MirageC79/HevORT/README.md

# Welcome to the HevORT project!

For information about the HevORT project please have a look into the documentation. [Documentation](http://docs.hevort.com/#/pages/home)
