MirageC79/HevORT/firmware/klipper/klipperscreen/theme/README.md

# Klipper Screen HevORT Theme

## How to install this theme to Klipper Screen:
1 - Copy the content of the hevort folder to:  
`/home/pi/KlipperScreen/styles/hevort`

2 - Restart KlipperScreen:  
`sudo service KlipperScreen restart`

3 - Select HevORT theme from the KlipperScreen menu.  
