MirageC79/HevORT/files/Components/Enclosure/ElectronicBay/OctopusProCasing/README.md

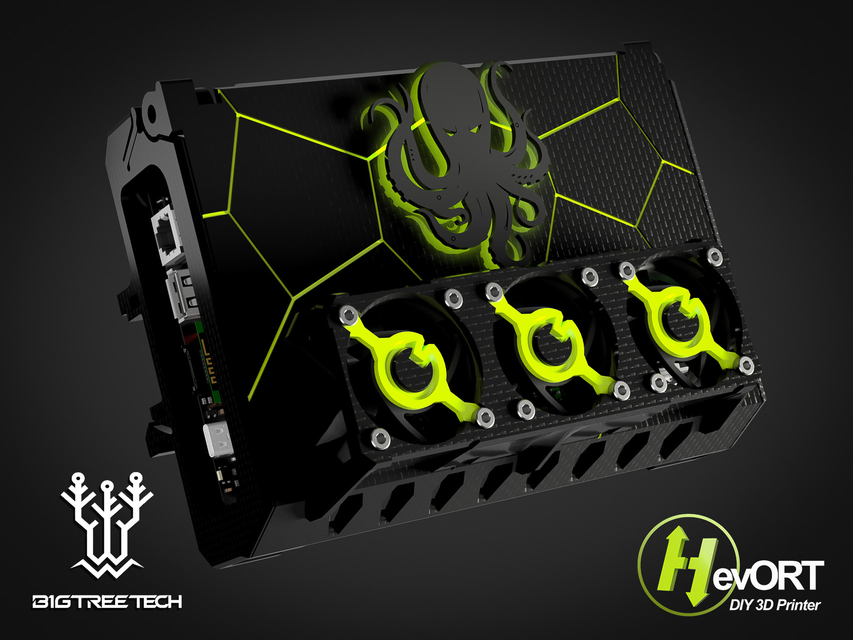
[picture p5: files/Components/Enclosure/ElectronicBay/OctopusProCasing/images/Octopus_casing_acidbee_render.jpg]


**STLs:**
https://github.com/.../AcidBee_Enclosure/OctopusProCasing

**Print Settings:**
- Layer height 0.2mm
- Support (only required for DINMountLeft.stl & TripleFanShroud.stl)
- Green lines can be achieved by scheduling filament change (M600) at layer 4 and 6 of your slicer

**BOM:**
- Qty 2: Dowel pin 5mm X 16mm ( I used a 5mm corbon fiber rod cut to length)
- Qty 12: M3 X 25mm Cap Screw
- Qty 2: M2.5 X 4mm Cap Screw
- Qty 3: 40X40X20 Fan https://s.click.aliexpress.com/e/_AMLp6f

**Installation:**
Fans are meant to be mounted in a pushing mode towards the inside of the case.
