MirageC79/HevORT/docs/sidebar.md

* [Home](pages/home.md)
* [Intro](pages/intro.md)
* **PLAN YOUR BUILD**
* [Printer Size](pages/printer-size.md)
* [Frame Calculation](pages/frame-calculation.md)
* [Select Configuration](pages/component-selection.md)
* [Select Electronics](pages/electronics-selection.md)
* **MAKE IT HAPPEN**
* [Printing the Parts](pages/how-to-print-parts.md)
* [Firmware Configuration](pages/firmware-configuration/klipper.md)
* [Mods](pages/mods/mods.md)
* **OTHERS**
* Useful stuff
  * [Links](pages/useful-stuff/links.md)
  * [Tools](pages/useful-stuff/tools.md)
* Documentation specific
  * [Documentation docs](pages/documentation-docs.md)

<div class="socials">
    <span><span>Socials</span></span>
    <div class="socials-container">
      <a class="social-btn" href="https://www.youtube.com/c/MirageC" target="_blank" rel="noopener"><i class="social-btn-icon fa-brands fa-youtube"></i></a>
      <a class="social-btn" href="https://www.facebook.com/groups/hevort" target="_blank" rel="noopener"><i class="social-btn-icon fa-brands fa-facebook"></i></a>
      <a class="social-btn" href="https://discord.gg/nCYRQAZPWV" target="_blank" rel="noopener"><i class="social-btn-icon fa-brands fa-discord"></i></a>
    </div>
</div>

<div class="sidebar-credit-container">
<span><span class="hevort">HevORT</span> project by <span class="hevort">MirageC</span></span>
<span><span class="hevort">Documentation</span> rework by <span class="hevort">DonnerPlays</span></span>

</div>
