MirageC79/HevORT/docs/cover.md

><span class="hevort">HevORT</span> DIY 3D-Printer Documentation

[Dive into the Project](pages/home.md ':class=cover-button')
