MirageC79/HevORT/docs/pages/intro.md

# **INTRO**

## Why the HevORT?
I got into 3D printing by building a CoreXY [Hypercube Evolution 300X300X300 (HEVO)](https://www.thingiverse.com/thing:2254103).  
This was a very good learning experience for me as I learned how 3D printers work and how to actually 3D print.

After several months of printing and looking closely at the design from the HEVO, I came up with a few ideas on how to improve the design based on my needs and **my thirst for speed**.    
Well, first thing I knew, I was now on the path of designing my own 3D printer.  Pulling back my mechanical engineering course notes from long time ago I learned Fusion360...    
Those ideas lead me to design what is now known as the HevORT (Hypercube Evolution Olivier RT).

If ever you decide to build this machine, I hope you enjoy it as much as I do.

Welcome to the journey and dont forget to join our [Facebook group](https://www.facebook.com/groups/hevort) and our [Discord server](https://discord.gg/xgYTQD3C).    

**Olivier aka MirageC**

## The Design Philosophy
- Stepper Motors to be out of the heat chamber and at the back of the printer
- Maximized ratio between XY print area vs frame dimension
- Triple Z motor Self-Leveling *(True term would be Auto-leveling , but the common use for Auto-leveling designates software compensation based on topographic mapping of the bed)*
- Wide and Tall front printer opening without extrusion member in the line of sight to the print head.
- Rigid Gantry for achieving high acceleration and speed using a direct drive extruder
- No metal machining of parts (or limited as much as possible)
- Open Source data

## See the HevORT in Action	
<iframe width="560" height="315" src="https://www.youtube.com/embed/mLhklORNFBQ" title="PERFECT Layer Stacking with this System" frameborder="0" allow="accelerometer; autoplay; clipboard-write; encrypted-media; gyroscope; picture-in-picture; web-share" allowfullscreen></iframe>
<iframe width="560" height="315" src="https://www.youtube.com/embed/ibsBiALMMSE" frameborder="0" allow="accelerometer; autoplay; clipboard-write; encrypted-media; gyroscope; picture-in-picture" allowfullscreen></iframe>   
<br> 
<iframe width="560" height="315" src="https://www.youtube.com/embed/ZtpQwZyuZP8" title="My Recipe for FAST 3D printing" frameborder="0" allow="accelerometer; autoplay; clipboard-write; encrypted-media; gyroscope; picture-in-picture; web-share" allowfullscreen></iframe>
<iframe width="560" height="315" src="https://www.youtube.com/embed/mqSQhwqSzvg" title="Fixing Z Wobble from 20$ Ball Screws with that simple device" frameborder="0" allow="accelerometer; autoplay; clipboard-write; encrypted-media; gyroscope; picture-in-picture; web-share" allowfullscreen></iframe>
