MirageC79/HevORT/docs/pages/home.md

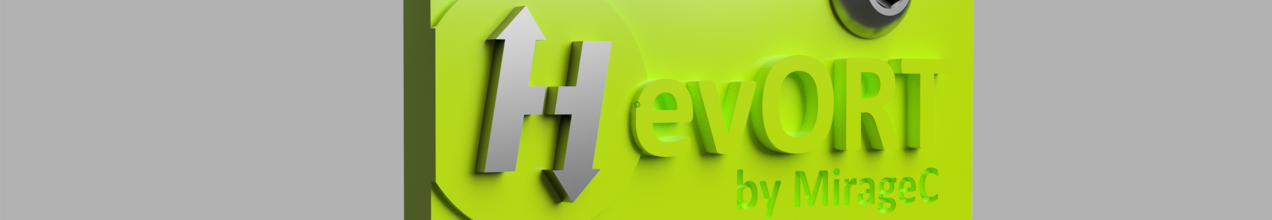
[picture p14: docs/assets/images/cover-flat.png]
Cover Image Flat

# Welcome to the **HevORT** project !

The HevORT is a DIY 3D printer that is meant to push the boundaries of FDM printing in terms of speed, repeatability & maintainability.  
Quality will be the same as any well calibrated FDM only the HevORT prints to that quality level faster... much faster! :)   
<br>

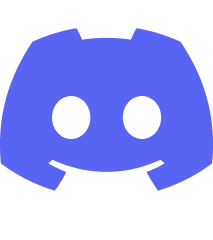
[picture p15: docs/assets/images/discord-logo.png]
Discord Logo
<a class="hevort-message hevort-btn" target="_blank" href="https://discord.gg/nCYRQAZPWV" rel="noopener"><span class="hevort-btn-text">Click here and join the Discord to get in touch with even more people actively discussing the next big thing</span></a>
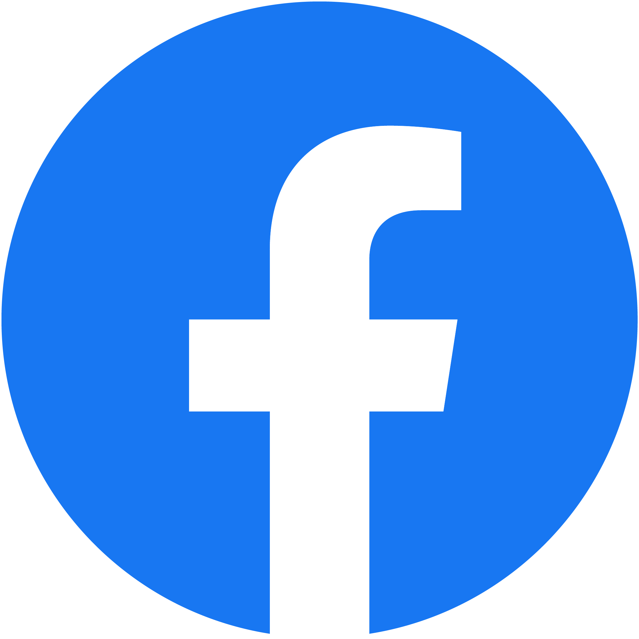
[picture p16: docs/assets/images/facebook-logo.png]
Facebook Logo
<a class="hevort-message hevort-btn" target="_blank" href="https://www.facebook.com/groups/hevort" rel="noopener"><span class="hevort-btn-text">Click here and join the Facebook group</span></a>

>If you like my work and would like to help me covering the costs associated to the development and improvement of this project, <br>
click the button here below :)

Donate with PayPal (https://www.paypal.com/cgi-bin/webscr?cmd=_s-xclick&hosted_button_id=LYP98YKUSLXN2)

Thank you!
Olivier

<br>
<p style="font-size: 3rem; text-align: center; display: flex; flex-direction: column">
:fa-solid fa-heart:
Happy Printing
:fa-solid fa-heart:
</p>
