MirageC79/HevORT/docs/pages/mods/mods.md

# **Mods**

> This is the section for the community
>
> It showcases all the modification's people from the community have created and published

## Contribution

|INFO|
If you have created a mod for the HevORT too.
Please create a merge request to have it added

[GitHub/HevORT - Pull Request](https://github.com/MirageC79/HevORT/pulls)

If you need help, the best place to ask is the Discord server

[Discord/HevORT](https://discord.gg/nCYRQAZPWV)
|INFO|

<details>
<summary>Rules</summary>

<div class="mod-contribution-rules-container">

[contribution-rules](../../mod-contribution-rules.md ':include')

</div>
</details>

## Enclosure

<grid>
  <item title="Serbitar AcidBee Enclosure extras" image="files/Mods/serbitar/serbitar-acidbee-enclosure-extras.webp">
    <description slot="description">
      A collection of different modifications (extras) for the <a href="#/pages/component-selection?id=a-enclosure">AcidBee Enclosure</a>.
    </description>
    <buttons slot="buttons">
      <item-button url="https://www.printables.com/de/model/216056-hevort-acidbee-enclosure-extras">Printables</item-button>
    </buttons>
    <tags slot="tags">
      <item-tag>Enclosure</item-tag>
    </tags>
    <credits slot="credits">
      <credit name="Serbitar"/>
    </credits>
  </item>
</grid>

## XY Gantry

<grid>
  <item title="EvoMoto HD12 AWD" image="files/Mods/evomoto/evomoto_awd_hd12.png">
    <description slot="description">
      This mod adds two more steppers to the HevORT.
      <br>They replace the pulley mounts on the front for even more power.
      <br><br>Requires (not including existing parts from the pulley mounts):
      <br>-2 more steppers
      <br>-2 driving pulleys for the stepper (20teeth)
      <br>-6x M5 100mm screws (replaces existing M5 90mm)
      <br>-2x M5 55mm screws (replaces existing M5 45mm)
    </description>
    <buttons slot="buttons">
      <item-button url="https://www.thingiverse.com/thing:5171980">Thingiverse</item-button>
    </buttons>
    <tags slot="tags">
      <item-tag>12mm belt</item-tag>
      <item-tag>AWD</item-tag>
    </tags>
    <credits slot="credits">
      <credit name="EvoMoto"/>
    </credits>
  </item>
  <item title="EvoMoto STD/HT AWD" image="files/Mods/evomoto/evomoto_awd_std-ht.png">
    <description slot="description">
      This mod adds two more steppers to the HevORT.
      <br>They replace the pulley mounts on the front for even more power.
      <br><br>Requires (not including existing parts from the pulley mounts):
      <br>-2 more steppers
      <br>-2 driving pulleys for the stepper (20teeth)
    </description>
    <buttons slot="buttons">
      <item-button url="https://www.thingiverse.com/thing:4815859">Thingiverse</item-button>
    </buttons>
    <tags slot="tags">
      <item-tag>6mm belt</item-tag>
      <item-tag>AWD</item-tag>
    </tags>
    <credits slot="credits">
      <credit name="EvoMoto"/>
    </credits>
  </item>
  <item title="Hans Hanson HD12 AWD" image="files/Mods/hans-hanson/hans-hanson_awd_hd12.jpg">
    <description slot="description">
      Almost the same number and length of shafts are required as with the opposite Motor Mount and Pulley mount
      <br><br>(except for the two Dowel Pin 5x40mm for the belt binder).
      <br>The same goes for the idler and pulley.
    </description>
    <buttons slot="buttons">
      <item-button url="https://www.thingiverse.com/thing:4946002">Thingiverse</item-button>
      <item-button url="https://a360.co/3lwUEMv">CAD File</item-button>
    </buttons>
    <tags slot="tags">
      <item-tag>12mm belt</item-tag>
      <item-tag>AWD</item-tag>
    </tags>
    <credits slot="credits">
      <credit name="Hans Hanson"/>
    </credits>
  </item>
</grid>

### Further options
Smaller changes that may not fit into the bigger mods in the main [XY Gantry](#xy-gantry) section.

<grid>
  <item title="XYHT v2.5 1515 extrusions" image="files/Mods/rockzo/rockzo_xyht_1515_extrusion_mod/rockzo_xyht_1515_extrusion_mod.png">
    <description slot="description">
      A simple mod for 1515 extrusion for the XYHT v2.5.
      <br>Recommended: Misumi 1515 extrusion
    </description>
    <buttons slot="buttons">
      <item-button url="files/Mods/rockzo/rockzo_xyht_1515_extrusion_mod/rockzo_xyht_1515_extrusion_mod.step">CAD File</item-button>
    </buttons>
    <tags slot="tags">
      <item-tag>6mm belt</item-tag>
    </tags>
    <credits slot="credits">
      <credit name="Rockzo"/>
    </credits>
  </item>
</grid>

## Z-Axis

<grid>
  <item title="Wobble Rings for SFU1204" image="files/Mods/evomoto/evomoto_sfu1204_wobble_rings.jpg">
    <description slot="description">
      Alternative version of the original Wobble Rings for the ZR V2.5
      <br>These do a better job at eliminating bad quality ballscrews
      <br><br>Cheap ballscrews never run smooth, these wobble rings will eliminate any wobble
      <br>the ballscrew would have induced into the print bed movement
    </description>
    <buttons slot="buttons">
      <item-button url="https://www.thingiverse.com/thing:4781610">Thingiverse</item-button>
    </buttons>
    <tags slot="tags">
      <item-tag>SFU1204</item-tag>
      <item-tag>Wobble prevention</item-tag>
    </tags>
    <credits slot="credits">
      <credit name="EvoMoto"/>
    </credits>
  </item>
  <item title="Wobble Rings for SFU1604" image="files/Mods/evomoto/evomoto_sfu1604_wobble_rings.png">
    <description slot="description">
      Same as the SFU1204 version but for SFU1604
    </description>
    <buttons slot="buttons">
      <item-button url="https://www.thingiverse.com/thing:4785945">Thingiverse</item-button>
    </buttons>
    <tags slot="tags">
      <item-tag>SFU1604</item-tag>
      <item-tag>Wobble prevention</item-tag>
    </tags>
    <credits slot="credits">
      <credit name="EvoMoto"/>
    </credits>
  </item>
  <item title="Z-Axis 2:1 reduction" image="files/Mods/m3nt8l/m3nt8l_z-axis_reduction.jpg">
    <description slot="description">
      2:1 reduction for the HevORT's ZR V2.5 Z-Axis
      <br>This mod increases holding torque.
      <br>It will also allow you to use 50mm longer ballscrews bringing you 50mm more Z-Travel.
      <br><br>Requires (for all 3):
      <br>3x 154 mm (77 tooth) 2GT closed loop belt
      <br>3x 40 tooth pulley with 5mm bore
      <br>3x Roland Coupler (as seen in standard HevORT Z 2.5)
      <br>3x 5200-2RS double row angular contact bearing (as seen in standard HevORT Z 2.5)
      <br>3x Coupler (as seen in standard HevORT Z 2.5)
      <br>3x 5mm shaft pins
      <br>3x 20 tooth pulley for the motor shaft (5mm) (as seen in standard HevORT Z 2.5)
      <br>9x 625RS 5mm bore x 16mm OD x 5mm wide bearings
    </description>
    <buttons slot="buttons">
      <item-button url="https://www.thingiverse.com/thing:4880007">Thingiverse</item-button>
    </buttons>
    <tags slot="tags">
      <item-tag>Torque</item-tag>
      <item-tag>increased travel</item-tag>
    </tags>
    <credits slot="credits">
      <credit name="M3NT8L"/>
    </credits>
  </item>
  <item title="Wobble Rings SFU1204<br>Mellow Metal Middle Ring">
    <description slot="description">
      Modification of EvoMoto's Wobble Rings to allow the usage of the Mellow metal middle rings
      <br><a href="https://www.aliexpress.com/item/1005004227149356.html?">Mellow AliExpress</a>
      <br>
      <br>Designed for the SFU1204 ballscrews & 6mm balls.
      <br>
      <br>Printing in resin (ideally high temp) recommended/required for best results
      <br>Example resins:
      <br>- <a href="https://siraya.tech/products/sculpt-resin-high-temperature-resistant-resin?variant=40152192483437">Siraya Tech Sculpt</a>
      <br>- <a href="https://siraya.tech/products/sculpt-resin-high-temperature-resistant-resin?variant=40152192581741">Siraya Tech Sculpt Ultra White</a>
      <br>- <a href="https://phrozen3d.com/products/phrozen-tr300-ultra-high-temp-resin">Phrozen TR300</a>
    </description>
    <buttons slot="buttons">
      <item-button url="https://github.com/MirageC79/HevORT/tree/master/files/Mods/stl/vvega/wobble_ring_mellow_metal_center/">STLs</item-button>
    </buttons>
    <images slot="images">
      <item-image url="files/Mods/vvega/wobble_ring_mellow_metal_center/1.jpg"></item-image>
      <item-image url="files/Mods/vvega/wobble_ring_mellow_metal_center/2.jpg"></item-image>
      <item-image url="files/Mods/vvega/wobble_ring_mellow_metal_center/3.jpg"></item-image>
      <item-image url="files/Mods/vvega/wobble_ring_mellow_metal_center/4.jpg"></item-image>
    </images>
    <tags slot="tags">
      <item-tag>SFU1204</item-tag>
      <item-tag>Wobble prevention</item-tag>
      <item-tag>Metal</item-tag>
    </tags>
    <credits slot="credits">
      <credit name="EvoMoto">Initial work/version</credit>
      <credit name="Vvega">Modification for Mellow metal middle rings</credit>
    </credits>
  </item>
</grid>

## Extruder

<grid>
  <item title="BL-Touch Rapido UHF Hotend bracket"
        image="https://hevort-mods.donnerplays.de/docs/assets/images/BL_Touch_Rapido_Hotend_UHF_Bracket.png">
    <description slot="description">
      Mounting bracket for the BL-Touch when used on a Rapido UHF hotend.
      <br>- Adds a lip on the top that prevents the support from rotating.
      <br>- Uses nuts for all screw holes instead of screwing into the plastic
      <br><br>Requires:
      <br>- 3x M3 nuts
      <br>- Main mounting screw: M3x(~35mm long screw)
      <br>- BL-Touch screws: 2x M3x8mm screw
    </description>
    <buttons slot="buttons">
      <item-button icon="fa fa-download"
                   url="https://hevort-mods.donnerplays.de/cad/BL_Touch_Rapido_Hotend_UHF_Bracket.step">CAD File
      </item-button>
    </buttons>
    <tags slot="tags">
      <item-tag>Bl-Touch</item-tag>
      <item-tag>Rapido UHF</item-tag>
      <item-tag>HextrudORT</item-tag>
    </tags>
    <credits slot="credits">
      <credit name="MirageC">Initial work/version</credit>
      <credit name="DonnerPlays">Modification to use M3 nuts instead of threading into the plastic</credit>
    </credits>
  </item>
  <item title="LGX Lite HextrudORT Carriage Mount (HD12/MGN9)"
        image="files/Mods/serbitar/serbitar_lgx-lite_hextrudort_carriage.webp">
    <description slot="description">
      Mounts an LGX Lite and Dragon hotend to the HevORT HextrudORT HD12/MGN9 carriage.
    </description>
    <buttons slot="buttons">
      <item-button url="https://www.printables.com/de/model/151944-hevort-lgx-lite-hextrudort-carriage-mount-hd12mgn9">Printables</item-button>
    </buttons>
    <tags slot="tags">
      <item-tag>9mm belt</item-tag>
      <item-tag>12mm belt</item-tag>
      <item-tag>lgx lite</item-tag>
      <item-tag>HextrudORT</item-tag>
    </tags>
    <credits slot="credits">
      <credit name="Serbitar"/>
    </credits>
  </item>
</grid>

## Cooling

<grid>
  <item title="HD12/MGN12 CPAP Rapido Duct" image="https://hevort-mods.donnerplays.de/docs/assets/images/HD12_MGN12_Rapido_Duct.png">
    <description slot="description">
      Fan duct for CPAP fan hose
      <br>(15mm inner diameter)
      <br><br>Mounts to the standard MGN12H/HD12 HextrudORT carriage
      <br><br>Requires:
      <br>- Standard: 4x M3x8mm screws
      <br>- UHF: 4x M3x14mm screws
    </description>
    <buttons slot="buttons">
      <item-button icon="fa fa-download" url="https://hevort-mods.donnerplays.de/cad/HD12_MGN12_Rapido_Duct.step">CAD
        File
      </item-button>
    </buttons>
    <tags slot="tags">
      <item-tag>CPAP</item-tag>
      <item-tag>12mm belt</item-tag>
      <item-tag>Rapido UHF</item-tag>
      <item-tag>MGN12H</item-tag>
    </tags>
    <credits slot="credits">
      <credit name="MirageC">Initial work of MGN9 version</credit>
      <credit name="DonnerPlays">Modification to fit HD12/MGN12</credit>
    </credits>
  </item>
  <item title="HD12/MGN12H Rapido UHF Spacer"
        image="https://hevort-mods.donnerplays.de/docs/assets/images/HD12_MGN12_Rapido_UHF_Spacer.png">
    <description slot="description">
      Spacer for the CPAP Rapido Duct
      <br>when the rapido is used with a volcano nozzle (UHF)
    </description>
    <buttons slot="buttons">
      <item-button icon="fa fa-download" url="https://hevort-mods.donnerplays.de/cad/HD12_MGN12_Rapido_UHF_Spacer.step">
        CAD File
      </item-button>
    </buttons>
    <tags slot="tags">
      <item-tag>Rapido UHF</item-tag>
      <item-tag>Spacer</item-tag>
    </tags>
    <credits slot="credits">
      <credit name="MirageC">Initial work of MGN9 version</credit>
      <credit name="DonnerPlays">Modification to fit HD12/MGN12</credit>
    </credits>
  </item>
  <item title="HD12/MGN12 40mm fan mount (tested with Rapido hotend)"
        image="https://hevort-mods.donnerplays.de/docs/assets/images/MGN12_HD12_Rapido_Fan_Shroud_40mm.png">
    <description slot="description">
      This bracket allows you to use a 40mm fan for
      <br>hotend cooling on the
      <br>MGN12/HD12 HextrudORT carriage
      <br><br>Includes small side openings to help with getting out the hot air and help with installation.
      <br><br>Is supported by two screws/flaps on the side
      <br><br>Requires:
      <br>- 3x M3x(8mm + fan size)
      <br>Example: 20mm thick fan = 28mm = 25-30mm
    </description>
    <buttons slot="buttons">
      <item-button icon="fa fa-download"
                   url="https://hevort-mods.donnerplays.de/cad/MGN12_HD12_Rapido_Fan_Shroud_40mm.step">CAD File
      </item-button>
    </buttons>
    <tags slot="tags">
      <item-tag>Rapido</item-tag>
      <item-tag>40mm fan</item-tag>
      <item-tag>MGN12H</item-tag>
      <item-tag>HD12</item-tag>
    </tags>
    <credits slot="credits">
      <credit name="MirageC">Initial work on version for Rapido with 25mm fan</credit>
      <credit name="DonnerPlays">Modification to allow 40mm fan to be used</credit>
    </credits>
  </item>
  <item title="CPAP 7040 part cooling solution" image="https://hevort-mods.donnerplays.de/docs/assets/images/cpap_7040_solution/main.png">
    <description slot="description">
      Ability to mount a CPAP 7040 blower.
      <br><br>
      Also adds ability to change inlet direction using servo
    </description>
    <buttons slot="buttons">
      <item-button url="https://hevort-mods.donnerplays.de/#/pages/mods/cpap_7040_solution.md">GitHub Page</item-button>
    </buttons>
    <credits slot="credits">
      <credit name="DonnerPlays"/>
    </credits>
    <tags slot="tags">
      <item-tag>CPAP</item-tag>
      <item-tag>Mount</item-tag>
      <item-tag>Spacer</item-tag>
    </tags>
  </item>
  <item title="HextrudORT Dragon Berd Air Mount">
    <description slot="description">
      Berd Air Nozzle for HextrudORT/Dragon combo that can be printed on an FDM/FFF printer<br><br>
      Print standing on end (big tube opening facing up)<br>
      - I used a thicker silicone tube than the aquarium hose normally used, to allow for higher airflow.<br>
      - I used a little nylon 90" bend on the back.<br>
      - Requires 2x M3x22mm screws to secure.<br>
    </description>
    <images slot="images">
      <item-image url="files/Mods/guitartoys/hextrudort_dragon_berd_air/1.jpg"></item-image>
      <item-image url="files/Mods/guitartoys/hextrudort_dragon_berd_air/2.jpg"></item-image>
      <item-image url="files/Mods/guitartoys/hextrudort_dragon_berd_air/3.jpg"></item-image>
      <item-image url="files/Mods/guitartoys/hextrudort_dragon_berd_air/4.jpg"></item-image>
      <item-image url="files/Mods/guitartoys/hextrudort_dragon_berd_air/5.jpg"></item-image>
    </images>
    <buttons slot="buttons">
      <item-button icon="fa fa-download" url="files/Mods/guitartoys/hextrudort_dragon_berd_air/guitartoys_hextrudort_dragon_berd_air.step">CAD File</item-button>
      <!-- <item-button url="https://a360.co/3QL8yIR">CAD-File</item-button> --><!-- Commented out as download not possible -->
      <item-button url="https://www.thingiverse.com/thing:5463656">Thingiverse</item-button>
      <item-button icon="fa fa-download" url="files/Mods/stl/guitartoys/hextrudort_dragon_berd_air/guitartoys_hextrudort_dragon_berd_air.stl">STL</item-button>
    </buttons>
    <credits slot="credits">
      <credit name="guitartoys"/>
    </credits>
    <tags slot="tags">
      <item-tag>Berd-Air</item-tag>
      <item-tag>MGN12H</item-tag>
      <item-tag>HextrudORT</item-tag>
      <item-tag>Dragon</item-tag>
    </tags>
  </item>
  <item title="Hemera Berd-Air Nozzle">
    <description slot="description">
      Berd Air Nozzle for HevORT Hemera that can be printed on an FDM/FFF printer<br><br>
      Both a V6 and Volcano version are provided<br><br>
      Print standing on end (big tube opening facing up)<br>
      - I used a thicker silicone tube than the aquarium hose normally used, to allow for higher airflow.<br>
      - I used a little nylon 90" bend on the back.<br>
      - Requires 1x M3x10mm & 1x M3x14mm screw to secure.<br>
    </description>
    <buttons slot="buttons">
      <item-button icon="fa fa-download" url="files/Mods/guitartoys/hemera_berd_air_nozzle/hemera_v6_berd_air_nozzle.stl">V6 STL</item-button>
      <item-button icon="fa fa-download" url="files/Mods/guitartoys/hemera_berd_air_nozzle/hemera_volcano_berd_air_nozzle.stl">Volcano STL</item-button>
      <item-button icon="fa fa-download" url="files/Mods/guitartoys/hemera_berd_air_nozzle/hemera_v6_berd_air_nozzle.step">V6 CAD File</item-button>
      <item-button icon="fa fa-download" url="files/Mods/guitartoys/hemera_berd_air_nozzle/hemera_volcano_berd_air_nozzle.step">Volcano CAD File</item-button>
      <item-button url="https://www.thingiverse.com/thing:4919574">Thingiverse</item-button>
    </buttons>
    <tags slot="tags">
      <item-tag>Berd-Air</item-tag>
      <item-tag>MGN12H</item-tag>
      <item-tag>Hemera</item-tag>
    </tags>
    <images slot="images">
      <item-image url="files/Mods/guitartoys/hemera_berd_air_nozzle/1.jpg"></item-image>
      <item-image url="files/Mods/guitartoys/hemera_berd_air_nozzle/2.jpg"></item-image>
      <item-image url="files/Mods/guitartoys/hemera_berd_air_nozzle/3.jpg"></item-image>
      <item-image url="files/Mods/guitartoys/hemera_berd_air_nozzle/4.jpg"></item-image>
    </images>
    <credits slot="credits">
      <credit name="guitartoys"/>
    </credits>
  </item>
</grid>

## Electronics

<grid>
  <item title="Duet 3 Mounting Bracket">
    <description slot="description">
      This is a Duet 3 Mounting bracket, which includes Three 40mm cooling fans.<br>
      My understanding is that the Duet needs it cooling to be on the backside of the board.<br>
      There's wide flat strip between the fans and the board, so if you want to use some self-adhesive wire tie mounts, you can do that there.<br>
      It's to be mounted to a flat surface for proper air flow.
    </description>
    <buttons slot="buttons">
      <item-button url="https://www.thingiverse.com/thing:4906487">Thingiverse</item-button>
      <item-button url="https://github.com/MirageC79/HevORT/tree/master/files/Mods/stl/guitartoys/duet3_mounting_bracket/">STLs</item-button>
      <item-button icon="fa fa-download" url="files/Mods/guitartoys/duet3_mounting_bracket/duet3_Bracket_with_fans.step">CAD File</item-button>
    </buttons>
    <tags slot="tags">
      <item-tag>Duet</item-tag>
      <item-tag>Controller</item-tag>
      <item-tag>Spacer</item-tag>
    </tags>
    <images slot="images">
      <item-image url="files/Mods/guitartoys/duet3_mounting_bracket/1.jpg"></item-image>
      <item-image url="files/Mods/guitartoys/duet3_mounting_bracket/2.jpg"></item-image>
      <item-image url="files/Mods/guitartoys/duet3_mounting_bracket/3.jpg"></item-image>
      <item-image url="files/Mods/guitartoys/duet3_mounting_bracket/4.jpg"></item-image>
      <item-image url="files/Mods/guitartoys/duet3_mounting_bracket/5.jpg"></item-image>
    </images>
    <credits slot="credits">
      <credit name="guitartoys"/>
    </credits>
  </item>
</grid>

## Other

<grid>
  <item title="SpEye" image="files/Mods/miragec/spy-eye/spy-eye-printed.jpg">
    <description slot="description">
      Not only an empty filament detector.
      <br>The SpEye can detect a spool jam and pause your print.
    </description>
    <buttons slot="buttons">
      <item-button url="#/pages/mods/spy-eye.md">SpEye page</item-button>
    </buttons>
    <tags slot="tags">
    </tags>
    <credits slot="credits">
      <credit name="MirageC"/>
    </credits>
  </item>
  <item title="ADXL345 mounting bracket on 40mm fan"
        image="https://hevort-mods.donnerplays.de/docs/assets/images/ADXL345_40mm_Fan_Mount.png">
    <description slot="description">
      Allows you to easily mount an ADXL345 accelerometer to your print head.
      <br><br>Mounts to the front of a 40mm fan.
      <br>(tested with a 20mm thick fan)
      <br><br>Requires: 3.5mm longer screws
    </description>
    <buttons slot="buttons">
      <item-button icon="fa fa-download" url="https://hevort-mods.donnerplays.de/cad/ADXL345_40mm_Fan_Mount.step">CAD
        File
      </item-button>
    </buttons>
    <tags slot="tags">
      <item-tag>40mm fan</item-tag>
      <item-tag>ADXL345</item-tag>
    </tags>
    <credits slot="credits">
      <credit name="DonnerPlays"/>
    </credits>
  </item>
  <item title="Hans Hanson FumesORT" image="files/Mods/hans-hanson/hans-hanson_fumes-ort.jpg">
    <description slot="description">
      Fume filter mounted under the HevORT's print bed.
      <br><br>Filter basket volume is approx. 313ml.
      <br>Using activated charcoal pellets with a diameter of approx. 4mm
      <br><br>Uses 4x 40x40x20 Sunon MF40202VX-1000U-A99
      <br>Circulates 37m³/h with empty filter basked
      <br>11m³/h with full filter at 24V or 6m³/h at 12V
      <br><br>Requires:
      <br>20x M3x8mm or M3x10
      <br>16x M3x25mm (for 40x40x20 mm Fans)
      <br>2x wago 221-413
      <br>8x M5x8mm Socket Head Screws
      <br>8x Hammer nut M5 for 2020 profile
      <br>4x Hammer nut M3 for 2020 profile
      <br>1x 295mm 2040 profile
      <br>4x 40x40x20 Fans
      <br>1x activated charcoal pellets
    </description>
    <buttons slot="buttons">
      <item-button url="https://www.thingiverse.com/thing:5197675">Thingiverse</item-button>
      <item-button url="https://a360.co/3lwUEMv">CAD File</item-button>
    </buttons>
    <tags slot="tags">
      <item-tag>Fume extractor</item-tag>
      <item-tag>Fume filter</item-tag>
    </tags>
    <credits slot="credits">
      <credit name="Hans Hanson"/>
    </credits>
  </item>
  <item title="Berd Air Pump Mount">
    <description slot="description">
      This is my take on an anti-vibration mount for the Berd Air Pump.<br><br>
      The main upper and lower brackets are the same,<br> and can be done in PLA, although I did mine in PETG<br>
      The little insert for the bottom I did in PETG,<br> as I suspect it will get hot with the motor running.<br>
      For the anti-vibration ring, 4mm seems to be about right.<br><br>
      It stays plenty cool with the heatsink alone (and in fact you could probably eliminate the heatsink)
    </description>
    <buttons slot="buttons">
      <item-button url="https://github.com/MirageC79/HevORT/tree/master/files/Mods/stl/guitartoys/berd_air_pump_mount/">STLs</item-button>
      <item-button icon="fa fa-download" url="files/Mods/guitartoys/berd_air_pump_mount/berd_air_pump_mount.step">CAD File</item-button>
      <item-button url="https://www.thingiverse.com/thing:4918308">Thingiverse</item-button>
    </buttons>
    <tags slot="tags">
      <item-tag>Berd-Air</item-tag>
      <item-tag>Cooling</item-tag>
    </tags>
    <images slot="images">
      <item-image url="files/Mods/guitartoys/berd_air_pump_mount/1.jpg"></item-image>
      <item-image url="files/Mods/guitartoys/berd_air_pump_mount/2.jpg"></item-image>
      <item-image url="files/Mods/guitartoys/berd_air_pump_mount/3.jpg"></item-image>
      <item-image url="files/Mods/guitartoys/berd_air_pump_mount/4.jpg"></item-image>
    </images>
    <credits slot="credits">
      <credit name="guitartoys"/>
    </credits>
  </item>
  <item title="Belt Cover" image="files/Mods/guitartoys/belt_cover/1.jpg">
    <description slot="description">
      Belt covers initially designed for a 415x415 HevORT.
    </description>
    <buttons slot="buttons">
      <item-button icon="fa fa-download" url="files/Mods/guitartoys/belt_cover/belt_cover.step">CAD File</item-button>
      <item-button url="https://www.thingiverse.com/thing:5464303">Thingiverse</item-button>
    </buttons>
    <tags slot="tags">
      <item-tag>Belt</item-tag>
      <item-tag>HD12</item-tag>
    </tags>
    <credits slot="credits">
      <credit name="guitartoys"/>
    </credits>
  </item>
  <item title="Logitech C920 Camera Door Mount" image="files/Mods/guitartoys/logitech_c920_camera_door_mount/1.jpg">
    <description slot="description">
      Mounts the C920 Camera to the front door.<br><br>
      Be careful, depending on how/where you mount it, the print-head might collide with the camera.<br>
      To use this you will have to remove the original c920 mount piece and replace it with the bracket.<br><br>
      Disassembly instructions: <a href="https://www.ifixit.com/Guide/Logitech+C920+Webcam+Disassembly/115077">iFixit</a>
    </description>
    <buttons slot="buttons">
      <item-button icon="fa fa-download" url="files/Mods/guitartoys/logitech_c920_camera_door_mount/logitech_c920_camera_door_mount.step">CAD File</item-button>
      <item-button icon="fa fa-download" url="files/Mods/stl/guitartoys/logitech_c920_camera_door_mount/logitech_c920_camera_door_mount.stl">STL</item-button>
      <item-button url="https://www.thingiverse.com/thing:5466815">Thingiverse</item-button>
    </buttons>
    <tags slot="tags">
      <item-tag>Camera</item-tag>
      <item-tag>Door</item-tag>
    </tags>
    <credits slot="credits">
      <credit name="guitartoys"/>
    </credits>
  </item>
</grid>
