MirageC79/HevORT/docs/pages/useful-stuff/links.md

# Useful Links

## Local

| Name/Link | Description |
|---|---|
| [>Frame Calculator<](docs/assets/references/frame/FrameCalculator.xlsx) | The HevORT Frame Calculator will tell you what sizes of<br>aluminium extrusions, ballscrews, print-bed, ...<br>you will need to get for your config  |
| [>Firmware Settings Guide/Calculator<](docs/assets/references/firmware-settings/FirmWareSettings.xlsx) | A useful document mainly for configuration RRF<br>but also includes a calculator for the Z-Axis Adjustment configuration for both<br>RRF and Klipper |

## External

| Name/Link | Description |
|---|---|
| [>>Flow Rate Calculator<<](https://polygno.com/flow_rate_calculator) | This is a useful tool to check how much<br>flow rate your current settings might result in. | 
| [>>Retraction Calibration Generator<<](http://retractioncalibration.com/) | This website generates an advanced retraction calibration test<br>It allows to test multiple parameters in one test.<br>Like temperature, retraction distance, retraction speed |
| [>>EMF Calculator<<](https://www.reprapfirmware.org/emf.html) | This calculator will tell you how fast you can go before EMF (noise) might become an issue or to much |
