MirageC79/HevORT/docs/pages/useful-stuff/tools.md

# Useful Tools

|INFO|
This pages contains useful tools like klipper/rrf macros
|INFO|

| Name/Link | Type | Description | Author/Credit(s) |
|---|---|---|---|
| [>>Klipper speed test<<](https://pastebin.com/yPfSMBGF) | Klipper macro | Runs multiple speed test and allows to do them each with different parameters<br><br>Example:<br>allows to run the test with different acceleration, run_current settings through a single call<br><br>See text above `[gcode_macro]` in pastebin for more infos. | DonnerPlays |
