MirageC79/HevORT/docs/pages/thankyou.md

# Thank you for your support!

Your contribution will help me to cover some of the costs related to the research and development, the tooling, the parts and the software subscriptions needed in the making of the HevORT project.  I really appreciate your help.
Regards, 

Olivier

[Back to Main Page](/README.md)
