MirageC79/HevORT/refdocs/E3D High Torque Motor.pdf

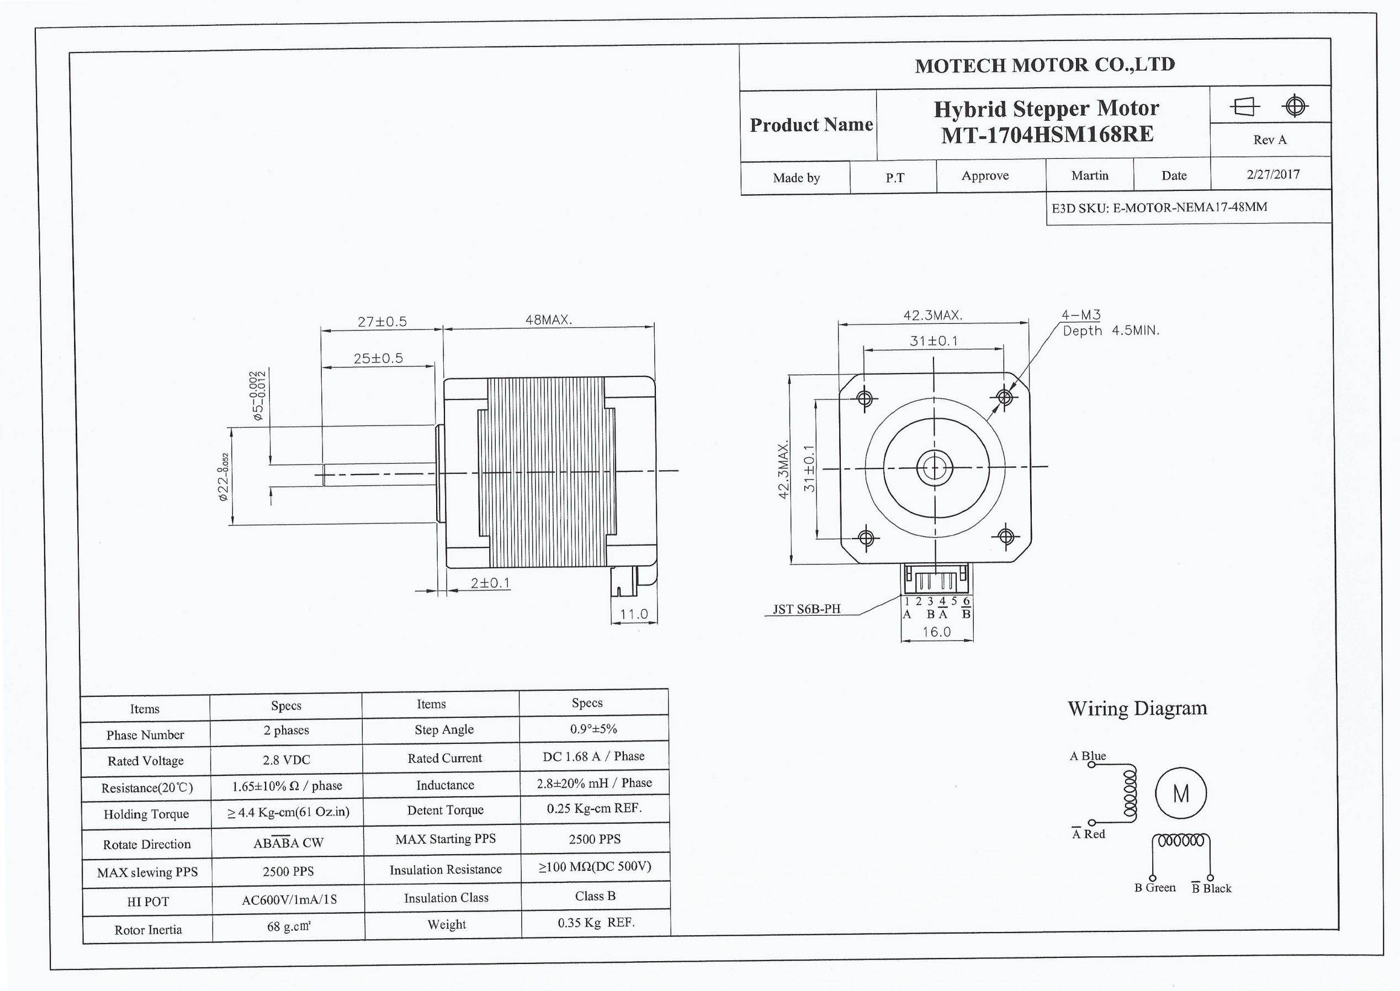
[picture p23: page 1]
