MirageC79/HevORT/docs/assets/images/components/ElectronicsThumb.jpg

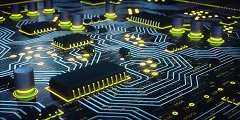
docs/assets/images/components/ElectronicsThumb.jpg
