MirageC79/HevORT/files/Components/Enclosure/ElectronicBay/OctopusProCasing/images/Octopus_casing_acidbee.png

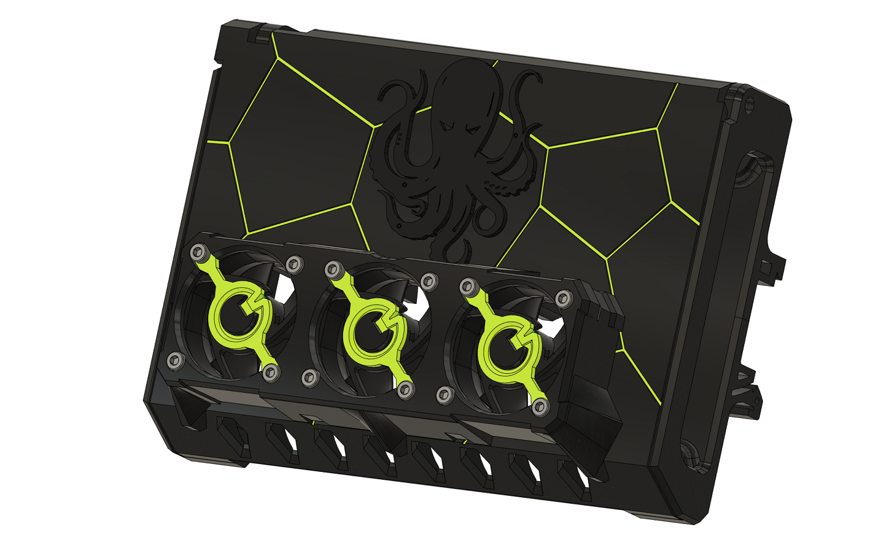
files/Components/Enclosure/ElectronicBay/OctopusProCasing/images/Octopus_casing_acidbee.png
