MirageC79/HevORT/files/Components/HD9_10_SPAWD/images/HD10_SPAWD_Poster copy.jpg

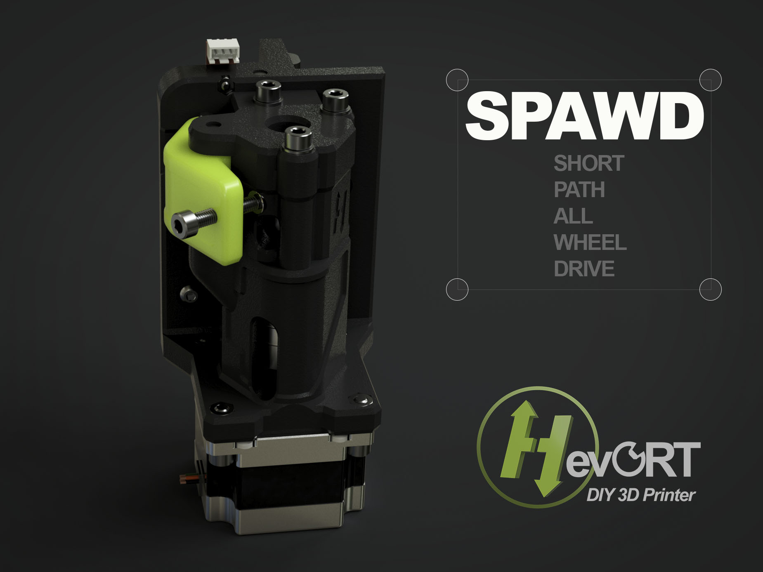
files/Components/HD9_10_SPAWD/images/HD10_SPAWD_Poster copy.jpg
