MirageC79/HevORT/files/Components/Enclosure/Lighting/images/README.md

# 45degree LightBars
Two small holders on which can clip a 45degree LED channel extrusion (commonly available, Aliexpress, Amazon etc...)
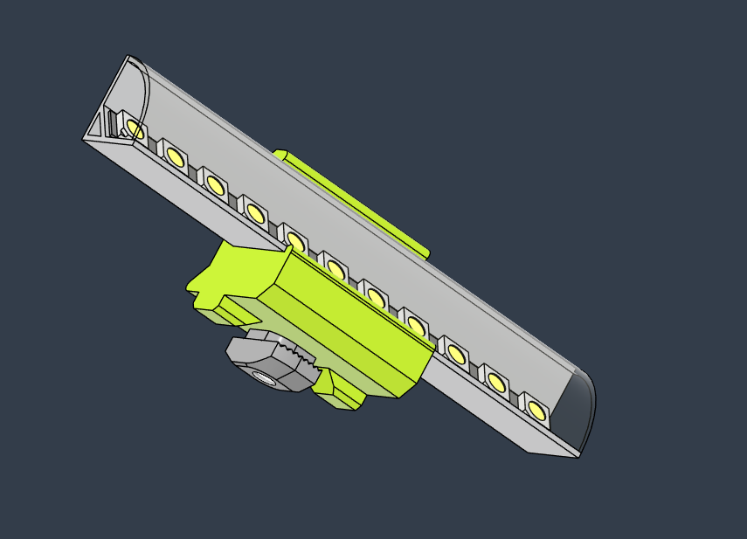
[picture p27: files/Components/Enclosure/Lighting/images/LEDchannel45deg_clipassembly.png]


## CAD
[Fusion360 Online](https://a360.co/3S3MThq)

### Two versions:
[**Version1**](https://github.com/MirageC79/HevORT/blob/master/files/Components/Enclosure/Lighting/LED_45deg_Channel_Clip%20v6.stl) - Can be fitted next to the front Pulley or Motor mount **WITHOUT** endstop:
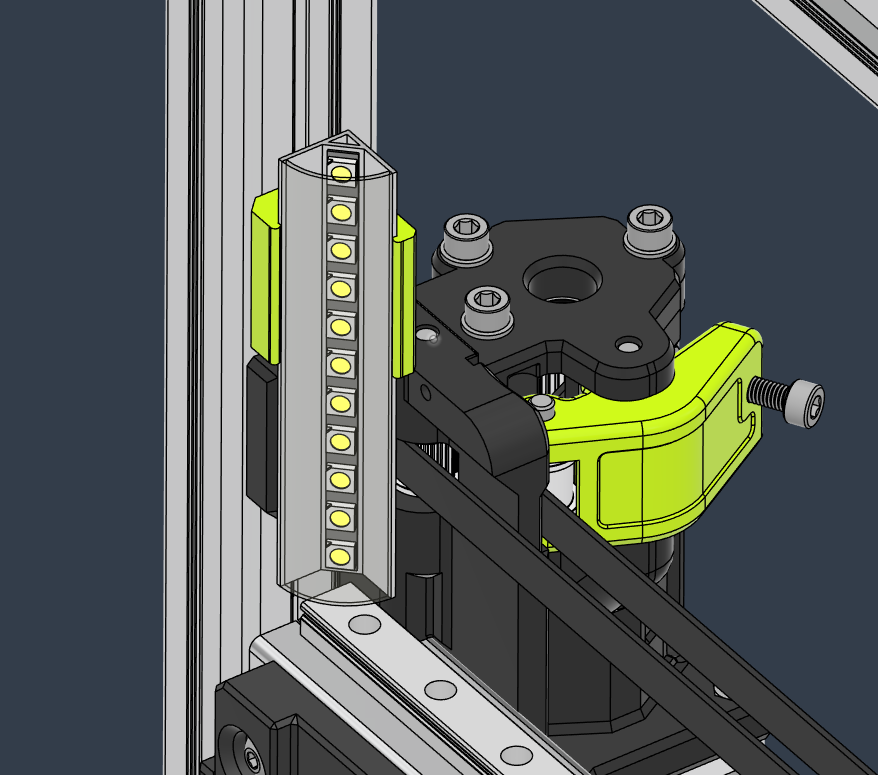
[picture p28: files/Components/Enclosure/Lighting/images/LEDchannel45deg_clip.png]
version1

 
[**Version2**](https://github.com/MirageC79/HevORT/blob/master/files/Components/Enclosure/Lighting/LED_45deg_Channel_Clip_8mmShift%20v1.stl) - Can be fitted next to the front Pulley or Motor mount **WITH** endstop:
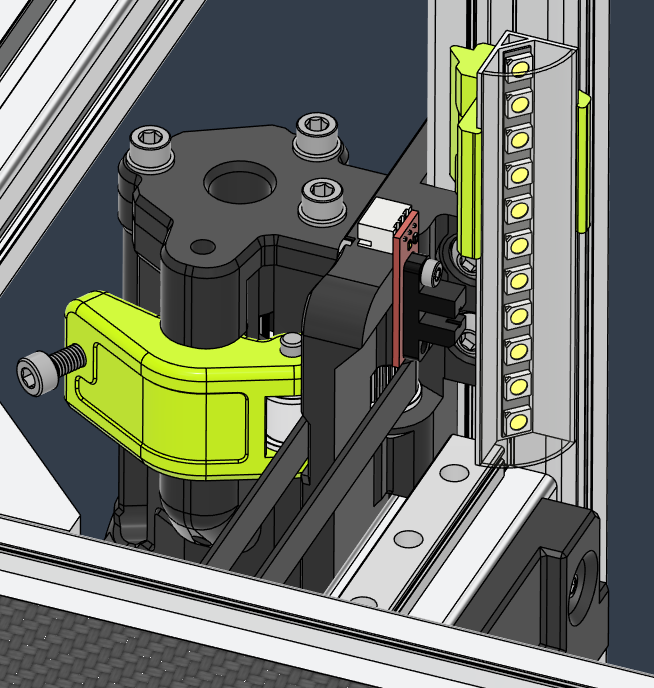
[picture p29: files/Components/Enclosure/Lighting/images/LEDchannel45deg_8mm offset_clip.png]
version2 - 8mm Offset
