MirageC79/HevORT/bom/BOM_XY_STD.xlsx

SubAssy | Category | Item | Thumbnail | Part Name | Part Description | Make/Buy | QTY | Comment | Vendor | Vendor URL
Standard - XY Gantry
XY_STD | Buy | 1 |  | MGN12C Block | MGN12C Block For Y Axis | Buy | 2 | Comes with Rail
XY_STD | Buy | 2 |  | MGN12 Rail | MGN12 Rail for Y axis | Buy | 2* | *Length defined by Frame Calculator: https://miragec79.github.io/HevORT/framecalculator.html
XY_STD | Buy | 3 |  | TrackX_2020Profile | 2020 Extrusion for X Axis | Buy | 1* | *Length defined by Frame Calculator: https://miragec79.github.io/HevORT/framecalculator.html
XY_STD | Buy | 4 |  | MGN12H Block | MGN12 Rail for X axis | Buy | 1 | Comes with Rail
XY_STD | Buy | 5 |  | MGN12 Rail | MGN12 Rail for X axis | Buy | 1* | *Length defined by Frame Calculator: https://miragec79.github.io/HevORT/framecalculator.html
XY_STD | Buy | 6 |  | MR115ZZ_Bearing_7804K107 | Bearing, 5x11x4mm | Buy | 2
XY_STD | Buy | 7 |  | Nema 17 Stepper Motor length 40mm | Stepper Motor, NEMA17, E3D High Torque Recommended | Buy | 2 | E3D High Torque 0.9 degree is Recommended
XY_STD | Buy | 8 |  | Opto endstop PM | Optical End-Stop | Buy | 1
XY_STD | Buy | 9 |  | LowerBelt GT2 6mm | GT2 6mm Belt | Buy | 1* | * See required length in the FrameCalculator: https://miragec79.github.io/HevORT/framecalculator.html
XY_STD | Buy | 10 |  | GT2 20T Pulley 3mm bore v1 | Pulley, Toothed - 20tooth GT2 6mm, 3mm bore | Buy | 6 | CAUTION! The pulleys for this gantry are 8.5mm in height.
XY_STD | Buy | 11 |  | GT2 Pulley Idler v3 | Pulley, Toothless - Eq 20 tooth GT2 6mm, 3mm bore | Buy | 4 | CAUTION! The pulleys for this gantry are 8.5mm in height.
XY_STD | Buy | 12 |  | GT2 Timing Pulley 20T 6mm - Hole_5mm v4 | Pulley, Timming - 20tooth GT2 6mm, 5mm bore | Buy | 2
XY_STD | Buy | 13 |  | UpperBelt GT2 6mm | GT2 6mm | Buy | 1* | * See required length in the FrameCalculator: https://miragec79.github.io/HevORT/framecalculator.html |  | https://s.click.aliexpress.com/e/_ALOsHe
XY_STD | Hardware | 14 |  | M3X10_CapScrew_92290A115 | Screw, Cap - M3X10mm | Buy | 34
XY_STD | Hardware | 15 |  | M3X8_CapScrew_92290A113 | Screw, Cap - M3X8mm | Buy | 25
XY_STD | Hardware | 16 |  | M5X10_ButtonHeadScrew_97763A820 | Screw, ButtonHead - M5X10mm | Buy | 2
XY_STD | Hardware | 17 |  | M3X30_CapScrew_92290A126 | Screw, Cap - M3X30mm | Buy | 5
XY_STD | Hardware | 18 |  | M3X20_CapScrew_92290A122 | Screw, Cap - M3X20mm | Buy | 6
XY_STD | Hardware | 19 |  | M6_TSlot_Nut | Nut, T-Slot - M6 for 3030 profile | Buy | 27
XY_STD | Hardware | 20 |  | M3X3030_TSlot_Nut | Nut, TSlot - M3X3030 for Y Axis | Buy | 24 | Qty 16 based on X&Y Print size at 315. Add Qty2 (one per Y side) for every additional 5cm of Y axis over 315mm. (one every 2 holes) | AliExpress | https://s.click.aliexpress.com/e/_AL5GuY
XY_STD | Hardware | 21 |  | M3X2020_T-Nut | Nut, TSlot - M3X2020 for X axis | Buy | 8 | Qty 8 based on X&Y Print size at 315. Add Qty1 for every additional 5cm of Y axis over 315mm. (one every 2 holes) | AliExpress | https://s.click.aliexpress.com/e/_A1wo9I
XY_STD | Hardware | 22 |  | M6X14_ButtonHeadScrew_92095A227 | Screw, ButtonHead - M6X14mm | Buy | 27
XY_STD | Hardware | 23 |  | M3_Nut_94150A325 | Nut, Hex - M3 | Buy | 15
XY_STD | Hardware | 24 |  | M3X12_CapScrew_92290A117 | Screw, Cap - M3X12mm | Buy | 2
XY_STD | Hardware | 25 |  | M3X25_CapScrew_92290A124 | Screw, Cap - M3X25mm | Buy | 5
XY_STD | Hardware | 26 |  | M5X12_ButtonHeadScrew_91239A228 | Screw, ButtonHead - M5X12mm | Buy | 4
XY_STD | Hardware | 27 |  | M5X20_ButtonHeadScrew_91239A233 | Screw, ButtonHead - M5X20mm | Buy | 2
XY_STD | Hardware | 28 |  | M5X2020_T-Nut_91239A224 | Nut, T-Slot - M5 for 2020 profile | Buy | 6
XY_STD | Hardware | 29 |  | M3X6_CapScrew_92290A111 | Screw, Cap - M3X6mm | Buy | 4
XY_STD | Hardware | 30 |  | M3X16_CapScrew_92290A120 | Screw, Cap - M3X16mm | Buy | 4
XY_STD | Make | 31 |  | XY_EndStop_Flag_V1 | XY End Stop Flag | Make | 1 |  | Thigiverse | https://www.thingiverse.com/thing:4184477
XY_STD | Make | 32 |  | MotorBracket_LEFT_Body (1) | Motor Bracket Left | Make | 1 |  | Thigiverse | https://www.thingiverse.com/thing:4184477
XY_STD | Make | 33 |  | MotorCover_BODY_LEFT | Motor Cover Left | Make | 1 |  | Thigiverse | https://www.thingiverse.com/thing:4184477
XY_STD | Make | 34 |  | PulleyMount_REAR_LEFT_Body | Pulley Mount Rear Left | Make | 1 |  | Thigiverse | https://www.thingiverse.com/thing:4184477
XY_STD | Make | 35 |  | PulleyMount_FRONT_LEFT_BodyV1.1 | Pulley Mount Front Left | Make | 1 |  | Thigiverse | https://www.thingiverse.com/thing:4184477
XY_STD | Make | 36 |  | HevORT LOGO_Small_Grey | HevORT Logo, Small | Make | 1 |  | Thigiverse | https://www.thingiverse.com/thing:3532039/files
XY_STD | Make | 37 |  | PulleyMount_REAR_RIGHT_Body | Pulley Mount Rear Right | Make | 1 |  | Thigiverse | https://www.thingiverse.com/thing:4184477
XY_STD | Make | 38 |  | PulleyMount_FRONT_RIGHT_BodyV1.1 | Pulley Mount Front Right | Make | 1 |  | Thigiverse | https://www.thingiverse.com/thing:4184477
XY_STD | Make | 39 |  | MotorBracket_RIGHT_Body V1.1 | Motor Bracket Right | Make | 1 |  | Thigiverse | https://www.thingiverse.com/thing:4184477
XY_STD | Make | 40 |  | MotorCover_BODY_RIGHT | Motor Cover Rght | Make | 1 |  | Thigiverse | https://www.thingiverse.com/thing:4184477
XY_STD | Make | 41 |  | Y_Carriage_RIGHT_Body (1) | Carriage, Y Right | Make | 1 |  | Thigiverse | https://www.thingiverse.com/thing:4184477
XY_STD | Make | 42 |  | Y_Carriage_LEFT_Body (1) | Carriage, Y Left | Make | 1 |  | Thingiverse | https://www.thingiverse.com/thing:4184477
