MirageC79/HevORT/bom/BOM_X_Hemera.xlsx

SubAssy | Category | Thumbnail | PART DESCRIPTION | Make/Buy | QTY | Comment | Vendor | Vendor URL / STL Source
OPTION 1 - V6
X_PRINTHEAD_HEMERA_INSTL_V2v32 | *Option 1 - Bltouch Mount |  | X_Hemera_BlTouchMount_V6_BodyV1 (1) | Make | 1 |  | Thingiverse | https://www.thingiverse.com/thing:4238471
X_PRINTHEAD_HEMERA_INSTL_V2v32 | *Option 1-Heat Block |  | E3D V6 Hotend Assembly (Copper Plated Block recommended) | Buy | 1 |  | E3D-Online | https://e3d-online.com/v6-plated-copper-heater-block
OPTION 2 - Volcano
X_PRINTHEAD_HEMERA_INSTL_V2v32 | *Option 2 - BerAir Duct |  | BerdAir Volcano | Make | 1 |  | Thingiverse | https://www.thingiverse.com/thing:4238471
X_PRINTHEAD_HEMERA_INSTL_V2v32 | *Option 2 - Bltouch Mount |  | X_Hemera_BlTouchMount_Volcano_BodyV1 | Make | 1 |  | Thingiverse | https://www.thingiverse.com/thing:4238471
X_PRINTHEAD_HEMERA_INSTL_V2v32 | *Option 2-Heat Block |  | Volcano hotend - Assemble | Buy | 1 |  | E3D-Online | https://e3d-online.com/volcano-upgrade-kit
OPTION 3 - Super Volcano
X_PRINTHEAD_HEMERA_INSTL_V2v32 | *Option 3 - BerAir Duct |  | BerdAir SuperVolcano | Make | 1 |  | Thingiverse | https://www.thingiverse.com/thing:4238471
X_PRINTHEAD_HEMERA_INSTL_V2v32 | *Option 3 - Bltouch Mount |  | X_Hemera_BlTouchMount_SuperVolcanoBodyV1.5 | Make | 1 |  | Thingiverse | https://www.thingiverse.com/thing:4238471
X_PRINTHEAD_HEMERA_INSTL_V2v32 | *Option 3-Heat Block |  | E3D_SuperVolcano | Buy | 1 |  | E3D-Online | https://e3d-online.com/catalogsearch/result/?q=supervolcano
BASELINE
X_PRINTHEAD_HEMERA_INSTL_V2v32 | Buy |  | E3D_Hemera_Final v1 | Buy | 1 |  | E3D_Online | https://e3d-online.com/e3d-hemera-175-kit
X_PRINTHEAD_HEMERA_INSTL_V2v32 | Buy |  | bltouch | Buy | 1 |  | Various | See recommended Hardware suppliers
X_PRINTHEAD_HEMERA_INSTL_V2v32 | Buy |  | Opto endstop PM | Buy | 1
X_PRINTHEAD_HEMERA_INSTL_V2v32 | Make |  | X_CarriageBODY_Hemera_Body_V1 | Make | 1 |  | Thingiverse | https://www.thingiverse.com/thing:4238471
X_PRINTHEAD_HEMERA_INSTL_V2v32 | Make |  | X_CarriageTop_Hemera_Body | Make | 1 |  | Thingiverse | https://www.thingiverse.com/thing:4238471
X_PRINTHEAD_HEMERA_INSTL_V2v32 | Make |  | HevORT LOGO v1 | Make | 1 |  | Thingiverse | https://www.thingiverse.com/thing:4238471
X_PRINTHEAD_HEMERA_INSTL_V2v32 | Make |  | X_CarriageEndStopMount_Body | Make | 1 |  | Thingiverse | https://www.thingiverse.com/thing:4238471
X_PRINTHEAD_HEMERA_INSTL_V2v32 | Make |  | BeltTensionnerBlock | Make | 2 |  | Thingiverse | https://www.thingiverse.com/thing:4238471
X_PRINTHEAD_HEMERA_INSTL_V2v32 | Make |  | X_BeltHolderFL_Hemera | Make | 1 |  | Thingiverse | https://www.thingiverse.com/thing:4238471
X_PRINTHEAD_HEMERA_INSTL_V2v32 | Make |  | X_BeltHolderRR_Hemera | Make | 2 |  | Thingiverse | https://www.thingiverse.com/thing:4238471
X_PRINTHEAD_HEMERA_INSTL_V2v32 | Make |  | X_BeltHolder_LH | Make | 1 |  | Thingiverse | https://www.thingiverse.com/thing:4238471
X_PRINTHEAD_HEMERA_INSTL_V2v32 | Hardware |  | M3X8_CapScrew_92290A113 | Buy | 10 |  | Various | See recommended Hardware suppliers
X_PRINTHEAD_HEMERA_INSTL_V2v32 | Hardware |  | M3_Nut_94150A325 | Buy | 19 |  | Various | See recommended Hardware suppliers
X_PRINTHEAD_HEMERA_INSTL_V2v32 | Hardware |  | M3X10_CapScrew_92290A115 | Buy | 4 |  | Various | See recommended Hardware suppliers
X_PRINTHEAD_HEMERA_INSTL_V2v32 | Hardware |  | M3X14_CapScrew_92290A118 | Buy | 1 |  | Various | See recommended Hardware suppliers
X_PRINTHEAD_HEMERA_INSTL_V2v32 | Hardware |  | M3X8_FlatHead_93395A201 | Buy | 2 |  | Various | See recommended Hardware suppliers
X_PRINTHEAD_HEMERA_INSTL_V2v32 | Hardware |  | M3X20_CapScrew_92290A122 | Buy | 5 |  | Various | See recommended Hardware suppliers
X_PRINTHEAD_HEMERA_INSTL_V2v32 | Hardware |  | M3X12_CapScrew_92290A117 | Buy | 1 |  | Various | See recommended Hardware suppliers
X_PRINTHEAD_HEMERA_INSTL_V2v32 | Hardware |  | M3X16_CapScrew_92290A120 | Buy | 3 |  | Various | See recommended Hardware suppliers
X_PRINTHEAD_HEMERA_INSTL_V2v32 | Hardware |  | M3X30_CapScrew_92290A126 | Buy | 2 |  | Various | See recommended Hardware suppliers
