MirageC79/HevORT/docs/assets/references/frame/FrameCalculator.xlsx

Sheet: FRAMECALCULATOR
 |  |  |  |  | Desired Print Area | STD
 |  |  |  |  | X | 315 | 1. Adjust the Desired X dimension (Y will be adjusted automatically)*
 |  |  |  |  | Y | 315 | Same as X to ensure ZR arm alignment
 |  |  |  |  | Z | 340 | 2. Enter desired Z Dimension |  |  |  |  |  | 4. Right-Click in the table below and do "Refresh"
 |  |  |  |  | XY Gantry Type | HD | 3. Select Gantry Type |  |  |  |  |  | Select | x |  | 315x315x340 Version
 |  |  | Frame & Friends Calculator |  |  |  |  |  |  |  |  |  | Summary for: 315x315x340 - HD
STD_HT | HD | Select | Structure Section | CAD_Part | Description | Part Type | Length mm | Qty | Axis | STD | CONST |  | Sum of Qty
x | x | x | Frame | HHB | Horizontal_High_Back | 3030 Extrusion | 420 | 1 | X | 315 | 105 |  | Part Type | Length mm | Total
x | x | x | Frame | HHF | Horizontal_High_Front | 3030 Extrusion | 420 | 1 | X | 315 | 105 |  | 2020 Extrusion | 420 | 2
x | x | x | Frame | HHL | Horizontal_High_Left | 3030 Extrusion | 410 | 1 | Y | 315 | 95 |  | 2020 Extrusion | 360 | 2
x | x | x | Frame | HHR | Horizontal_High_Right | 3030 Extrusion | 410 | 1 | Y | 315 | 95
x | x | x | Frame | HLB | Horizontal_Low_Back | 3030 Extrusion | 420 | 1 | X | 315 | 105 |  | 3030 Extrusion | 140 | 4
x | x | x | Frame | HLF | Horizontal_Low_Front | 3030 Extrusion | 420 | 1 | X | 315 | 105 |  | 3030 Extrusion | 510 | 8
x | x | x | Frame | HLL | Horizontal_Low_Left | 3030 Extrusion | 410 | 1 | Y | 315 | 95 |  | 3030 Extrusion | 520 | 5
x | x | x | Frame | HLR | Horizontal_Low_Right | 3030 Extrusion | 410 | 1 | Y | 315 | 95 |  | 3030 Extrusion | 980 | 6
x | x | x | Frame | HMB | Horizontal_Mid_Back | 3030 Extrusion | 420 | 1 | X | 315 | 105 |  | 3030 Extrusion | 610 | 3
x | x | x | Frame | HML | Horizontal_Mid_Left | 3030 Extrusion | 410 | 1 | Y | 315 | 95
x | x | x | Frame | HMR | Horizontal_Mid_Right | 3030 Extrusion | 410 | 1 | Y | 315 | 95 |  | MGN12H Rail | 150 | 3
x | x | x | Frame | VBL | Vertical_Back_Left | 3030 Extrusion | 880 | 1 | Z | 340 | 540 |  | MGN12H Rail | 450 | 1
x | x | x | Frame | VBR | Vertical_Back_Right | 3030 Extrusion | 880 | 1 | Z | 340 | 540 |  | MGN12H Rail | 500 | 2
x | x | x | Frame | VFL | Vertical_Front_Left | 3030 Extrusion | 880 | 1 | Z | 340 | 540 |  | MGN12H Rail | 550 | 3
x | x | x | Frame | VFR | Vertical_Front_Right | 3030 Extrusion | 880 | 1 | Z | 340 | 540
x | x | x | Xtension_ElectronicBay | XHH | Xtension_Horizontal_High_Right | 3030 Extrusion | 410 | 1 | Y | 315 | 95 |  | SFU1204 Screw | 550 | 3
x | x | x | Xtension_ElectronicBay | XHHB | Xtension_Horizontal_High_Back | 3030 Extrusion | 140 | 1 | NA | 140 | 140
x | x | x | Xtension_ElectronicBay | XHHF | Xtension_Horizontal_High_Front | 3030 Extrusion | 140 | 1 | NA | 140 | 140 |  | GT2 Belt | 4800 | 1
x | x | x | Xtension_ElectronicBay | XHLB | Xtension_Horizontal_Low_Back | 3030 Extrusion | 140 | 1 | NA | 140 | 140
x | x | x | Xtension_ElectronicBay | XHLF | Xtension_Horizontal_Low_Front | 3030 Extrusion | 140 | 1 | NA | 140 | 140 |  | MIC6 Alu 6mm (Square) | 440 | 1
x | x | x | Xtension_ElectronicBay | XHLR | Xtension_Horizontal_Low_Right | 3030 Extrusion | 410 | 1 | Y | 315 | 95
x | x | x | Xtension_ElectronicBay | XVBR | Xtension_Vertical_Back_Right | 3030 Extrusion | 880 | 1 | Z | 340 | 540 |  | SiliconeHeatPad (Square) | 400 | 1
x | x | x | Xtension_ElectronicBay | XVF | Xtension_Vertical_Front | 3030 Extrusion | 880 | 1 | Z | 340 | 540
x | x | x | ZR_Support | VFL_ZR | ZR Doubler Vertical_Front_Left | 3030 Extrusion | 510 | 1 | Z | 340 | 170 |  | 2020 Extrusion (HD Only) | 520 | 1
x | x | x | ZR_Support | VFR_ZR | ZR Doubler Vertical_Front_Right | 3030 Extrusion | 510 | 1 | Z | 340 | 170
x | x | x | ZR_Support | VRR_ZR | ZR Doubler Vertical_Rear | 3030 Extrusion | 510 | 1 | Z | 340 | 170
x | x | x | BedFrame | BedFR | BedFrame Front | 2020 Extrusion | 260 | 1 | X | 315 | -55
x | x | x | BedFrame | BedRR | BedFrame Rear | 2020 Extrusion | 260 | 1 | X | 315 | -55
x | x | x | BedFrame | BedLH | BedFrame Left | 2020 Extrusion | 320 | 1 | Y | 315 | 5
x | x | x | BedFrame | BedRH | BedFrame Right | 2020 Extrusion | 320 | 1 | Y | 315 | 5
x |  | 0 | X Axis Support | Track_X_2020Profile | X axis support aluminum profile 2020 | 2020 Extrusion | 431 | 1 | X | 315 | 116
x | x | x | BedPlate | BedPlate | Bed Plate (Square) | MIC6 Alu 6mm (Square) | 340 | 1 | X | 315 | 25 | XY | Z
x |  | 0 | STD/HT XYRails | Y_MGN12C_Left | MGN12 Rail with MGNC (Compact Bloc) | MGN12C Rail | 400 | 1 | Y | 315 | 85 | 315 | 340
x |  | 0 | STD/HT XYRails | Y_MGN12C_Right | MGN12 Rail with MGNC (Compact Bloc) | MGN12C Rail | 400 | 1 | Y | 315 | 85 | 365 | 390
x |  | 0 | STD/HT XYRails | X_MGN12H | MGN12 Rail with MGN12H (Normal Bloc) | MGN12H Rail | 385 | 1 | X | 315 | 70 | 415 | 440
x | x | x | ZR_Motion | ZR_MGN12H_FL | MGN12 Rail with MGN12H (Normal Bloc) | MGN12H Rail | 450 | 1 | Z | 340 | 110 | 465 | 490
x | x | x | ZR_Motion | ZR_MGN12H_FR | MGN12 Rail with MGN12H (Normal Bloc) | MGN12H Rail | 450 | 1 | Z | 340 | 110 | 515 | 540
x | x | x | ZR_Motion | ZR_MGN12H_RR | MGN12 Rail with MGN12H (Normal Bloc) | MGN12H Rail | 450 | 1 | Z | 340 | 110 | 565 | 590
x | x | x | ZR_Motion | ZR_MGN12H_BED | MGN12 Rail with MGN12H (Normal Bloc) | MGN12H Rail | 150 | 3 | NA | 150 | 150 | 615 | 640
x | x | x | ZR_Motion | ZR_SFU1204_FL | Ball Screw SFU1204 Front Left | SFU1204 Screw BK10/BF10 | 450 | 1 | Z | 340 | 110 | 665 | 690
x | x | x | ZR_Motion | ZR_SFU1204_FR | Ball Screw SFU1204 Front Right | SFU1204 Screw BK10/BF10 | 450 | 1 | Z | 340 | 110
x | x | x | ZR_Motion | ZR_SFU1204_RR | Ball Screw SFU1204 Front Rear | SFU1204 Screw BK10/BF10 | 450 | 1 | Z | 340 | 110
x | x | x | XY_Belts | Upper and Lower Belts | Gates GT2 PowerGrip Belt | GT2 Belt | 4000 | 1 | Y | 315 | 1480
x | x | x | ZR_HeaterPad | ZR_SiliconeHeatPad | Silicone Heat Pad (Keenovo Recommended) | SiliconeHeatPad (Square) | 300 | 1 | X | 315 | -15
 | x | x | HD_X axis Support | Track_XHD_2020Profile | X axis support for HD9 and HD12 only. Replaces Regular X Axis if HD version is selected. | 2020 Extrusion (HD Only) | 420 | 1 | X | 315 | 105
 | x | x | HD_XYRails | Y_MGN12H | MGN12 Rail with MGN12H (Normal Block) | MGN12H Rail | 400 | 1 | Y | 315 | 85
 | x | x | HD_XYRails | Y_MGN12H | MGN12 Rail with MGN12H (Normal Block) | MGN12H Rail | 400 | 1 | Y | 315 | 85
 | x | x | HD_XYRails | X_MGN12H | MGN12 Rail with MGN12H (Normal Block) | MGN12H Rail | 350 | 1 | X | 315 | 35

Sheet: BED Holes Location
As entered on the previous sheet:
Desired Print Area | mm
X | 315
Y | 315
Bed Size | mm
X | 340
Y | 340
Mounting Hole Spacing | mm
X | 327
Y | 302
Heated Pad recommended size
X | 300
Y | 300
