MirageC79/HevORT/bom/BOM_BMGAqua_files/BOM_BMGAqua_2101_image041.png

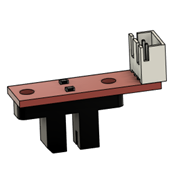
bom/BOM_BMGAqua_files/BOM_BMGAqua_2101_image041.png
