MirageC79/HevORT/bom/BOM_BMGAqua_files/BOM_BMGAqua_2101_image057.png

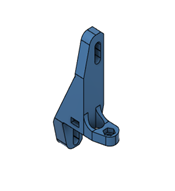
bom/BOM_BMGAqua_files/BOM_BMGAqua_2101_image057.png
