MirageC79/HevORT/bom/BOM_Electronics_files/BOM_Electronics_28008_image003.png

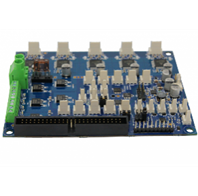
bom/BOM_Electronics_files/BOM_Electronics_28008_image003.png
