MirageC79/HevORT/bom/BOM_Electronics_files/BOM_Electronics_28008_image010.png

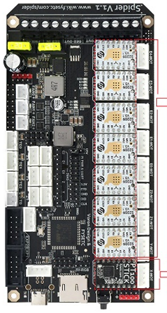
bom/BOM_Electronics_files/BOM_Electronics_28008_image010.png
