MirageC79/HevORT/bom/BOM_Electronics_files/BOM_Electronics_28008_image023.png

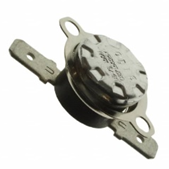
bom/BOM_Electronics_files/BOM_Electronics_28008_image023.png
