MirageC79/HevORT/bom/BOM_Electronics_files/BOM_Electronics_28008_image028.png

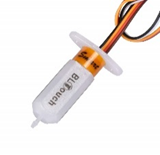
bom/BOM_Electronics_files/BOM_Electronics_28008_image028.png
