MirageC79/HevORT/bom/BOM_Enclosure_AcidBee_files/BOM_HextrudORT_Extruder_Dragon_24158_image075.png

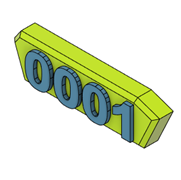
bom/BOM_Enclosure_AcidBee_files/BOM_HextrudORT_Extruder_Dragon_24158_image075.png
