MirageC79/HevORT/bom/BOM_Frame_ElecExt_files/BOM_Frame_ElecExt_28674_image044.png

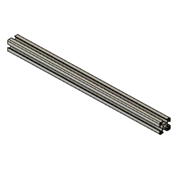
bom/BOM_Frame_ElecExt_files/BOM_Frame_ElecExt_28674_image044.png
