MirageC79/HevORT/bom/BOM_SpoolHolder_files/BOM_SpoolHolder_12887_image005.png

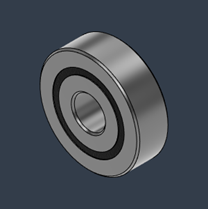
bom/BOM_SpoolHolder_files/BOM_SpoolHolder_12887_image005.png
