MirageC79/HevORT/bom/BOM_SpoolHolder_files/BOM_SpoolHolder_12887_image017.png

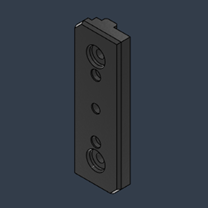
bom/BOM_SpoolHolder_files/BOM_SpoolHolder_12887_image017.png
