MirageC79/HevORT/bom/BOM_VezMetalPrintHead_GoliathLong_VZHextrudORT_files/BOM_VezMetalPrintHead_GoliathShort_VZHextrudORT_WC_8106_image009.png

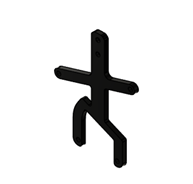
bom/BOM_VezMetalPrintHead_GoliathLong_VZHextrudORT_files/BOM_VezMetalPrintHead_GoliathShort_VZHextrudORT_WC_8106_image009.png
