MirageC79/HevORT/bom/BOM_VezMetalPrintHead_GoliathShort_VZHextrudORT_WC_files/BOM_VezMetalPrintHead_GoliathShort_VZHextrudORT_WC_8106_image028.png

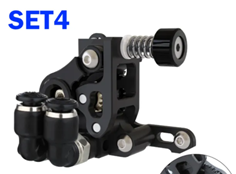
bom/BOM_VezMetalPrintHead_GoliathShort_VZHextrudORT_WC_files/BOM_VezMetalPrintHead_GoliathShort_VZHextrudORT_WC_8106_image028.png
