MirageC79/HevORT/bom/BOM_WaterCooling_Bay_files/BOM_WaterCooling_Bay_23836_image027.png

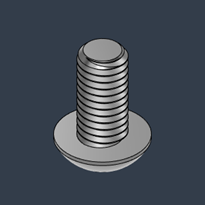
bom/BOM_WaterCooling_Bay_files/BOM_WaterCooling_Bay_23836_image027.png
