MirageC79/HevORT/bom/BOM_X_Hemera_files/BOM_X_Hemera_1576_image025.png

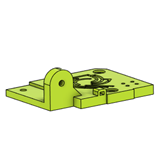
bom/BOM_X_Hemera_files/BOM_X_Hemera_1576_image025.png
