MirageC79/HevORT/bom/BOM_X_HemeraTopMount_files/BOM_X_HemeraTopMount_14403_image011.png

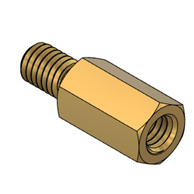
bom/BOM_X_HemeraTopMount_files/BOM_X_HemeraTopMount_14403_image011.png
