MirageC79/HevORT/bom/BOM_XY_HD9_10_SPAWD_files/BOM_XY_HD9_10_SPAWD_27310_image051.png

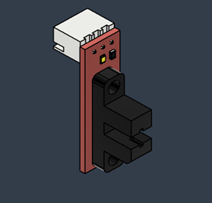
bom/BOM_XY_HD9_10_SPAWD_files/BOM_XY_HD9_10_SPAWD_27310_image051.png
