MirageC79/HevORT/bom/BOM_XY_HD12_SPAWD_files/BOM_XY_HD12_SPAWD_30499_image045.png

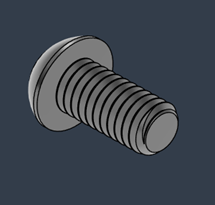
bom/BOM_XY_HD12_SPAWD_files/BOM_XY_HD12_SPAWD_30499_image045.png
