MirageC79/HevORT/bom/BOM_XY_STD_files/BOM_XY_STD_21161_image075.png

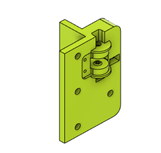
bom/BOM_XY_STD_files/BOM_XY_STD_21161_image075.png
