MirageC79/HevORT/bom/BOM_XYHD9_files/BOM_XYHD9_2337_image055.png

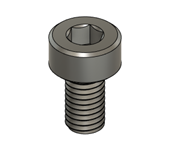
bom/BOM_XYHD9_files/BOM_XYHD9_2337_image055.png
