MirageC79/HevORT/bom/BOM_XYHD12_files/BOM_XYHD12_10673_image013.png

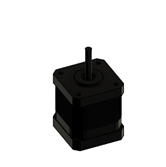
bom/BOM_XYHD12_files/BOM_XYHD12_10673_image013.png
