MirageC79/HevORT/bom/BOM_ZR_V2.6_files/BOM_ZR_V2_6083_image085.png

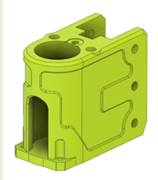
bom/BOM_ZR_V2.6_files/BOM_ZR_V2_6083_image085.png
