MirageC79/HevORT/bom/Option_HD9_CFx_TopRail_MGN9_files/Option_HD9_CFx_MGN9_4722_image047.png

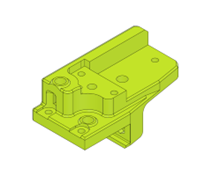
bom/Option_HD9_CFx_TopRail_MGN9_files/Option_HD9_CFx_MGN9_4722_image047.png
