MirageC79/HevORT/bom/Option_HD12_CFx_MGN9_files/Option_HD12_CFx_MGN9_16201_image033.png

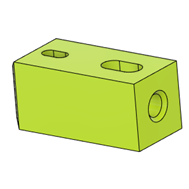
bom/Option_HD12_CFx_MGN9_files/Option_HD12_CFx_MGN9_16201_image033.png
