MirageC79/HevORT/bom/Option_HD12_CFx_TopRail_MGN9_files/image007.png

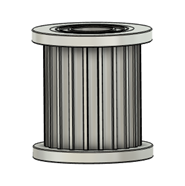
bom/Option_HD12_CFx_TopRail_MGN9_files/image007.png
