MirageC79/HevORT/bom/Option_HD12_CFx_TopRail_MGN9_files/image047.png

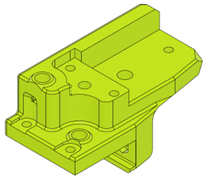
bom/Option_HD12_CFx_TopRail_MGN9_files/image047.png
