MirageC79/HevORT/bom/Option_XYHT_CFX_MGN9_files/Option_XYHT_CFX_MGN9_20904_image005.png

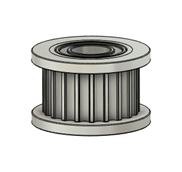
bom/Option_XYHT_CFX_MGN9_files/Option_XYHT_CFX_MGN9_20904_image005.png
