MirageC79/HevORT/docs/assets/images/components/AcidBeeThumb.png

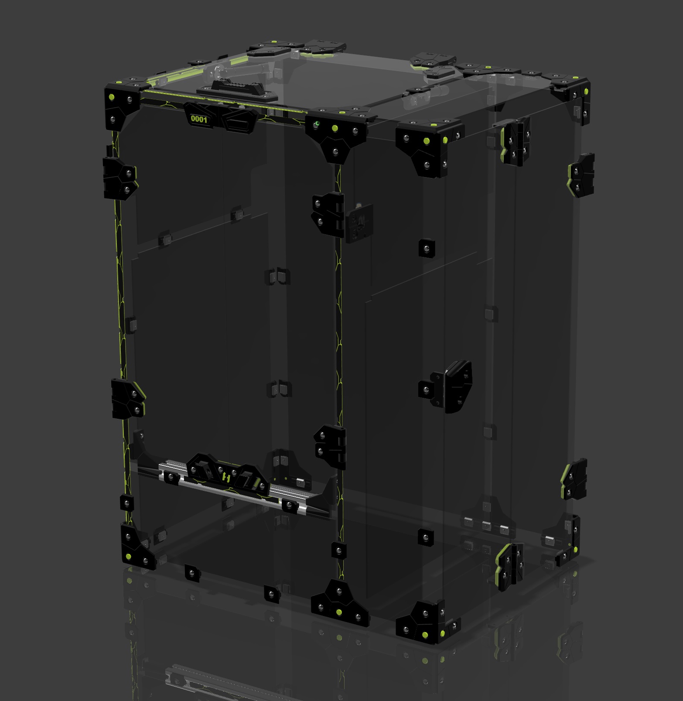
docs/assets/images/components/AcidBeeThumb.png
