MirageC79/HevORT/docs/assets/images/components/FrameThumb.jpg

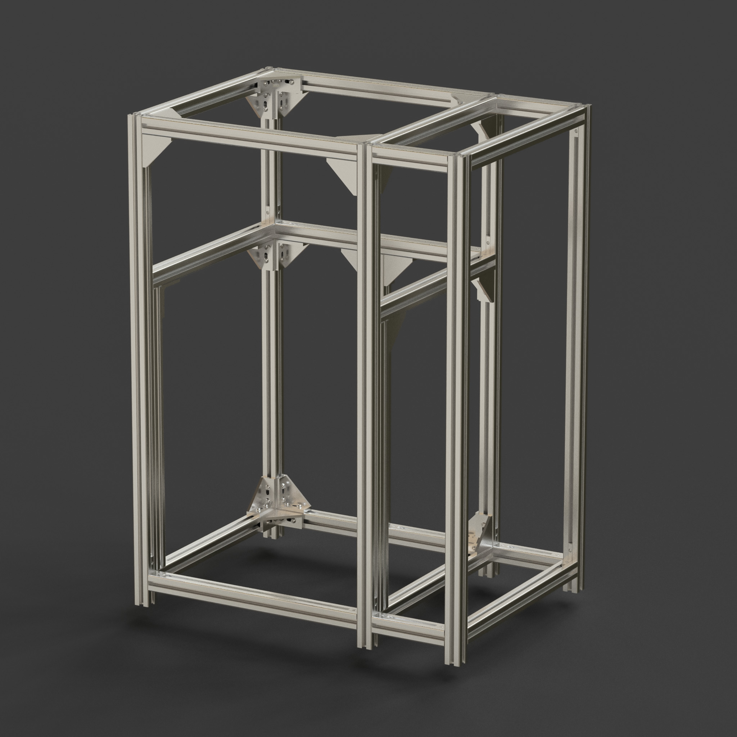
docs/assets/images/components/FrameThumb.jpg
