MirageC79/HevORT/docs/assets/images/components/HD12_XcrossThumb.png

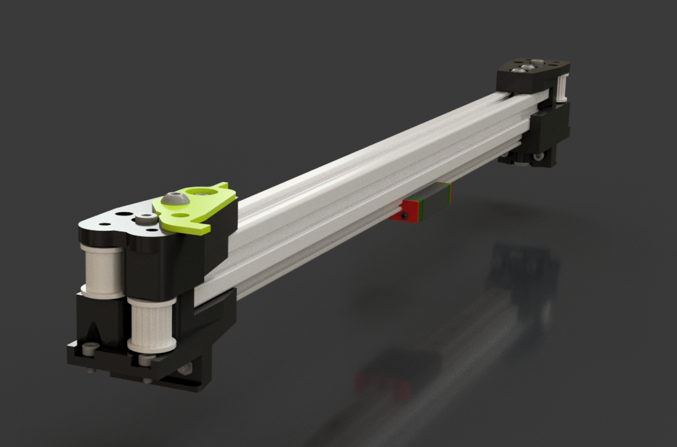
docs/assets/images/components/HD12_XcrossThumb.png
