MirageC79/HevORT/docs/assets/images/components/HemeraThumb.jpg

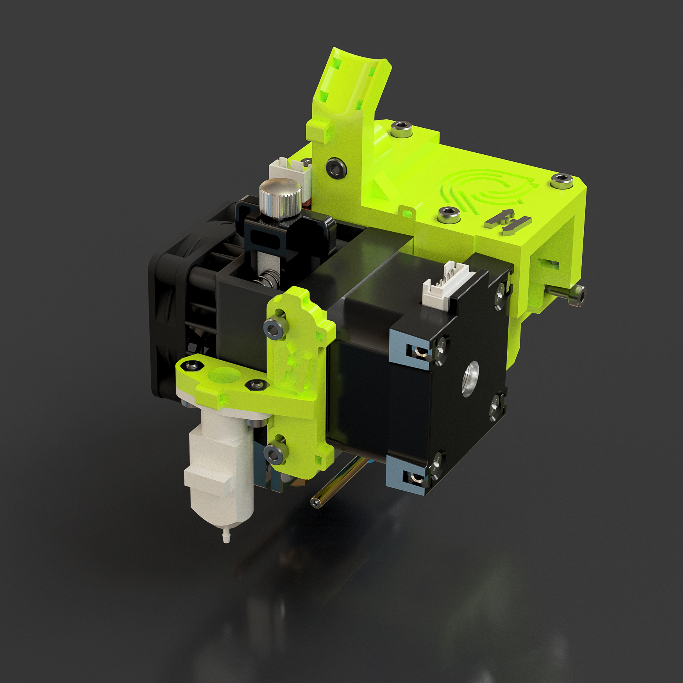
docs/assets/images/components/HemeraThumb.jpg
