MirageC79/HevORT/docs/assets/images/components/HextrudORT_CoverThumb.jpg

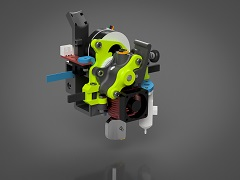
docs/assets/images/components/HextrudORT_CoverThumb.jpg
