MirageC79/HevORT/docs/assets/images/components/OPTION_HD9_CFX_MGN9_VZ_Thumb.jpg

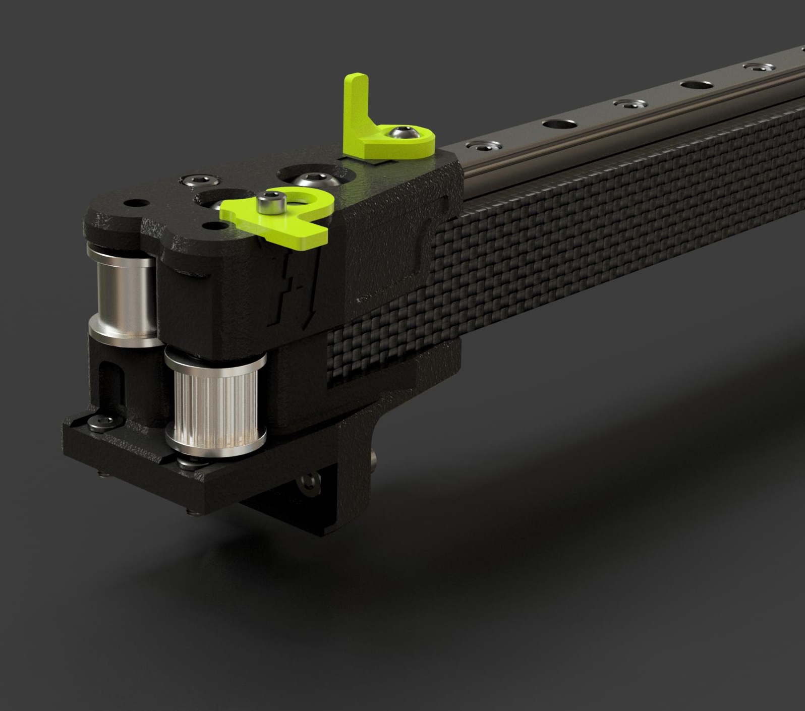
docs/assets/images/components/OPTION_HD9_CFX_MGN9_VZ_Thumb.jpg
