MirageC79/HevORT/docs/assets/images/components/OPTION_XYHT_CFX_MGN9_Thumb.jpg

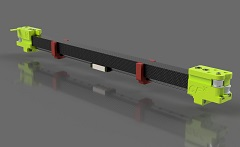
docs/assets/images/components/OPTION_XYHT_CFX_MGN9_Thumb.jpg
