MirageC79/HevORT/docs/assets/images/components/SPAWD9Thumb.png

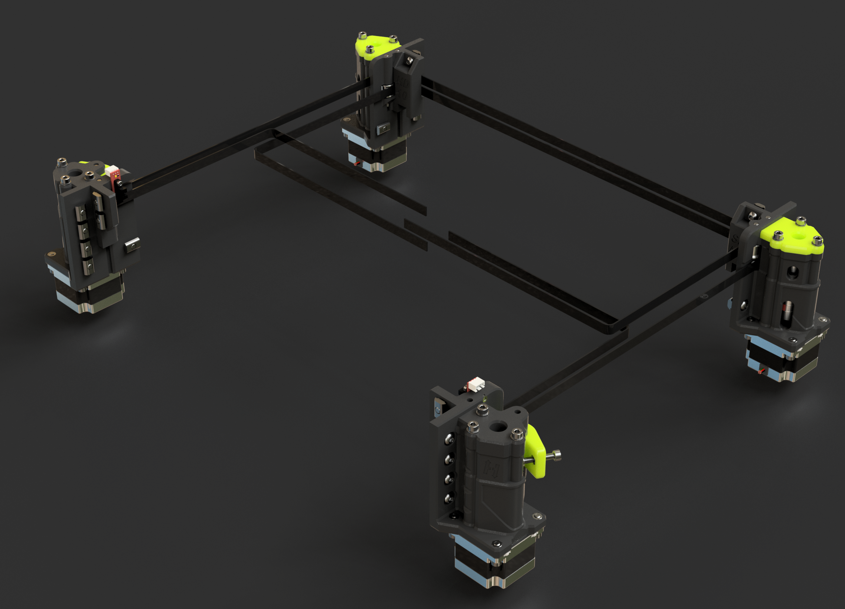
docs/assets/images/components/SPAWD9Thumb.png
