MirageC79/HevORT/docs/assets/images/components/SPAWD12Thumb.png

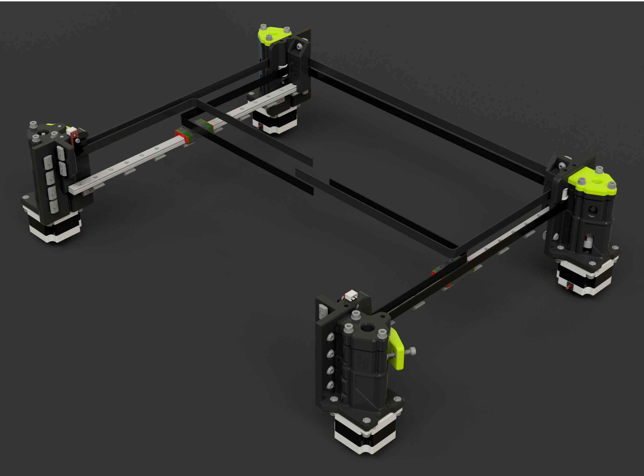
docs/assets/images/components/SPAWD12Thumb.png
