MirageC79/HevORT/docs/assets/images/components/VZPinthead_GoliathLongThumb.jpg

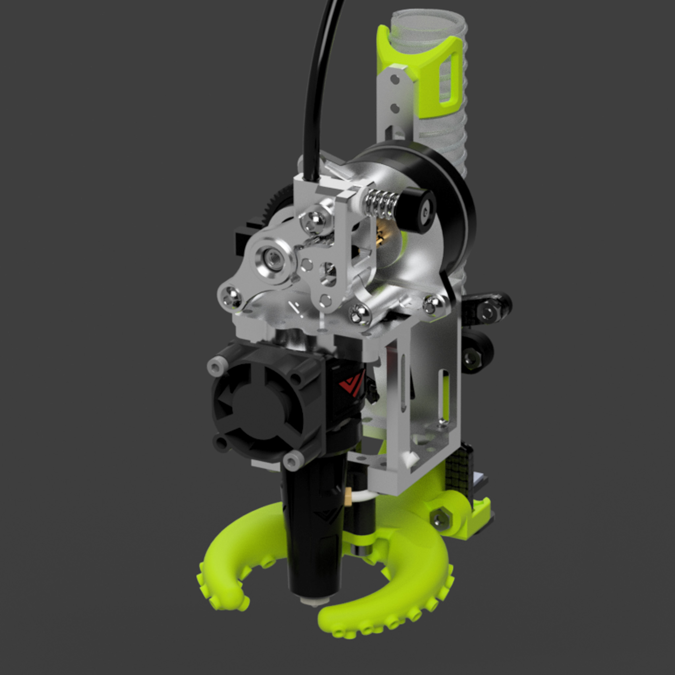
docs/assets/images/components/VZPinthead_GoliathLongThumb.jpg
