MirageC79/HevORT/docs/assets/images/components/VZPinthead_GoliathShortThumb.jpg

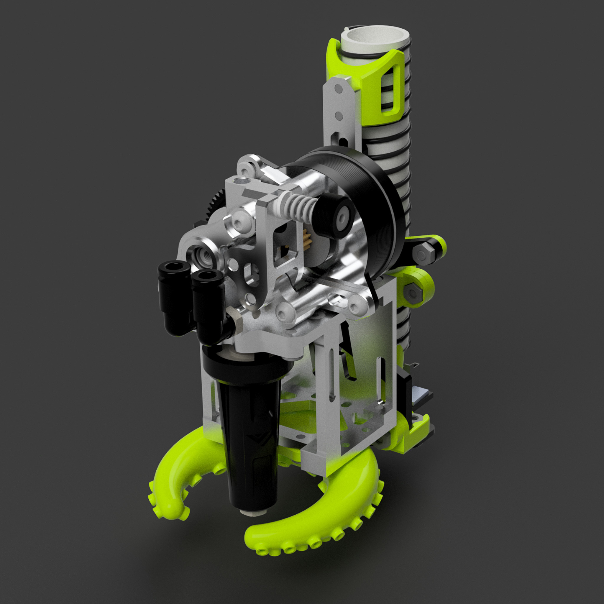
docs/assets/images/components/VZPinthead_GoliathShortThumb.jpg
