MirageC79/HevORT/docs/assets/images/components/WatercoolingbayThumb.jpg

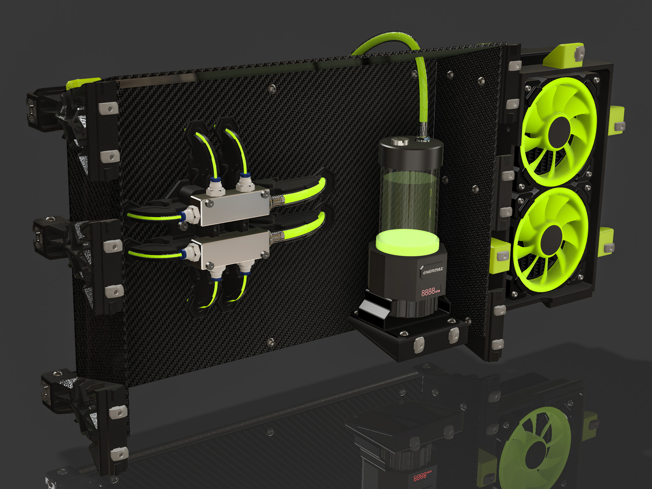
docs/assets/images/components/WatercoolingbayThumb.jpg
