MirageC79/HevORT/docs/assets/images/components/XY_XcrossThumb.jpg

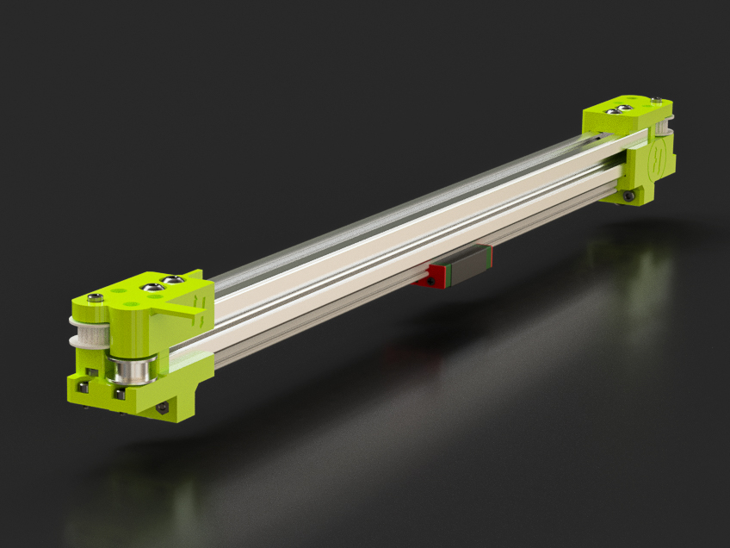
docs/assets/images/components/XY_XcrossThumb.jpg
