MirageC79/HevORT/docs/assets/images/components/XYHD9_CFx_MGN9_TopRail_Thumb.jpg

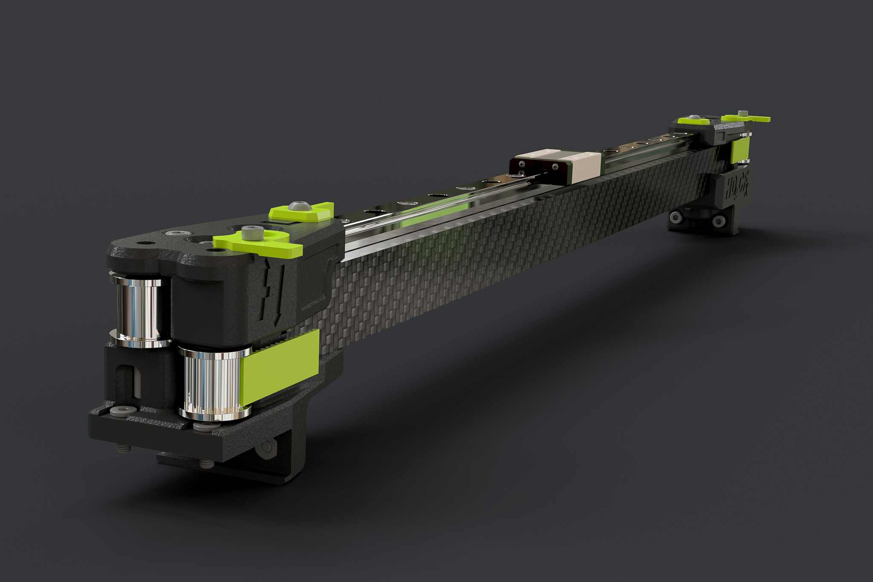
docs/assets/images/components/XYHD9_CFx_MGN9_TopRail_Thumb.jpg
