MirageC79/HevORT/docs/assets/images/components/XYHD12Thumb.png

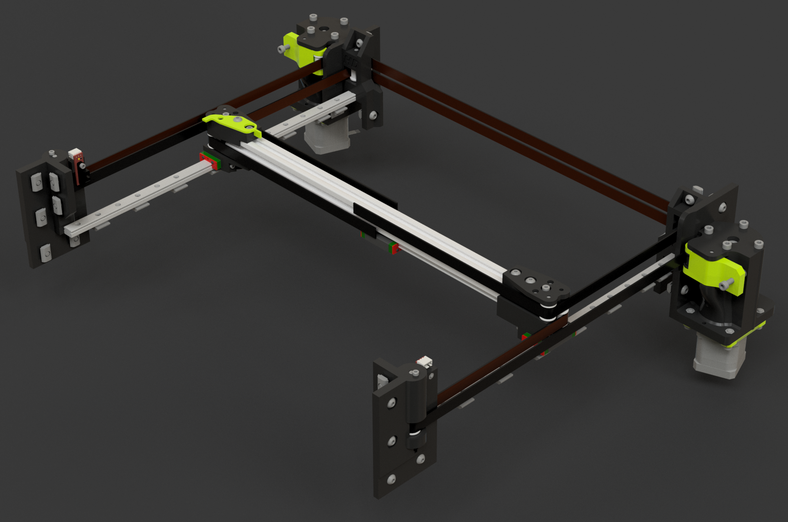
docs/assets/images/components/XYHD12Thumb.png
