MirageC79/HevORT/docs/assets/images/components/XYHT_XcrossThumb.png

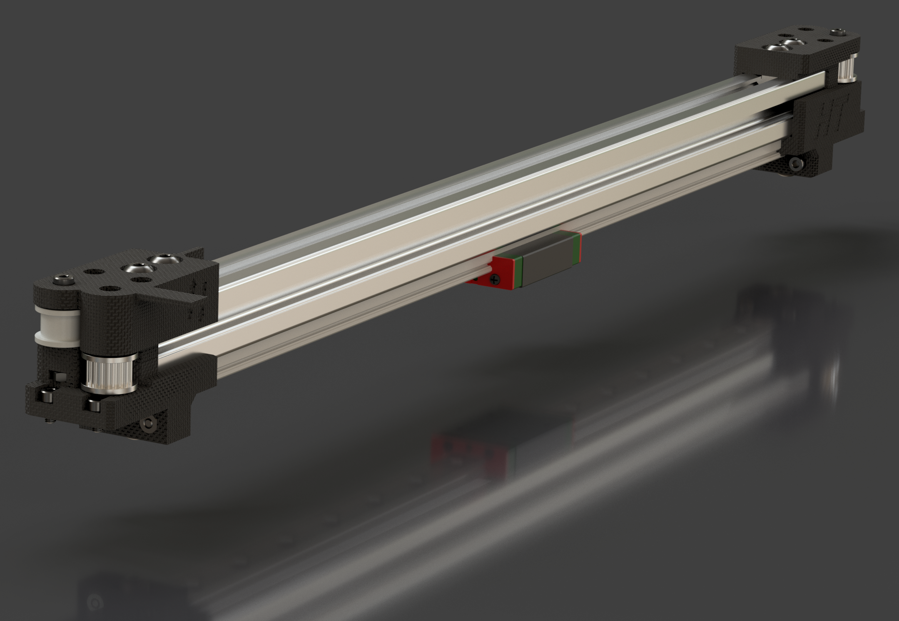
docs/assets/images/components/XYHT_XcrossThumb.png
