MirageC79/HevORT/docs/assets/images/components/XYHTThumb.png

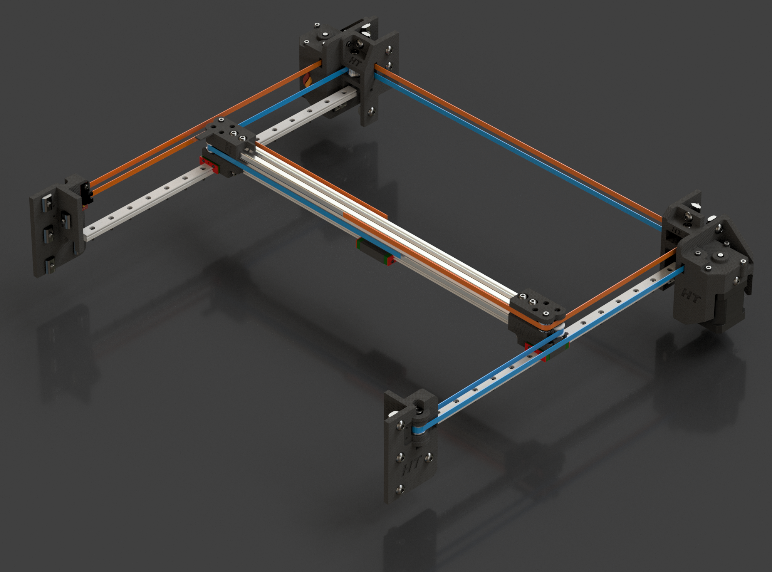
docs/assets/images/components/XYHTThumb.png
