MirageC79/HevORT/docs/assets/images/components/XYThumb.jpg

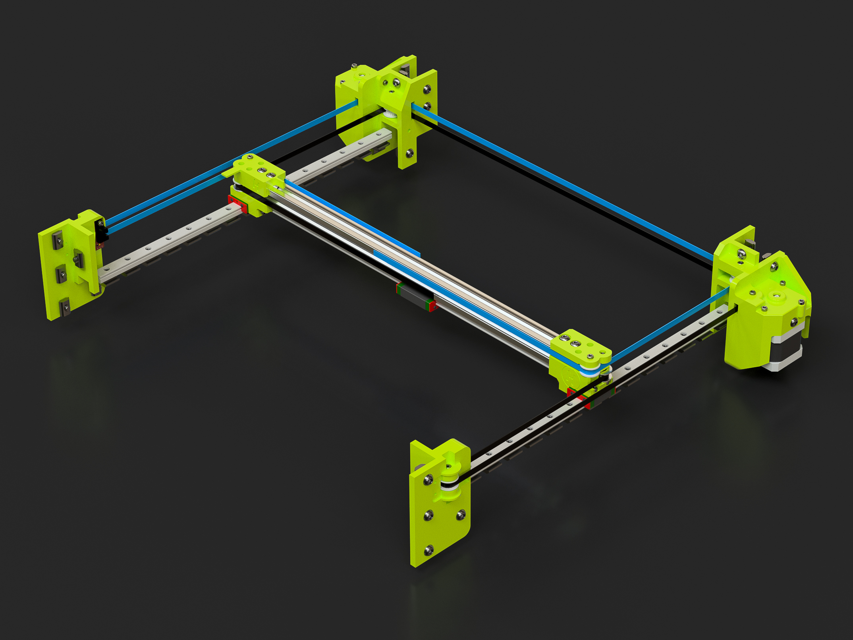
docs/assets/images/components/XYThumb.jpg
