MirageC79/HevORT/docs/assets/images/components/XYThumb.png

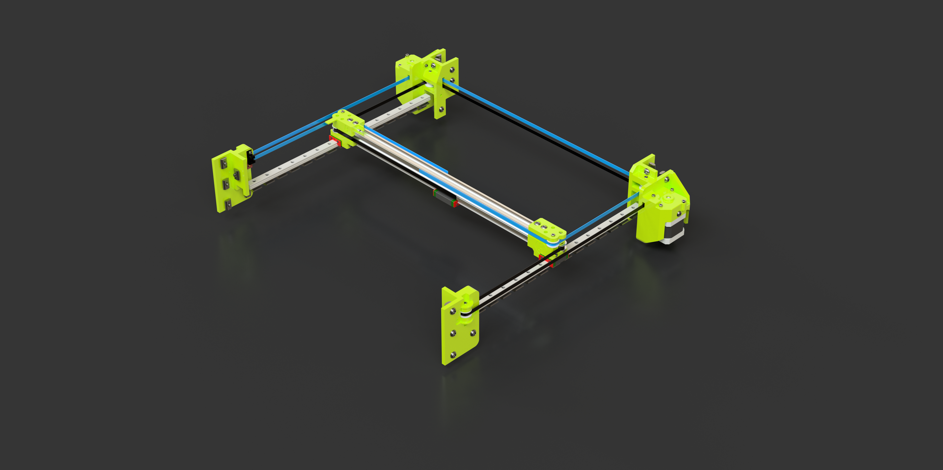
docs/assets/images/components/XYThumb.png
