MirageC79/HevORT/docs/assets/images/components/ZR_V2.5_Thumb.jpg

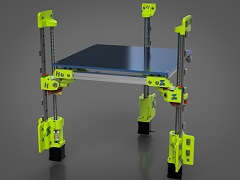
docs/assets/images/components/ZR_V2.5_Thumb.jpg
