MirageC79/HevORT/docs/assets/images/components/ZR_V2.6_Thumb.jpg

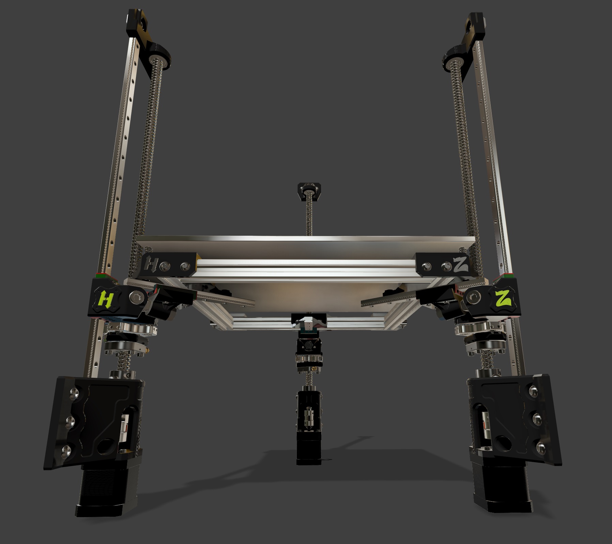
docs/assets/images/components/ZR_V2.6_Thumb.jpg
