MirageC79/HevORT/files/Components/Enclosure/AcidBee_Enclosure/images/3030 Extrusion Slot covers v2.png

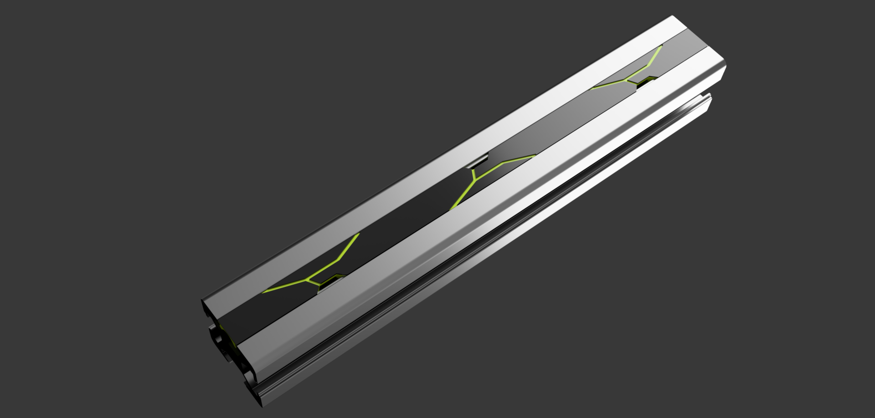
files/Components/Enclosure/AcidBee_Enclosure/images/3030 Extrusion Slot covers v2.png
