MirageC79/HevORT/files/Components/Enclosure/AcidBee_Enclosure/images/AcidBee_Enclosure_Release1.jpg

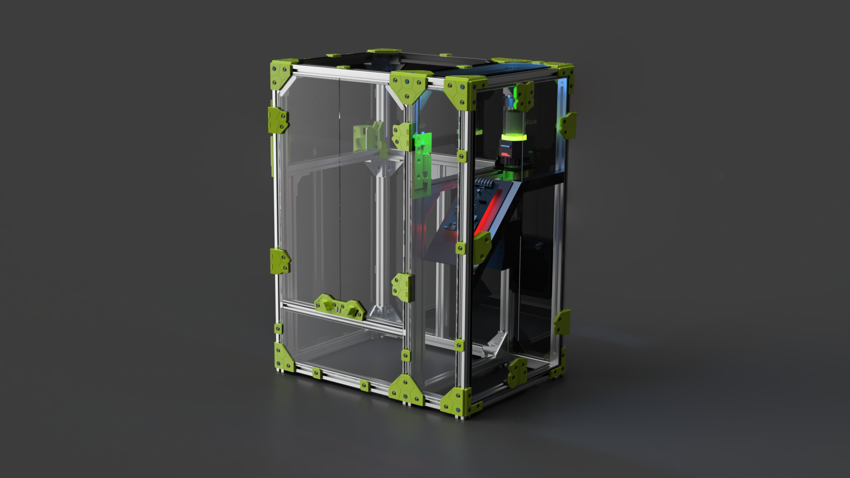
files/Components/Enclosure/AcidBee_Enclosure/images/AcidBee_Enclosure_Release1.jpg
