MirageC79/HevORT/files/Components/Enclosure/AcidBee_Enclosure/images/DoorsOpened.jpg

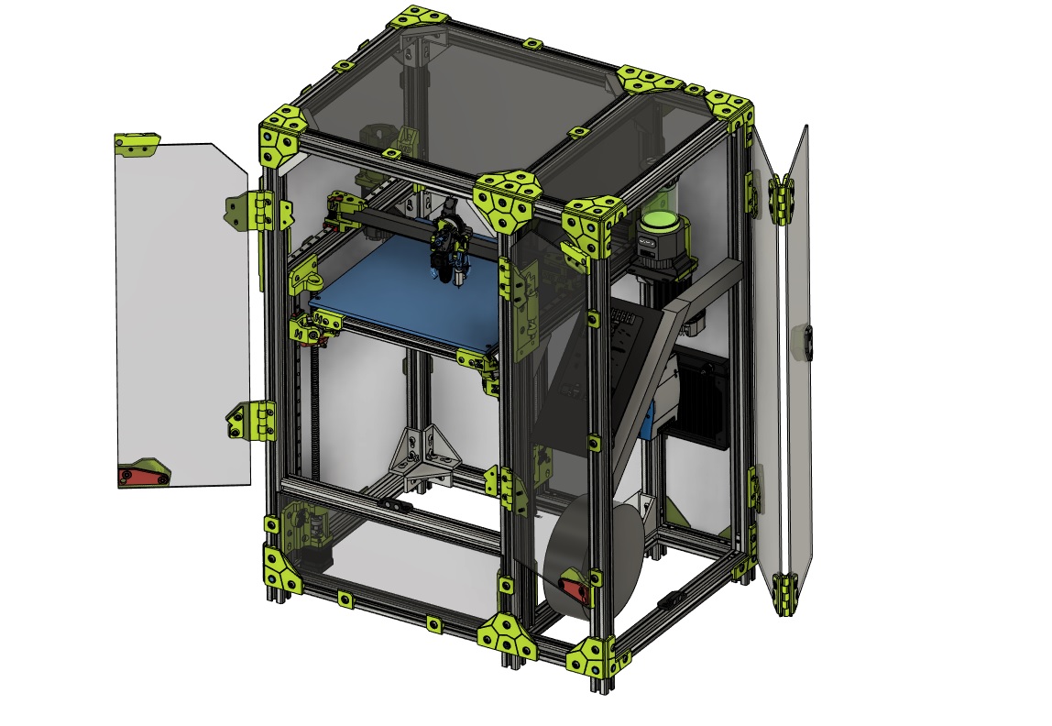
files/Components/Enclosure/AcidBee_Enclosure/images/DoorsOpened.jpg
