MirageC79/HevORT/files/Components/Enclosure/AcidBee_Enclosure/images/Enclosure_HD12 v93.jpg

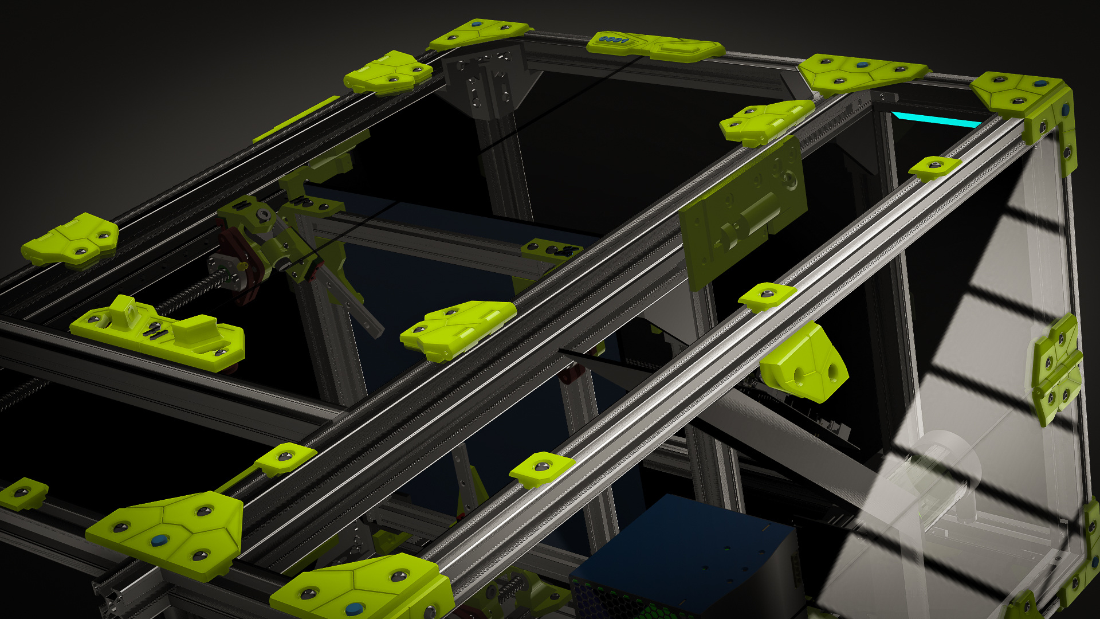
files/Components/Enclosure/AcidBee_Enclosure/images/Enclosure_HD12 v93.jpg
