MirageC79/HevORT/files/Components/Enclosure/AcidBee_Enclosure/images/Enclosure_HD12 v93.png

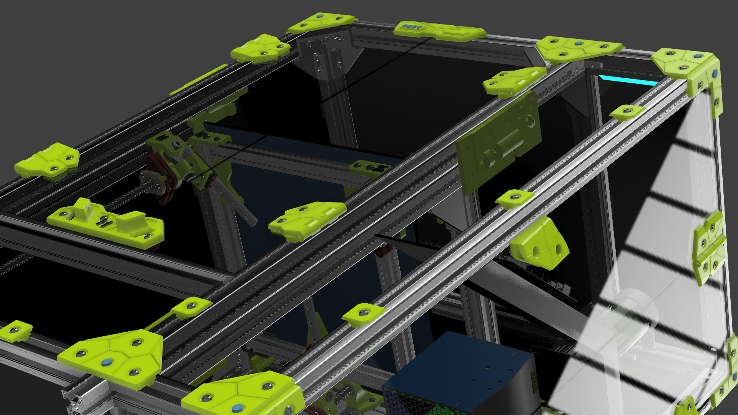
files/Components/Enclosure/AcidBee_Enclosure/images/Enclosure_HD12 v93.png
