MirageC79/HevORT/files/Components/Enclosure/WaterCooling_Bay/images/Watercoolingbay_back.png

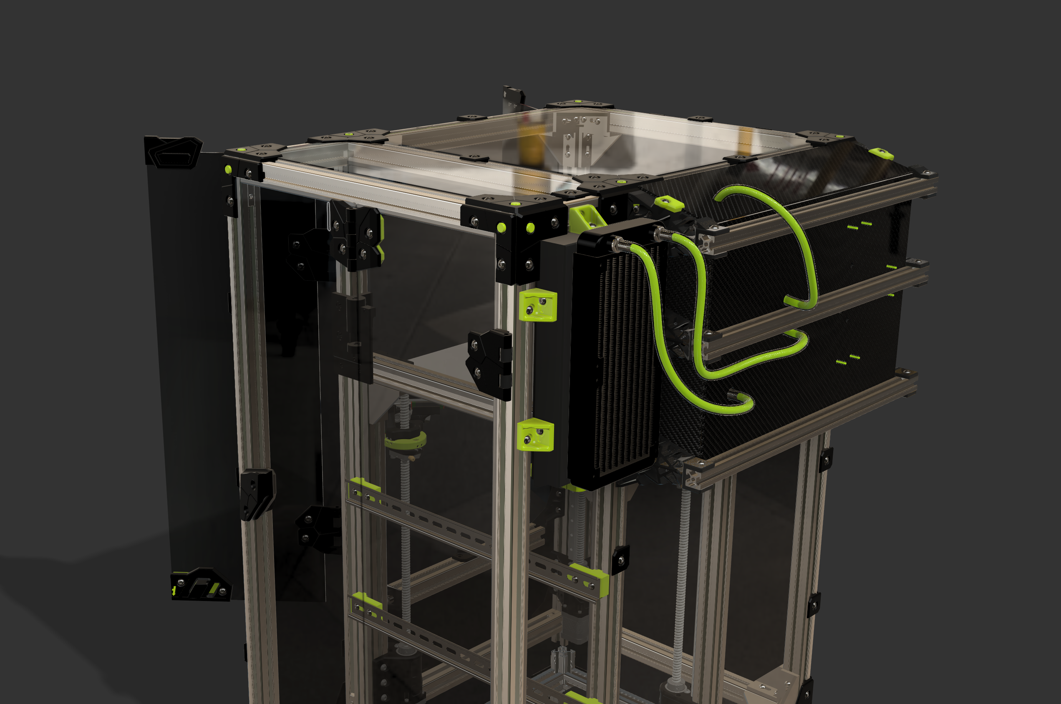
files/Components/Enclosure/WaterCooling_Bay/images/Watercoolingbay_back.png
