MirageC79/HevORT/files/Components/Enclosure/WaterCooling_Bay/images/Watercoolingbay_front.png

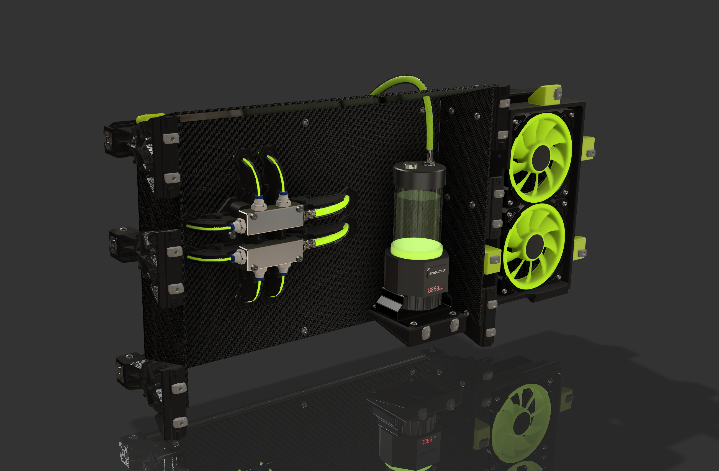
files/Components/Enclosure/WaterCooling_Bay/images/Watercoolingbay_front.png
