MirageC79/HevORT/files/Components/XYHT/images/XYHT_V2_INSTL.jpg

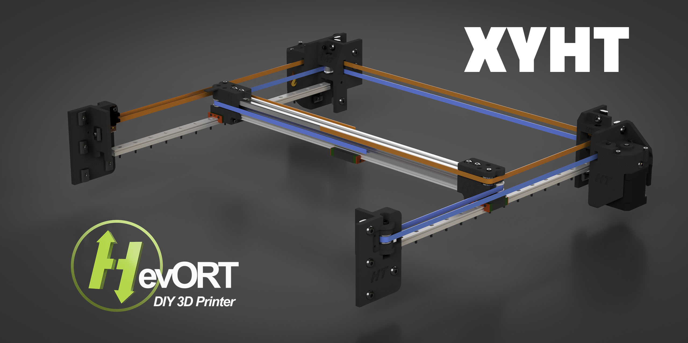
files/Components/XYHT/images/XYHT_V2_INSTL.jpg
