MirageC79/HevORT/files/Components/XYSTD/images/XYSTD_YCarriage_LH_V2.5_Split.jpg

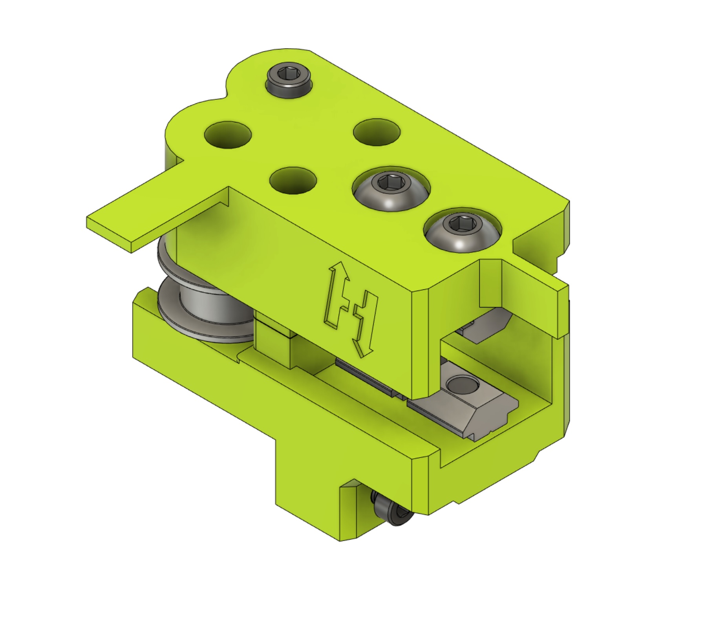
files/Components/XYSTD/images/XYSTD_YCarriage_LH_V2.5_Split.jpg
