MirageC79/HevORT/files/Components/XYSTD/images/XYSTD_YCarriage_RH_V2.5_Split.jpg

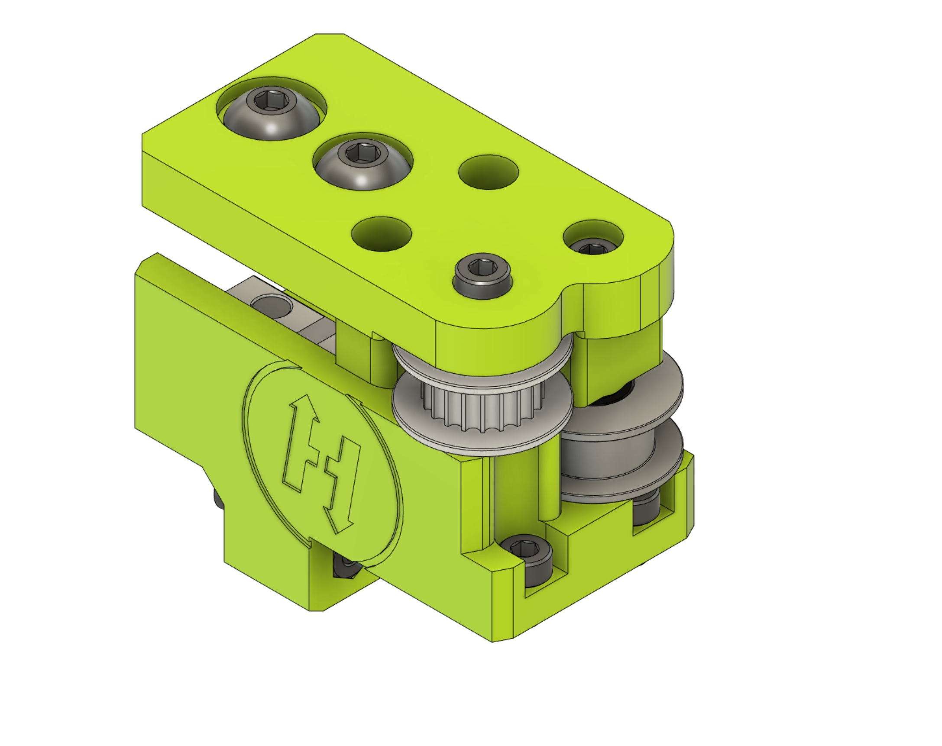
files/Components/XYSTD/images/XYSTD_YCarriage_RH_V2.5_Split.jpg
