MirageC79/HevORT/files/Components/ZR_V2.8_DO NO TUSE/images/20210112_001649.jpg

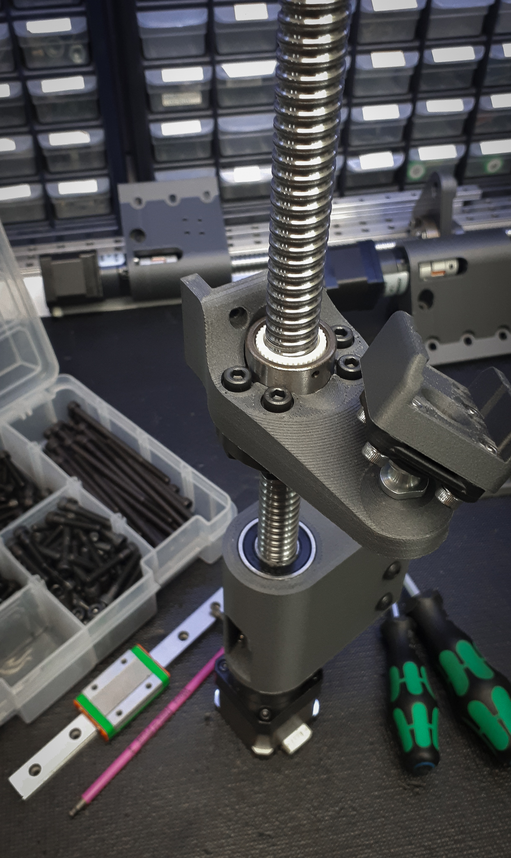
files/Components/ZR_V2.8_DO NO TUSE/images/20210112_001649.jpg
