MirageC79/HevORT/files/Components/ZR_V2.8_DO NO TUSE/images/VR_V2.8_IGUS_SliderMount_RR v2.png

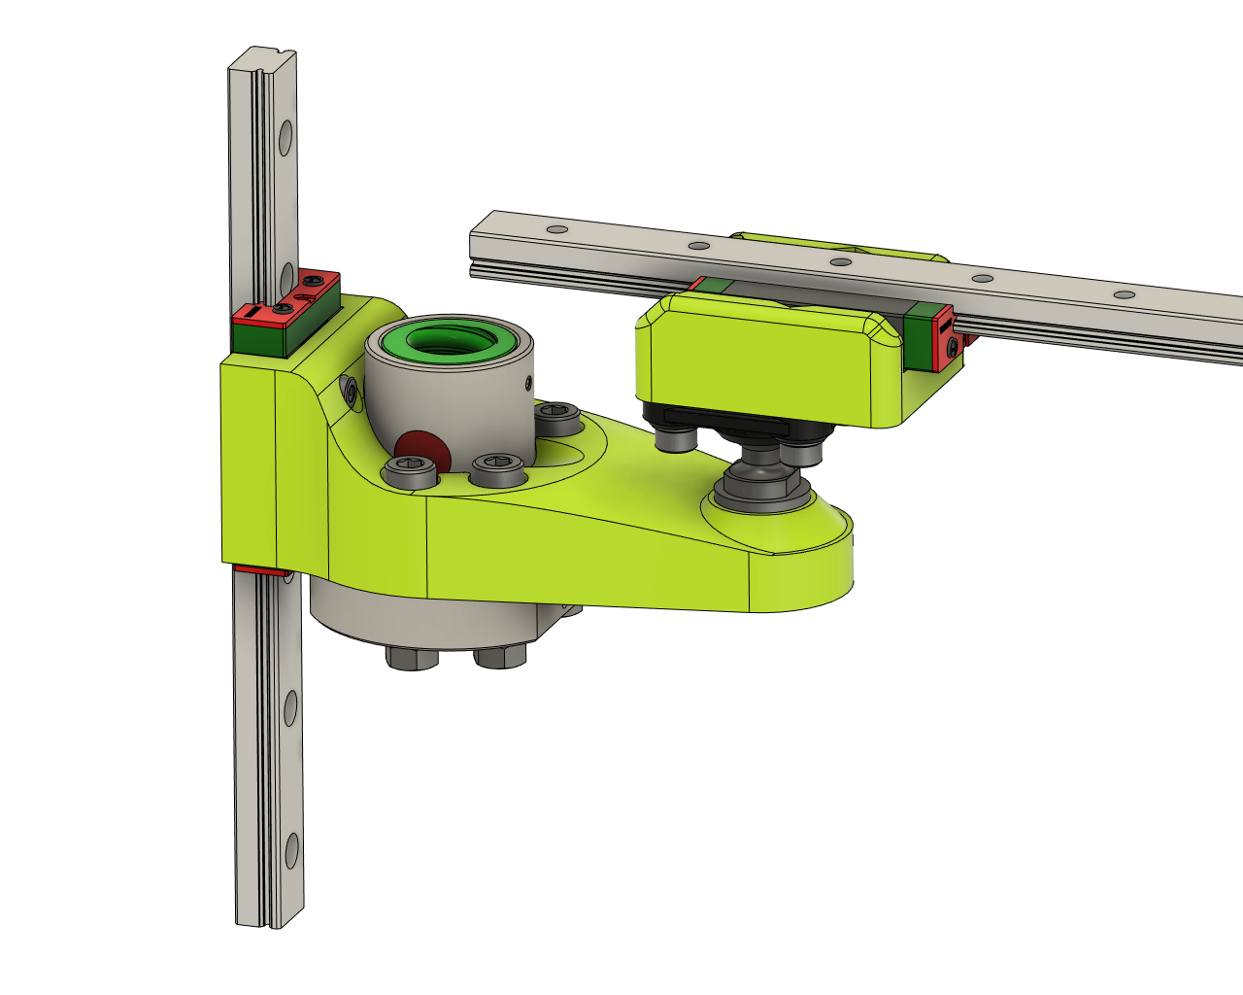
files/Components/ZR_V2.8_DO NO TUSE/images/VR_V2.8_IGUS_SliderMount_RR v2.png
