MirageC79/HevORT/files/Components/ZR_V2.8_DO NO TUSE/images/ZR_V2.8_BedARM_RailAdapter v2.png

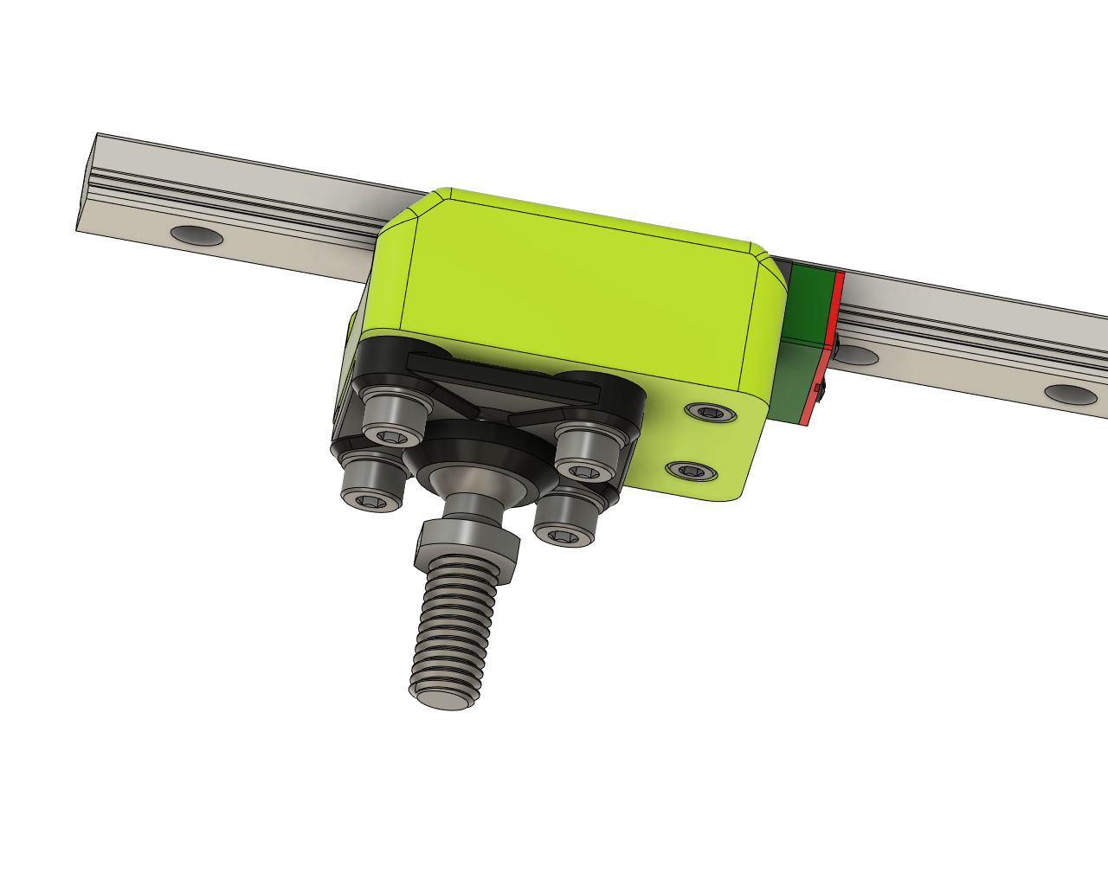
files/Components/ZR_V2.8_DO NO TUSE/images/ZR_V2.8_BedARM_RailAdapter v2.png
