MirageC79/HevORT/files/Components/ZR_V2.8_DO NO TUSE/images/ZR_V2.8_IGUS_SliderMount_FL_Assy v7.png

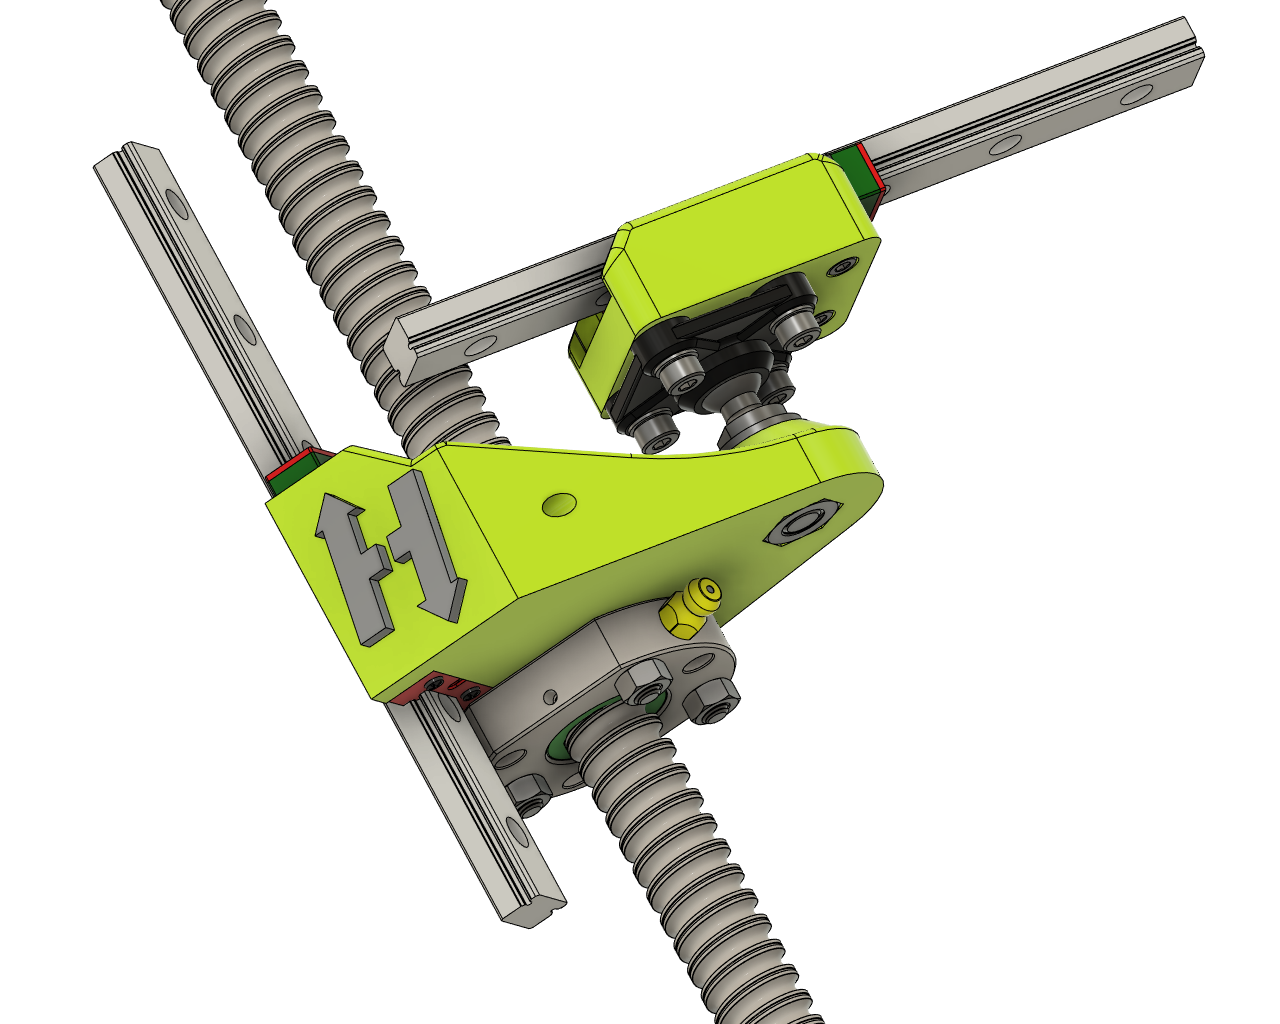
files/Components/ZR_V2.8_DO NO TUSE/images/ZR_V2.8_IGUS_SliderMount_FL_Assy v7.png
