MirageC79/HevORT/images/PrintedParts/20200908_011622.jpg

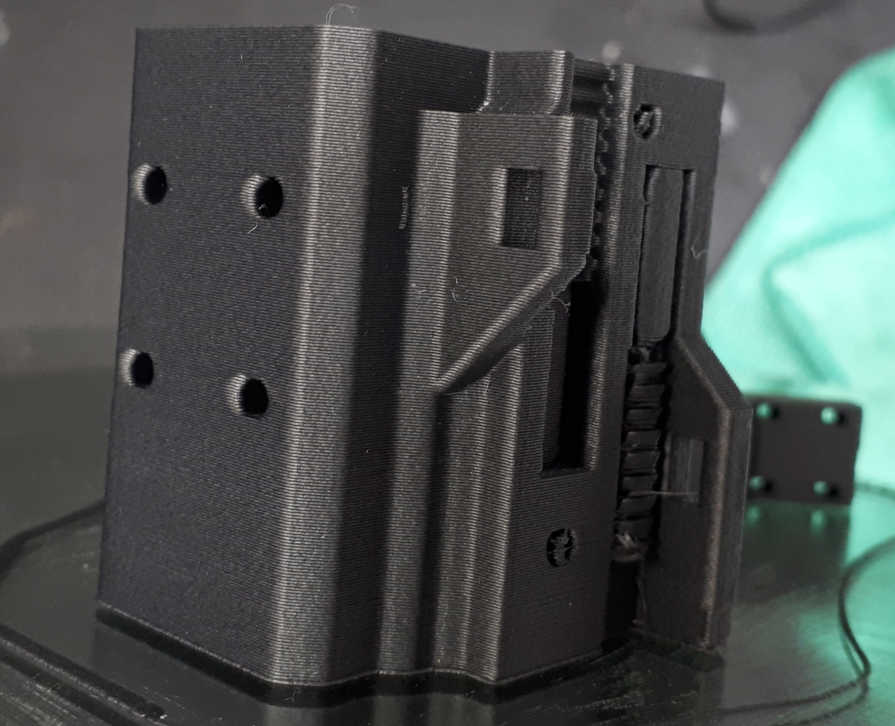
images/PrintedParts/20200908_011622.jpg
