MirageC79/HevORT/images/PrintedParts/20201022_204953.jpg

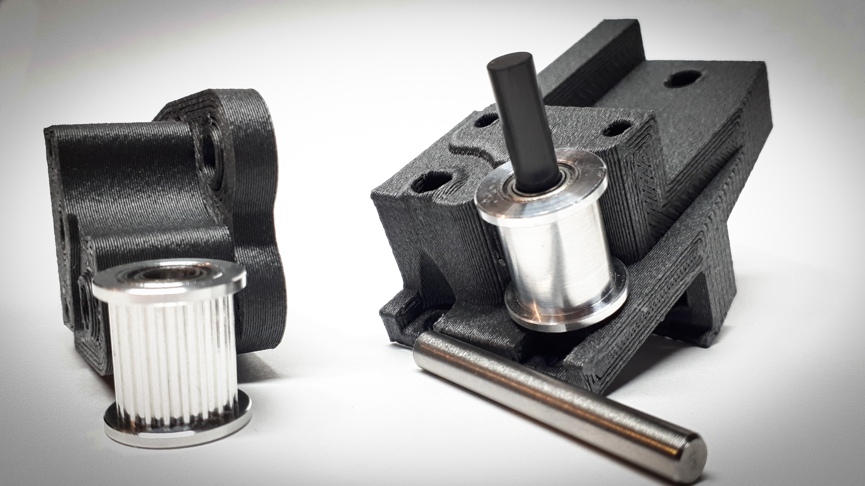
images/PrintedParts/20201022_204953.jpg
