MirageC79/HevORT/images/PrintedParts/20201022_205111.jpg

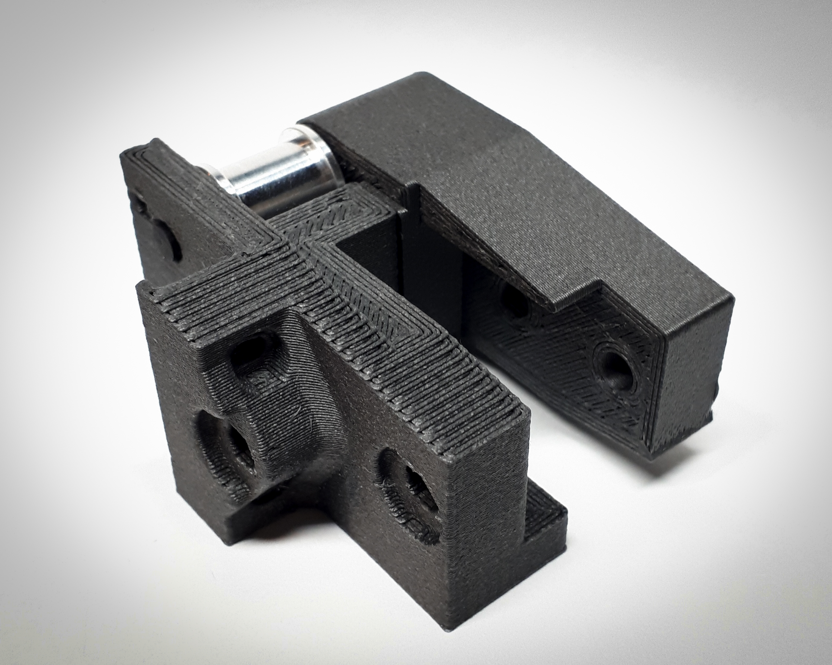
images/PrintedParts/20201022_205111.jpg
