MirageC79/HevORT/images/PrintedParts/20201022_205423.jpg

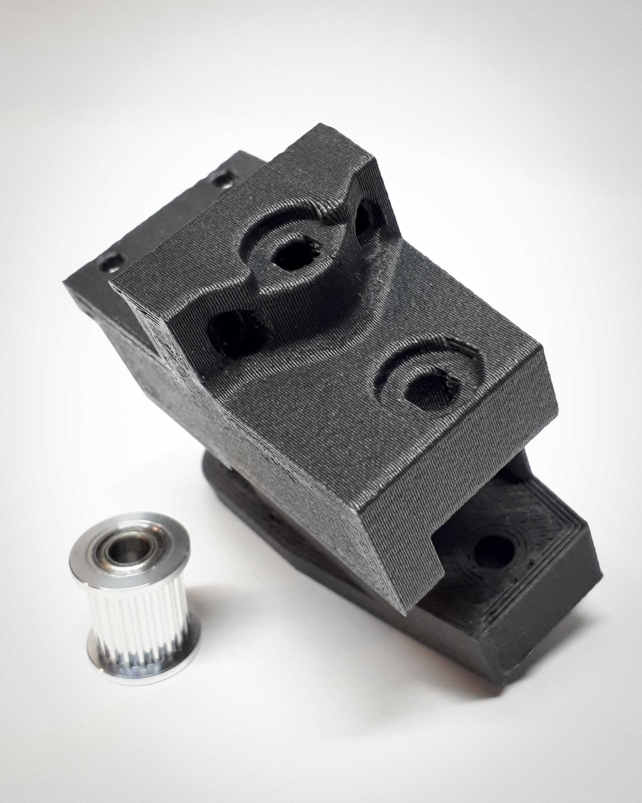
images/PrintedParts/20201022_205423.jpg
