MirageC79/HevORT/images/PrintedParts/20201022_221522.jpg

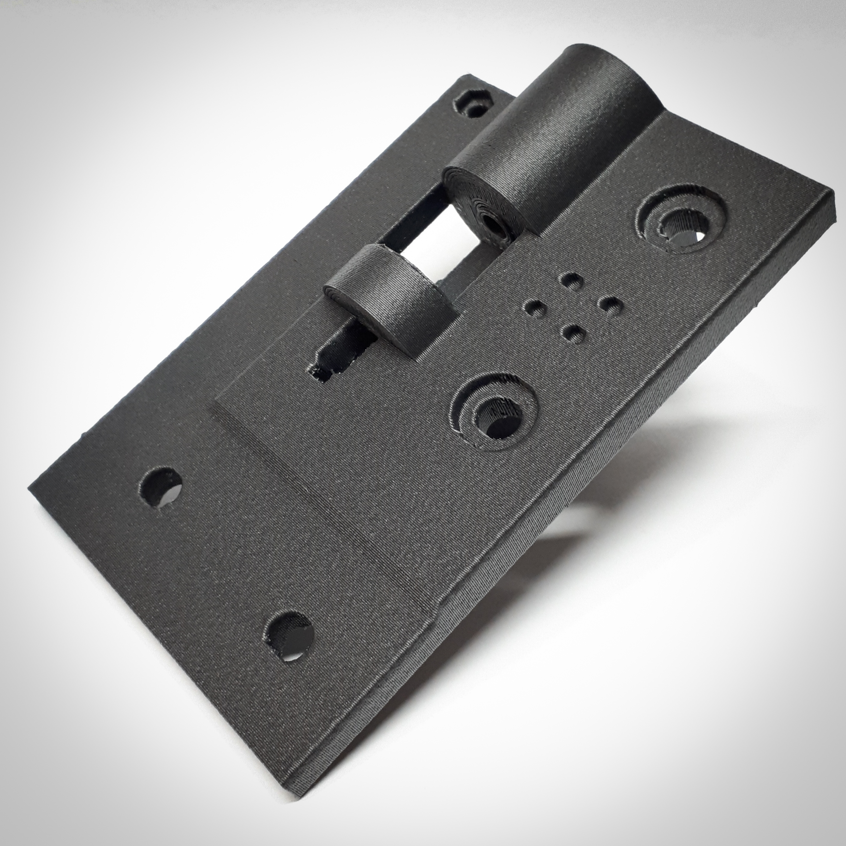
images/PrintedParts/20201022_221522.jpg
