MirageC79/HevORT/images/PrintedParts/20201022_221610.jpg

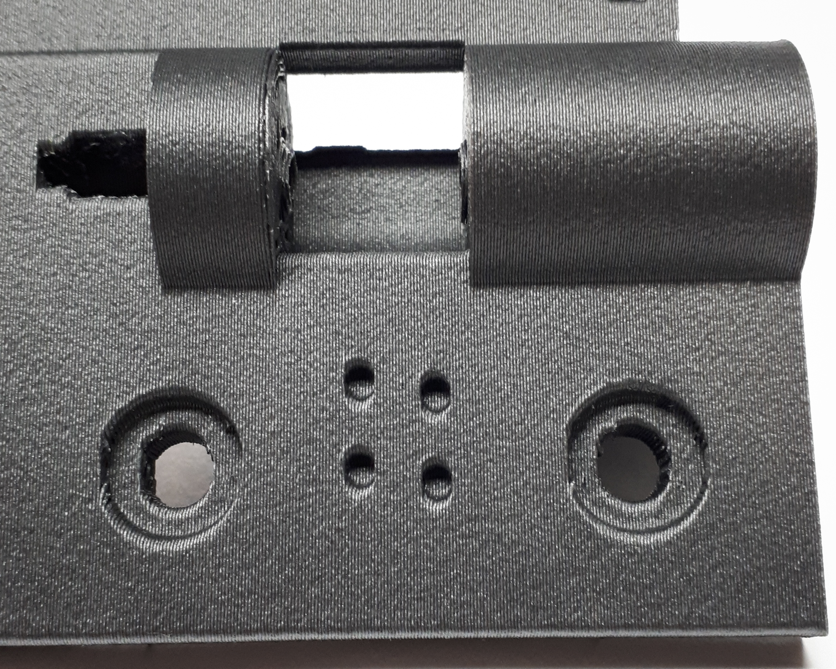
images/PrintedParts/20201022_221610.jpg
