MirageC79/HevORT/images/PrintedParts/IMG_20200513_181318 (1).JPG

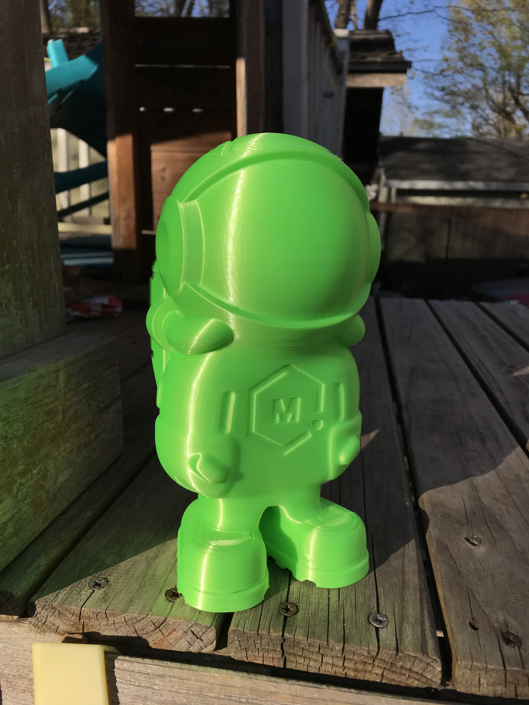
images/PrintedParts/IMG_20200513_181318 (1).JPG
