MirageC79/HevORT/files/Components/ZR_V2.6/ZR_BedPlate_InnerBraquet_FR_Assy.stl

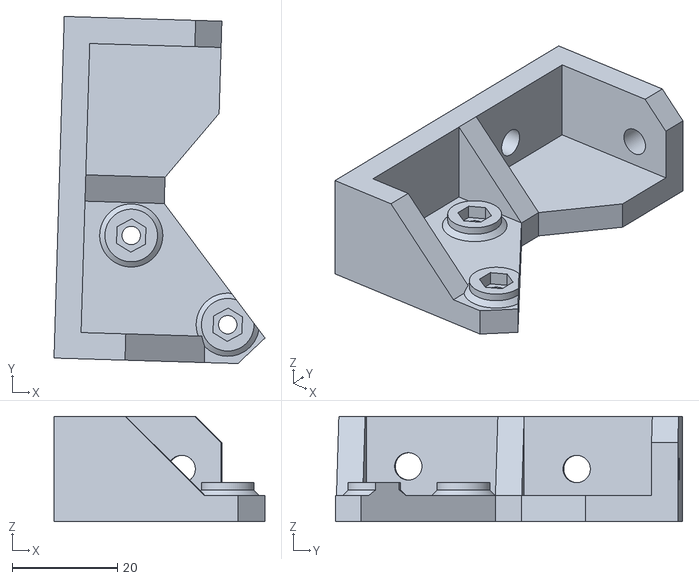
[picture p205: CAD file, 2021-01-14]
files/Components/ZR_V2.6/ZR_BedPlate_InnerBraquet_FR_Assy.stl
40.1 x 66.0 x 20.0
