MirageC79/HevORT/files/Components/Enclosure/AcidBee_Enclosure/3030PanelClip_Corner_DoorCut_Body.stl

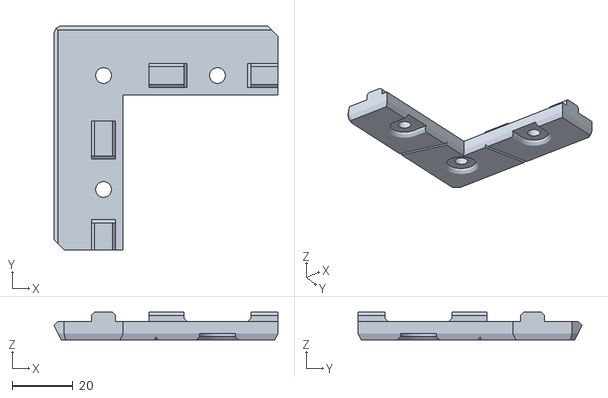
[picture p206: CAD file, 2024-02-24]
files/Components/Enclosure/AcidBee_Enclosure/3030PanelClip_Corner_DoorCut_Body.stl
74.0 x 74.0 x 9.10
