MirageC79/HevORT/files/Components/Enclosure/ElectronicBay/AcidBee_Enclosure/DoorBeam_Support_LH.stl

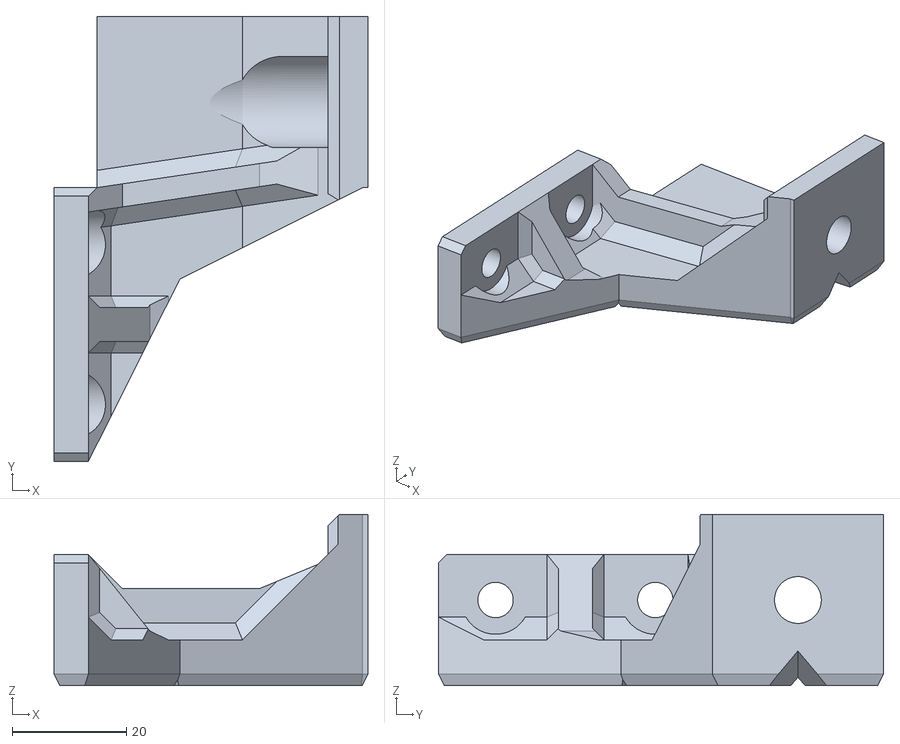
[picture p207: CAD file, 2023-07-24]
files/Components/Enclosure/ElectronicBay/AcidBee_Enclosure/DoorBeam_Support_LH.stl
55.0 x 78.0 x 30.0
