MirageC79/HevORT/files/Components/Enclosure/ElectronicBay/OctopusProCasing/DINMountLeft_V1.1HeatSinks.stl

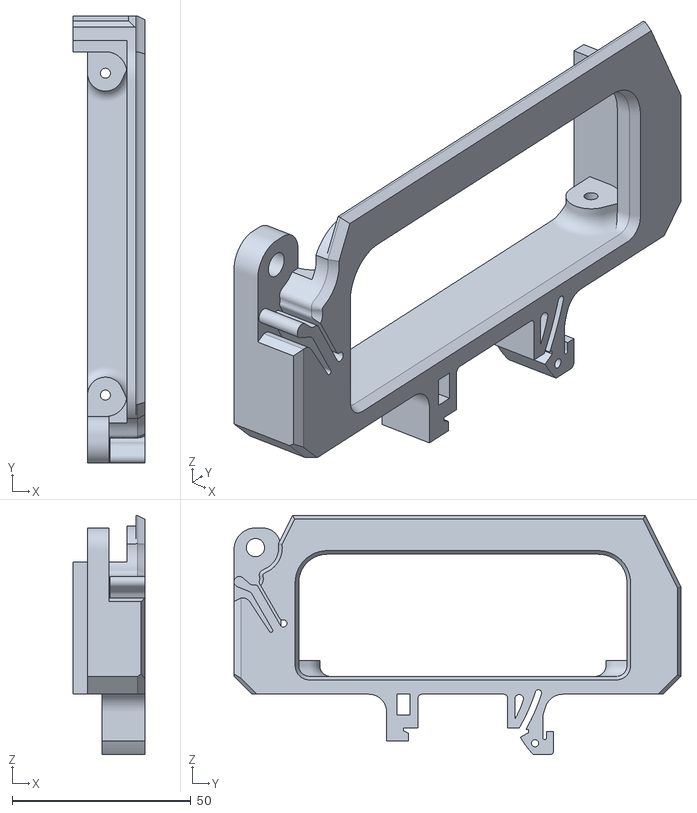
[picture p208: CAD file, 2022-03-11]
files/Components/Enclosure/ElectronicBay/OctopusProCasing/DINMountLeft_V1.1HeatSinks.stl
20.0 x 125.0 x 66.9
