MirageC79/HevORT/files/Components/Enclosure/ElectronicBay/WireDuctHolder_CrossOverA.stl

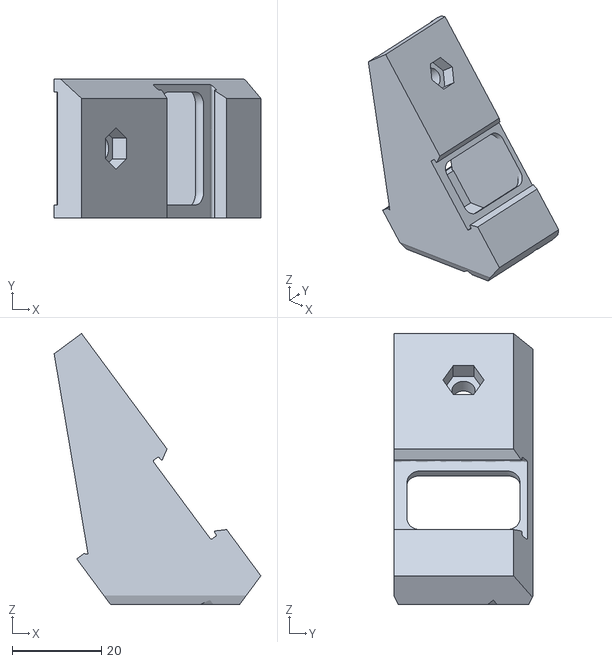
[picture p209: CAD file, 2023-01-23]
files/Components/Enclosure/ElectronicBay/WireDuctHolder_CrossOverA.stl
46.4 x 31.3 x 60.8
