MirageC79/HevORT/files/Components/Enclosure/Lighting/LED_45deg_Channel_Clip_8mmShift v1.stl

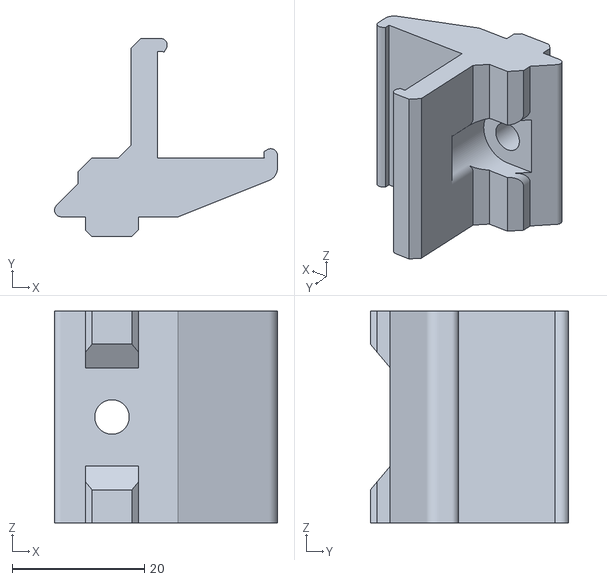
[picture p210: CAD file, 2024-01-16]
files/Components/Enclosure/Lighting/LED_45deg_Channel_Clip_8mmShift v1.stl
33.7 x 30.0 x 32.0
