MirageC79/HevORT/files/Components/Enclosure/ScreenMount/7in_LCD_Frame.stl

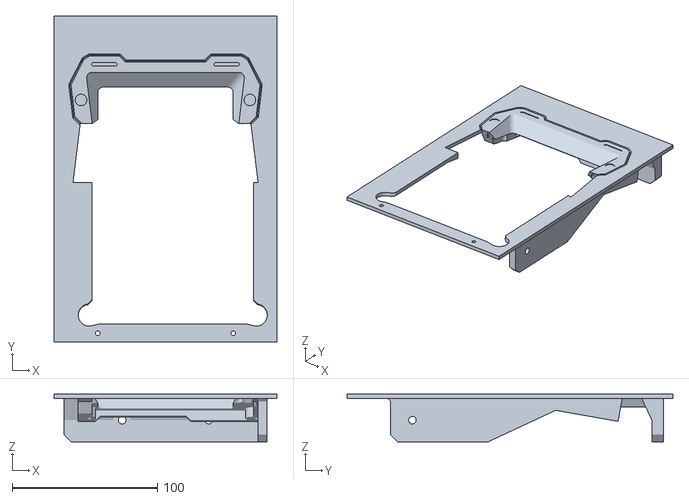
[picture p211: CAD file, 2024-01-21]
files/Components/Enclosure/ScreenMount/7in_LCD_Frame.stl
153.0 x 224.1 x 33.0
