MirageC79/HevORT/files/Components/Enclosure/SpoolHolder/FrameBracket.stl

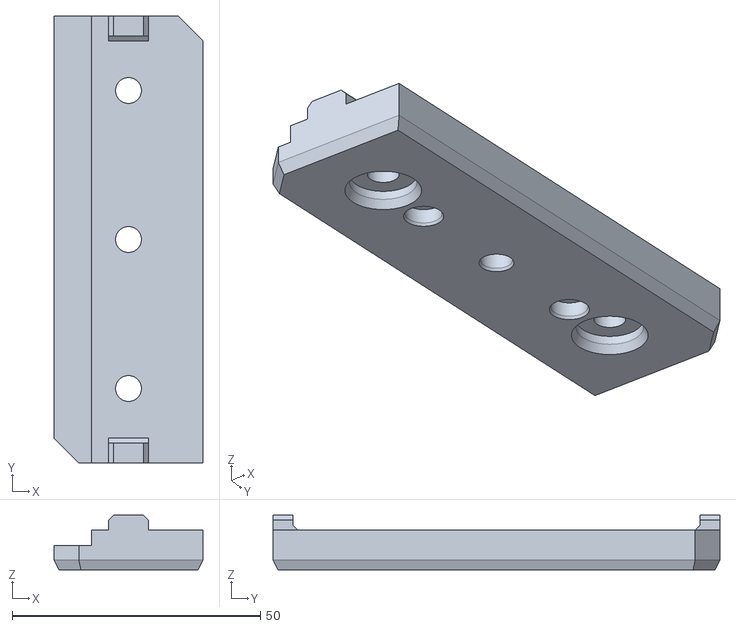
[picture p212: CAD file, 2023-09-26]
files/Components/Enclosure/SpoolHolder/FrameBracket.stl
30.0 x 90.0 x 11.0
