MirageC79/HevORT/files/Components/Enclosure/TopLid/Bracket_Lid_LH.stl

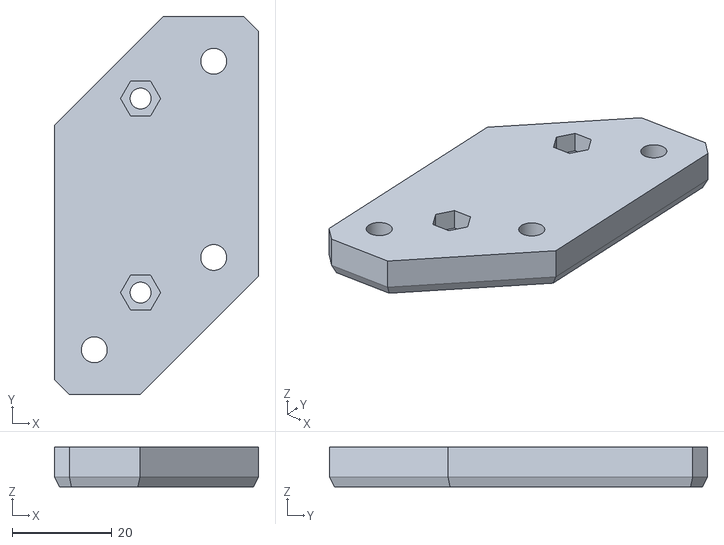
[picture p213: CAD file, 2024-02-24]
files/Components/Enclosure/TopLid/Bracket_Lid_LH.stl
41.0 x 76.0 x 8.00
