MirageC79/HevORT/files/Components/Enclosure/WaterCooling_Bay/2020_4mmTube_harness_clip.step

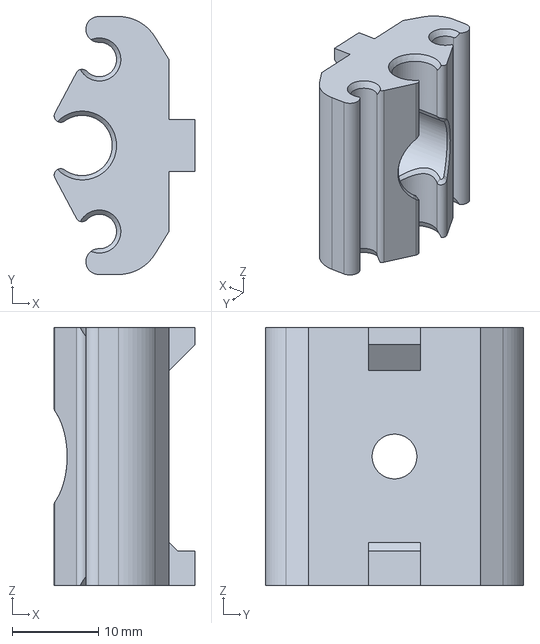
[picture p214: CAD file, 2023-11-25]
files/Components/Enclosure/WaterCooling_Bay/2020_4mmTube_harness_clip.step
16.3 x 30.0 x 30.0 mm
