MirageC79/HevORT/files/Components/HD12/HD_NEMA17_AdapterPlate_LH_BodyV2.stl

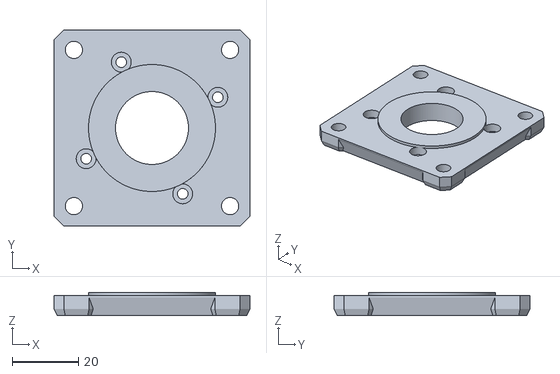
[picture p215: CAD file, 2023-07-24]
files/Components/HD12/HD_NEMA17_AdapterPlate_LH_BodyV2.stl
59.1 x 59.1 x 7.00
