MirageC79/HevORT/files/Components/HD12/OPTION HD12CFx/HD12_CFx_MGN9_YCarriage_LH_UpperBody_WithXFlag_v1.1stl.stl

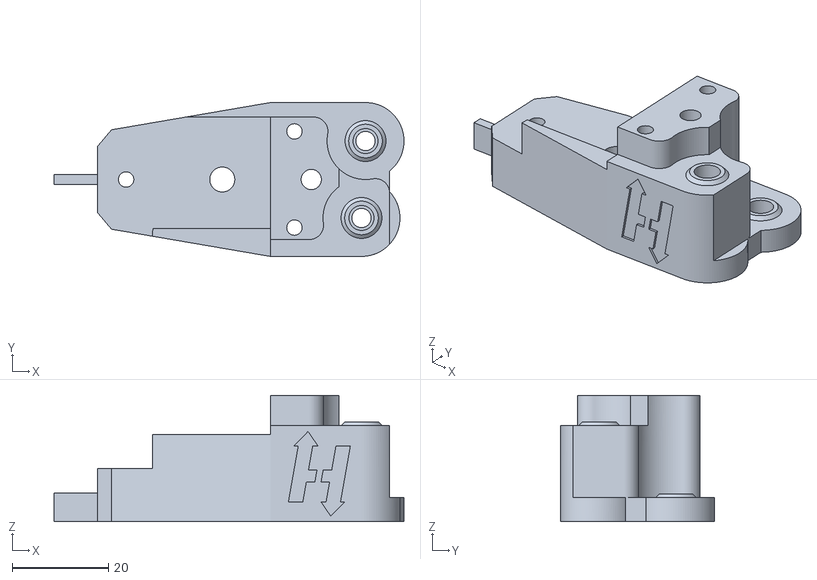
[picture p216: CAD file, 2022-02-13]
files/Components/HD12/OPTION HD12CFx/HD12_CFx_MGN9_YCarriage_LH_UpperBody_WithXFlag_v1.1stl.stl
72.8 x 32.0 x 26.2
