MirageC79/HevORT/files/Components/HD12/OPTION HD12CFx_TopRail/XYHDx_CFx_TopRail_MGN9_VZPrintHead_XFlag v2.stl

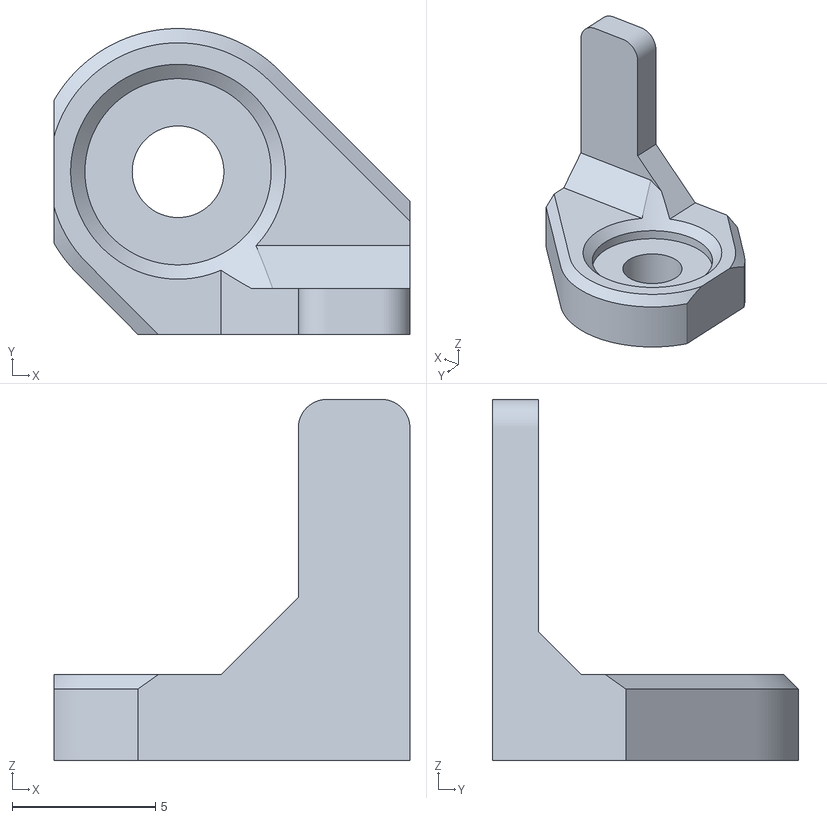
[picture p217: CAD file, 2023-11-16]
files/Components/HD12/OPTION HD12CFx_TopRail/XYHDx_CFx_TopRail_MGN9_VZPrintHead_XFlag v2.stl
12.4 x 10.7 x 12.6
