MirageC79/HevORT/files/Components/HD12_SPAWD/HD12_SPAWD_BeltTensioner_RH.stl

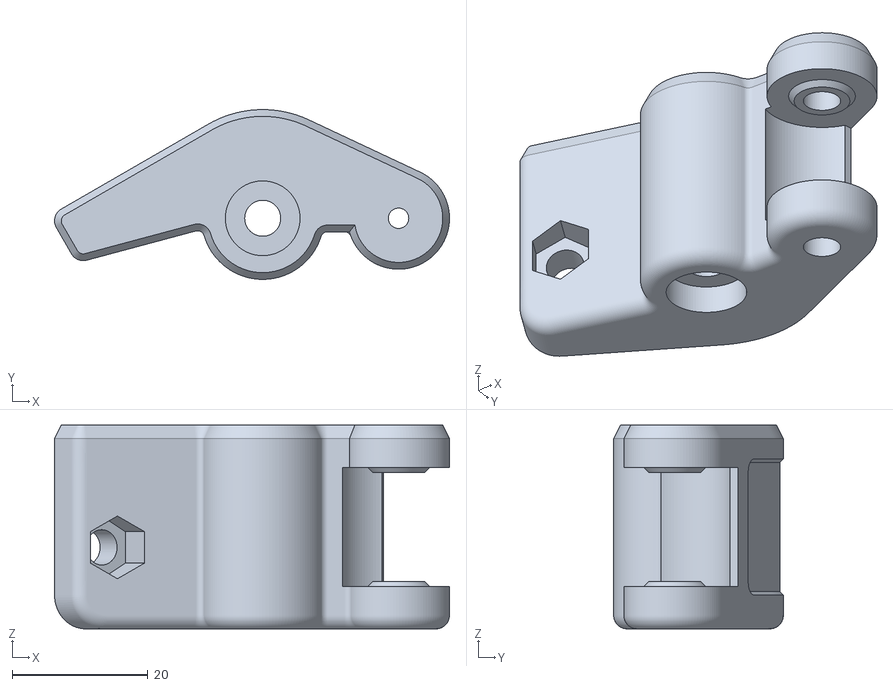
[picture p218: CAD file, 2023-10-26]
files/Components/HD12_SPAWD/HD12_SPAWD_BeltTensioner_RH.stl
58.1 x 25.0 x 30.0
