MirageC79/HevORT/files/Components/HD9/HDx_XYFlag_RHBodyV1.stl

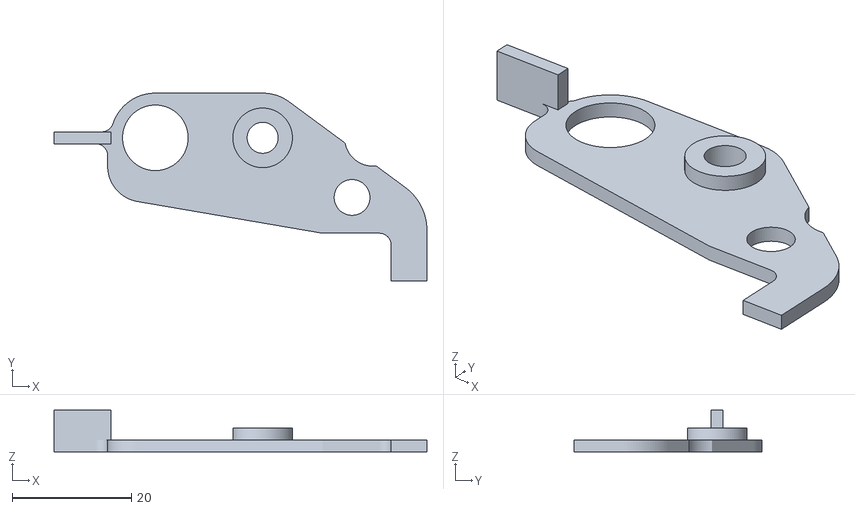
[picture p219: CAD file, 2020-11-18]
files/Components/HD9/HDx_XYFlag_RHBodyV1.stl
62.6 x 31.5 x 7.00
