MirageC79/HevORT/files/Components/HD9/Option_HD9_CFx/XYHD_CFx_YFlag_LH.stl

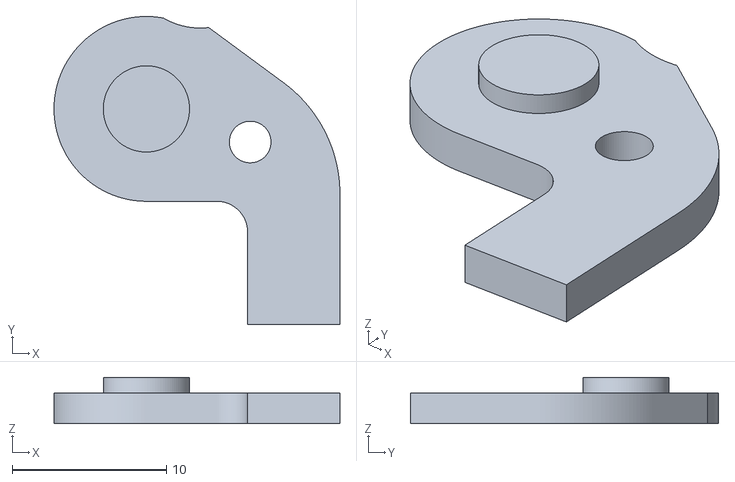
[picture p220: CAD file, 2022-03-05]
files/Components/HD9/Option_HD9_CFx/XYHD_CFx_YFlag_LH.stl
18.6 x 20.0 x 3.00
