MirageC79/HevORT/files/Components/HD9_10_SPAWD/HD10_SPAWD_BeltTensioner_FL.stl

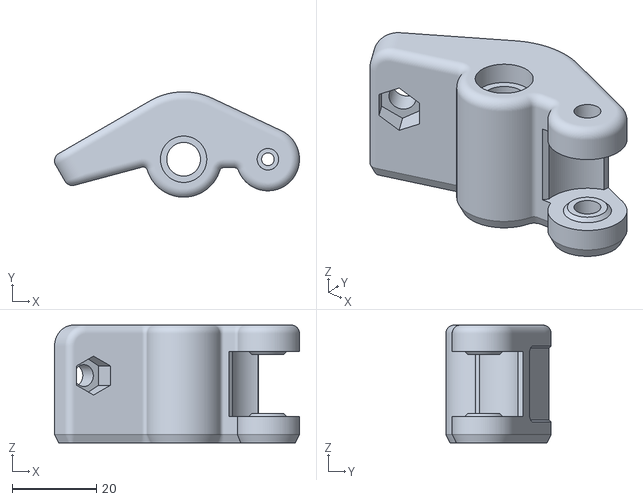
[picture p221: CAD file, 2023-10-31]
files/Components/HD9_10_SPAWD/HD10_SPAWD_BeltTensioner_FL.stl
58.1 x 25.0 x 28.0
