MirageC79/HevORT/files/Components/HevACS/315_340/HevACS_315_340_Fan_Bracket.stl

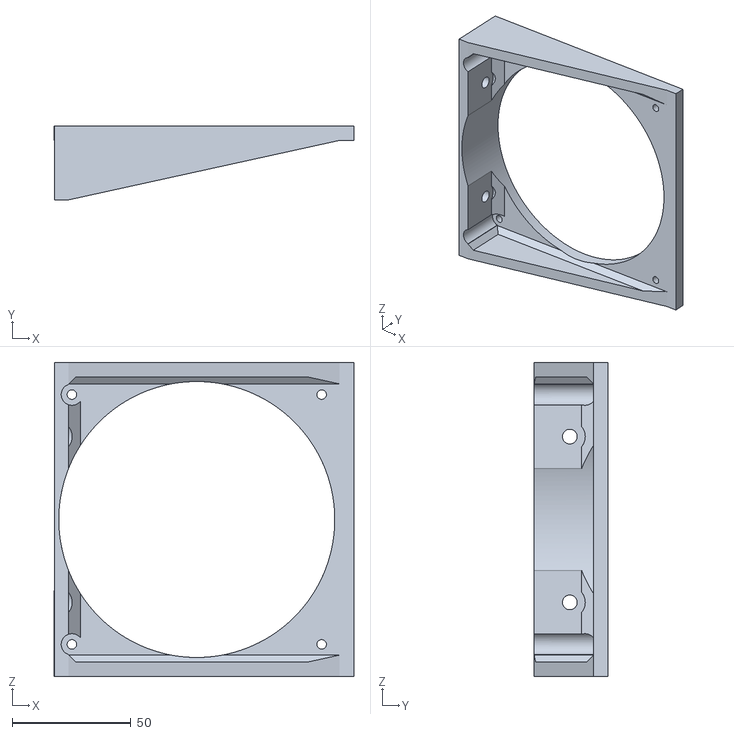
[picture p222: CAD file, 2021-07-09]
files/Components/HevACS/315_340/HevACS_315_340_Fan_Bracket.stl
125.9 x 31.0 x 132.0
