MirageC79/HevORT/files/Components/HevACS/ForOleg/HevACS_UpperDuct_LHRH_BETA.1.stl

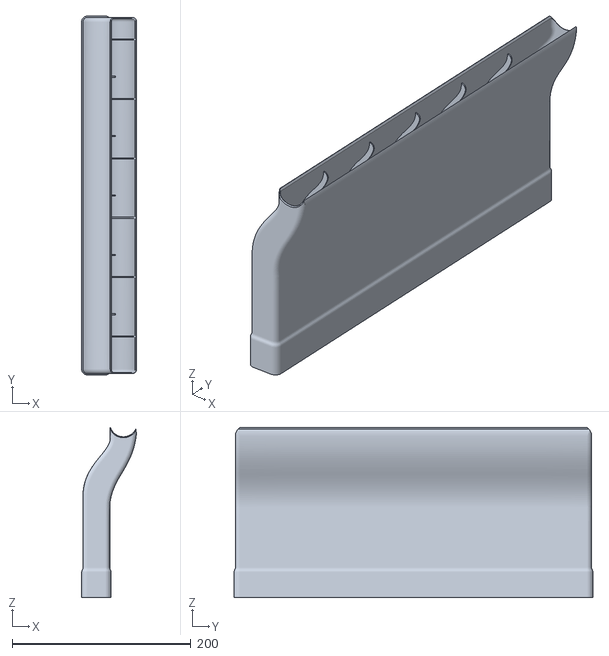
[picture p223: CAD file, 2020-12-03]
files/Components/HevACS/ForOleg/HevACS_UpperDuct_LHRH_BETA.1.stl
61.3 x 402.0 x 190.4
