MirageC79/HevORT/files/Components/HevACS/HEvACS_120mm_DoubleFan_Bracket_Inclined_BETA.stl

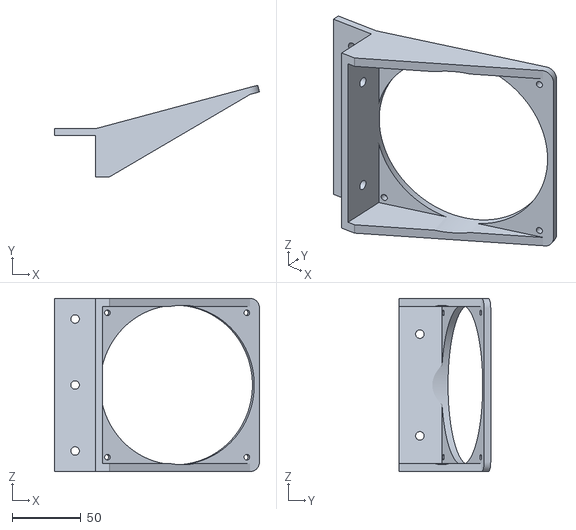
[picture p224: CAD file, 2020-11-13]
files/Components/HevACS/HEvACS_120mm_DoubleFan_Bracket_Inclined_BETA.stl
149.1 x 66.6 x 126.0
