MirageC79/HevORT/files/Components/HyperCube_Z_conversion/Z_Axis_Bearing_Holder_HevORT v1.stl

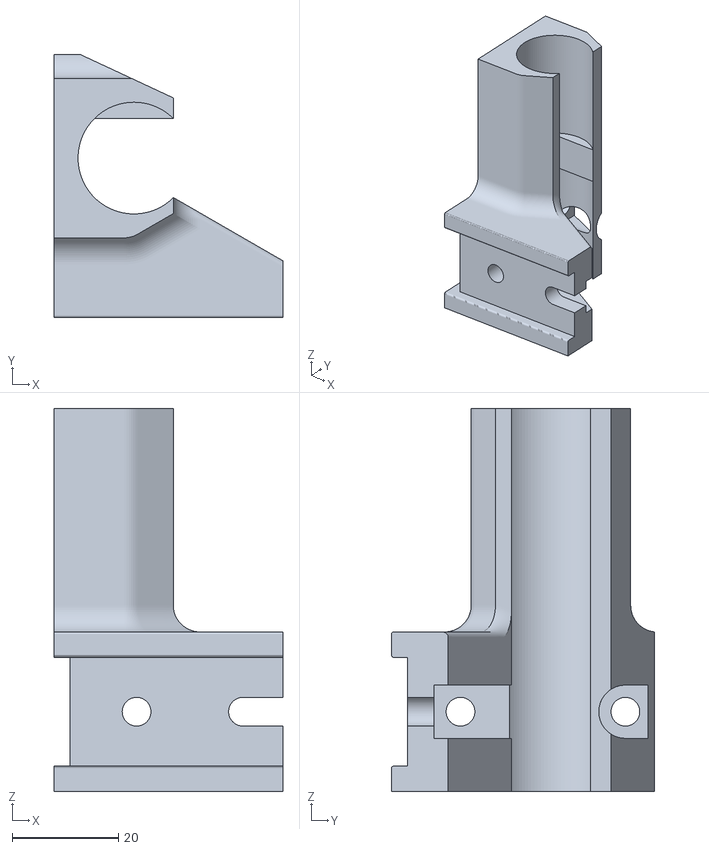
[picture p225: CAD file, 2020-10-26]
files/Components/HyperCube_Z_conversion/Z_Axis_Bearing_Holder_HevORT v1.stl
43.0 x 49.5 x 72.0
