MirageC79/HevORT/files/Components/PrintHead/LGX_MagnumPlus_HDx_Top/HD12_MGN9_LGX_MAgnum_RIGHTSplit_Body_Draft.stl

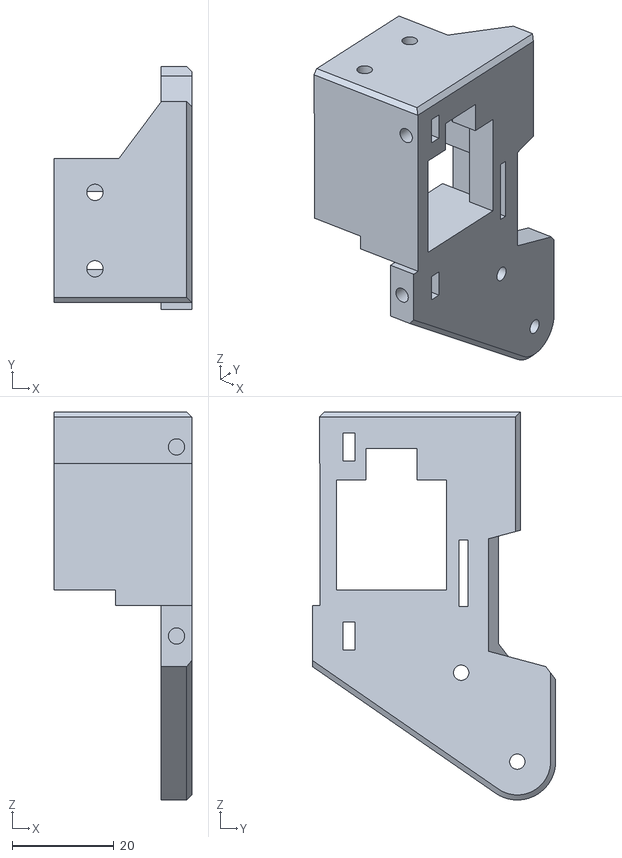
[picture p226: CAD file, 2021-11-05]
files/Components/PrintHead/LGX_MagnumPlus_HDx_Top/HD12_MGN9_LGX_MAgnum_RIGHTSplit_Body_Draft.stl
27.0 x 47.7 x 76.1
