MirageC79/HevORT/files/Components/PrintHead/VezMetalPrintHead_HDx/BearingMod_Bushing_VZHextrudORT.stl

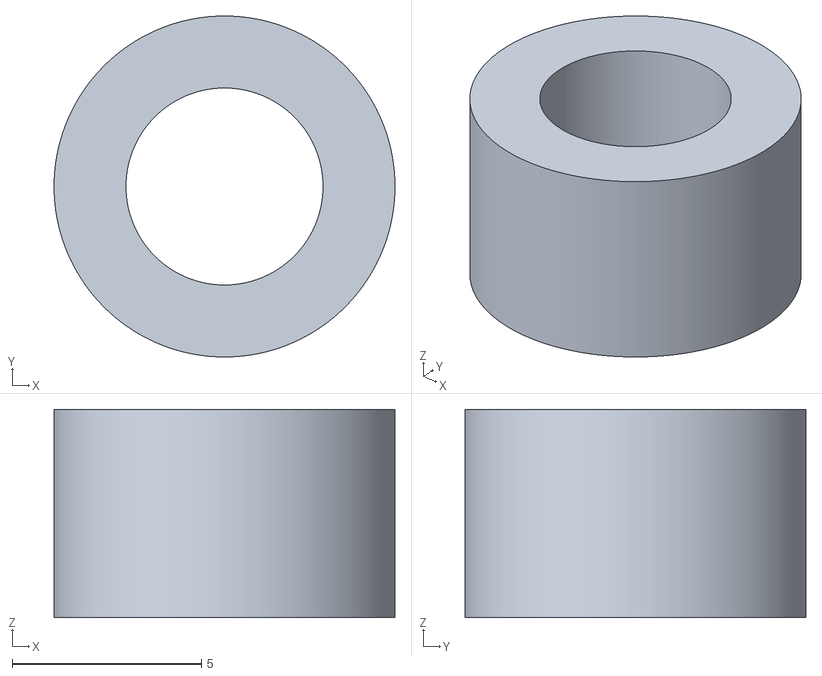
[picture p227: CAD file, 2024-03-18]
files/Components/PrintHead/VezMetalPrintHead_HDx/BearingMod_Bushing_VZHextrudORT.stl
9.00 x 9.00 x 5.50
