MirageC79/HevORT/files/Components/XYHT/OPTION_CFX/XYHT_MGN9CFX_YCarriage_RH_V2.5_LowerBody.stl

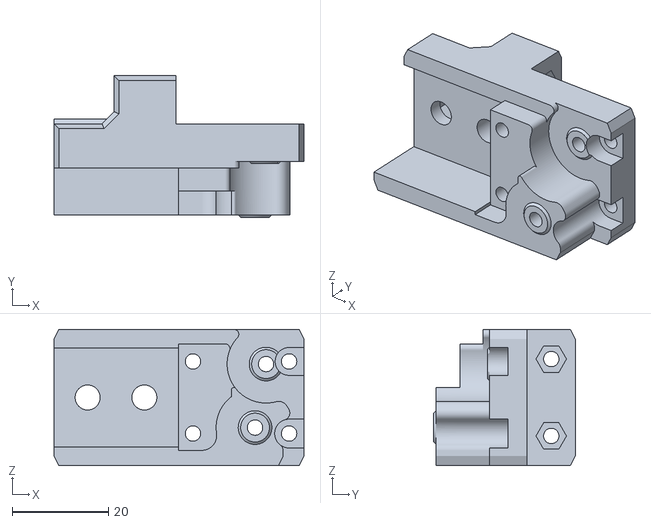
[picture p228: CAD file, 2022-11-12]
files/Components/XYHT/OPTION_CFX/XYHT_MGN9CFX_YCarriage_RH_V2.5_LowerBody.stl
52.0 x 29.5 x 28.3
