MirageC79/HevORT/files/Components/XYHT/XYHT_YCarriage_LH_V2.52_Split_Lower.stl

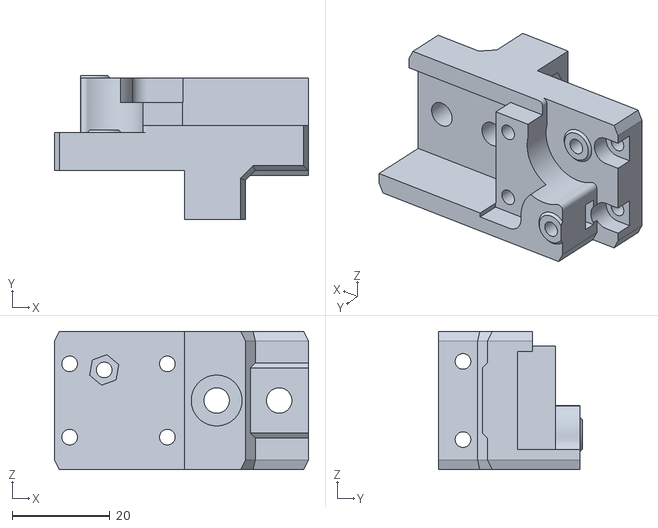
[picture p229: CAD file, 2022-01-11]
files/Components/XYHT/XYHT_YCarriage_LH_V2.52_Split_Lower.stl
52.0 x 29.5 x 28.3
