MirageC79/HevORT/files/Components/XYSTD/XYSTD_YCarriage_LH_V2.52_Split_Lower.stl

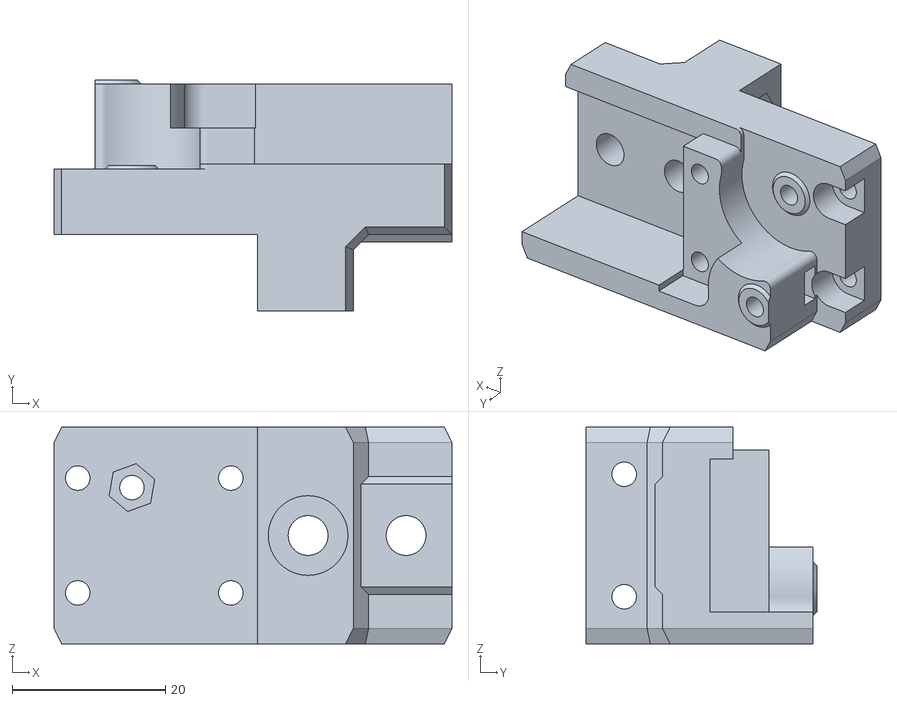
[picture p230: CAD file, 2022-01-11]
files/Components/XYSTD/XYSTD_YCarriage_LH_V2.52_Split_Lower.stl
52.0 x 30.2 x 28.3
