MirageC79/HevORT/files/Components/ZR_V2.6/ZR2.6_MotorMount_FR_Body_V1.2.stl

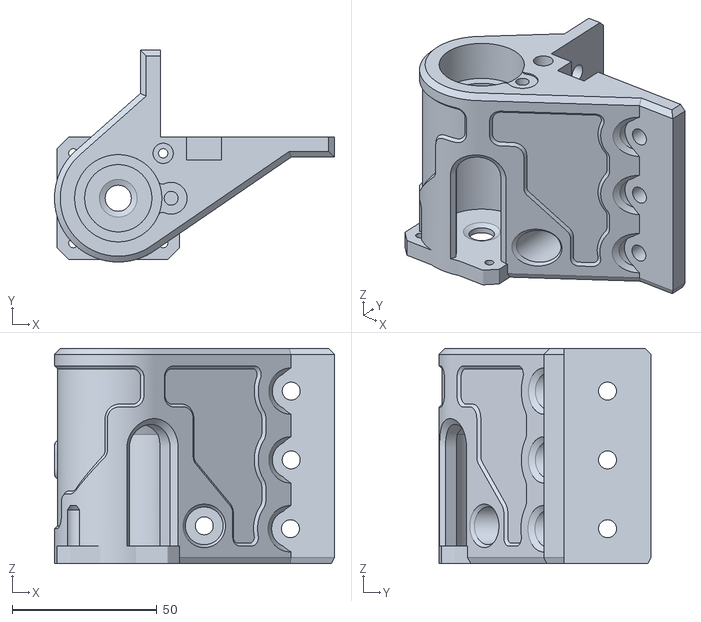
[picture p231: CAD file, 2024-02-05]
files/Components/ZR_V2.6/ZR2.6_MotorMount_FR_Body_V1.2.stl
96.6 x 73.2 x 74.2
