MirageC79/HevORT/files/Components/ZR_V2.8_DO NO TUSE/ZR2.8_WobbleX_SliderMount_RR_Body_EXPERIMENTAL.stl

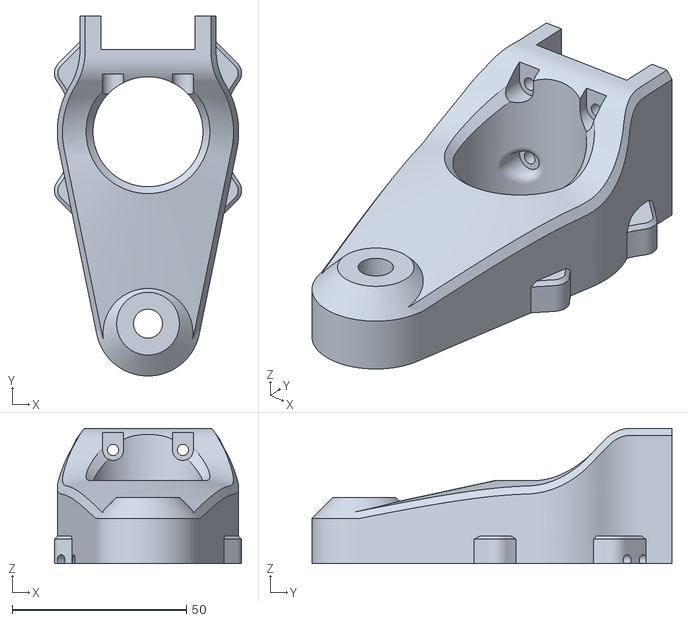
[picture p232: CAD file, 2024-01-09]
files/Components/ZR_V2.8_DO NO TUSE/ZR2.8_WobbleX_SliderMount_RR_Body_EXPERIMENTAL.stl
53.7 x 103.2 x 38.8
