MirageC79/HevORT/files/Mods/guitartoys/belt_cover/belt_cover.step

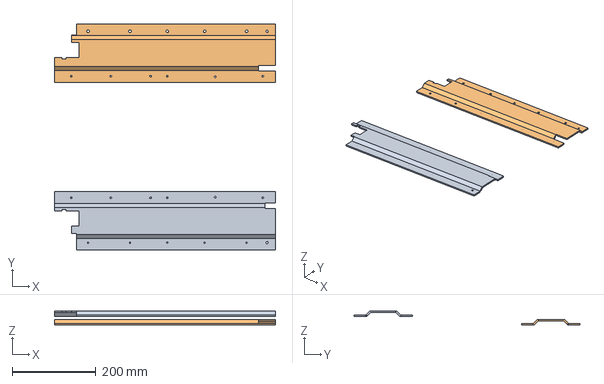
[picture p233: CAD file, 2022-09-28]
files/Mods/guitartoys/belt_cover/belt_cover.step
527.0 x 540.0 x 34.0 mm
HeVORT Belt Cover
HeVORT Belt Cover RT
