MirageC79/HevORT/files/Mods/guitartoys/berd_air_pump_mount/berd_air_pump_mount.step

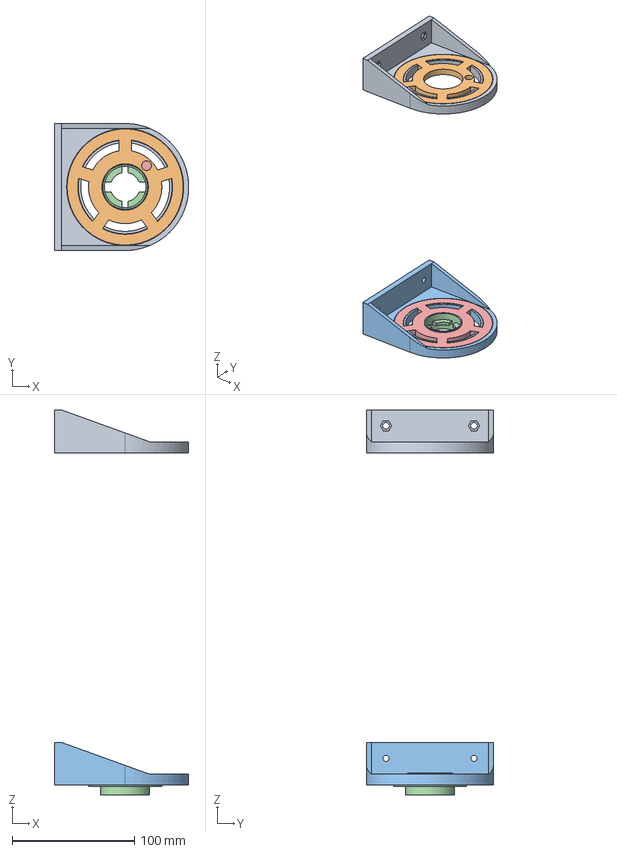
[picture p234: CAD file, 2022-09-28]
files/Mods/guitartoys/berd_air_pump_mount/berd_air_pump_mount.step
110.0 x 104.0 x 315.0 mm
Bracket_Top_Mount
Damper_Ring_Top_Mount
Bracket_Bottom_Mount
Insert_Bottom_Mount
Damper_Ring_Bottom_Mount
