MirageC79/HevORT/files/Mods/guitartoys/duet3_mounting_bracket/HeVort Duet 3 Bracket With Fans.stl

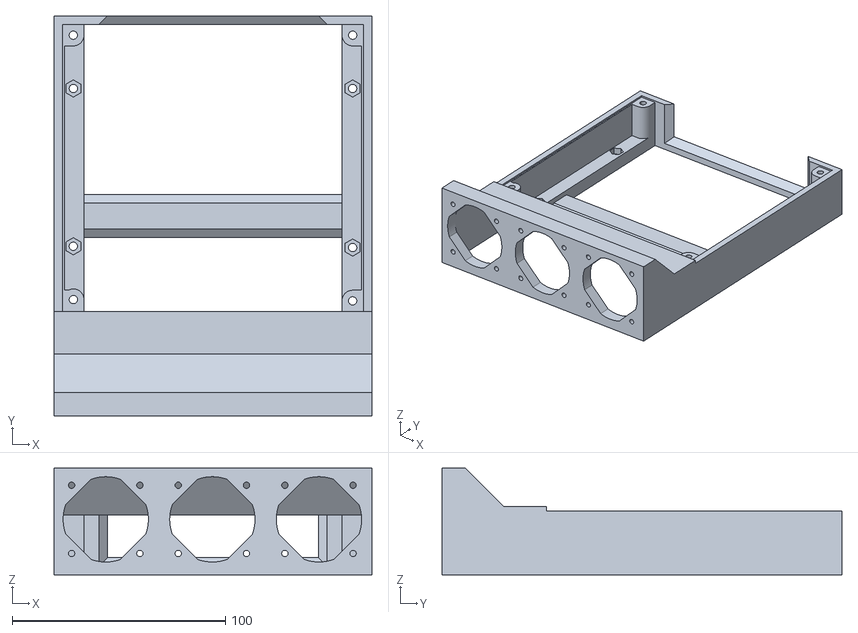
[picture p235: CAD file, 2022-09-28]
files/Mods/guitartoys/duet3_mounting_bracket/HeVort Duet 3 Bracket With Fans.stl
149.0 x 187.6 x 50.0
