MirageC79/HevORT/files/Mods/guitartoys/hemera_berd_air_nozzle/hemera_volcano_berd_air_nozzle.step

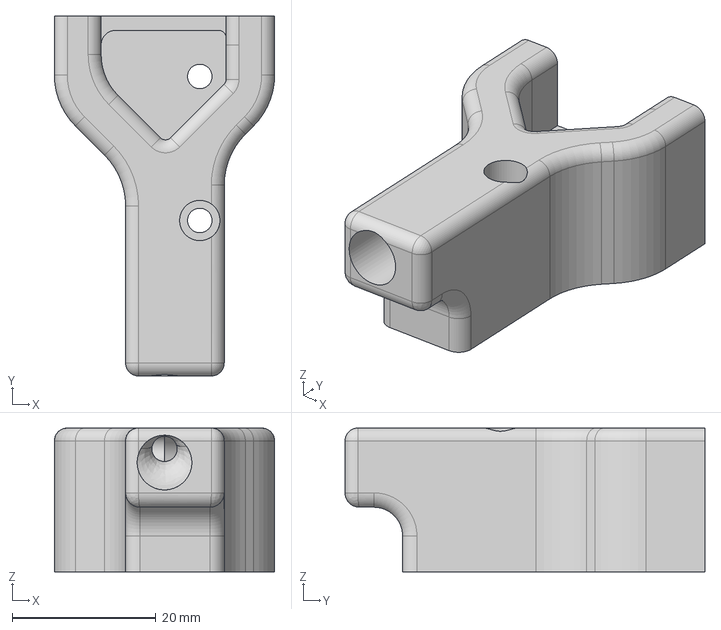
[picture p236: CAD file, 2022-09-28]
files/Mods/guitartoys/hemera_berd_air_nozzle/hemera_volcano_berd_air_nozzle.step
30.6 x 50.0 x 20.0 mm
