MirageC79/HevORT/files/Mods/guitartoys/hextrudort_dragon_berd_air/guitartoys_hextrudort_dragon_berd_air.step

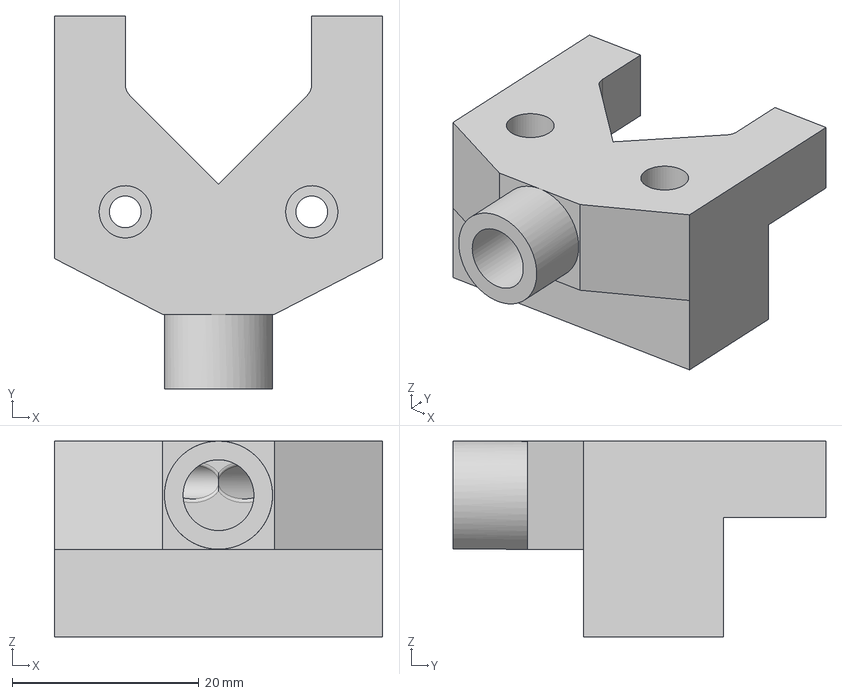
[picture p237: CAD file, 2022-09-28]
files/Mods/guitartoys/hextrudort_dragon_berd_air/guitartoys_hextrudort_dragon_berd_air.step
35.2 x 40.0 x 21.0 mm
