MirageC79/HevORT/files/Mods/guitartoys/logitech_c920_camera_door_mount/logitech_c920_camera_door_mount.step

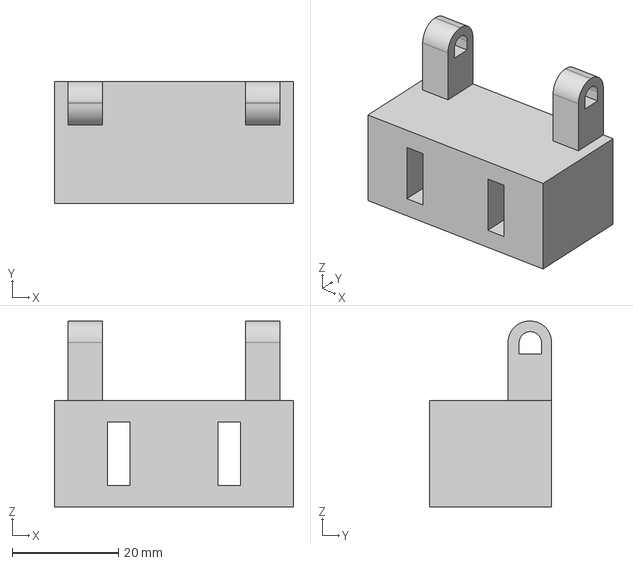
[picture p238: CAD file, 2022-09-28]
files/Mods/guitartoys/logitech_c920_camera_door_mount/logitech_c920_camera_door_mount.step
45.0 x 23.0 x 35.0 mm
