MirageC79/HevORT/files/Mods/rockzo/rockzo_xyht_1515_extrusion_mod/rockzo_xyht_1515_extrusion_mod.step

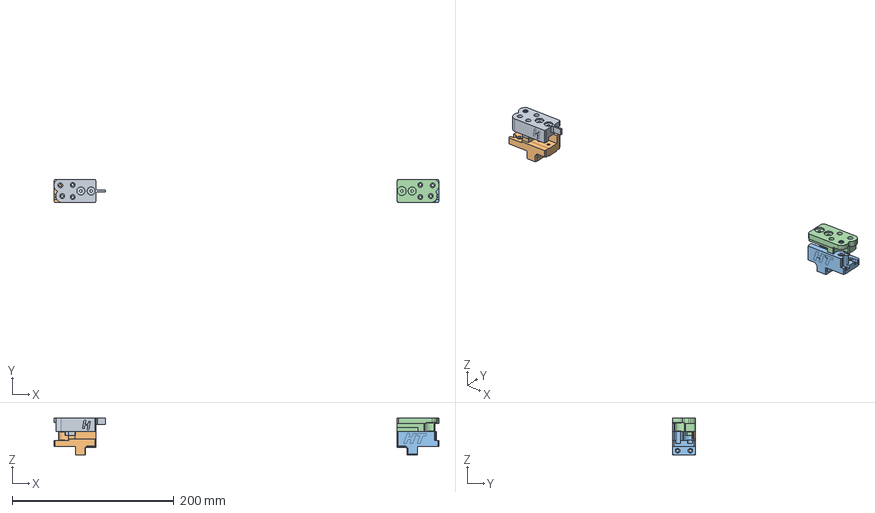
[picture p239: CAD file, 2022-09-28]
files/Mods/rockzo/rockzo_xyht_1515_extrusion_mod/rockzo_xyht_1515_extrusion_mod.step
476.2 x 28.3 x 45.1 mm
XYHT_YCarriage_LH_V2.5_Split_Upper
XYHT_YCarriage_LH_V2.52_Split_Lower
XYHT_YCarriage_RH_V2.5_LowerBody
XYHT_YCarriage_RH_V2.5_UpperBody
