MirageC79/HevORT/files/Mods/vvega/wobble_ring_mellow_metal_center/rear_top_wobble_ring_mellow_metal_center.stl

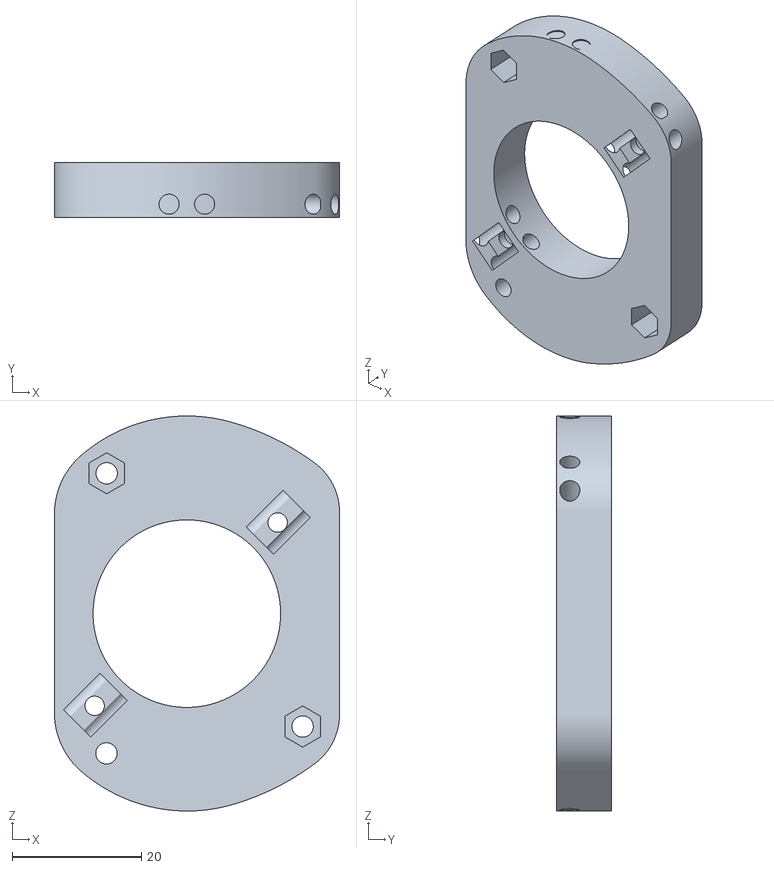
[picture p240: CAD file, 2022-09-28]
files/Mods/vvega/wobble_ring_mellow_metal_center/rear_top_wobble_ring_mellow_metal_center.stl
44.1 x 8.50 x 61.1
