MirageC79/HevORT/files/STL/HD9/Option_HD9_CFx/XYHD9_HD_YCarriage_RH_UpperBody Beta1.step

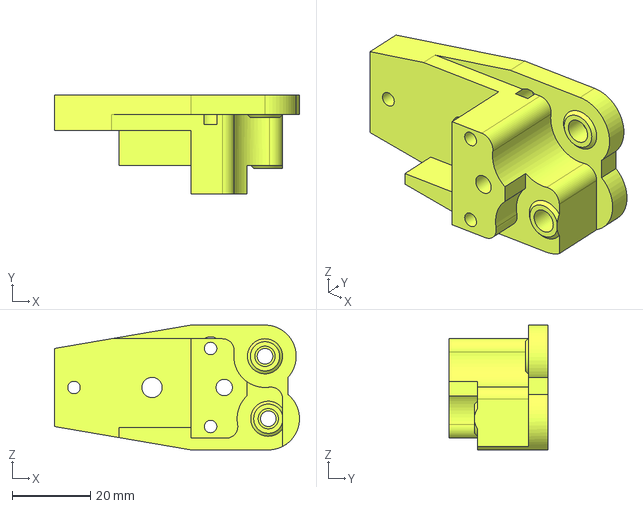
[picture p241: CAD file, 2022-03-03]
files/STL/HD9/Option_HD9_CFx/XYHD9_HD_YCarriage_RH_UpperBody Beta1.step
62.8 x 25.2 x 32.0 mm
