MirageC79/HevORT/files/STL/XYHT/XYHT_YCarriage_LH_V2_Body.stl

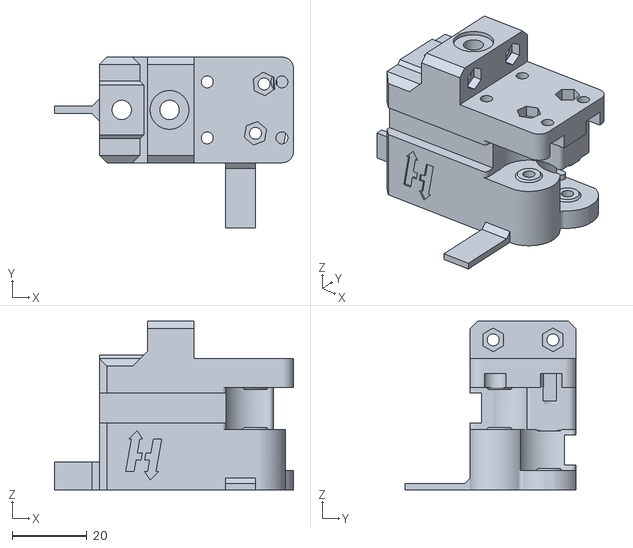
[picture p242: CAD file, 2022-01-07]
files/STL/XYHT/XYHT_YCarriage_LH_V2_Body.stl
64.0 x 45.8 x 45.2
