MirageC79/HevORT/images/HevORT_Logo.dxf

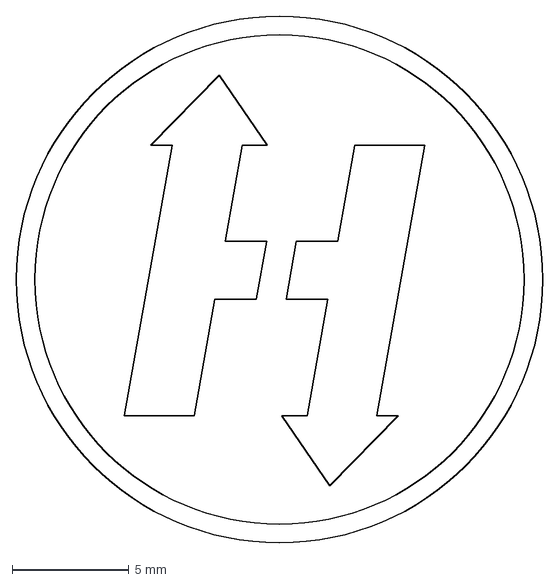
[picture p243: CAD file, 2023-08-18]
images/HevORT_Logo.dxf
22.6 x 22.6 mm
