MirageC79/HevORT/files/Components/Enclosure/AcidBee_Enclosure/3030PanelClip_Intersection_DoorCut_Body.stl

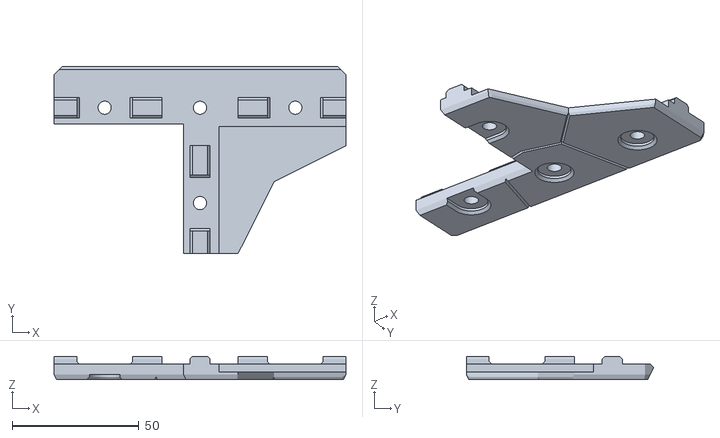
[picture p244: CAD file, 2024-02-24]
files/Components/Enclosure/AcidBee_Enclosure/3030PanelClip_Intersection_DoorCut_Body.stl
115.3 x 74.0 x 9.10
