MirageC79/HevORT/files/Components/Enclosure/ElectronicBay/WireDuctHolder_End.stl

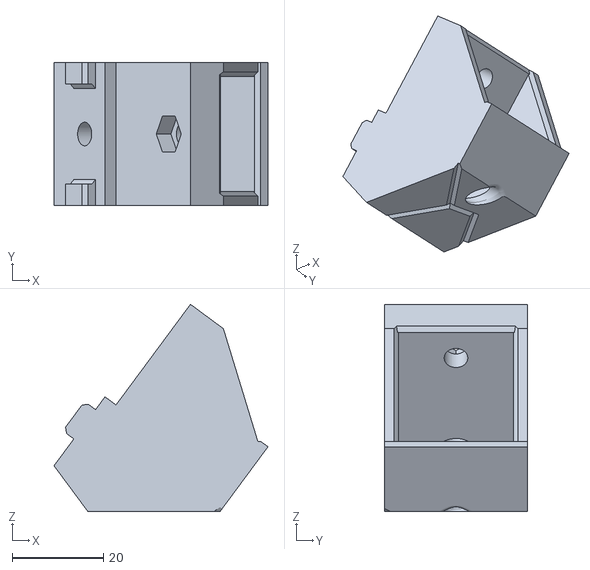
[picture p245: CAD file, 2023-01-23]
files/Components/Enclosure/ElectronicBay/WireDuctHolder_End.stl
47.0 x 31.3 x 45.5
