MirageC79/HevORT/files/Components/Enclosure/Lighting/LED_45deg_Channel_Clip v6.stl

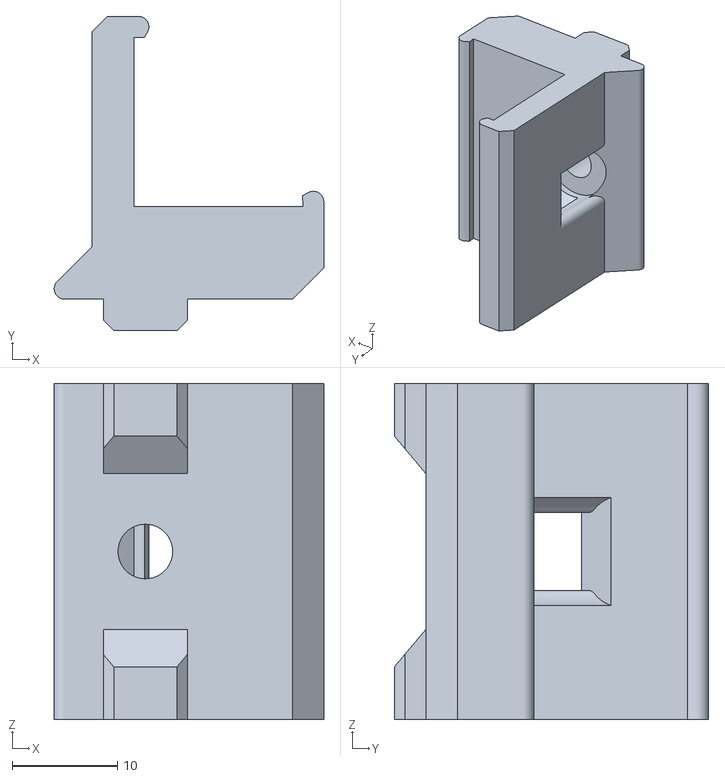
[picture p246: CAD file, 2024-01-16]
files/Components/Enclosure/Lighting/LED_45deg_Channel_Clip v6.stl
25.7 x 30.0 x 32.0
