MirageC79/HevORT/files/Components/Enclosure/ScreenMount/7in_LCD_Bezel.stl

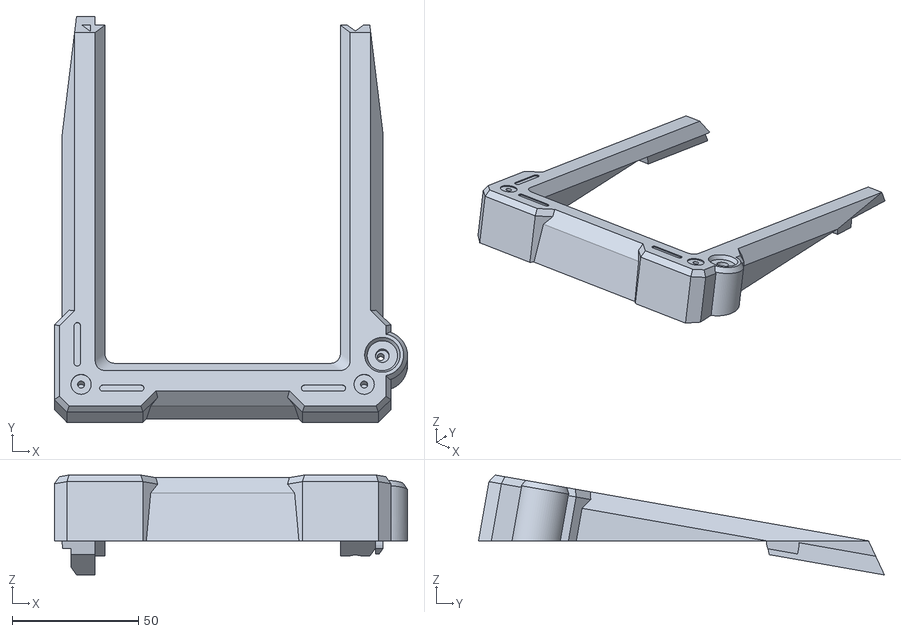
[picture p247: CAD file, 2024-01-21]
files/Components/Enclosure/ScreenMount/7in_LCD_Bezel.stl
139.7 x 160.5 x 39.5
