MirageC79/HevORT/files/Components/Enclosure/SpoolHolder/SpoolRollBody.stl

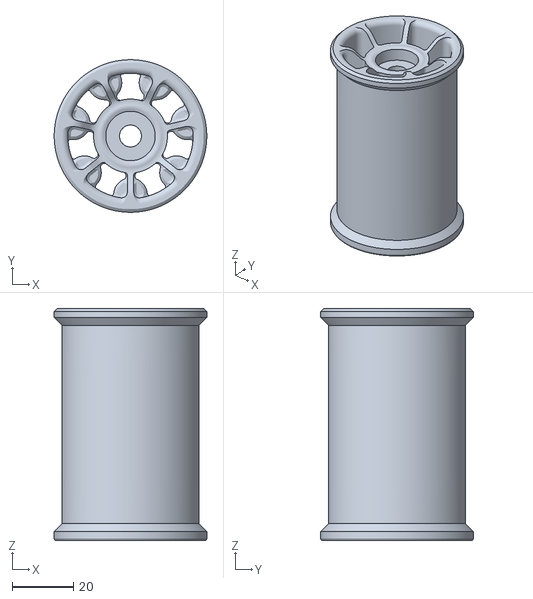
[picture p248: CAD file, 2023-09-26]
files/Components/Enclosure/SpoolHolder/SpoolRollBody.stl
50.0 x 50.0 x 76.0
