MirageC79/HevORT/files/Components/Enclosure/TopLid/Bracket_Side.stl

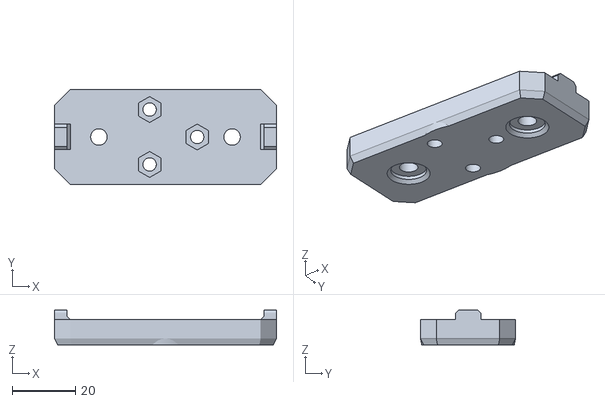
[picture p249: CAD file, 2024-02-24]
files/Components/Enclosure/TopLid/Bracket_Side.stl
70.0 x 30.0 x 11.0
