MirageC79/HevORT/files/Components/Enclosure/WaterCooling_Bay/3030_4mmTube_harness_clip.step

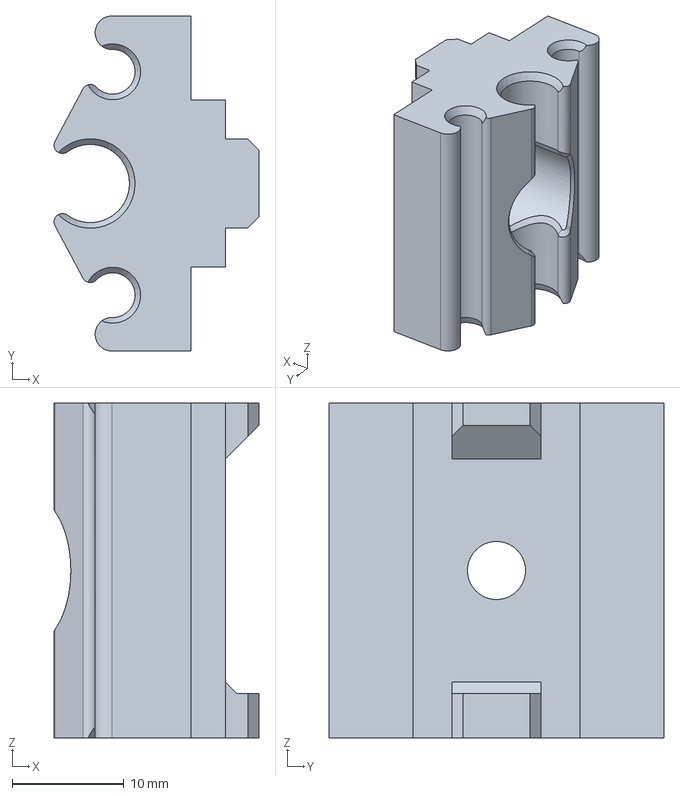
[picture p250: CAD file, 2023-11-21]
files/Components/Enclosure/WaterCooling_Bay/3030_4mmTube_harness_clip.step
18.4 x 30.0 x 30.0 mm
