MirageC79/HevORT/files/Components/HD12/OPTION HD12CFx_TopRail/cable holder Vz.stl

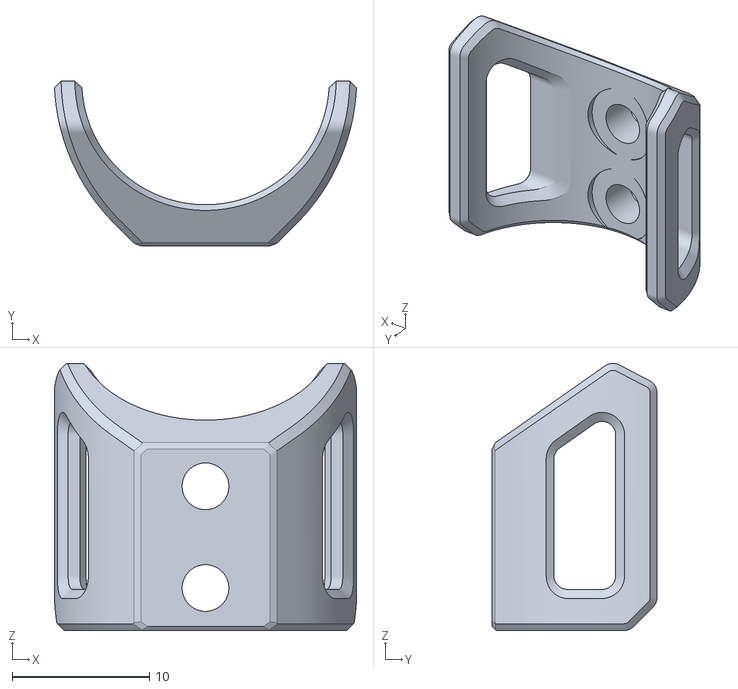
[picture p251: CAD file, 2023-10-31]
files/Components/HD12/OPTION HD12CFx_TopRail/cable holder Vz.stl
22.0 x 12.0 x 19.4
