MirageC79/HevORT/files/Components/HD9/HD9_YCarriage_RH_UpperBodyV2.stl

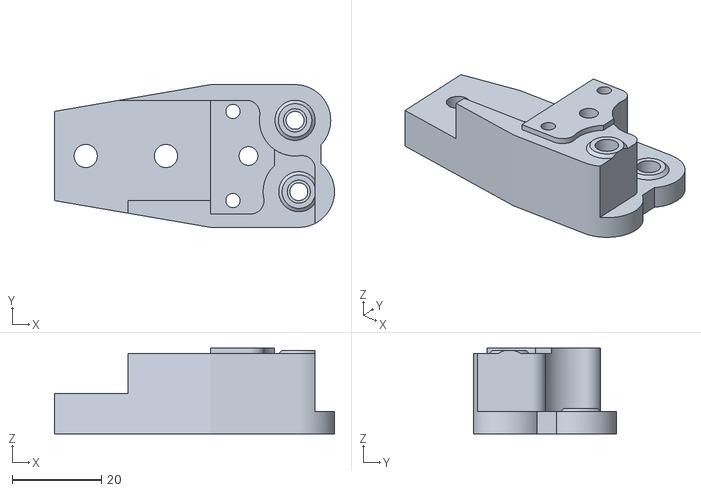
[picture p252: CAD file, 2020-10-24]
files/Components/HD9/HD9_YCarriage_RH_UpperBodyV2.stl
62.8 x 32.0 x 19.2
