MirageC79/HevORT/files/Components/HevACS/315_340/HevACS_315_340_Diffuser.stl

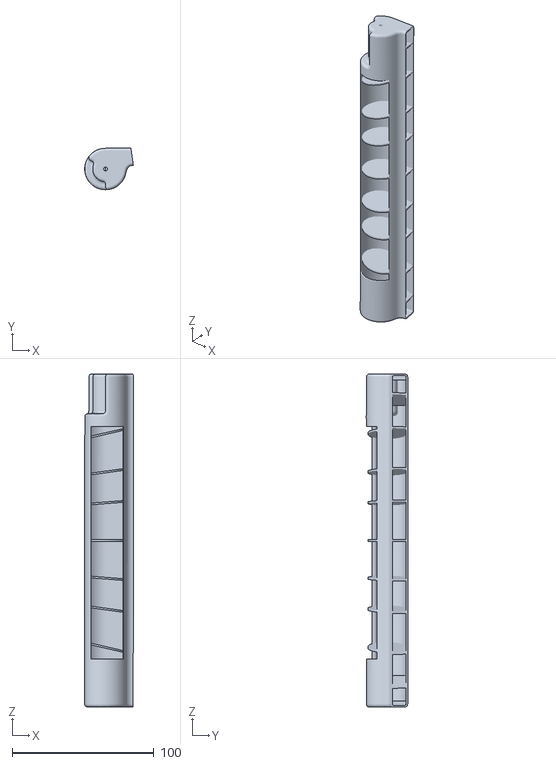
[picture p254: CAD file, 2021-07-09]
files/Components/HevACS/315_340/HevACS_315_340_Diffuser.stl
34.4 x 29.3 x 235.0
