MirageC79/HevORT/files/Components/HevACS/ForOleg/HevACS_120mm_515x540_MidDuct_LHRH_BETA.1.stl

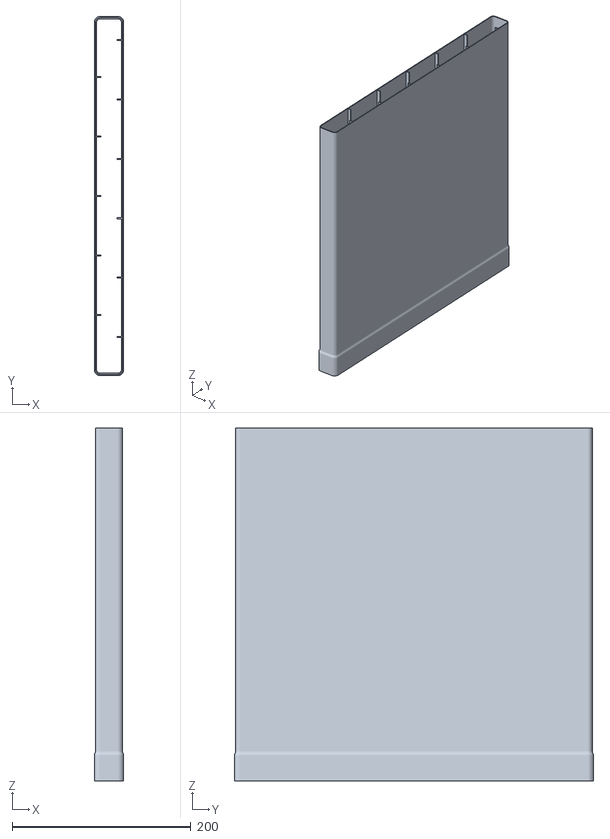
[picture p255: CAD file, 2020-12-03]
files/Components/HevACS/ForOleg/HevACS_120mm_515x540_MidDuct_LHRH_BETA.1.stl
33.0 x 402.0 x 395.0
