MirageC79/HevORT/files/Components/HevACS/HevACS_NozzleBracketFL_BETA.stl

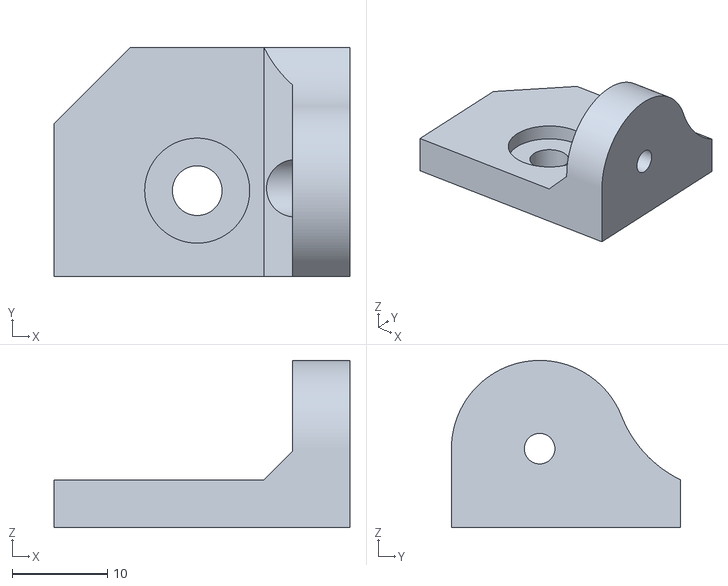
[picture p256: CAD file, 2020-11-02]
files/Components/HevACS/HevACS_NozzleBracketFL_BETA.stl
31.0 x 24.0 x 17.5
