MirageC79/HevORT/files/Components/PrintHead/LGX_MagnumPlus_HDx_Top/HD12_MGN9_LGX_Magnum_BackBelt Retainers_Draft.stl

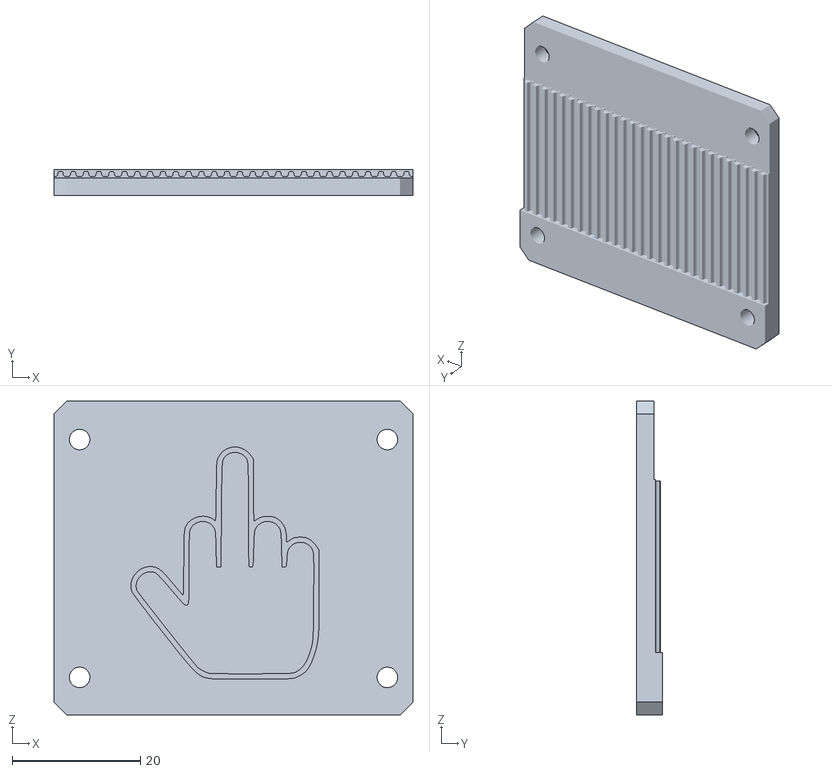
[picture p257: CAD file, 2021-11-05]
files/Components/PrintHead/LGX_MagnumPlus_HDx_Top/HD12_MGN9_LGX_Magnum_BackBelt Retainers_Draft.stl
56.0 x 4.11 x 48.9
