MirageC79/HevORT/files/Components/PrintHead/VezMetalPrintHead_HDx/Goliath_AIR_2510_fan_duct.stl

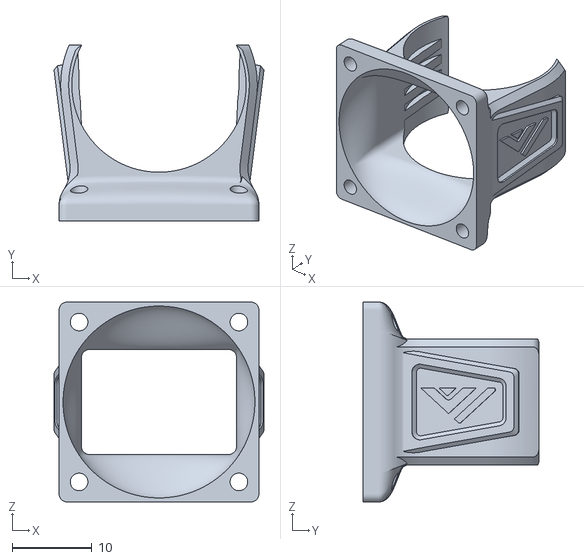
[picture p258: CAD file, 2023-11-19]
files/Components/PrintHead/VezMetalPrintHead_HDx/Goliath_AIR_2510_fan_duct.stl
26.3 x 22.0 x 25.0
