MirageC79/HevORT/files/Components/XYHT/OPTION_CFX/XYHT_MGN9CFX_YCarriage_LH_V2.52_Split_Lower.stl

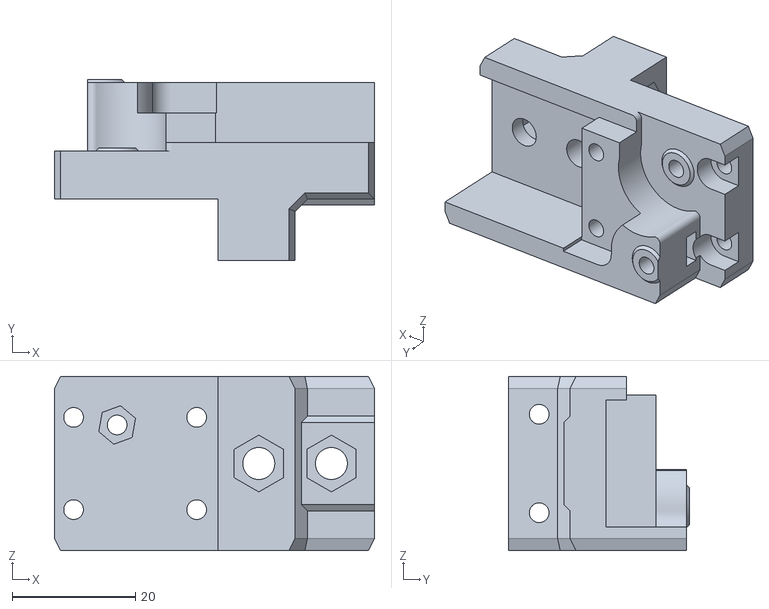
[picture p259: CAD file, 2022-11-12]
files/Components/XYHT/OPTION_CFX/XYHT_MGN9CFX_YCarriage_LH_V2.52_Split_Lower.stl
52.0 x 29.5 x 28.3
