MirageC79/HevORT/files/Components/XYHT/XYHT_YCarriage_RH_V2.5_Split_Upper.stl

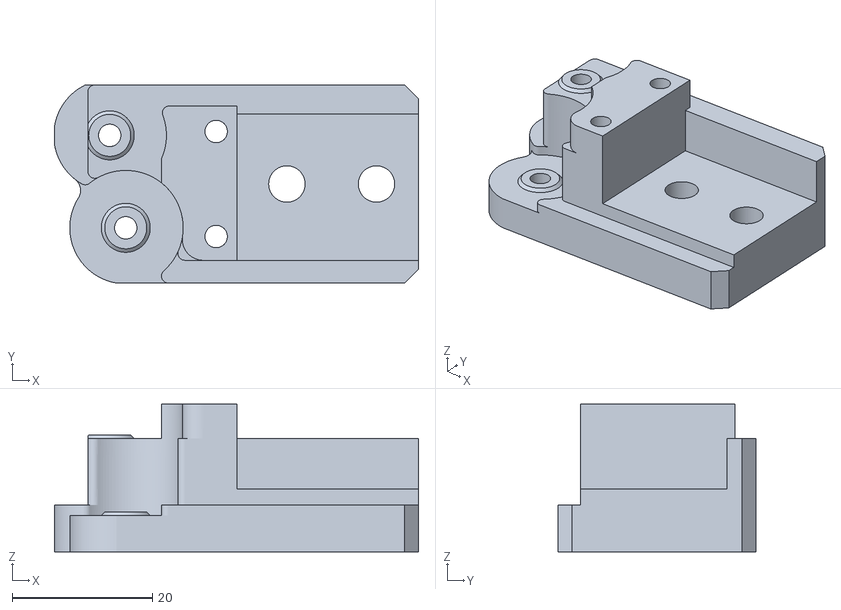
[picture p260: CAD file, 2022-01-09]
files/Components/XYHT/XYHT_YCarriage_RH_V2.5_Split_Upper.stl
52.0 x 28.3 x 21.1
