MirageC79/HevORT/files/Components/XYSTD/XYSTD_YCarriage_RH_V2.5_LowerBody.stl

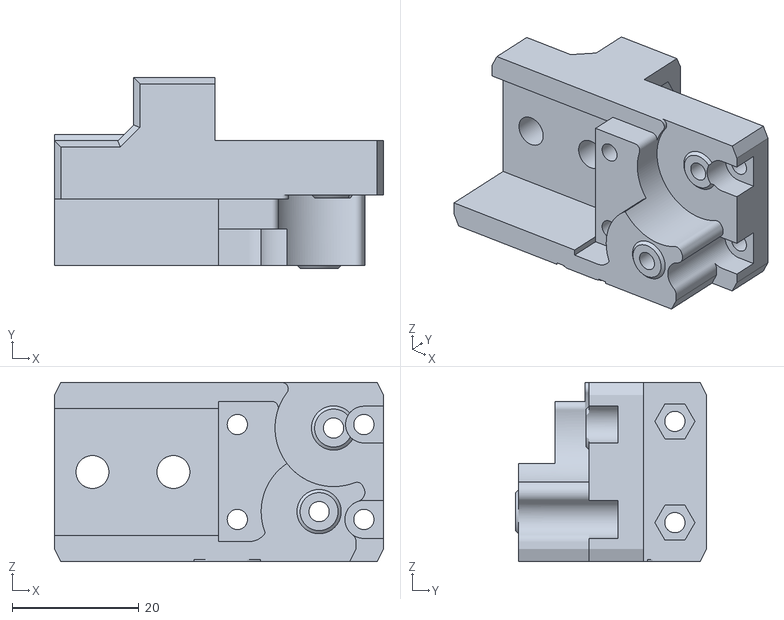
[picture p261: CAD file, 2022-01-10]
files/Components/XYSTD/XYSTD_YCarriage_RH_V2.5_LowerBody.stl
52.0 x 30.2 x 28.3
