MirageC79/HevORT/files/Components/ZR_V2.8_DO NO TUSE/WobbleRing_SFU1605_LowerDisc.stl

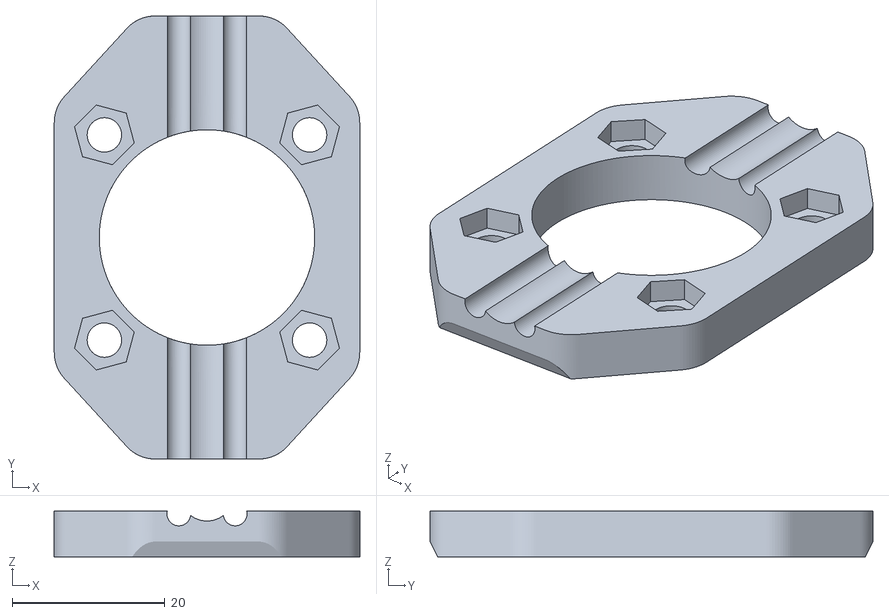
[picture p262: CAD file, 2023-11-25]
files/Components/ZR_V2.8_DO NO TUSE/WobbleRing_SFU1605_LowerDisc.stl
40.0 x 58.0 x 6.00
