MirageC79/HevORT/files/Mods/guitartoys/berd_air_pump_mount/berd_air_pump_mount_bottom_insert.stl

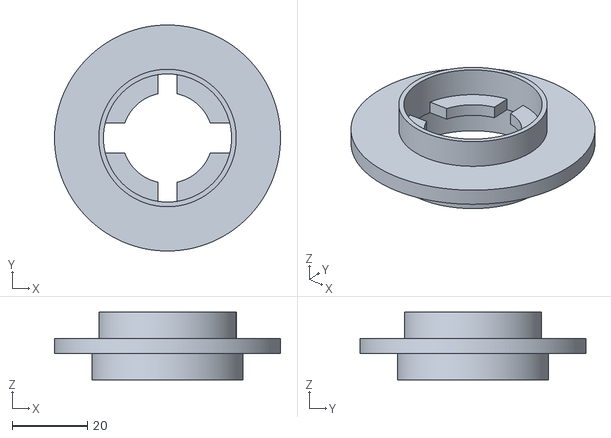
[picture p263: CAD file, 2022-09-28]
files/Mods/guitartoys/berd_air_pump_mount/berd_air_pump_mount_bottom_insert.stl
60.0 x 60.0 x 18.0
