MirageC79/HevORT/files/Mods/guitartoys/hemera_berd_air_nozzle/hemera_v6_berd_air_nozzle.step

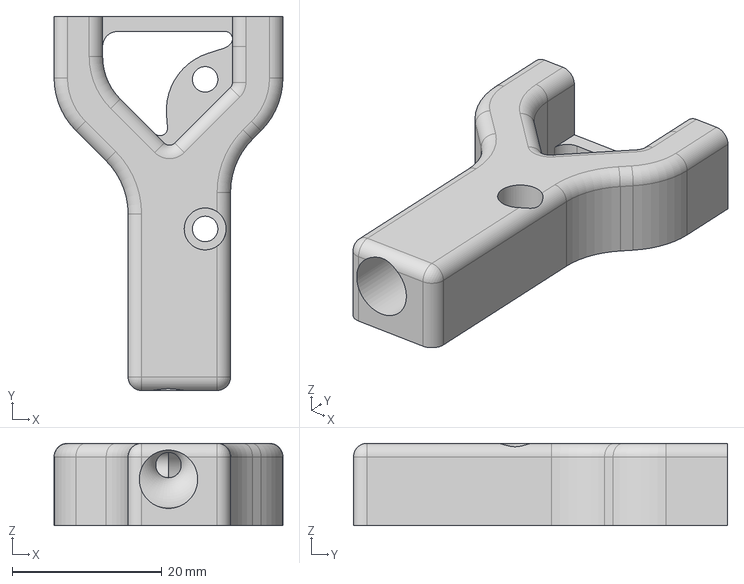
[picture p264: CAD file, 2022-09-28]
files/Mods/guitartoys/hemera_berd_air_nozzle/hemera_v6_berd_air_nozzle.step
30.6 x 50.0 x 11.0 mm
