MirageC79/HevORT/files/STL/HD9/Option_HD9_CFx/XYHD9_HD_YCarriage_RH_LowerBody Beta.1.step

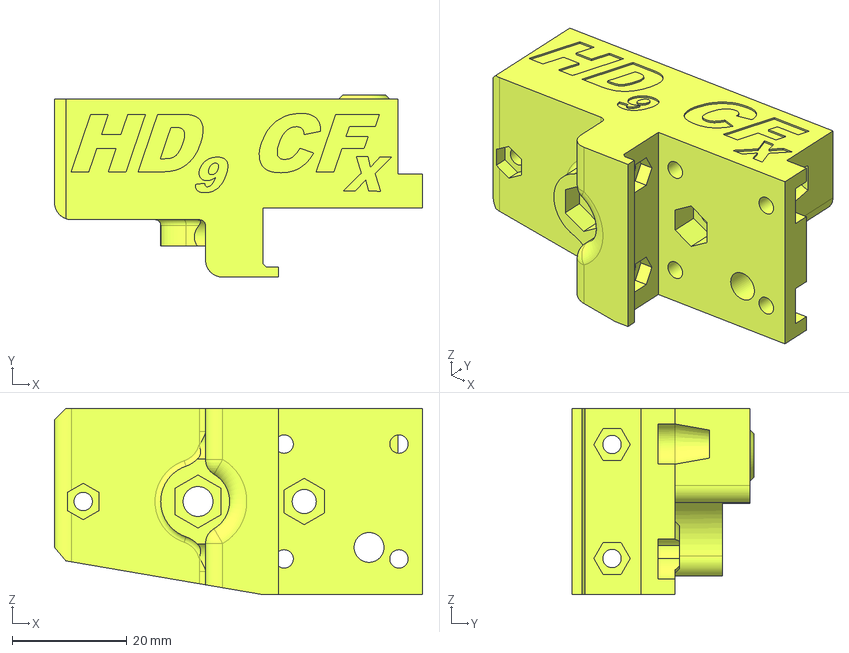
[picture p266: CAD file, 2022-03-03]
files/STL/HD9/Option_HD9_CFx/XYHD9_HD_YCarriage_RH_LowerBody Beta.1.step
64.1 x 31.7 x 32.4 mm
