MirageC79/HevORT/files/STL/XYHT/XYHT_YCarriage_RH_V2_Body.stl

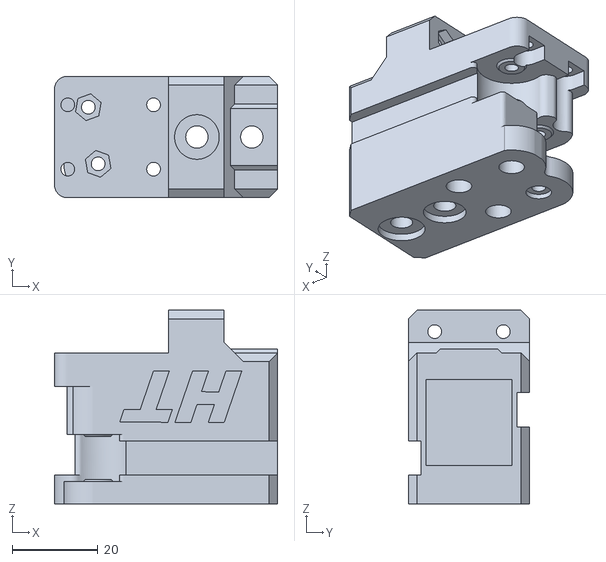
[picture p267: CAD file, 2022-01-07]
files/STL/XYHT/XYHT_YCarriage_RH_V2_Body.stl
52.0 x 28.3 x 45.2
