MirageC79/HevORT/files/Components/Enclosure/AcidBee_Enclosure/3030_PanelClip_Retainer_Half.stl

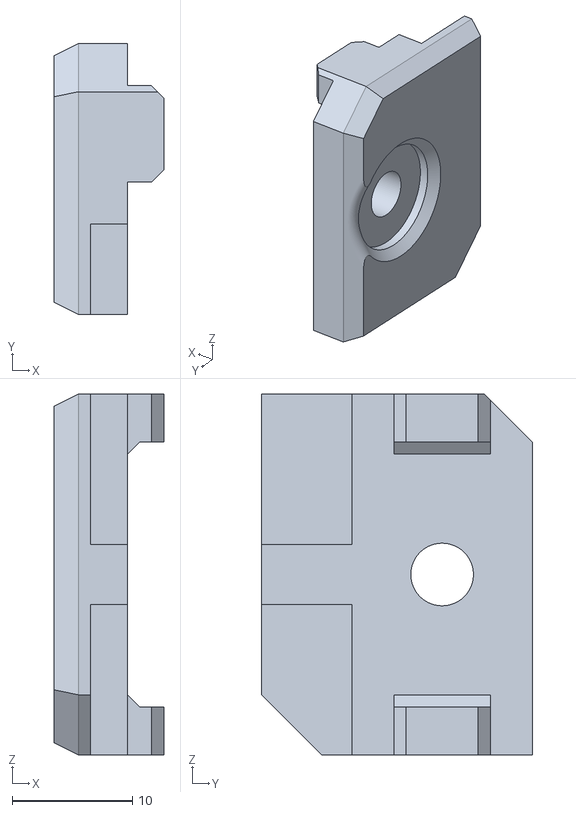
[picture p268: CAD file, 2024-01-22]
files/Components/Enclosure/AcidBee_Enclosure/3030_PanelClip_Retainer_Half.stl
9.10 x 22.5 x 30.0
