MirageC79/HevORT/files/Components/Enclosure/ElectronicBay/AcidBee_Enclosure/3030PanelClip_Intersection_4Corners_Body_V1.5.stl

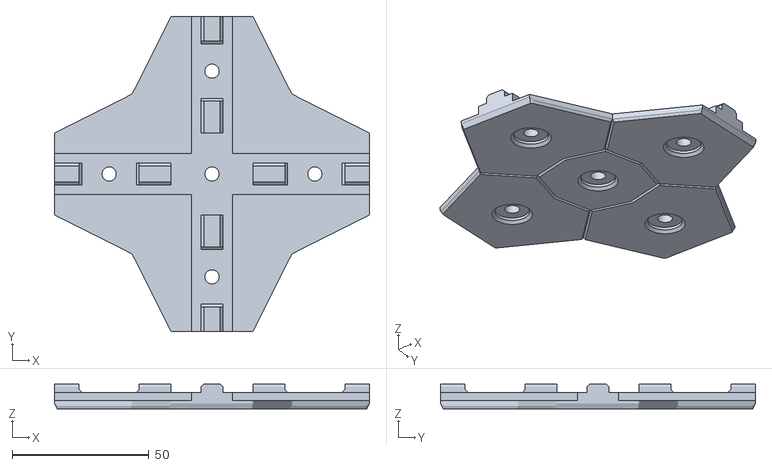
[picture p269: CAD file, 2022-12-08]
files/Components/Enclosure/ElectronicBay/AcidBee_Enclosure/3030PanelClip_Intersection_4Corners_Body_V1.5.stl
115.3 x 115.3 x 9.10
