MirageC79/HevORT/files/Components/Enclosure/ElectronicBay/OctopusProCasing/Octopus Logo_Beta3.stl

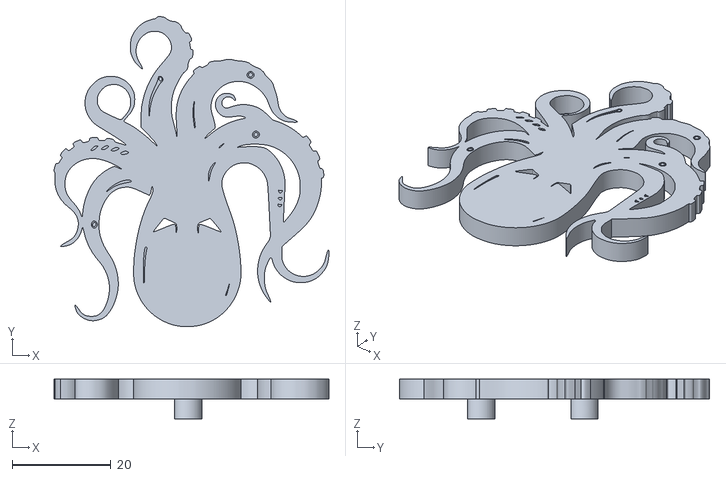
[picture p270: CAD file, 2022-02-22]
files/Components/Enclosure/ElectronicBay/OctopusProCasing/Octopus Logo_Beta3.stl
55.6 x 62.7 x 8.00
