MirageC79/HevORT/files/Components/Enclosure/ElectronicBay/PanelClip.step

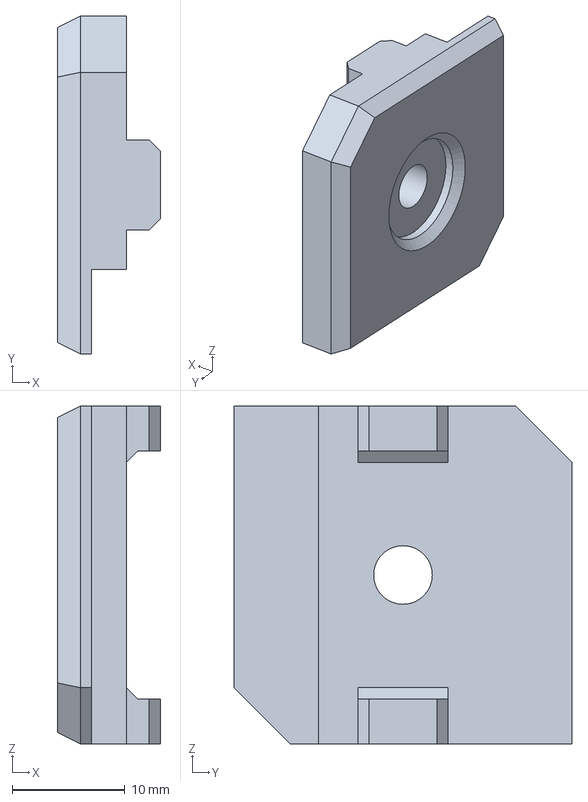
[picture p271: CAD file, 2022-03-05]
files/Components/Enclosure/ElectronicBay/PanelClip.step
9.10 x 30.0 x 30.0 mm
