MirageC79/HevORT/files/Components/Enclosure/TopLid/DoorHingeFlapper_UpLH.stl

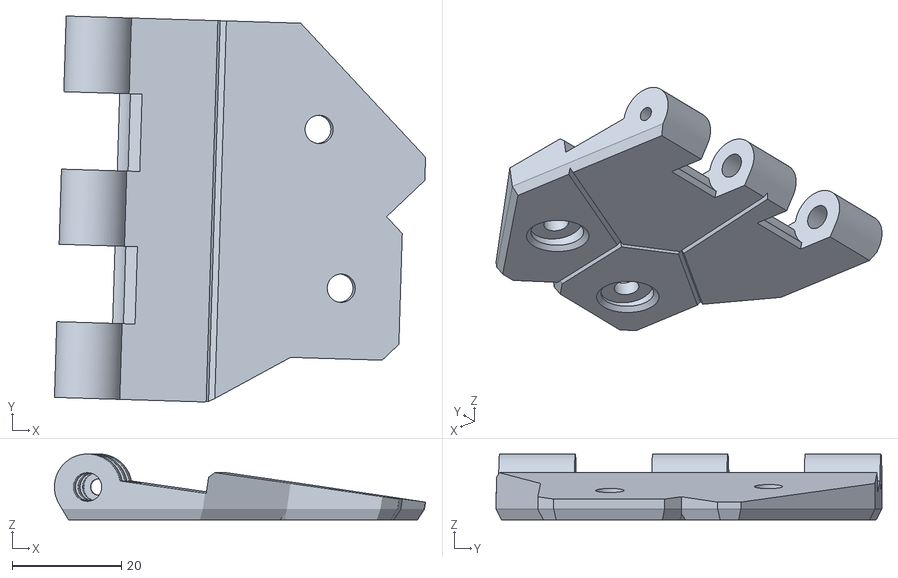
[picture p272: CAD file, 2024-02-24]
files/Components/Enclosure/TopLid/DoorHingeFlapper_UpLH.stl
68.1 x 70.8 x 12.1
