MirageC79/HevORT/files/Components/Enclosure/WaterCooling_Bay/WaterCoolingBay_BracketClipLH.stl

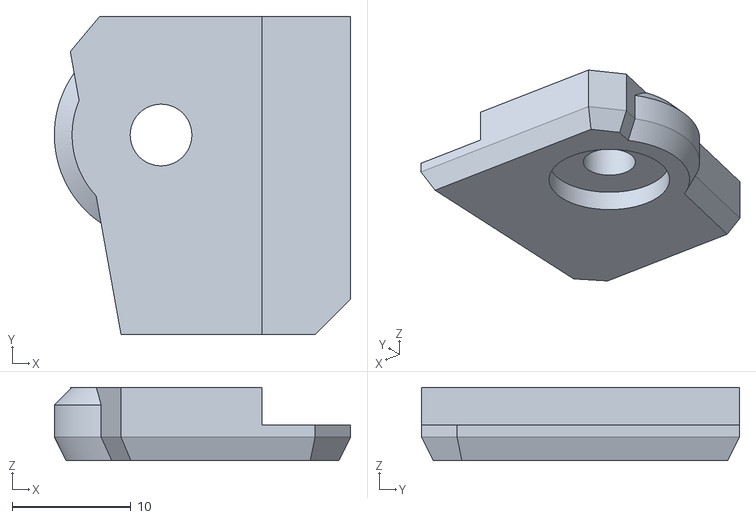
[picture p273: CAD file, 2023-09-26]
files/Components/Enclosure/WaterCooling_Bay/WaterCoolingBay_BracketClipLH.stl
25.0 x 26.8 x 6.20
