MirageC79/HevORT/files/Components/HD12/HD12_MotorMount_RH_ForEnclosure_BodyV1.5.stl

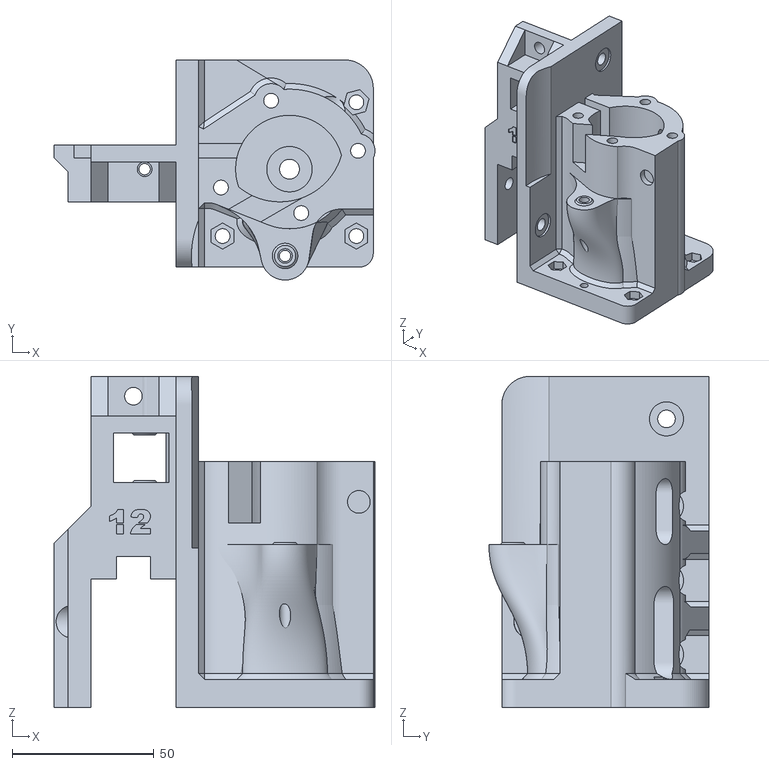
[picture p274: CAD file, 2022-08-09]
files/Components/HD12/HD12_MotorMount_RH_ForEnclosure_BodyV1.5.stl
113.1 x 77.6 x 116.8
