MirageC79/HevORT/files/Components/HD12/OPTION HD12CFx/HD_CFx_MGN9_CFTube InsertV1.15.stl

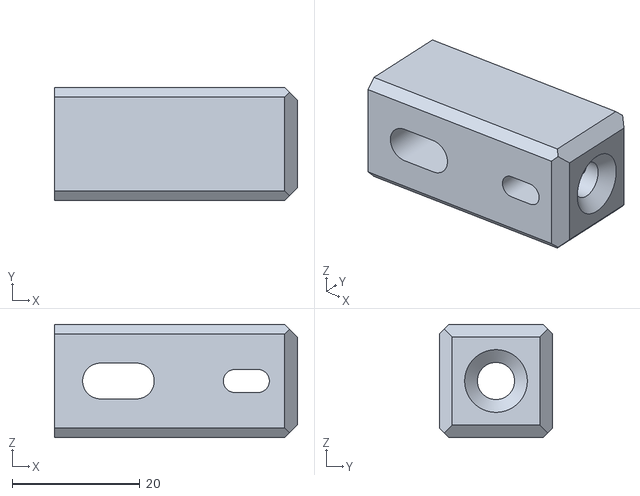
[picture p275: CAD file, 2021-09-28]
files/Components/HD12/OPTION HD12CFx/HD_CFx_MGN9_CFTube InsertV1.15.stl
38.0 x 17.7 x 17.7
