MirageC79/HevORT/files/Components/HD12_SPAWD/HD12_SPAWD_Cover_MotorMount_FL.stl

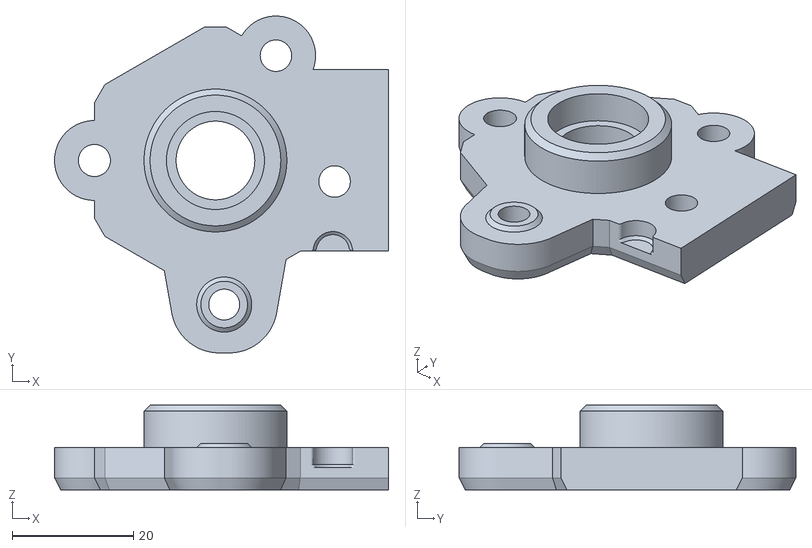
[picture p276: CAD file, 2023-10-26]
files/Components/HD12_SPAWD/HD12_SPAWD_Cover_MotorMount_FL.stl
55.2 x 55.7 x 14.0
