MirageC79/HevORT/files/Components/HD9/HD9_MotorMount_LH_BodyV2.stl

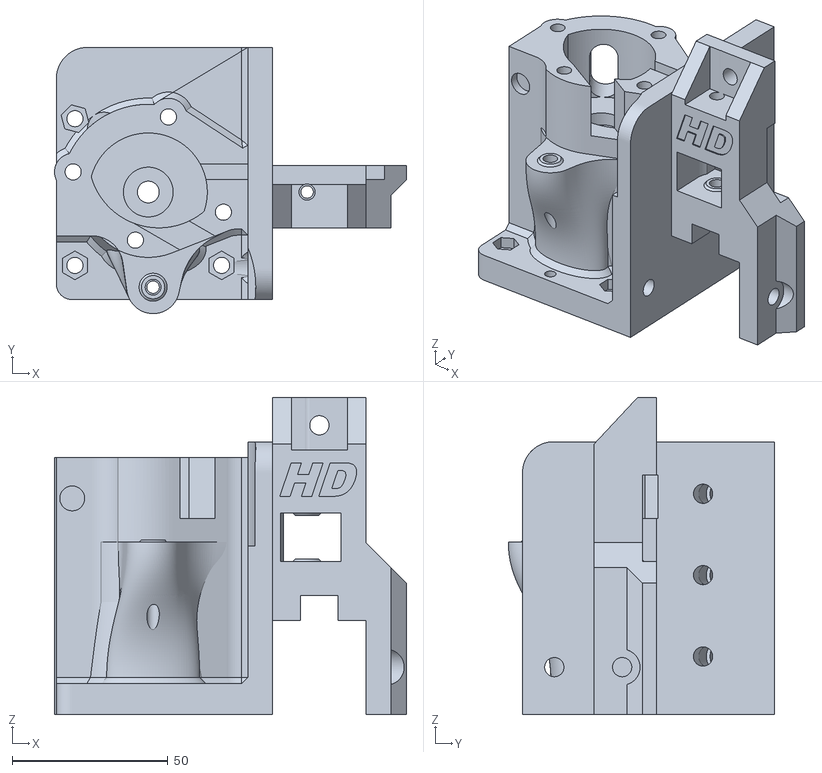
[picture p277: CAD file, 2020-10-24]
files/Components/HD9/HD9_MotorMount_LH_BodyV2.stl
113.1 x 85.6 x 102.0
