MirageC79/HevORT/files/Components/HD9/Option_HD9_CFx_TopRail/XYHD9_CFx_YFlag_LH v2.stl

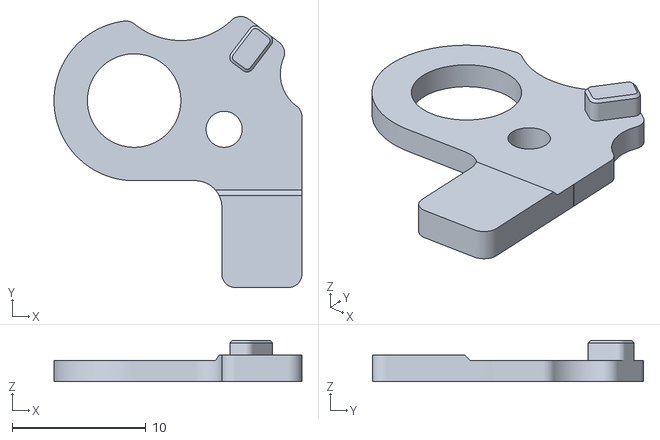
[picture p278: CAD file, 2023-02-16]
files/Components/HD9/Option_HD9_CFx_TopRail/XYHD9_CFx_YFlag_LH v2.stl
18.6 x 20.3 x 3.10
