MirageC79/HevORT/files/Components/HD9_10_SPAWD/HD10_SPAWD_Cover_MotorMount_FR.stl

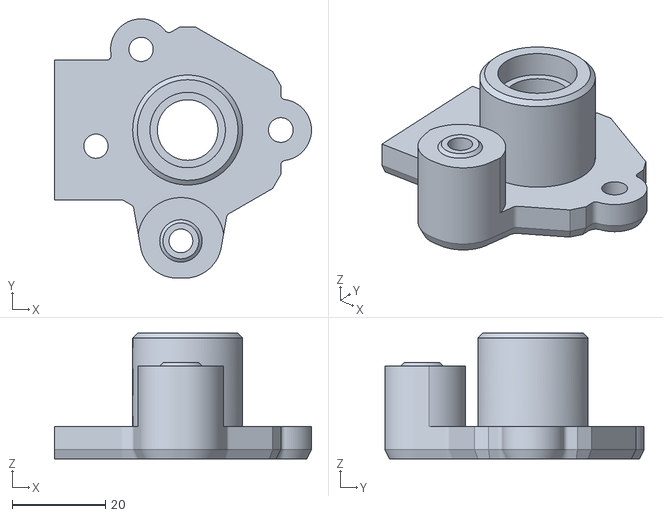
[picture p279: CAD file, 2023-10-13]
files/Components/HD9_10_SPAWD/HD10_SPAWD_Cover_MotorMount_FR.stl
55.2 x 55.7 x 27.0
