MirageC79/HevORT/files/Components/HevACS/315_340/HevACS_315_340_Lower.stl

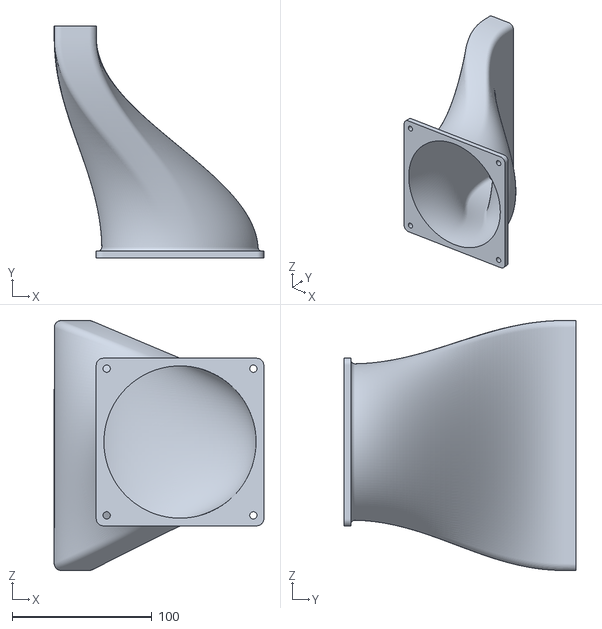
[picture p280: CAD file, 2021-07-09]
files/Components/HevACS/315_340/HevACS_315_340_Lower.stl
150.1 x 166.4 x 179.0
