MirageC79/HevORT/files/Components/HevACS/ForOleg/HevACS_Nozzle_515_LH_BETA.stl

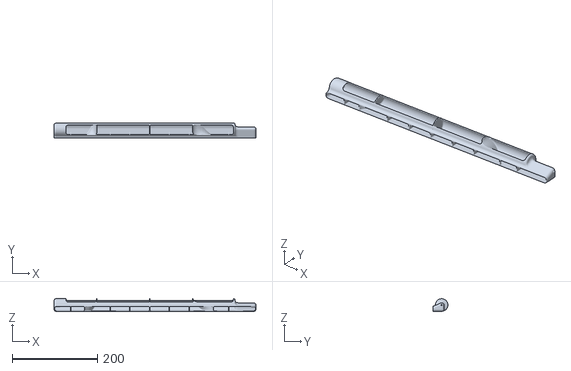
[picture p281: CAD file, 2020-12-01]
files/Components/HevACS/ForOleg/HevACS_Nozzle_515_LH_BETA.stl
474.0 x 34.9 x 29.5
