MirageC79/HevORT/files/Components/HevACS/HevACS_120mm_415x540_MidDuct_BETA.stl

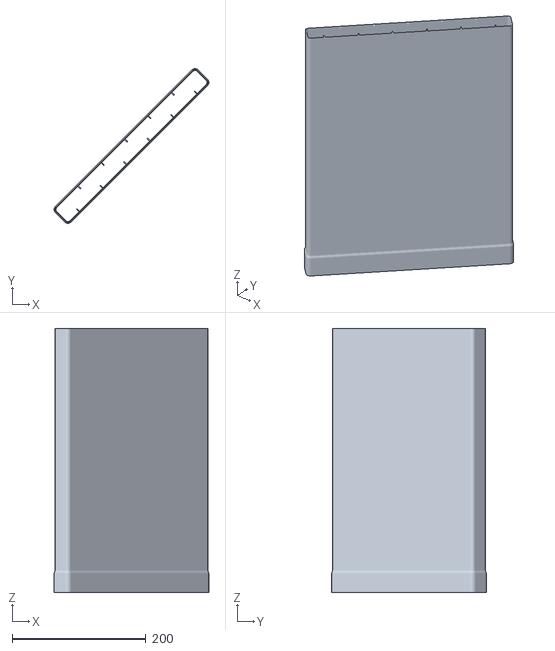
[picture p282: CAD file, 2020-11-02]
files/Components/HevACS/HevACS_120mm_415x540_MidDuct_BETA.stl
231.4 x 231.4 x 395.0
