MirageC79/HevORT/files/Components/PrintHead/VezMetalPrintHead_HDx/HDx_VzPrintHead_TentacoolSpacer_GoliathLong.stl

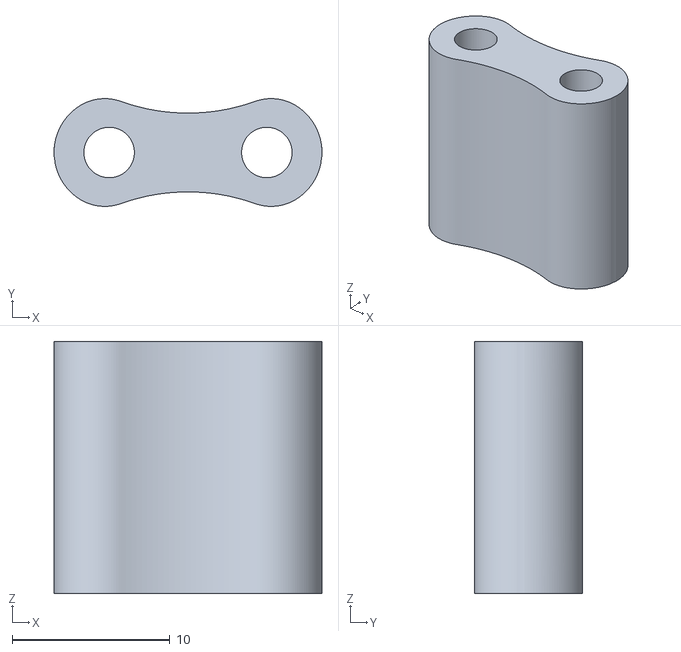
[picture p284: CAD file, 2023-11-17]
files/Components/PrintHead/VezMetalPrintHead_HDx/HDx_VzPrintHead_TentacoolSpacer_GoliathLong.stl
17.0 x 6.84 x 16.0
