MirageC79/HevORT/files/Components/XYHT/OPTION_CFX/XYHT_MGN9CFX_YCarriage_LH_V2.5_Split_Upper.stl

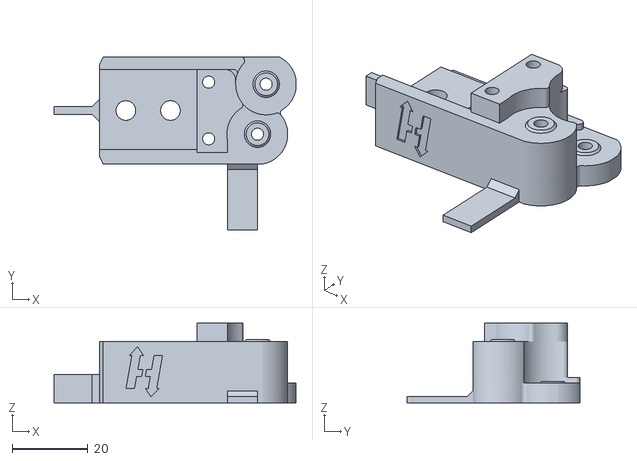
[picture p285: CAD file, 2022-11-12]
files/Components/XYHT/OPTION_CFX/XYHT_MGN9CFX_YCarriage_LH_V2.5_Split_Upper.stl
64.0 x 45.8 x 21.1
