MirageC79/HevORT/files/Components/XYSTD/XYSTD_YCarriage_RH_V2.5_UpperBody.stl

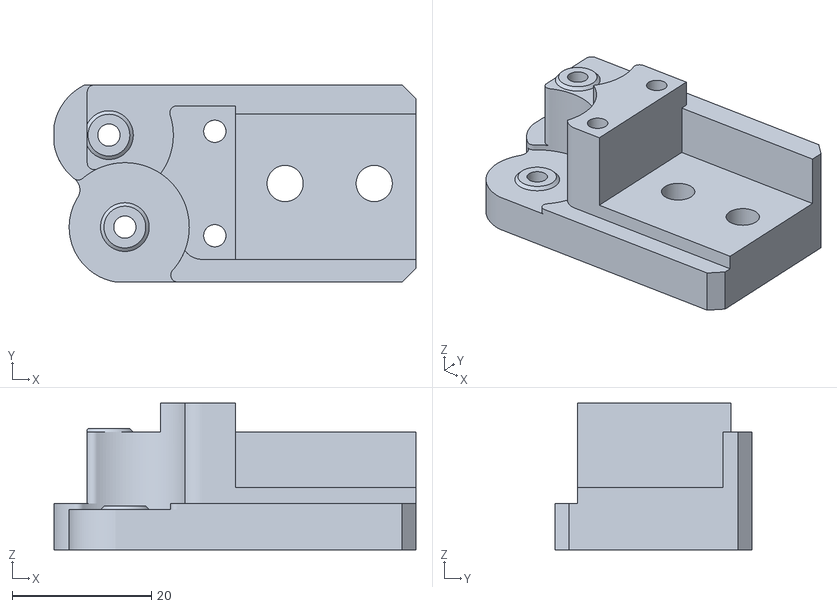
[picture p286: CAD file, 2022-01-10]
files/Components/XYSTD/XYSTD_YCarriage_RH_V2.5_UpperBody.stl
52.0 x 28.3 x 21.1
