MirageC79/HevORT/files/Components/ZR_V2.6/ZR_BearingTopMount_RR_HighReach_Body.stl

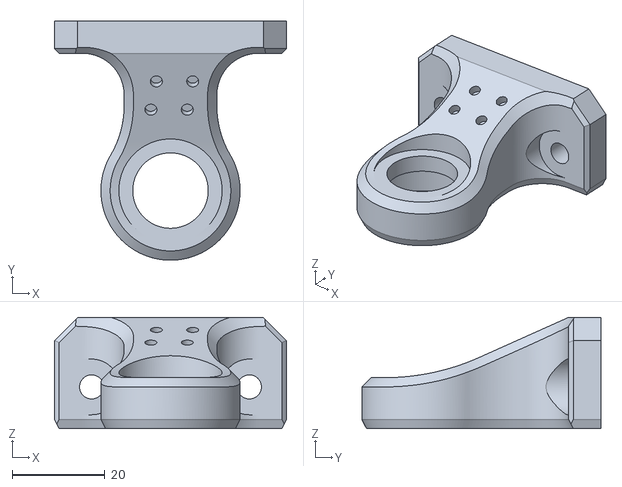
[picture p287: CAD file, 2023-10-13]
files/Components/ZR_V2.6/ZR_BearingTopMount_RR_HighReach_Body.stl
50.0 x 51.6 x 24.0
