MirageC79/HevORT/files/Components/ZR_V2.8_DO NO TUSE/ZR2.8_WobbleX_SliderMount_RH_Body_EXPERIMENTAL.stl

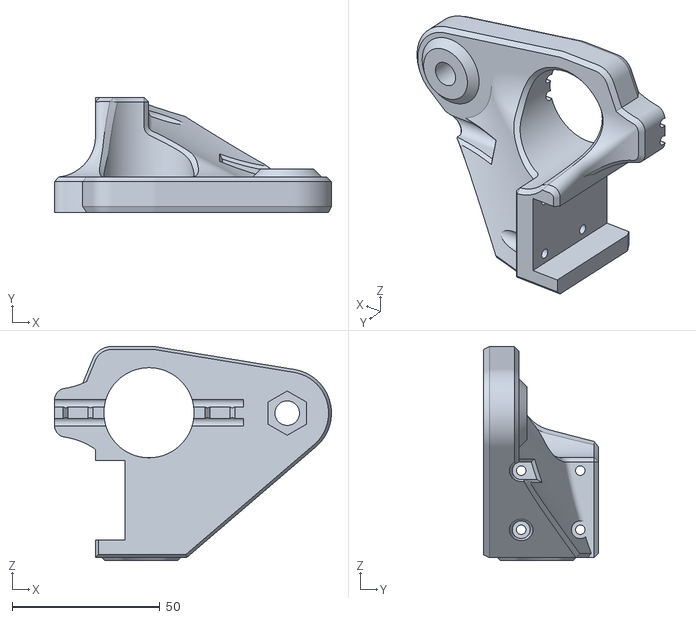
[picture p288: CAD file, 2023-07-24]
files/Components/ZR_V2.8_DO NO TUSE/ZR2.8_WobbleX_SliderMount_RH_Body_EXPERIMENTAL.stl
93.8 x 39.0 x 72.5
