MirageC79/HevORT/files/Mods/guitartoys/berd_air_pump_mount/berd_air_pump_mount_insert.stl

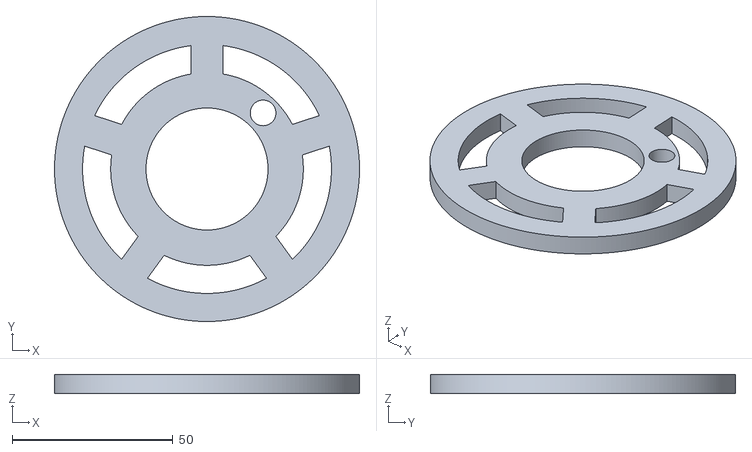
[picture p289: CAD file, 2022-09-28]
files/Mods/guitartoys/berd_air_pump_mount/berd_air_pump_mount_insert.stl
95.0 x 95.0 x 6.00
