MirageC79/HevORT/files/Mods/guitartoys/duet3_mounting_bracket/Duet_Frame_Big_Part.stl

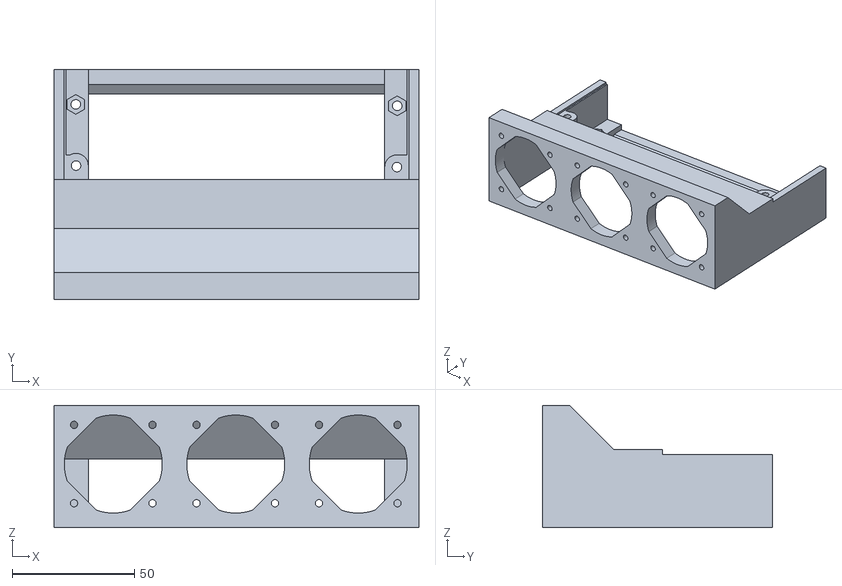
[picture p290: CAD file, 2022-09-28]
files/Mods/guitartoys/duet3_mounting_bracket/Duet_Frame_Big_Part.stl
149.0 x 93.8 x 50.0
