MirageC79/HevORT/files/Mods/vvega/wobble_ring_mellow_metal_center/front_left_top_wobble_ring_mellow_metal_center.stl

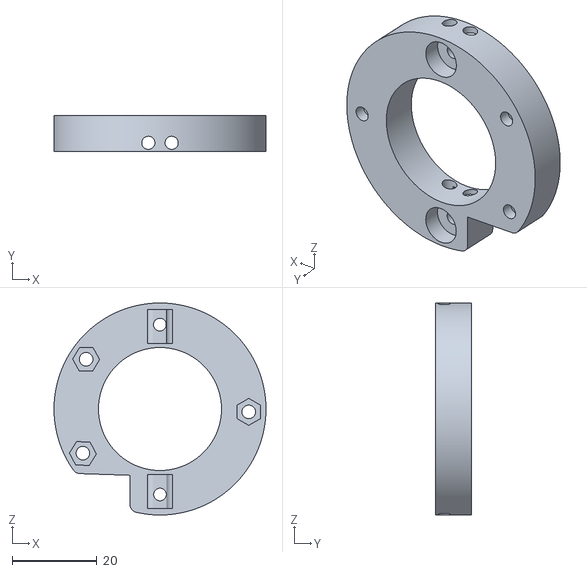
[picture p291: CAD file, 2022-09-28]
files/Mods/vvega/wobble_ring_mellow_metal_center/front_left_top_wobble_ring_mellow_metal_center.stl
50.0 x 8.50 x 50.0
