MirageC79/HevORT/files/STL/HD9/Option_HD9_CFx/XYHD9_CFx_YCarriage_LH_UpperBody Beta.1.step

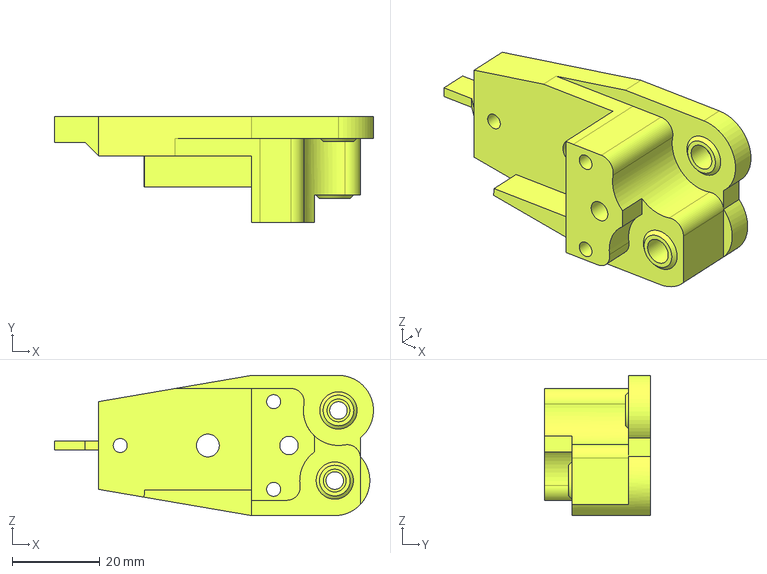
[picture p292: CAD file, 2022-02-26]
files/STL/HD9/Option_HD9_CFx/XYHD9_CFx_YCarriage_LH_UpperBody Beta.1.step
72.8 x 24.3 x 32.0 mm
