MirageC79/HevORT/files/Components/Enclosure/ElectronicBay/AcidBee_Enclosure/3030PanelClip_Intersection_4corners_V1.5.step

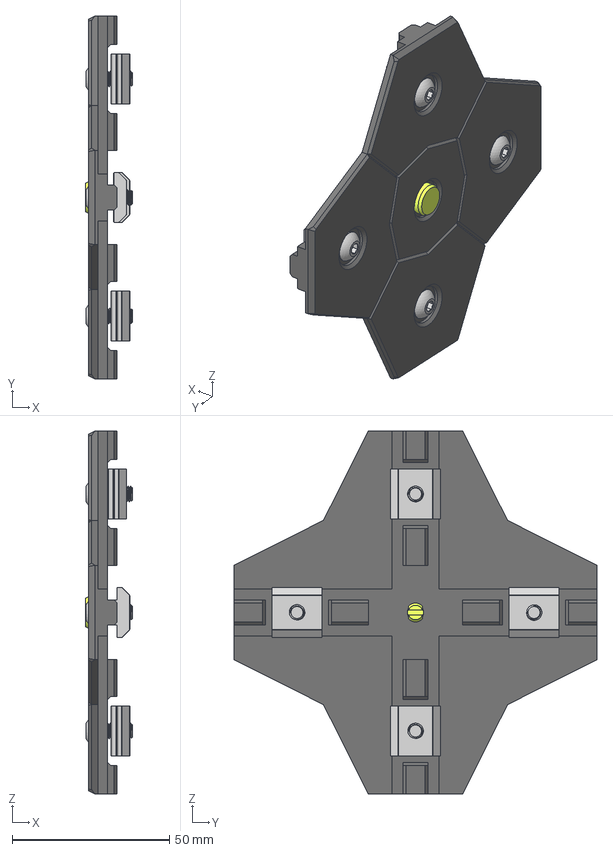
[picture p293: CAD file, 2022-12-08]
files/Components/Enclosure/ElectronicBay/AcidBee_Enclosure/3030PanelClip_Intersection_4corners_V1.5.step
15.0 x 115.3 x 115.3 mm
3030PanelClip_Intersection_Body
DummyPin
M5X12_ButtonHeadScrew_91239A228 x 4
M5X3030_TSlot_Nut x 4
