MirageC79/HevORT/files/Components/Enclosure/ElectronicBay/OctopusProCasing/DINMountLeft_Beta2.stl

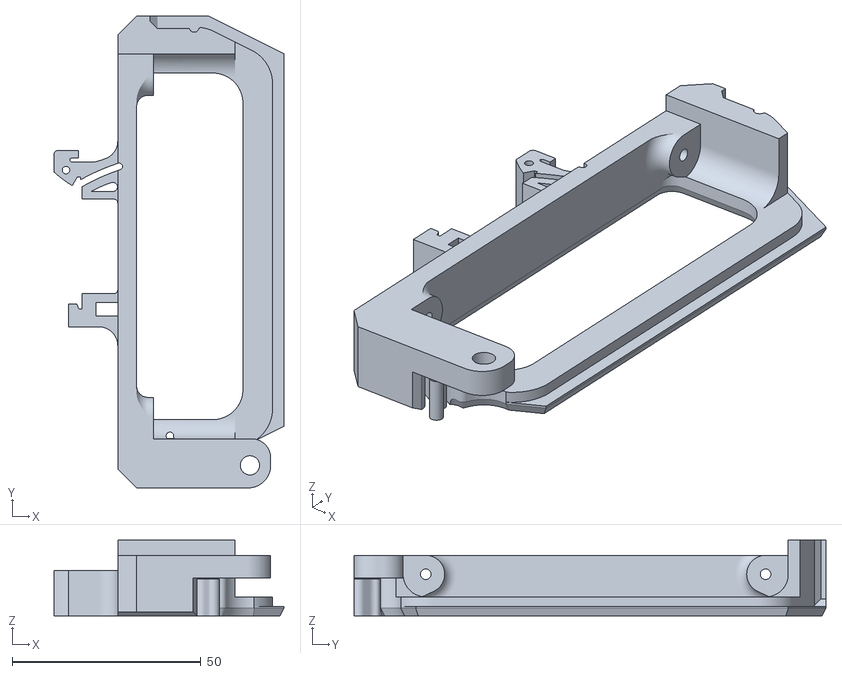
[picture p294: CAD file, 2022-02-21]
files/Components/Enclosure/ElectronicBay/OctopusProCasing/DINMountLeft_Beta2.stl
60.9 x 125.0 x 20.0
