MirageC79/HevORT/files/Components/Enclosure/ElectronicBay/RPI_DINPlate_MetalCase_Flat v1.stl

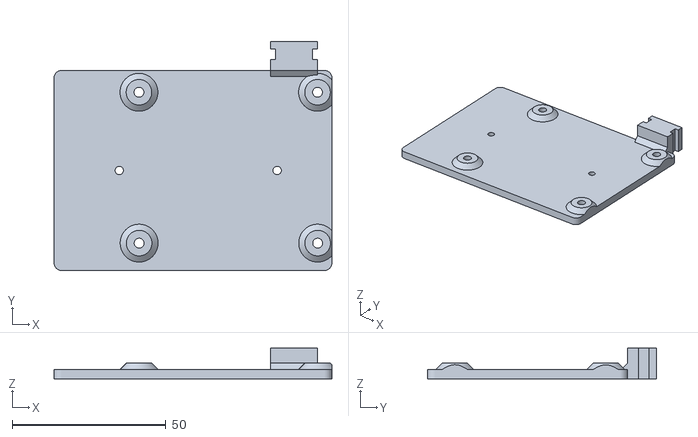
[picture p295: CAD file, 2022-02-25]
files/Components/Enclosure/ElectronicBay/RPI_DINPlate_MetalCase_Flat v1.stl
90.3 x 74.4 x 10.0
