MirageC79/HevORT/files/Components/HD12/OPTION HD12CFx/HD12_CFx_MGN9_YCarriage_RH_LowerBody v2040.stl

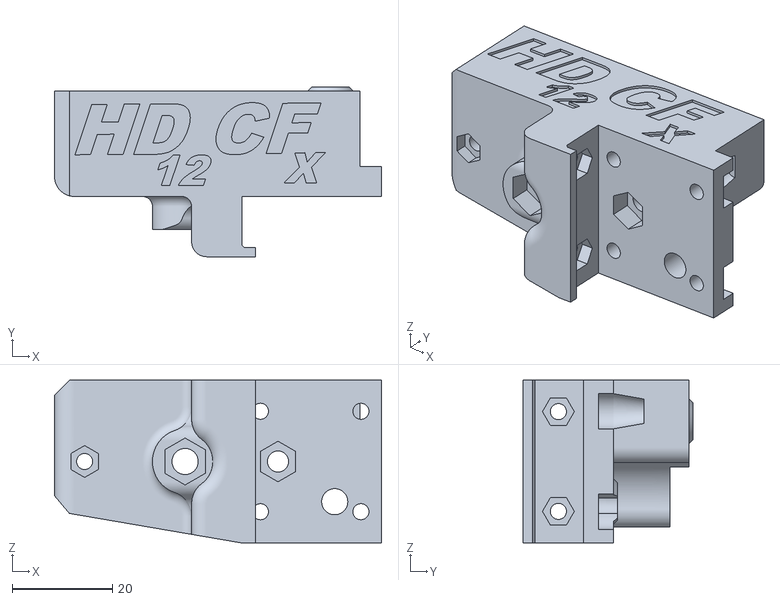
[picture p296: CAD file, 2021-09-20]
files/Components/HD12/OPTION HD12CFx/HD12_CFx_MGN9_YCarriage_RH_LowerBody v2040.stl
65.1 x 33.8 x 32.4
