MirageC79/HevORT/files/Components/HD12/OPTION HD12CFx_TopRail/HDxTop_VZPrintHead_XEndStopMount.stl

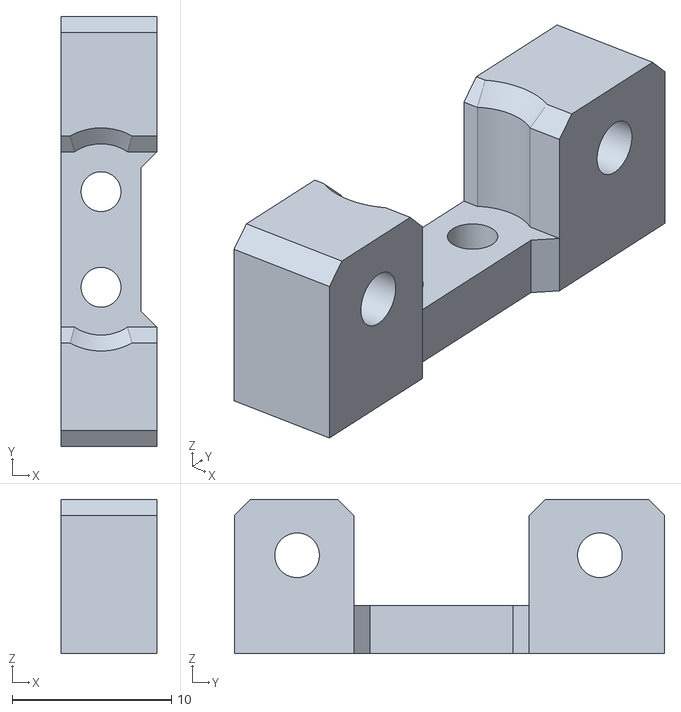
[picture p297: CAD file, 2023-09-16]
files/Components/HD12/OPTION HD12CFx_TopRail/HDxTop_VZPrintHead_XEndStopMount.stl
6.00 x 27.0 x 9.66
