MirageC79/HevORT/files/Components/HD12/XCarriage_Test_Cover.stl

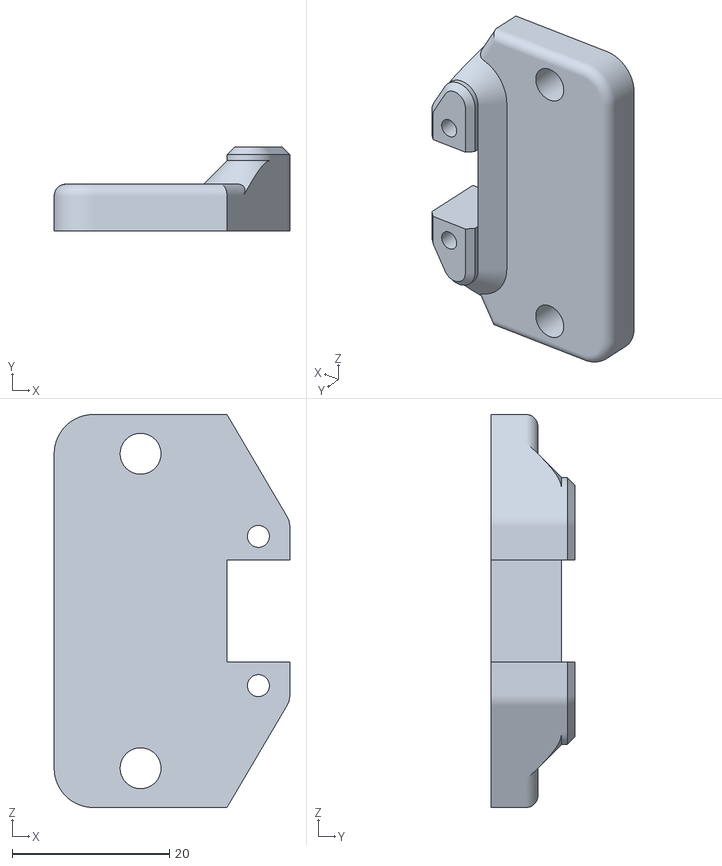
[picture p298: CAD file, 2020-11-18]
files/Components/HD12/XCarriage_Test_Cover.stl
30.0 x 10.8 x 50.0
