MirageC79/HevORT/files/Components/HD12_SPAWD/HD12_SPAWD_MotorMount_RR.stl

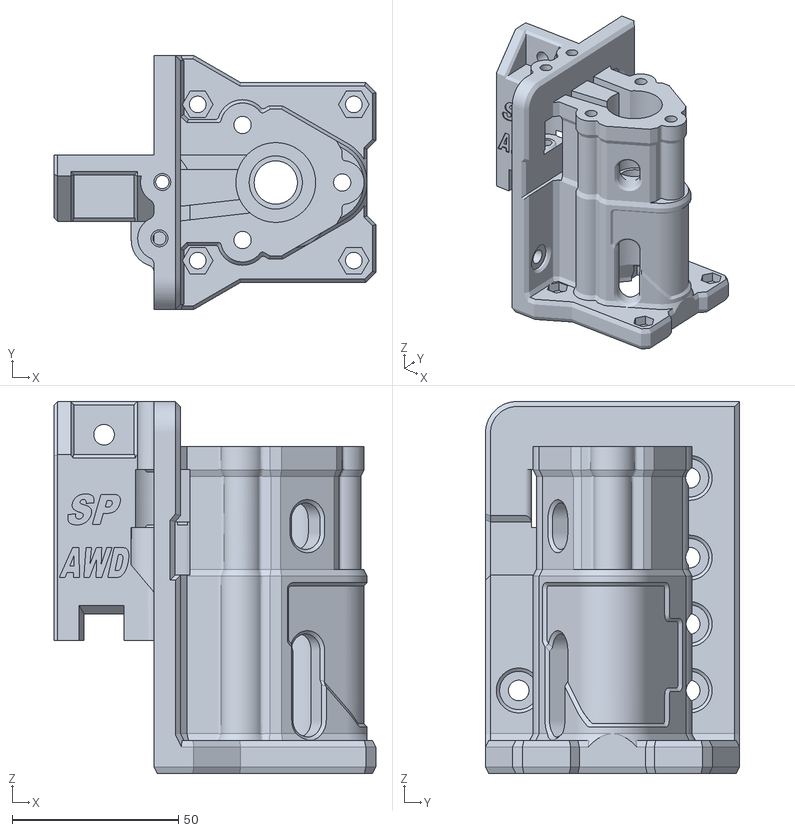
[picture p299: CAD file, 2023-10-26]
files/Components/HD12_SPAWD/HD12_SPAWD_MotorMount_RR.stl
96.8 x 76.5 x 112.0
