MirageC79/HevORT/files/Components/HD9/HevORT_LOGO_Small.stl

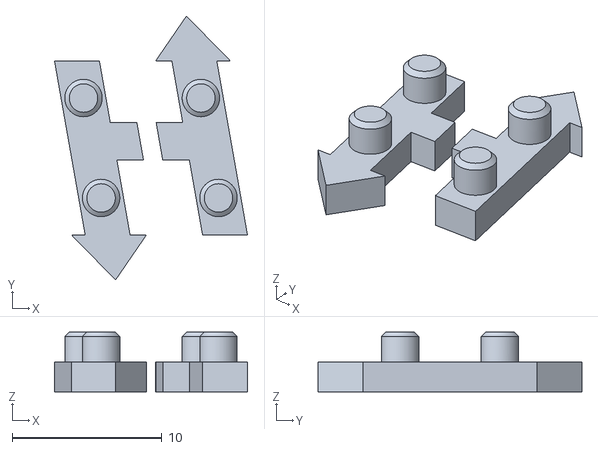
[picture p300: CAD file, 2020-10-24]
files/Components/HD9/HevORT_LOGO_Small.stl
12.9 x 17.6 x 4.00
