MirageC79/HevORT/files/Components/HD9/Option_HD9_CFx_TopRail/XYHD9_CFx_TopRail_MGN9_YCarriage_LH_LowerBody v1.stl

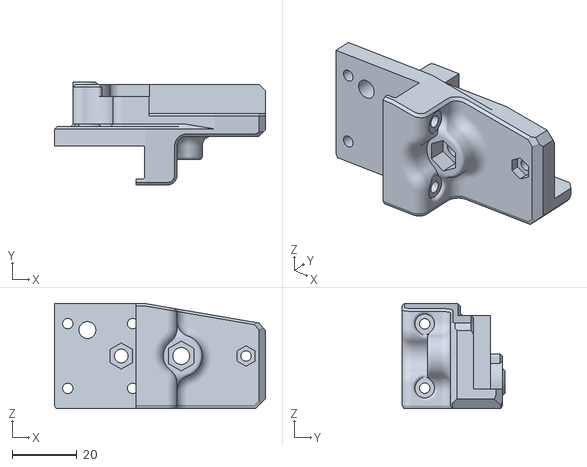
[picture p301: CAD file, 2023-02-16]
files/Components/HD9/Option_HD9_CFx_TopRail/XYHD9_CFx_TopRail_MGN9_YCarriage_LH_LowerBody v1.stl
65.1 x 31.7 x 32.4
