MirageC79/HevORT/files/Components/HD9_10_SPAWD/HD10_SPAWD_MotorMount_FL.stl

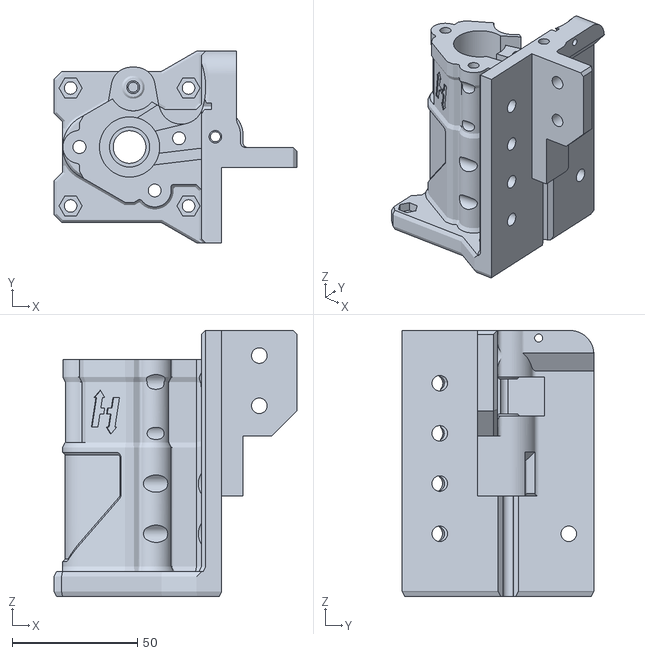
[picture p302: CAD file, 2023-10-13]
files/Components/HD9_10_SPAWD/HD10_SPAWD_MotorMount_FL.stl
96.8 x 76.4 x 106.0
