MirageC79/HevORT/files/Components/HevACS/315_340/HevACS_315_340_diffuserbracketLH_BACK.stl

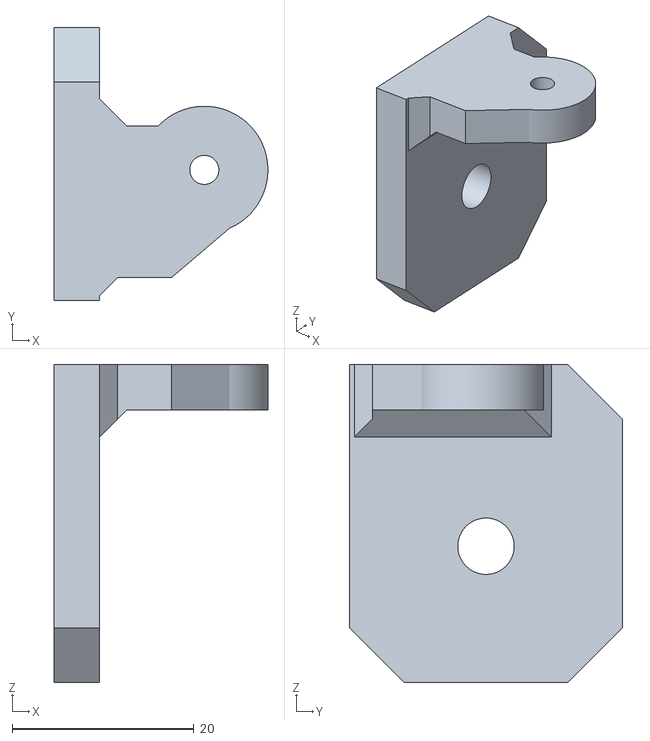
[picture p303: CAD file, 2021-07-09]
files/Components/HevACS/315_340/HevACS_315_340_diffuserbracketLH_BACK.stl
23.5 x 30.0 x 35.0
