MirageC79/HevORT/files/Components/HevACS/ForOleg/HevACS_NozzleBrackets_LH_BETA.stl

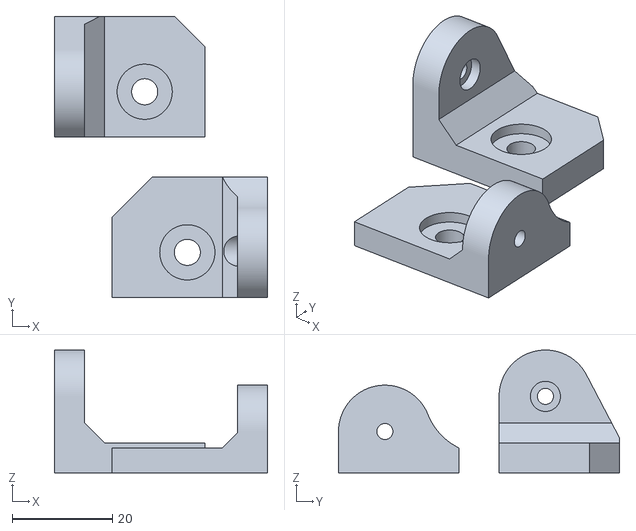
[picture p304: CAD file, 2020-12-01]
files/Components/HevACS/ForOleg/HevACS_NozzleBrackets_LH_BETA.stl
42.5 x 56.0 x 24.5
