MirageC79/HevORT/files/Components/PrintHead/LGX_MagnumPlus_HDx_Top/HeatShield_drill_jig.stl

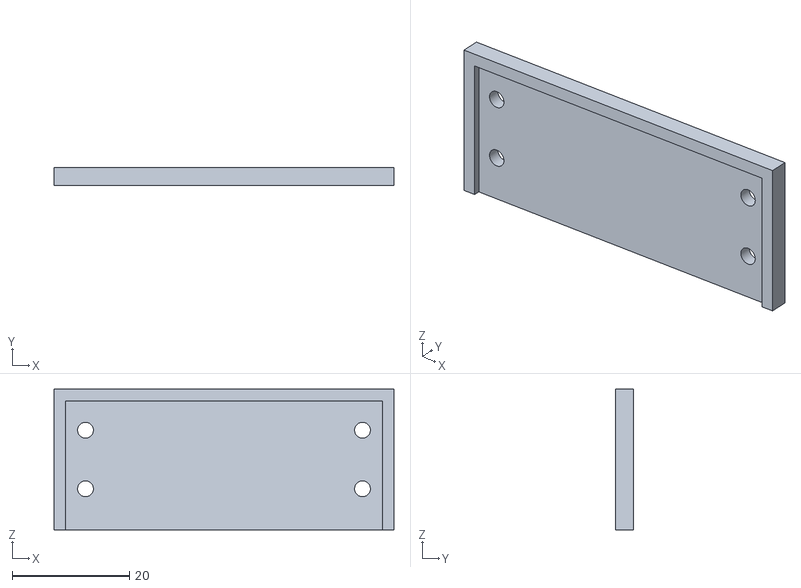
[picture p305: CAD file, 2021-11-05]
files/Components/PrintHead/LGX_MagnumPlus_HDx_Top/HeatShield_drill_jig.stl
58.0 x 3.00 x 24.0
