MirageC79/HevORT/files/Components/XYHT/XYHT_YCarriage_RH_V2.5_Split_Lower.stl

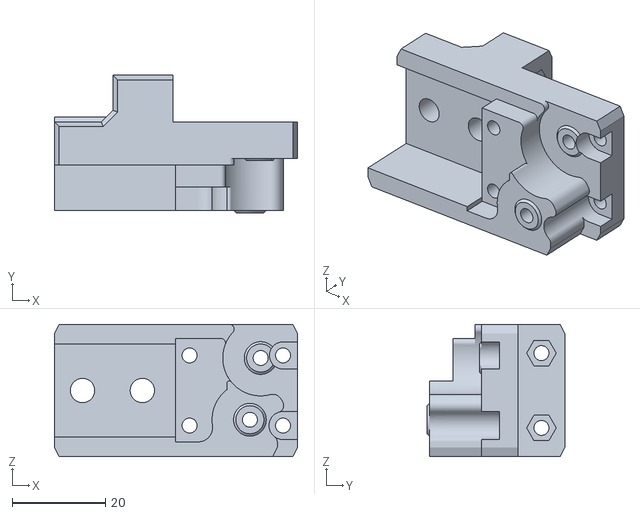
[picture p306: CAD file, 2022-01-09]
files/Components/XYHT/XYHT_YCarriage_RH_V2.5_Split_Lower.stl
52.0 x 29.5 x 28.3
