MirageC79/HevORT/files/Components/XYSTD/XYSTD_YCarriage_LH_V2.5_Split_Upper.stl

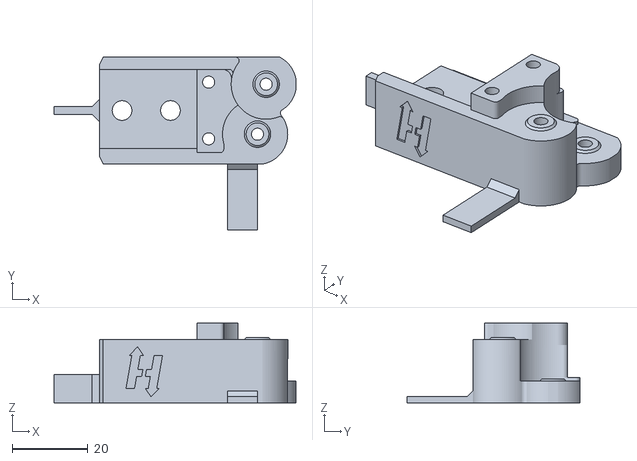
[picture p307: CAD file, 2022-01-10]
files/Components/XYSTD/XYSTD_YCarriage_LH_V2.5_Split_Upper.stl
64.0 x 45.8 x 21.1
