MirageC79/HevORT/files/Components/ZR_V2.6/ZR2.6_BearingTopMount_FR_HighReach_Body.stl

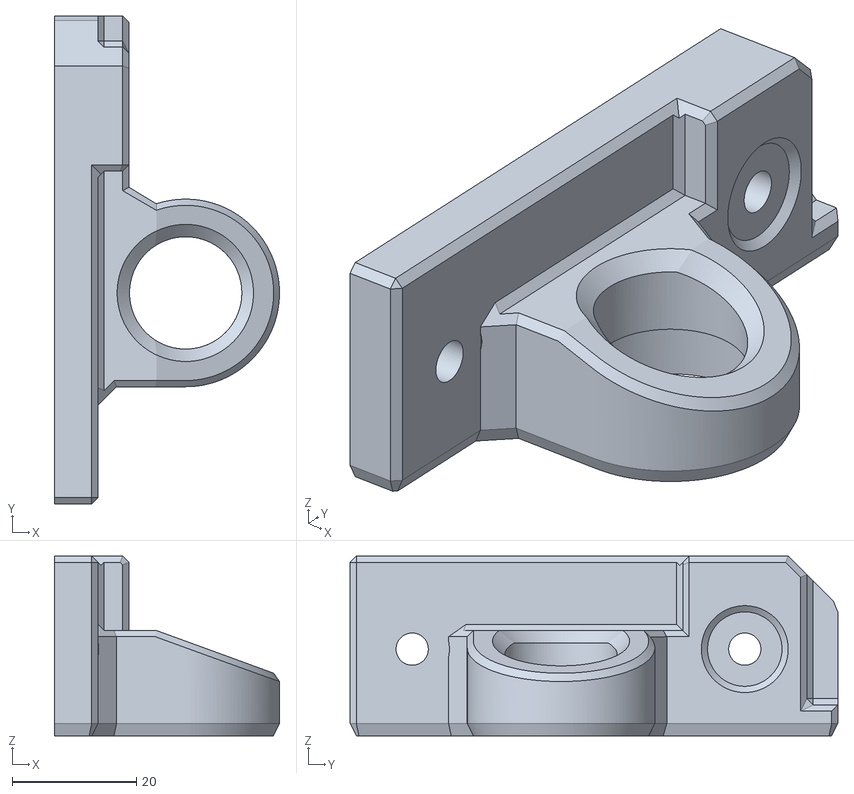
[picture p308: CAD file, 2023-10-13]
files/Components/ZR_V2.6/ZR2.6_BearingTopMount_FR_HighReach_Body.stl
36.3 x 78.6 x 29.0
