MirageC79/HevORT/files/Mods/guitartoys/berd_air_pump_mount/berd_air_pump_mount_bracket.stl

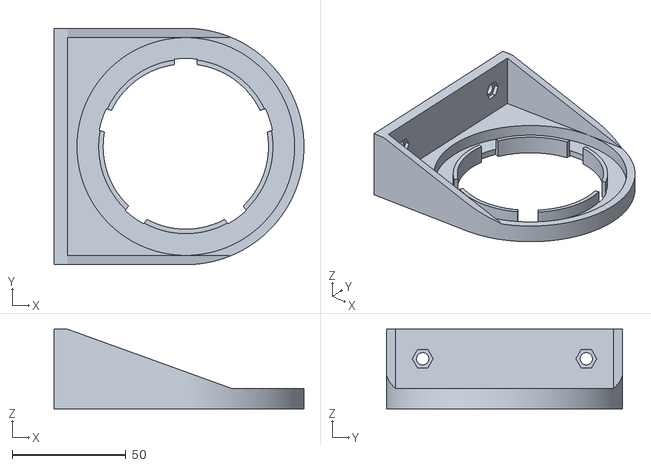
[picture p309: CAD file, 2022-09-28]
files/Mods/guitartoys/berd_air_pump_mount/berd_air_pump_mount_bracket.stl
110.0 x 104.0 x 35.0
