MirageC79/HevORT/files/Mods/guitartoys/duet3_mounting_bracket/Duet_Frame_Small_Part.stl

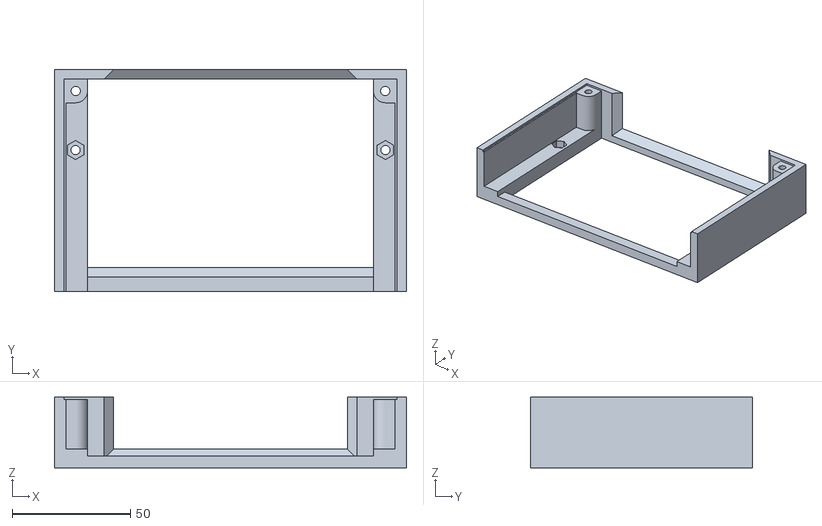
[picture p310: CAD file, 2022-09-28]
files/Mods/guitartoys/duet3_mounting_bracket/Duet_Frame_Small_Part.stl
149.0 x 93.8 x 30.0
