MirageC79/HevORT/files/Components/Enclosure/AcidBee_Enclosure/3030_PanelClip_Retainer_Side.stl

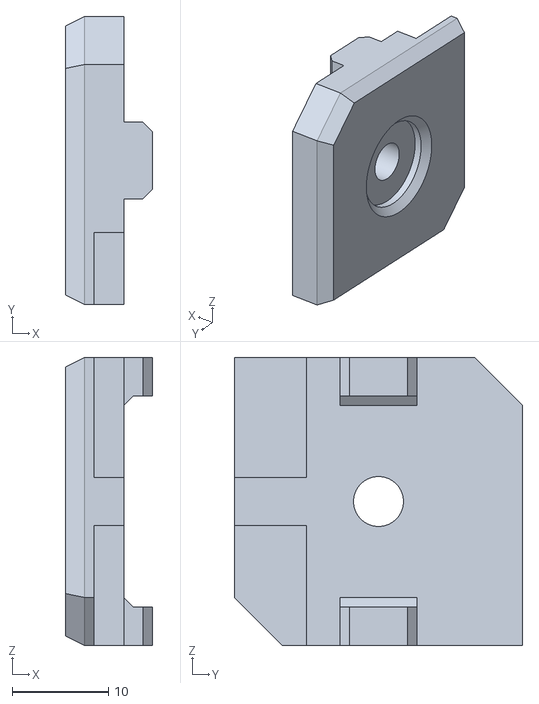
[picture p311: CAD file, 2024-01-21]
files/Components/Enclosure/AcidBee_Enclosure/3030_PanelClip_Retainer_Side.stl
9.10 x 30.0 x 30.0
