MirageC79/HevORT/files/Components/Enclosure/ElectronicBay/AcidBee_Enclosure/3030PanelClip_Intersection_V1.5.step

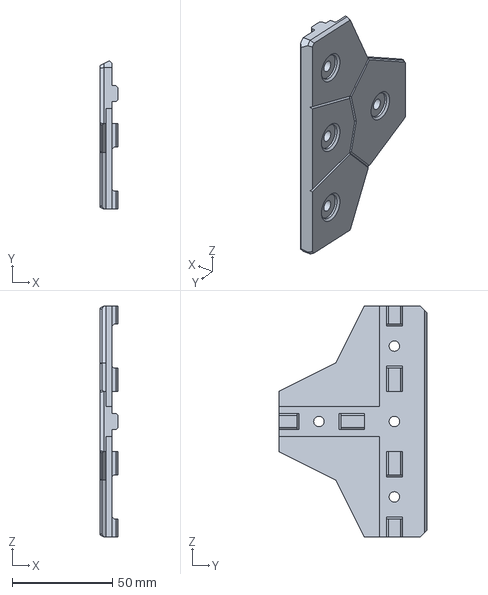
[picture p312: CAD file, 2022-12-05]
files/Components/Enclosure/ElectronicBay/AcidBee_Enclosure/3030PanelClip_Intersection_V1.5.step
9.10 x 74.0 x 115.3 mm
