MirageC79/HevORT/files/Components/Enclosure/ElectronicBay/BackCollar.stl

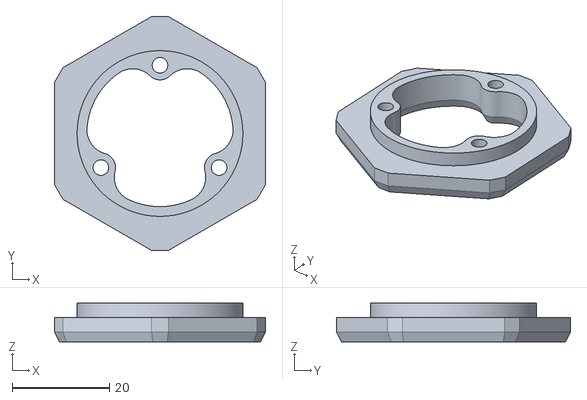
[picture p313: CAD file, 2022-02-25]
files/Components/Enclosure/ElectronicBay/BackCollar.stl
43.3 x 48.0 x 8.00
