MirageC79/HevORT/files/Components/Enclosure/TopLid/Handle_Lid.stl

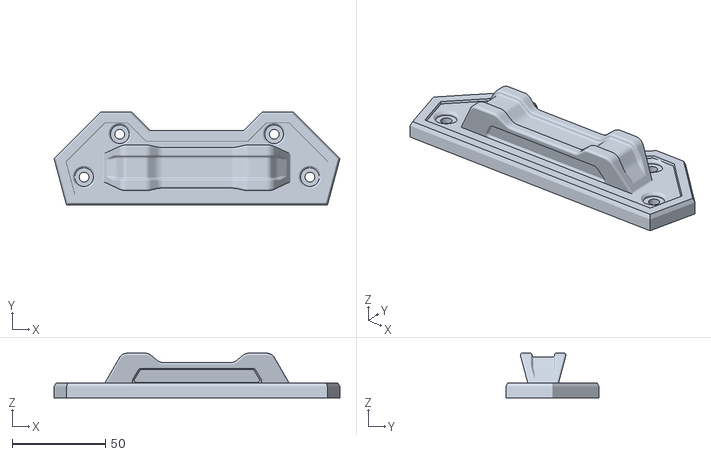
[picture p314: CAD file, 2024-02-24]
files/Components/Enclosure/TopLid/Handle_Lid.stl
153.4 x 50.0 x 24.0
