MirageC79/HevORT/files/Components/Enclosure/WaterCooling_Bay/Mounting_Spacer.stl

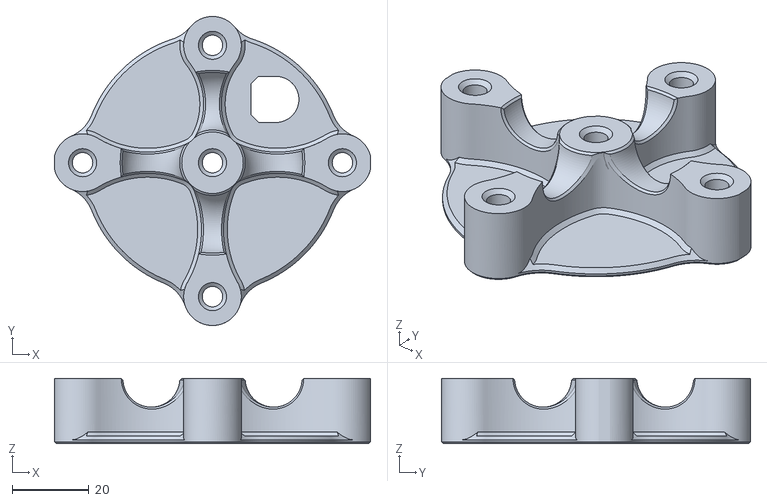
[picture p315: CAD file, 2023-09-26]
files/Components/Enclosure/WaterCooling_Bay/Mounting_Spacer.stl
82.3 x 80.4 x 17.0
