MirageC79/HevORT/files/Components/HD12/OPTION HD12CFx/HD12_CFx_MGN9_YCarriage_LH_UpperBody v2040.stl

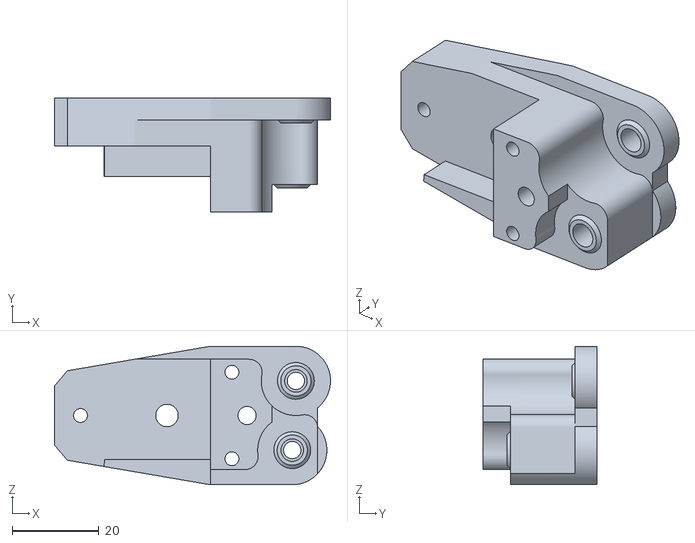
[picture p316: CAD file, 2021-09-20]
files/Components/HD12/OPTION HD12CFx/HD12_CFx_MGN9_YCarriage_LH_UpperBody v2040.stl
63.8 x 26.2 x 32.0
