MirageC79/HevORT/files/Components/HD12/OPTION HD12CFx_TopRail/XYHD12_CFx_TopRail_MGN9_YCarriage_LH_LowerBody v1.1.stl

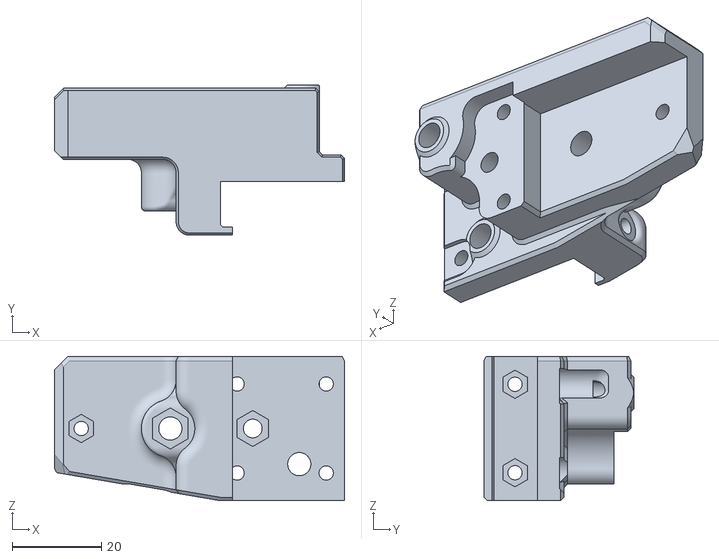
[picture p317: CAD file, 2023-07-24]
files/Components/HD12/OPTION HD12CFx_TopRail/XYHD12_CFx_TopRail_MGN9_YCarriage_LH_LowerBody v1.1.stl
65.1 x 33.8 x 32.4
