MirageC79/HevORT/files/Components/HD12/X_CarriageTest.stl

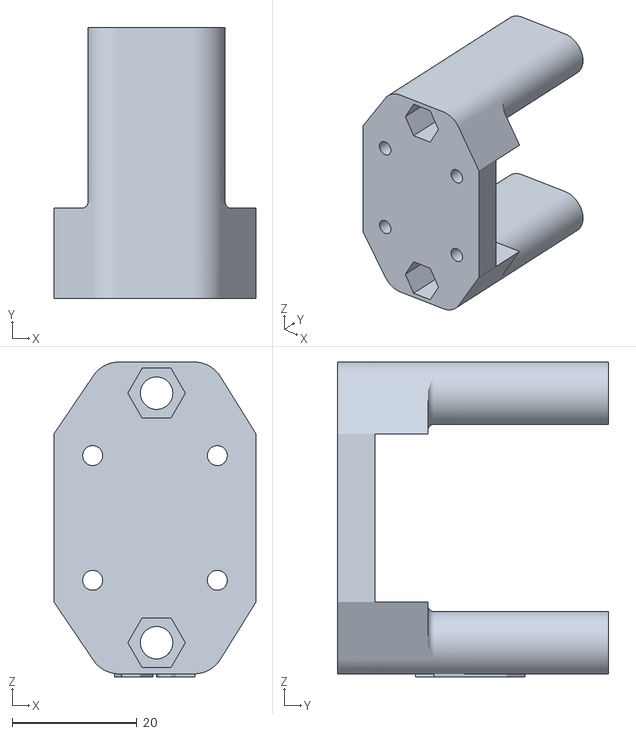
[picture p318: CAD file, 2020-11-18]
files/Components/HD12/X_CarriageTest.stl
32.4 x 43.5 x 50.5
