MirageC79/HevORT/files/Components/HD12_SPAWD/HD12_SPAWD_MotorMount_FR.stl

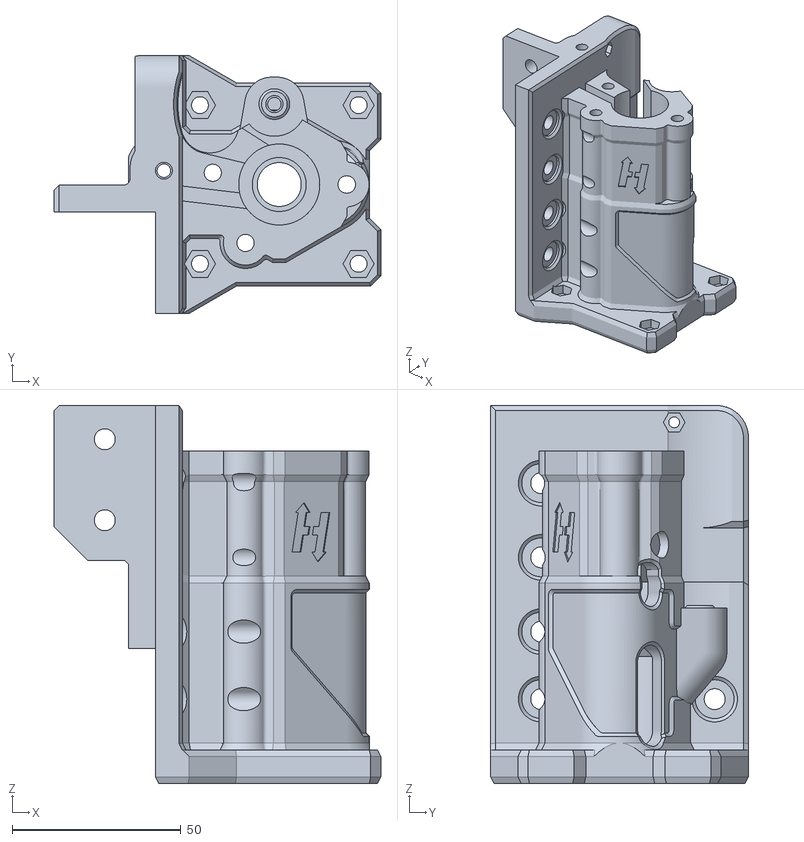
[picture p319: CAD file, 2023-10-26]
files/Components/HD12_SPAWD/HD12_SPAWD_MotorMount_FR.stl
96.8 x 76.4 x 112.0
