MirageC79/HevORT/files/Components/HevACS/315_340/HevACS_315_340_MidDuct.stl

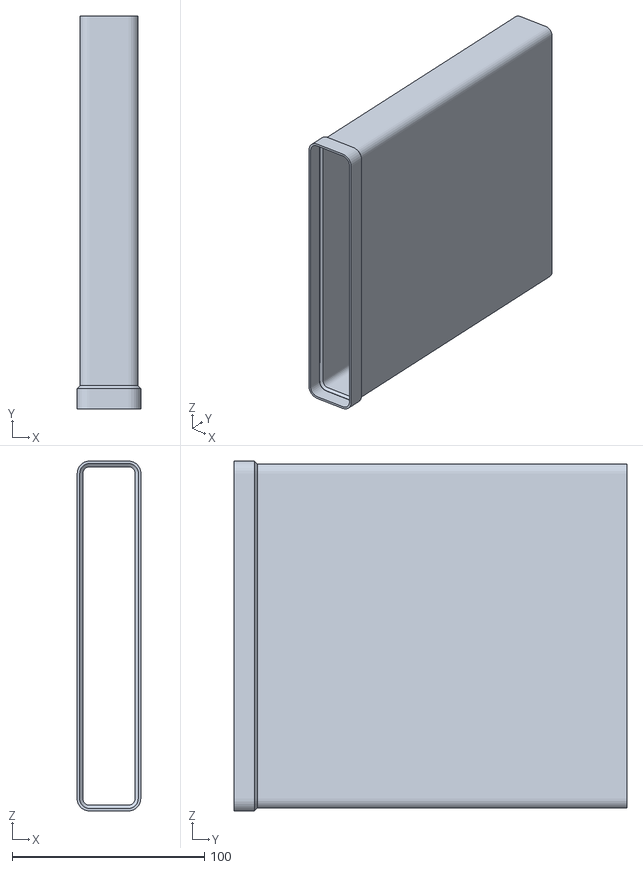
[picture p321: CAD file, 2021-07-09]
files/Components/HevACS/315_340/HevACS_315_340_MidDuct.stl
33.2 x 204.2 x 182.0
