MirageC79/HevORT/files/Components/HevACS/HevACS_120mm_SingleFanBracket_BETA.stl

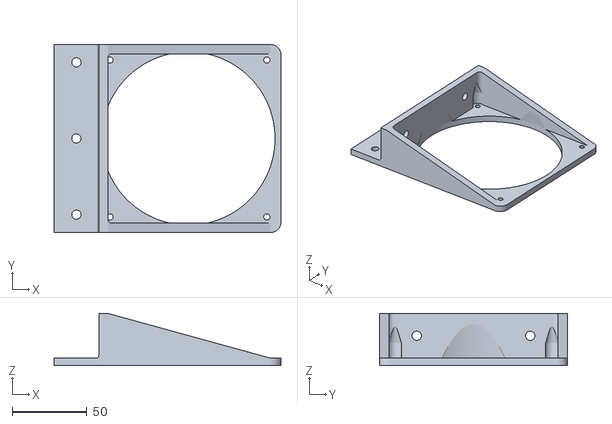
[picture p322: CAD file, 2020-11-02]
files/Components/HevACS/HevACS_120mm_SingleFanBracket_BETA.stl
152.0 x 126.0 x 35.0
