MirageC79/HevORT/files/Components/PrintHead/VezMetalPrintHead_HDx/CPAP clamp Body1.stl

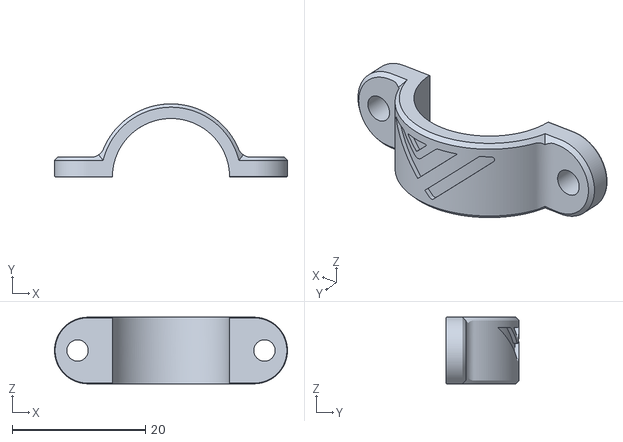
[picture p323: CAD file, 2023-11-16]
files/Components/PrintHead/VezMetalPrintHead_HDx/CPAP clamp Body1.stl
35.0 x 11.0 x 10.0
