MirageC79/HevORT/files/Components/XYHT/OPTION_CFX/HTCarbonX_InnerBlock.stl

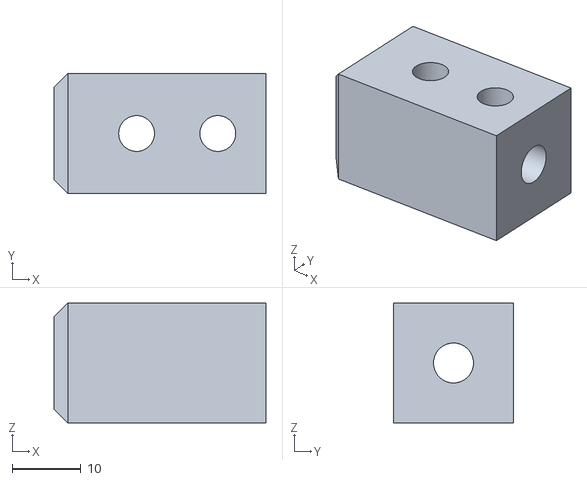
[picture p324: CAD file, 2021-08-18]
files/Components/XYHT/OPTION_CFX/HTCarbonX_InnerBlock.stl
30.8 x 17.4 x 17.4
