MirageC79/HevORT/files/Components/ZR_V2.8_DO NO TUSE/HevORT LOGO_Medium_Grey v2 v1.stl

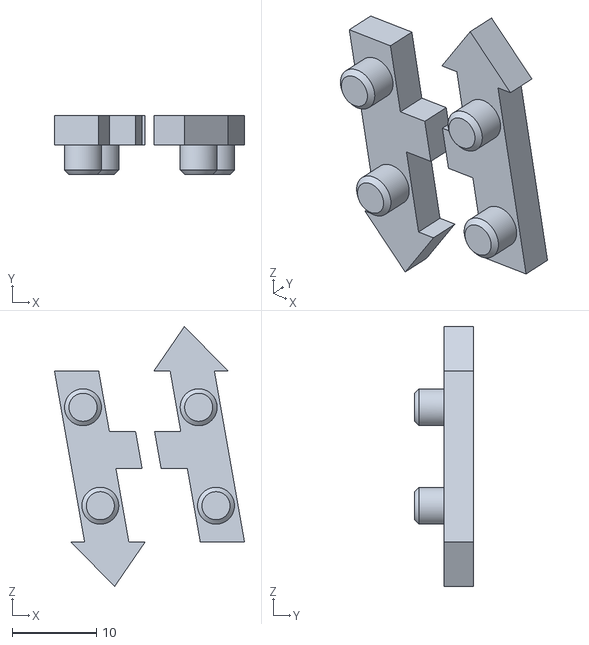
[picture p325: CAD file, 2022-01-18]
files/Components/ZR_V2.8_DO NO TUSE/HevORT LOGO_Medium_Grey v2 v1.stl
22.6 x 7.00 x 30.8
