MirageC79/HevORT/(list of files, cad)

Other CAD files:
files/Components/Enclosure/ElectronicBay/AcidBee_Enclosure/DoorBeam_Support_RH.stl
files/Components/Enclosure/ElectronicBay/OctopusProCasing/DINMountRight_V1.1HeatSinks.stl
files/Components/HD12/HD_NEMA17_AdapterPlate_RH_BodyV2.stl
files/Components/HD12/OPTION HD12CFx/HD12_CFx_MGN9_YEndStopFlag_v1.1.stl
files/Components/HD12_SPAWD/HD12_SPAWD_BeltTensioner_FL.stl
files/Components/HD9/Option_HD9_CFx/XYHD_CFx_YFlag_RH.stl
files/Components/HD9_10_SPAWD/HD10_SPAWD_BeltTensioner_FR.stl
files/Components/ZR_V2.6/ZR2.6_MotorMount_FL_Body_V1.2.stl
files/Mods/guitartoys/duet3_mounting_bracket/duet3_Bracket_with_fans.step
files/Components/HD12/OPTION HD12CFx_TopRail/HDxTop_VZPrintHead_XFlag.stl
files/Components/HD9/Option_HD9_CFx/XYHD9_CFx_YCarriage_LH_LowerBody v1.step
files/Components/XYHT/XYHT_YCarriage_LH_V2.5_Split_Upper.stl
files/Components/Enclosure/AcidBee_Enclosure/3030_PanelClip_Retainer.stl
files/Components/Enclosure/TopLid/Bracket_Lid_RH.stl
files/Components/Enclosure/WaterCooling_Bay/WaterCoolingBay_BracketClipRH.stl
files/Components/HD9/Option_HD9_CFx/XYHD_CFx_CFTube Insert v1.step
files/Components/HevACS/HevACS_120mm_515x540_MidDuct_BETA.stl
files/Components/PrintHead/VezMetalPrintHead_HDx/cable holder Vz.stl
files/Components/XYHT/OPTION_CFX/XYHT_MGN9CFX_YCarriage_RH_V2.5_UpperBody.stl
files/Components/ZR_V2.8_DO NO TUSE/ZR2.8_WobbleX_SliderMount_LH_Body_EXPERIMENTAL.stl
files/STL/HD9/Option_HD9_CFx/XYHD9_CFx_YCarriage_LH_LowerBody Beta.step
files/Components/Enclosure/ElectronicBay/OctopusProCasing/DINMountRight_Beta2.stl
files/Components/HD9/Option_HD9_CFx/XYHD9_CFx_YCarriage_LH_UpperBody v1.step
files/Components/HD9/Option_HD9_CFx_TopRail/XYHD_CFTube_MGN9_Insert v1.stl
files/Components/HD9_10_SPAWD/HD10_SPAWD_Cover_MotorMount_FL.stl
files/Components/HevACS/ForOleg/HevACS_Nozzle_515_RH_BETA.stl
files/Components/ZR_V2.6/ZR2.6_BearingTopMount_FL_HighReach_Body.stl
files/STL/HD9/Option_HD9_CFx/XYHD9_CFx_YCarriage_LH_UpperBody Beta.step
files/Components/Enclosure/AcidBee_Enclosure/3030PanelClip_Corner_V1.5.stl
files/Components/Enclosure/AcidBee_Enclosure/3030PanelClip_Intersection_V1.5.stl
files/Components/Enclosure/AcidBee_Enclosure/3030WireCover.stl
files/Components/Enclosure/AcidBee_Enclosure/3030WireCoverFaztek.stl
files/Components/Enclosure/AcidBee_Enclosure/Bowden_InletHD.stl
files/Components/Enclosure/AcidBee_Enclosure/Clip_DinRailMount.stl
files/Components/Enclosure/AcidBee_Enclosure/DoorBeam_Support_RH.stl
files/Components/Enclosure/AcidBee_Enclosure/DoorCorner.stl
files/Components/Enclosure/AcidBee_Enclosure/DoorHandleBody (Left).stl
files/Components/Enclosure/AcidBee_Enclosure/DoorHandleBody(Right).stl
files/Components/Enclosure/AcidBee_Enclosure/DoorHandleMagnetPlateLH.stl
files/Components/Enclosure/AcidBee_Enclosure/DoorHandleMagnetPlateRH.stl
files/Components/Enclosure/AcidBee_Enclosure/DoorHingeBackPlateA.stl
files/Components/Enclosure/AcidBee_Enclosure/DoorHingeBackPlateB.stl
files/Components/Enclosure/AcidBee_Enclosure/DoorHingeFlapperUpRH.stl
files/Components/Enclosure/AcidBee_Enclosure/DoorHingeFlapper_LowLH.stl
files/Components/Enclosure/AcidBee_Enclosure/DoorHingeFlapper_LowRH.stl
files/Components/Enclosure/AcidBee_Enclosure/DoorHingeFlapper_UpLH.stl
files/Components/Enclosure/AcidBee_Enclosure/DoorHingeMount.stl
files/Components/Enclosure/AcidBee_Enclosure/DoorLatch_MagnetHolder.stl
files/Components/Enclosure/AcidBee_Enclosure/Door_UpperMagnetHolder_LH.stl
files/Components/Enclosure/AcidBee_Enclosure/Door_UpperMagnetHolder_RH.stl
files/Components/Enclosure/AcidBee_Enclosure/DummyPin.stl
files/Components/Enclosure/AcidBee_Enclosure/EbayDoorHandleV2.stl
files/Components/Enclosure/AcidBee_Enclosure/EbayHandleBackPlateV2.stl
files/Components/Enclosure/AcidBee_Enclosure/Ebay_ButterFly_Hinge_LowLH.stl
files/Components/Enclosure/AcidBee_Enclosure/Ebay_ButterFly_Hinge_LowRH.stl
files/Components/Enclosure/AcidBee_Enclosure/Ebay_ButterFly_Hinge_UpLH.stl
files/Components/Enclosure/AcidBee_Enclosure/Ebay_ButterFly_Hinge_UpRH.stl
files/Components/Enclosure/AcidBee_Enclosure/Ebay_ButterflyHinge_BackPlateA.stl
files/Components/Enclosure/AcidBee_Enclosure/Ebay_ButterflyHinge_BackPlateB.stl
files/Components/Enclosure/AcidBee_Enclosure/PanelClip.stl
files/Components/Enclosure/AcidBee_Enclosure/PanelClipCorner.stl
files/Components/Enclosure/AcidBee_Enclosure/PanelClipHalf.stl
files/Components/Enclosure/AcidBee_Enclosure/PanelClipSide.stl
files/Components/Enclosure/AcidBee_Enclosure/PanelClip_Intersection.stl
files/Components/Enclosure/AcidBee_Enclosure/PlateLH_SN.step
files/Components/Enclosure/AcidBee_Enclosure/PlateLH_SN.stl
files/Components/Enclosure/AcidBee_Enclosure/PlateRH_Blank.stl
files/Components/Enclosure/ElectronicBay/AcidBee_Enclosure/3030PanelClip_Corner_V1.5.stl
files/Components/Enclosure/ElectronicBay/AcidBee_Enclosure/3030PanelClip_Intersection_V1.5.stl
files/Components/Enclosure/ElectronicBay/AcidBee_Enclosure/3030WireCover.stl
files/Components/Enclosure/ElectronicBay/AcidBee_Enclosure/3030WireCoverFaztek.stl
files/Components/Enclosure/ElectronicBay/AcidBee_Enclosure/Bowden_InletHD.stl
files/Components/Enclosure/ElectronicBay/AcidBee_Enclosure/Clip_DinRailMount.stl
files/Components/Enclosure/ElectronicBay/AcidBee_Enclosure/DoorCorner.stl
files/Components/Enclosure/ElectronicBay/AcidBee_Enclosure/DoorHandleBody (Left).stl
files/Components/Enclosure/ElectronicBay/AcidBee_Enclosure/DoorHandleBody(Right).stl
files/Components/Enclosure/ElectronicBay/AcidBee_Enclosure/DoorHandleMagnetPlateLH.stl
files/Components/Enclosure/ElectronicBay/AcidBee_Enclosure/DoorHandleMagnetPlateRH.stl
files/Components/Enclosure/ElectronicBay/AcidBee_Enclosure/DoorHingeBackPlateA.stl
files/Components/Enclosure/ElectronicBay/AcidBee_Enclosure/DoorHingeBackPlateB.stl
files/Components/Enclosure/ElectronicBay/AcidBee_Enclosure/DoorHingeFlapperUpRH.stl
files/Components/Enclosure/ElectronicBay/AcidBee_Enclosure/DoorHingeFlapper_LowLH.stl
files/Components/Enclosure/ElectronicBay/AcidBee_Enclosure/DoorHingeFlapper_LowRH.stl
files/Components/Enclosure/ElectronicBay/AcidBee_Enclosure/DoorHingeFlapper_UpLH.stl
files/Components/Enclosure/ElectronicBay/AcidBee_Enclosure/DoorHingeMount.stl
files/Components/Enclosure/ElectronicBay/AcidBee_Enclosure/DoorLatch_MagnetHolder.stl
files/Components/Enclosure/ElectronicBay/AcidBee_Enclosure/Door_UpperMagnetHolder_LH.stl
files/Components/Enclosure/ElectronicBay/AcidBee_Enclosure/Door_UpperMagnetHolder_RH.stl
files/Components/Enclosure/ElectronicBay/AcidBee_Enclosure/DummyPin.stl
files/Components/Enclosure/ElectronicBay/AcidBee_Enclosure/EbayDoorHandleV2.stl
files/Components/Enclosure/ElectronicBay/AcidBee_Enclosure/EbayHandleBackPlateV2.stl
files/Components/Enclosure/ElectronicBay/AcidBee_Enclosure/Ebay_ButterFly_Hinge_LowLH.stl
files/Components/Enclosure/ElectronicBay/AcidBee_Enclosure/Ebay_ButterFly_Hinge_LowRH.stl
files/Components/Enclosure/ElectronicBay/AcidBee_Enclosure/Ebay_ButterFly_Hinge_UpLH.stl
files/Components/Enclosure/ElectronicBay/AcidBee_Enclosure/Ebay_ButterFly_Hinge_UpRH.stl
files/Components/Enclosure/ElectronicBay/AcidBee_Enclosure/Ebay_ButterflyHinge_BackPlateA.stl
files/Components/Enclosure/ElectronicBay/AcidBee_Enclosure/Ebay_ButterflyHinge_BackPlateB.stl
files/Components/Enclosure/ElectronicBay/AcidBee_Enclosure/PanelClip.stl
files/Components/Enclosure/ElectronicBay/AcidBee_Enclosure/PanelClipCorner.stl
files/Components/Enclosure/ElectronicBay/AcidBee_Enclosure/PanelClipHalf.stl
files/Components/Enclosure/ElectronicBay/AcidBee_Enclosure/PanelClipSide.stl
files/Components/Enclosure/ElectronicBay/AcidBee_Enclosure/PanelClip_Intersection.stl
files/Components/Enclosure/ElectronicBay/AcidBee_Enclosure/PlateLH_SN.step
files/Components/Enclosure/ElectronicBay/AcidBee_Enclosure/PlateLH_SN.stl
files/Components/Enclosure/ElectronicBay/AcidBee_Enclosure/PlateRH_Blank.stl
files/Components/Enclosure/ElectronicBay/Din_Clip_BuckConverter12V.stl
files/Components/Enclosure/ElectronicBay/Duet2_DIN_TwinMount.stl
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
