MirageC79/HevORT/files/Components/PrintHead/VezMetalPrintHead_HDx/Tentacool_Spacers.md

The following spacer dimensions are required for different hotends in combination with the tentacool:

| Hot end | required spacer | STL file |
|---|---|---|
| Goliath Long | 16mm | HDx_VzPrintHead_TentacoolSpacer_GoliathLong.stl |
| Goliath Short | no spacer required | n/a |
| Phaetus Rapido 1 HF  | not compatible | n/a |

No values / files yet for the following hotends:

| Hot end | required spacer | STL file |
|---|---|---|
| e3d v6 | | |
| Phaetus Rapido 1 UHF | | |
