MirageC79/HevORT/docs/assets/images/components/HevORT_EntirePrinter.png

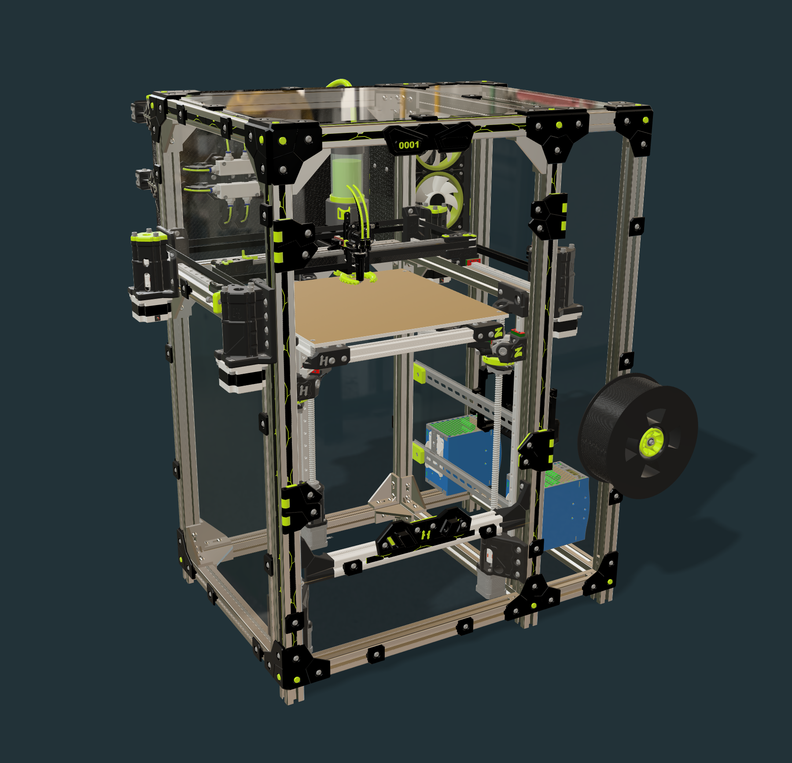
docs/assets/images/components/HevORT_EntirePrinter.png
