MirageC79/HevORT/docs/assets/references/firmware-settings/Custom_Print2Win_HextrudORT_XYPOS.png

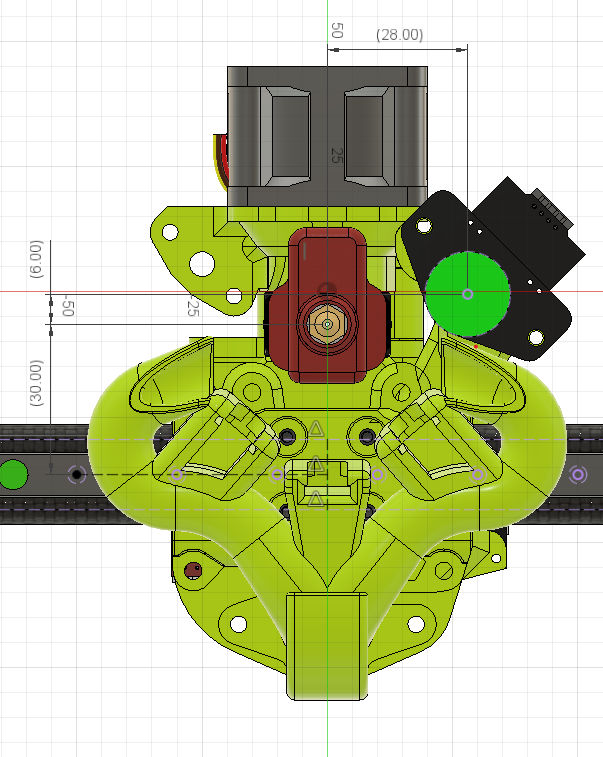
docs/assets/references/firmware-settings/Custom_Print2Win_HextrudORT_XYPOS.png
