MirageC79/HevORT/files/Components/Enclosure/WaterCooling_Bay/images/Watercoolingbay_printarea.png

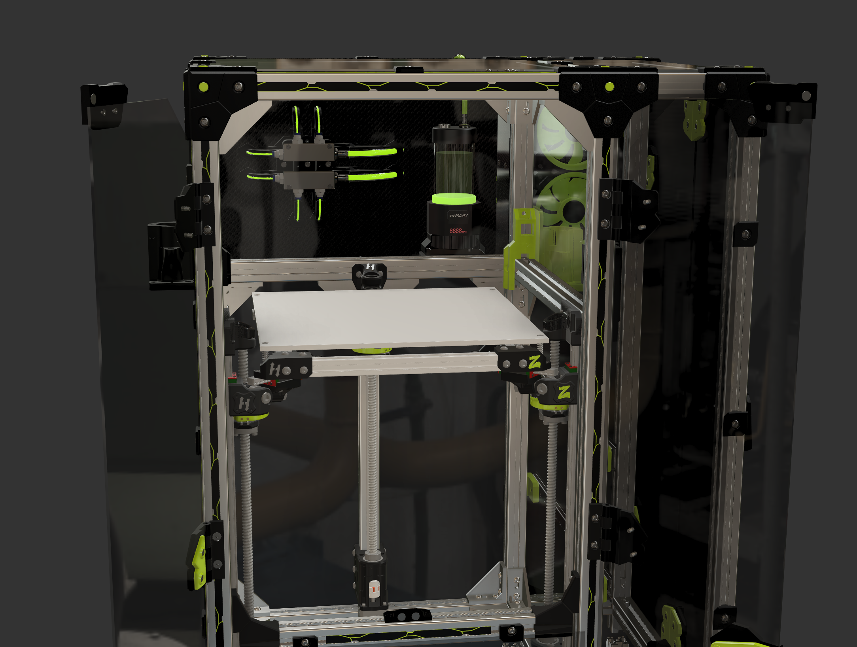
files/Components/Enclosure/WaterCooling_Bay/images/Watercoolingbay_printarea.png
