MirageC79/HevORT/files/Components/HD9/Option_HD9_CFx/XYHD9_CFx_Installation v7 copy.jpg

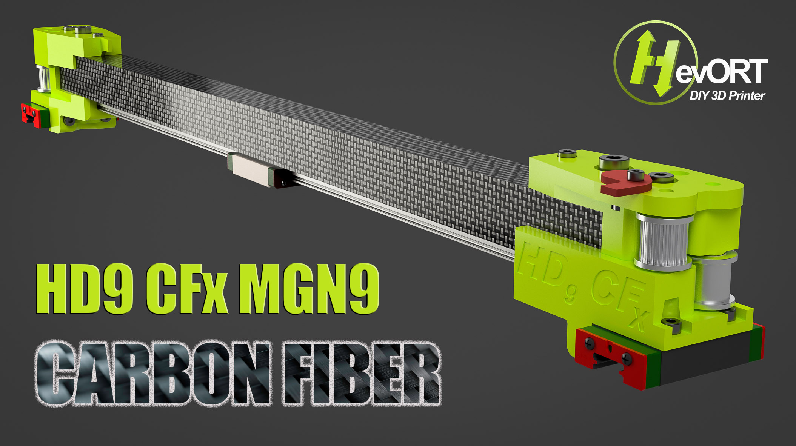
files/Components/HD9/Option_HD9_CFx/XYHD9_CFx_Installation v7 copy.jpg
