MirageC79/HevORT/files/Components/PrintHead/VezMetalPrintHead_HDx/IdlerCancelMod.png

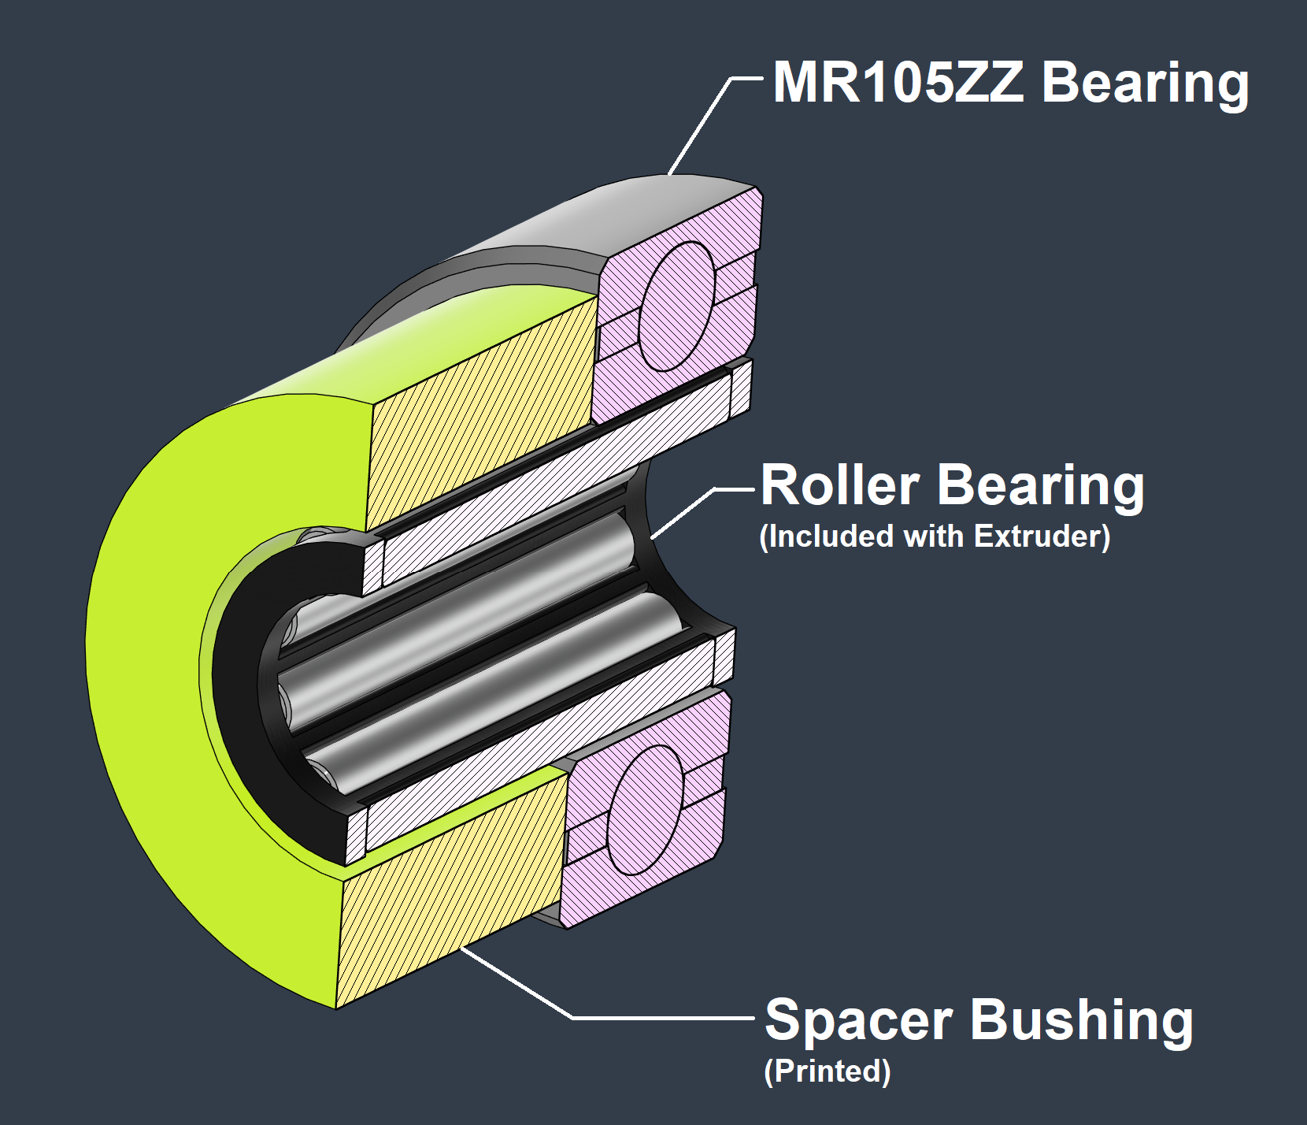
files/Components/PrintHead/VezMetalPrintHead_HDx/IdlerCancelMod.png
