MirageC79/HevORT/files/Components/XYSTD/images/XYSTD_V2.5_Installation v1.png

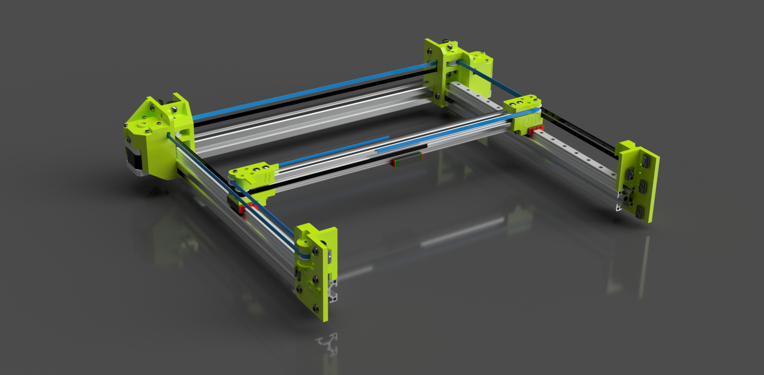
files/Components/XYSTD/images/XYSTD_V2.5_Installation v1.png
