MirageC79/HevORT/Instructions/build/electrical/Wiring_Bed_Duet3.png

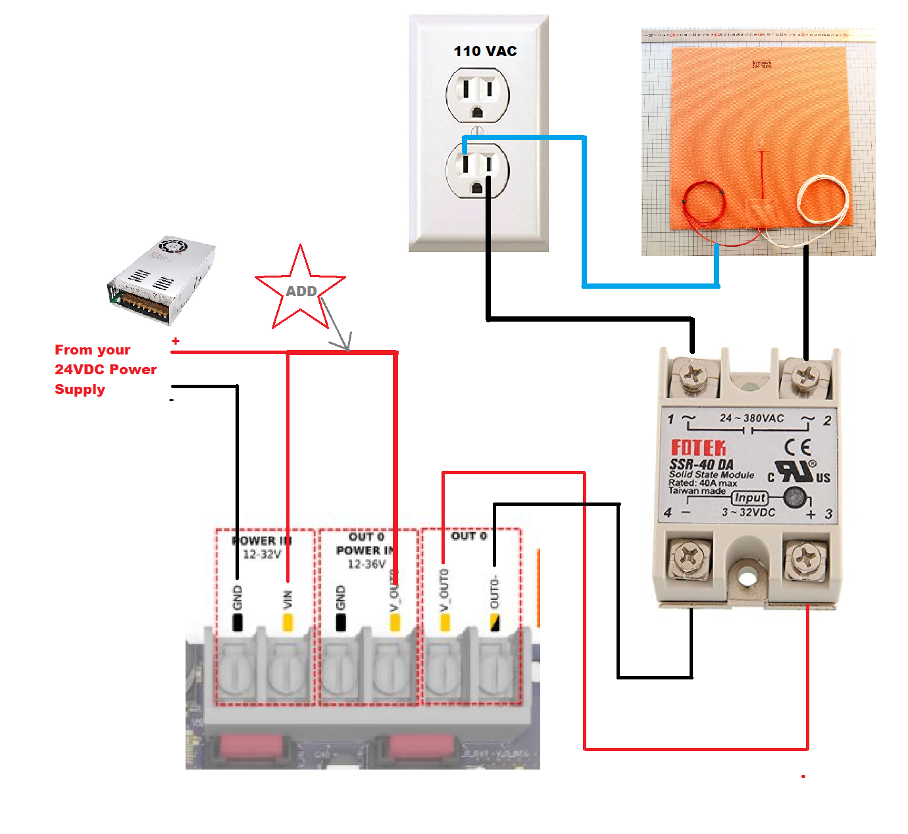
Instructions/build/electrical/Wiring_Bed_Duet3.png
