MirageC79/HevORT/Instructions/test_and_tune/Axis-Twist-Compensation-with-Klicky-Probe.pdf

## Klipper Axis Twist Compensaon with Klicky (or other detachable) Probe

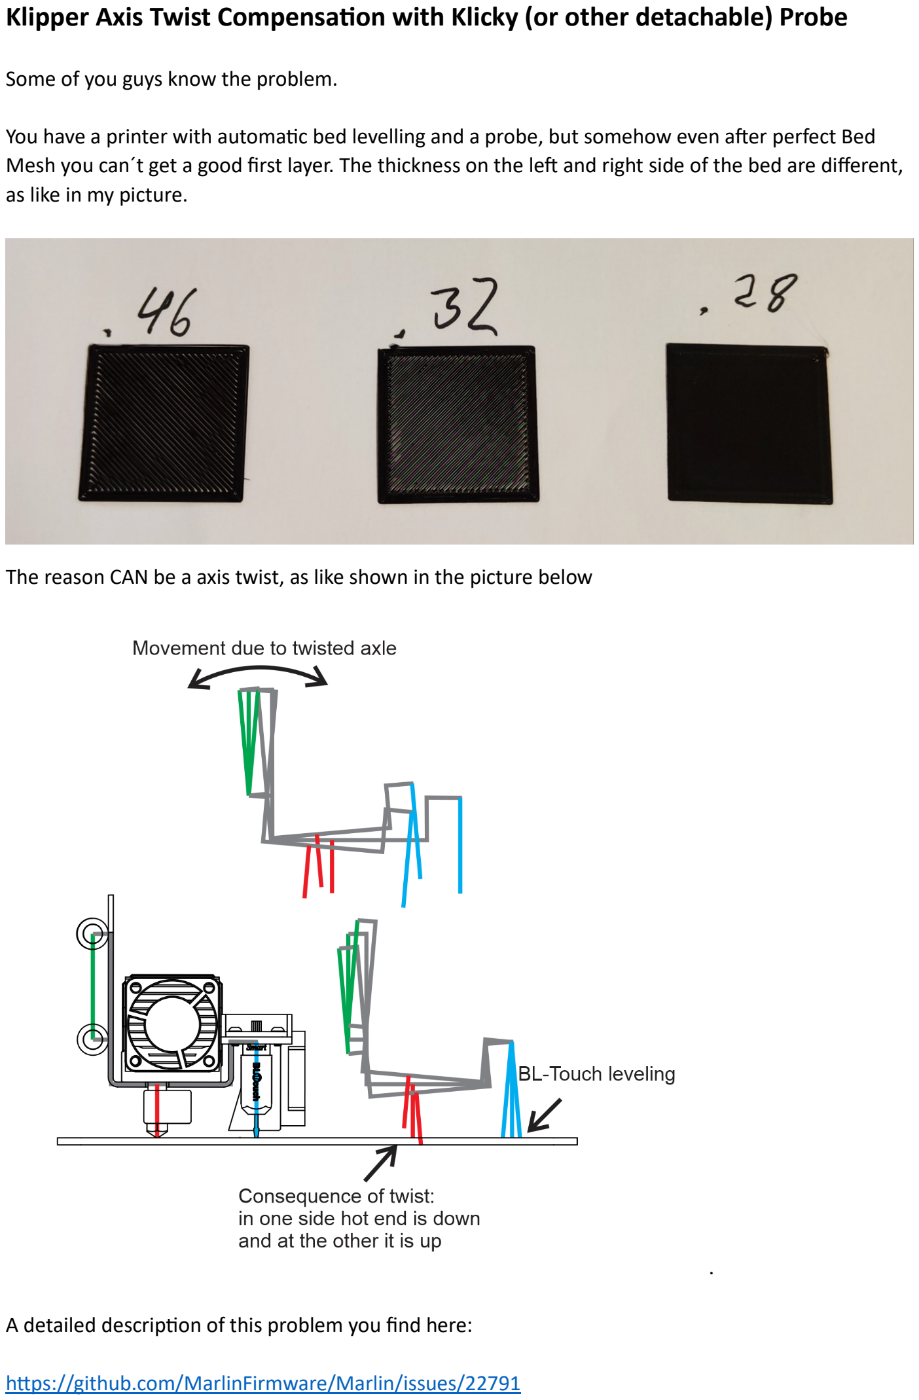
[picture p333: page 1]

Some of you guys know the problem.

You have a printer with automac bed levelling and a probe, but somehow even aer perfect Bed Mesh you can´t get a good first layer. The thickness on the le and right side of the bed are different, as like in my picture.

The reason CAN be a axis twist, as like shown in the picture below

A detailed descripon of this problem you find here:

htps://github.com/MarlinFirmware/Marlin/issues/22791

Unl August 2023 there was no way in Klipper to compensate this. Thanks the team, there is now a axis fix compensaon available. Only problem : not yet for users of detachable probes.

So I took a closer look to the manual and the process, you can find here: htps://www.klipper3d.org/Axis_Twist_Compensaon.html

## READ IT FIRST!

And I had a idea. There are a manual measuring and z offsret adjust with the paper method. What will happen, if I go down with the bed and measure at another height?

I did it, it worked and I´m sasfied with the result (see picture).

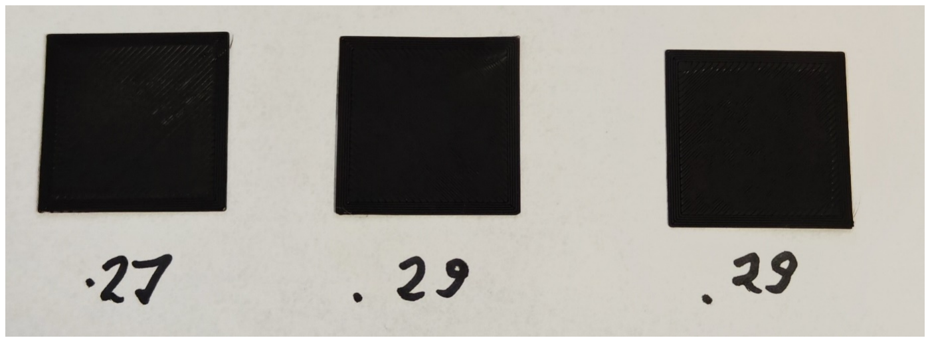
[picture p334: figure]

So, how to do it?

Step by step:

1. Get a parallel gauge block or a similar milled block in a height higher than your Z offset, and (if you want to «see» your result directly) a Edding.

Mark your block on the top.

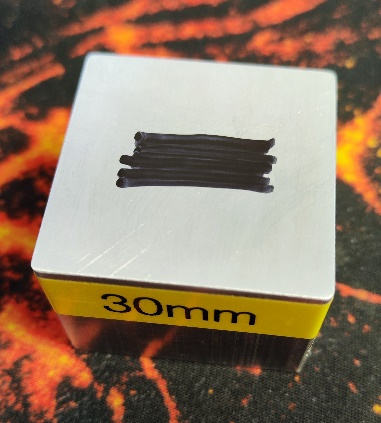
[picture p335: figure]
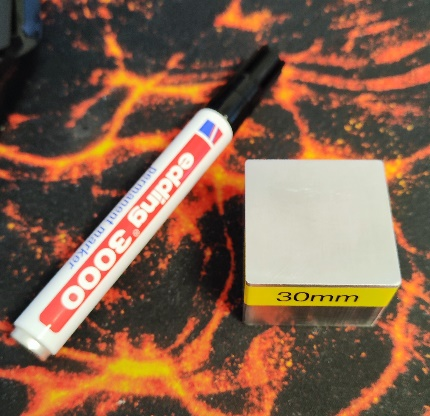
[picture p336: figure]

### 2. Now you have to edit your printer.cfg as described in the manual (add the

[axis_twist_compensaon]). In my .cfg it looks like this:

#__________________ Twist Compensaon _______________________ [axis_twist_compensaon]

speed: 100
horizontal_move_z: 30
calibrate_start_x: 10
calibrate_end_x: 405
calibrate_y: 100

horizontal_move_z should be the hight of your gauge block ! X and Y values should match your bed.

3. Save and restart your Firmware.
4. Now home your axis and adjust z-lt as usual.

### 5. Next step: atach&lock your probe. The command for klicky is

Atach_Probe_Lock

### 6. Start the process with the command

AXIS_TWIST_COMPENSATION_CALIBRATE

7. Follow the instrucons of the script and use your gauge block like a piece of paper. Carefully slice him below the nozzle back and forward and adjust the z height unl you see small scratches in the edding (I do it this way ; you also may do it without marking).

If you see the scratches, you reached the compensated height. Press ACCEPT. Repeat it unl the last posion.

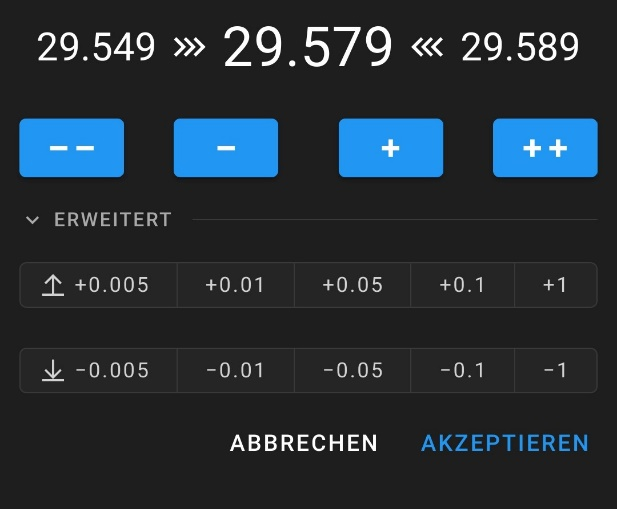
[picture p337: figure]
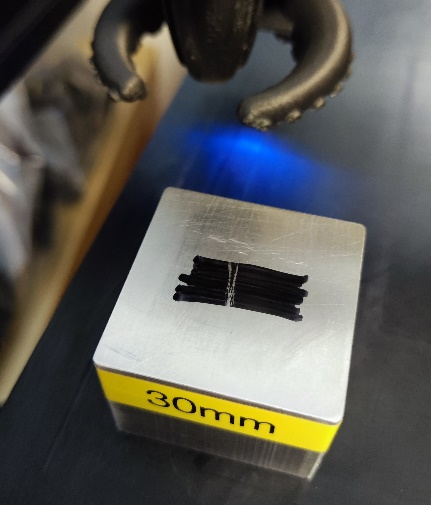
[picture p338: figure]

8. If the process is done – save config and restart. Congratulaon ! Your twist compensaon should work now! In the config now you should see something like this:

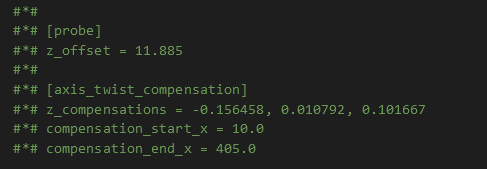
[picture p339: figure]

9. Make a bedlevel testprint and be happy.

By the way: if the result isn´t perfect, you can modify the values manually. As long I see, it is the nozzle offset in mm, so you can correct the height by hand later.

## Have a nice prinng experience!

_________________________________________________________________________________ Writen in horrible english by Holger Morgenstern, Switzerland
