MirageC79/HevORT/docs/pages/changelog.md

# Changelog

This pages lists all recent changes starting from the 15.08.2022 as of now.

* From newest to oldest

## 03.03.2023 - Documentation
- Added missing **printer-calibration** previously placed under ``/printercalibration.md``

## 24.10.2022 - Restructure Mods file location

## 21.08.2022 - Mods added
- Added **guitartoys**'s c920 camera door mount
  [>>Mod page<<](https://docs.hevort.com/#/pages/mods/mods?id=a-logitech-c920-camera-door-mount)
- Added **guitartoys**'s belt cover
  [>>Mod page<<](https://docs.hevort.com/#/pages/mods/mods?id=a-belt-cover)
- Added **guitartoys**'s berd air pump mount
  [>>Mod page<<](https://docs.hevort.com/#/pages/mods/mods?id=a-berd-air-pump-mount)
- Added **guitartoys**'s hemera berd air
  [>>Mod page<<](https://docs.hevort.com/#/pages/mods/mods?id=a-hemera-berd-air-nozzle)
- Added **guitartoys**'s duet 3 mounting bracket
  [>>Mod page<<](https://docs.hevort.com/#/pages/mods/mods?id=a-duet-3-mounting-bracket)

## 20.08.2022 - Documentation
- Add ability to define multiple images on an item

## 15.08.2022 - Mod added
- Added **guitartoys**'s Hextrudort Dragon Berd-Air mount.  
[>>Mod page<<](https://docs.hevort.com/#/pages/mods/mods?id=a-hextrudort-dragon-berd-air-mount)

## 15.08.2022 - Documentation
- Changelog file added
