MirageC79/HevORT/(threads)

Thread 6 (2021-04-08):

HD9 and HD12 Suggestion: Allow pullies/idlers with wider flanges.

Megamannen, 2021-04-08:
The HD9 and HD12 BOM (and printed parts) use an E3 specified idler and pullies that have a flange diameter of 15mm

The STD version uses pulleys with a 18mm flange

A lot of vendors have the 9/10mm width and 12mm pulleys with the flange size 18mm, they doesn't fit, seems to be missing 0.5-1.5mm clearance (have not tested all locations)

MirageC79, 2021-11-23:
As of the the official design makes use of the Gates specifications for pulleys.  You can try to modify the CADs to suit your needs.

Closed 2021-11-23.

Thread 7 (2021-04-26):

Non-parametric cad

ShirdelY, 2021-04-26:
I downloaded the cad for the hevort from fusion 360, and there's inconsistency in the files where some of them are parametric and some are not, such as the frame and z axis rails and screws, but not the heated bed.

MirageC79, 2021-11-23:
Yes, that is correct, some of there are and unfortunately some of them are not.

Closed 2021-11-23.

Thread 9 (2021-10-06):

Not really important issue: NEMA mispelled on LDO-57STH41-2804MACHEV_RevA.pdf

The-Monkey-King, 2021-10-06:
In the upper left hand section, "Laser engraving," NEMA is misspelled on the face of the motor.

MirageC79, 2021-10-06:
Yes, thank you we are aware.  Supplier has corrected manufacturing but not documentation.  Nothing we can change as of now.

Closed 2021-11-23.

Thread 11 (2022-03-10):

DIN Rail dimensions

dreedijk, 2022-03-10:
Hi MirageC,
I have printed the parts and everything fits nicely together and looks great! Well done!
What is the DIN rail you used? While all the parts fit well together, the box does not fit on the DIN rail. It is a commonly used 35mm wide rail (DIN rail TS35x7.5).
The clips are too small, I need to apply extreme force to even get close. Any harder and it will break.
Dave

MirageC79, 2022-03-11:
Hi, thanks for the feedback.
The distance between notches is 35mm flat. The best way to install is to engage the springy tab first then slightly stretch it to reach the other one.  I have a few of these clips and they work great so far.

dreedijk, 2022-03-11:
That does work (you have some extra leverage), but it is still a very tight fit :-)
I'm used to apply DIN clips from the top down.

Thread 12 (2022-03-24):

STL Files

bcrazycramer, 2022-03-24:
The link to the STL files is broken.

MirageC79, 2023-03-08:
Fixed

Closed 2023-03-08.

Thread 19 (2022-04-12):

Synchronize required cutouts in panels for XY mounts (front pulleys, motor mounts)

PStibbons2K, 2022-04-12:
Hi Olivier,

currently the panels for the different XY variants (Std, HT, HD) all require different sizes for the cutouts - to be able to use the same panels for all variants would be really nice!

I think the largest cutout is needed for HD12, on the left pulley the lower edge is flush with the extrusion - STD und HT variants both use more on the left side.

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

i could try to redesign the left pulley mount for the STD variant :)

Kind regards,
Martin

MirageC79, 2022-04-12:
Yes, that is a good point.  I thought of this at one point and was teared between functionality and interchangeability.  Perhaps an adapter plate of filler contour of some sort with provision holes in the smallest designs.   Keep me posted on your proposal ;)

PStibbons2K, 2022-04-12:
First idea for the footprint of the front pulley mounts would be something like this:

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

I'll try and trace the belt paths for the different variants tomorrow, maybe even a unified pulley mount with an adapter for the different belt paths would be possible :)

PStibbons2K, 2022-04-13:
If i got the different belt paths correct a unified pulley mount should be possible:

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

Above and below the belts there is enough room for a secure mount :)

PStibbons2K, 2022-04-19:
How about moving the Y Sensor bracket to the right pulley mount? That would simplify the wiring for the probe.

My prototype is still under development, at least the sketch on paper is taking form!

PStibbons2K, 2022-04-23:
Not quite there - but the basic idea would be to have a unified mount attached to the frame and custom cartridges for the different XY-Versions.

The mounting holes around the opening are for M4 heat inserts (this kind or similar: https://www.amazon.de/dp/B07YSV66Y5 ) to mount the cartridges.

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

MirageC79, 2023-03-08:
As we are looking at the next version of the HevORT, this is something that we will consider.  But for now, there are no plan to modify existing release to harmonize their footprint on enclosure panel.

Thank you.

Closed 2023-03-08.

Thread 21 (2022-04-13):

Electronics BOM misplaced download icon

WallK, 2022-04-13:
On https://docs.hevort.com/#/pages/component-selection?id=_4-electronics :

AR: Download icon on "BOM - Web" button
ER: Download icon on "BOM Download" button

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

MarvinBeym, 2022-04-13:
I don't see a misplaced icon

Closed 2022-04-13.

Thread 22 (2022-04-13):

Wrong URL on EMF Calculator button

WallK, 2022-04-13:
On http://docs.hevort.com/#/pages/useful-stuff/links?id=external :

AR: Clicking on **EMF Calculator** button redirects to http://retractioncalibration.com/
ER: Clicking on **EMF Calculator** button redirects to EMF Calculator site

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

Closed 2022-04-13.

Thread 34 (2022-08-07):

HD12: Right Motor mount sticking out of the case

PStibbons2K, 2022-08-07:
Hey Mirage,

found an issue with the right motor mount for the HD12 gantry - the mount is sticking out from the rear of the case, in the AcidBee CAD-File there seems to be a variant that stays inside the case - is there an update for HD12 missing?

Thanks a lot!

Kind regards,
Martin

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

MirageC79, 2022-08-09:
Hello Martin, thanks for highlighting this issue.  I have exported the modified CAD file from Acid Bee to STL here:
https://github.com/MirageC79/HevORT/blob/master/files/STL/HD12/HD12_MotorMount_RH_ForEnclosure_BodyV1.5.stl

Thank you

Closed 2022-08-09.

Thread 42 (2023-02-07):

Recipe for Printer Calibration

twistedbeholder, 2023-02-07:
http://docs.hevort.com/#/printercalibration is not a valid link

MarvinBeym, 2023-03-03:
Why would it?

twistedbeholder, 2023-03-03:
Because it is on your documentation page and just goes to an error page.

This email and any files transmitted with it are confidential and intended
solely for the use of the individual or entity to whom they are addressed
by Frank Leach. If you have received this email in error please notify the
system manager. This message contains confidential information and is
intended only for the individual named by Frank Leach. If you are not the
named addressee you should not disseminate, distribute or copy this e-mail.
Please notify the sender immediately by e-mail if you have received this
e-mail by mistake and delete this e-mail from your system. If you are not
the intended recipient you are notified that disclosing, copying,
distributing or taking any action in reliance on the contents of this
information is strictly prohibited.  If you are any member of any
government you are assessed a fee of $1,000,000.00 in gold bullion each
time this information is opened, viewed, used, referenced, or thought about
in any way. Please contact Frank leach at ***@***.*** for
shipping instructions.

"There is no such thing as a little freedom. Either you are all free, or
you are not free."

- Walter Cronkite

On Fri, Mar 3, 2023 at 10:33 AM Marvin Beym ***@***.***>
wrote:

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

MarvinBeym, 2023-03-03:
where is it mentioned?

MarvinBeym, 2023-03-03:
Found it: https://github.com/MirageC79/HevORT/blob/34970d0e283402a5e1a50d451e5098ccbe7e8860/docs/pages/how-to-print-parts.md

Closed 2023-03-07.

Thread 43 (2023-02-12):

ZR2.6 WobbleRing SFU1204 LowerDisc V1 - does not fit all ball screw nuts which exist in 24mm too

finalstage, 2023-02-12:
The inner diameter of the LowerDisc where the ball screw should fit in is 22mm. But ball screw nuts with a 24mm diameter are also very common, especially the better rated ones (C5, ...).
There is not much room but maybe the design could be adapted, at least in a second version to fit the 24mm ball screw nuts. Would like to avoid fixing the stl :-D
Thanks

MirageC79, 2023-02-16:
Thanks for the feedback.  I have added a note to the ZR2, ZR2.5 and ZR2.6 BOMs for the need of a 22mm diameter nut.  I will see if I can revise the design at a later time.  I am leaving this item as a reminder to myself.
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

Thread 44 (2023-02-28):

STP file for wobblex

termlimit, 2023-02-28:
Looking for a cad file for the WS12 WobbleX. I may have missed it, but I don't see it anywhere in the cad file. The CAD file contains the 3d printed version. Thank you!

MarvinBeym, 2023-03-03:
WobbleX is closed source

termlimit, 2023-03-03:
Was not aware of that, but an STP or stl could be provided. Anything to suffice for modelling purposes.

MirageC79, 2023-03-07:
Printable version of wobble rings is included in the CAD for 2.6.  WobbleX files are not available.

Closed 2023-03-07.

Thread 50 (2023-11-25):

Carriage Mounting Screws on the Metal Printhead

O-to-the-o, 2023-11-25:
According to the VZ Documentation for the Mellow Metal Printhead [VZ Documentation for the Mellow Metal Printhead ](https://github.com/VzBoT3D/Vz-Printhead-CNC/tree/main/Instructions)used in this
[Vez Metal Print Head & Goliath SHORT](https://hotmail114573.autodesk360.com/g/shares/SHd38bfQT1fb47330c996f6ad64dd2a993e2) and this [Vez Metal Print Head & Goliath LONG](https://hotmail114573.autodesk360.com/g/shares/SHd38bfQT1fb47330c99cf72fbff5c6debe4) cad model should be 5mm or 4mm I'd reccomend to change it to 4mm as the kit comes with 4 of them

MirageC79, 2024-04-04:
CAD files for both versions have been fixed.  Screw attaching the print head to the MGN9 block have been replaced by M3X4mm ultra low profile heat cap screws.
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

Closed 2024-04-04.

Thread 51 (2024-01-20):

Add Diameter for the Dowel Pins for the Acid Bee Enclousre in BOM and CAD

O-to-the-o, 2024-01-20:
The Diameter for the Dowel pin is missing in the BOM and CAD file (here only in nameing the part)
https://docs.hevort.com/bom/BOM_Enclosure_AcidBee.htm

For now Dowel pins need to be 60mm*5mm

MirageC79, 2024-01-22:
Thanks for reporting 😊
Change has been made to BOM
Closing Ticket.
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

Closed 2024-01-22.

Thread 52 (2024-01-23):

ZR2.6 collision with 3060 FrameBracket

MirageC79, 2024-01-23:
Need to replace the double bracket for a single one.

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

Thread 53 (2024-02-04):

ZR2.6 Motor Mounts - Rear facing M6 attaching to 3030 are shifted outwards by 1.705mm

MirageC79, 2024-02-04:
## Problem:
I have been chasing the root cause of this shift in the CADs and I am going all the way back to the ZR2.8 which was the basis for these motor mounts and the issue is also present.
I am surprised that I have not came across this issues when assembling my printer and that no one reported this before today.  Good catch @steffen12345 !
This situation is present on both FrontLeft and FrontRight ZR2.6 Motor mounts.  Rear unit is not affected.

## Corrective action plan
I will be correcting the files today and re-issue STLs with corrected dimensions.  I will post the update here and on FB.

## Meanwhile (Recommendation)
**If you already printed those parts:**
I recommend that you're-drill the holes a bit bigger to facilitate the installation.  Make sure that both reference surfaces are sitting flush to the 3030 extrusions during installation.

**If your printer is assembled (As it is the case for mine):**
The impact of this shift is very limited on the overall assembly.  Especially with WobbleX.  I recommend you leave as is.

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

MirageC79, 2024-02-05:
Issue corrected.
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

- CAD corrected: https://a360.co/44C6QRo
- STLs corrected: https://github.com/MirageC79/HevORT/commit/efc3c2330fea5cdd8b3b7321b11aadc37d5b7758

Closed 2024-02-05.

Thread 54 (2024-02-12):

Priline PC-CF not suitable for HevORT parts

MirageC79, 2024-02-12:
**From M3NT8L (Discord):**

Just shared this in the facebook group, thought Id double down here. Priline PC-CF is not good for our machine parts. Its been shared many times, but a reminder for anyone new is good. This is what I ended up with after a year of printing with my second machine (these pics are a couple years old now)
Even the air pump mount in the electronics bat at only maybe 40 deg max went wet noodle.

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

Thread 56 (2024-04-12):

XY STD and HT V2.5 Split carriage will need a Shorter X Axis

MirageC79, 2024-04-12:
The newer style split carriage used in the XY 2.5 version of STD and HT have thicker section between pulleys and X corss member.  For that reason, a revised X cross member needs to be included in the BOM and the frame calculator.

A 315mm build will require a 420mm long X cross member (was 431 per calculator).

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

Thread 57 (2024-06-10):

[SPAWD HD12] Bad clearance on idler shafts MotorMount_FR and MotorMount_FL

pedep, 2024-06-10:
Both the FR and FL motor mounts have (what i assume to be) bad clearance for the inner idler shaft holes. Every other idler shaft hole has r=2.55, except for the two with r=2.50

This makes inserting the pins impossible without a press

HD12_SPAWD_MotorMount_FL.stl
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

HD12_SPAWD_MotorMount_FR.stl
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

Meanwhile the RR, RL, motor covers and tensioners have better clearance
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
