MirageC79/HevORT/files/Components/PrintHead/VezMetalPrintHead_HDx/VZ_MetalPrintHead Hardware Map.pdf

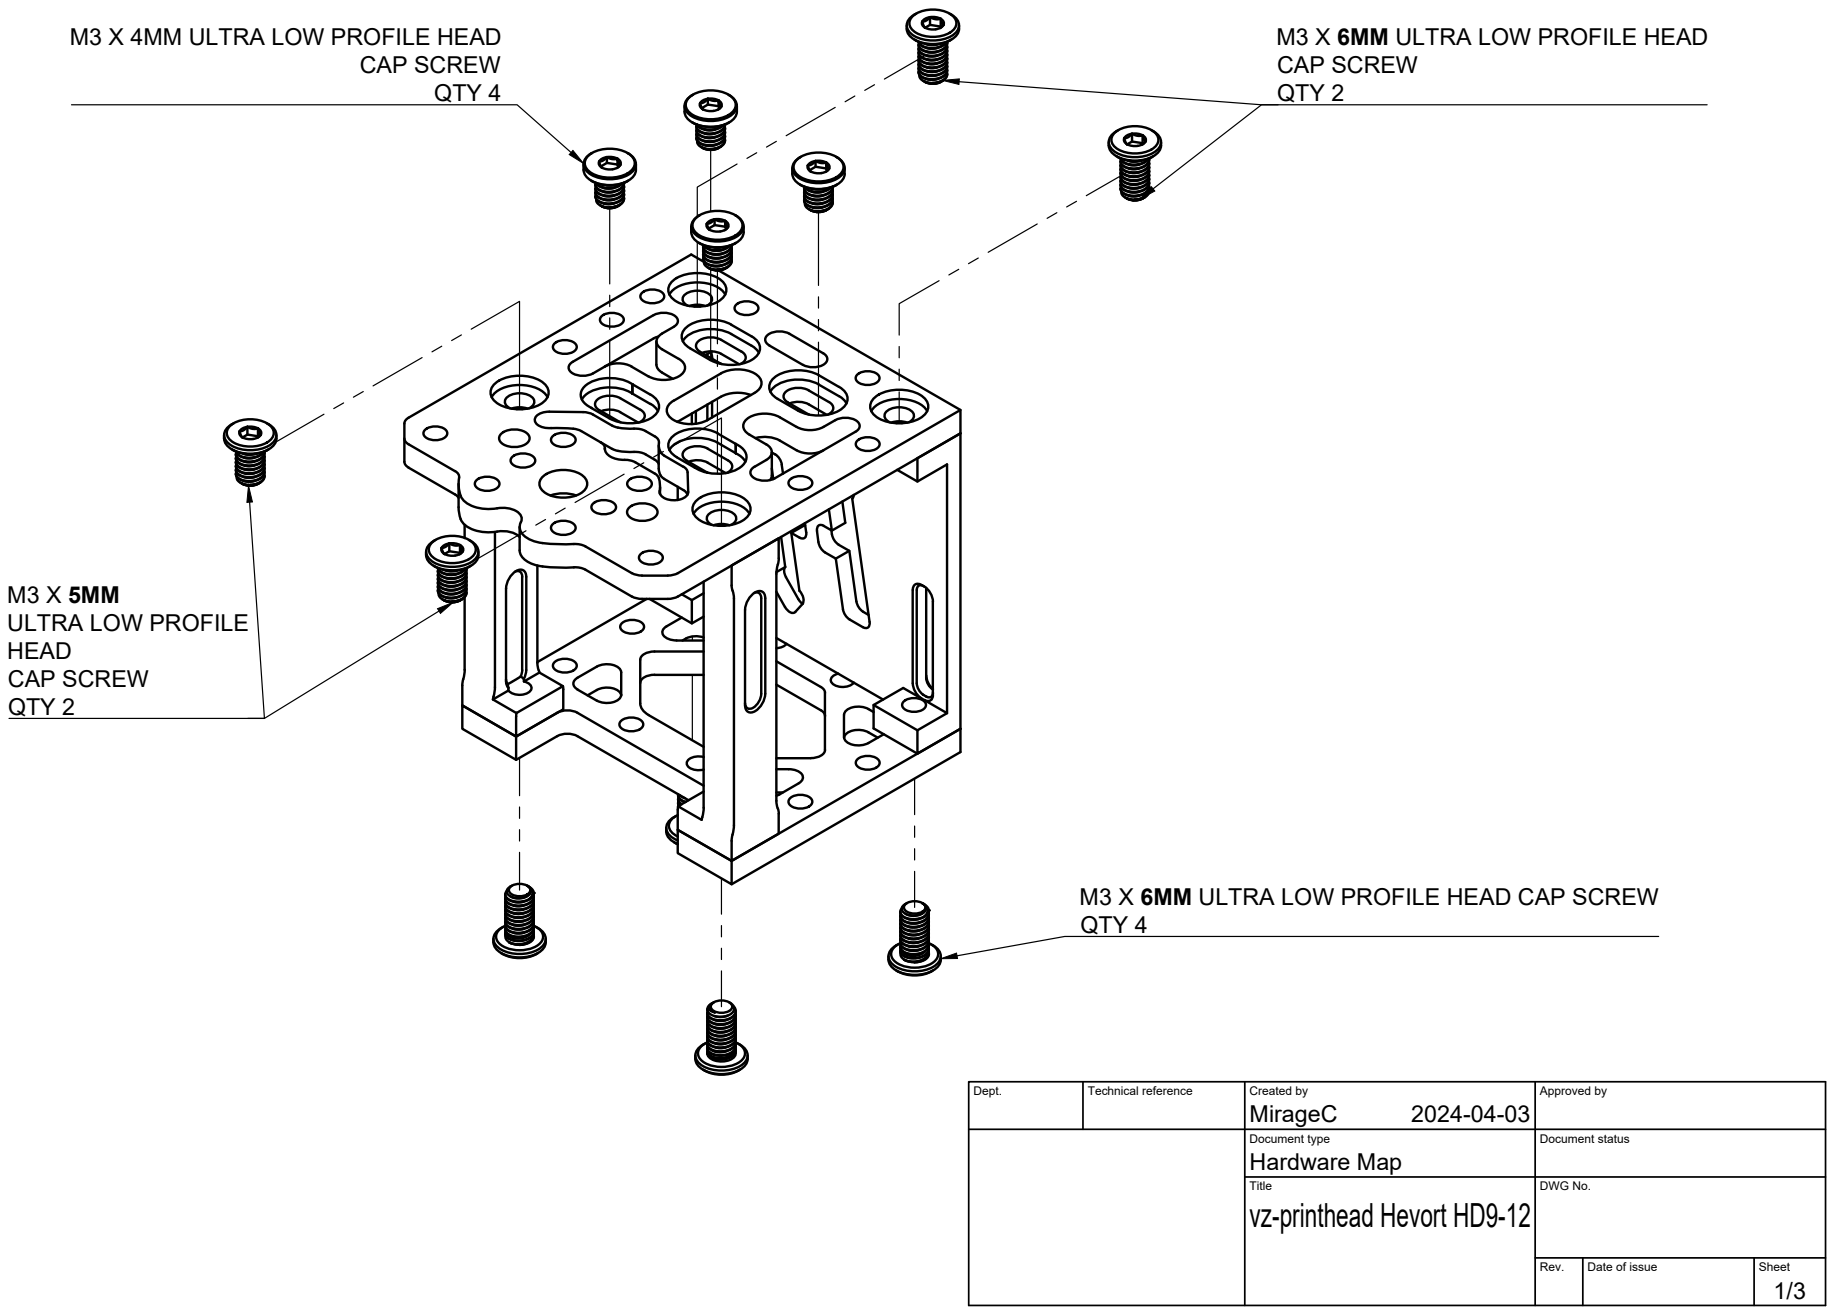
[picture p340: page 1]
M3 X 5MM ULTRA LOW PROFILE; CAP SCREW QTY 2; CAP SCREW QTY 4

M3 X 4MM ULTRA LOW PROFILE HEAD

M3 X 6MM ULTRA LOW PROFILE HEAD
CAP SCREW
QTY 2

M3 X 6MM ULTRA LOW PROFILE HEAD CAP SCREW
QTY 4

Dept. | Technical reference | Created by MirageC 2024-04-03 | Approved by

Document type Hardware Map | Document status

Title vz-printhead Hevort HD9-12 | DWG No.

Rev. | Date of issue | Sheet

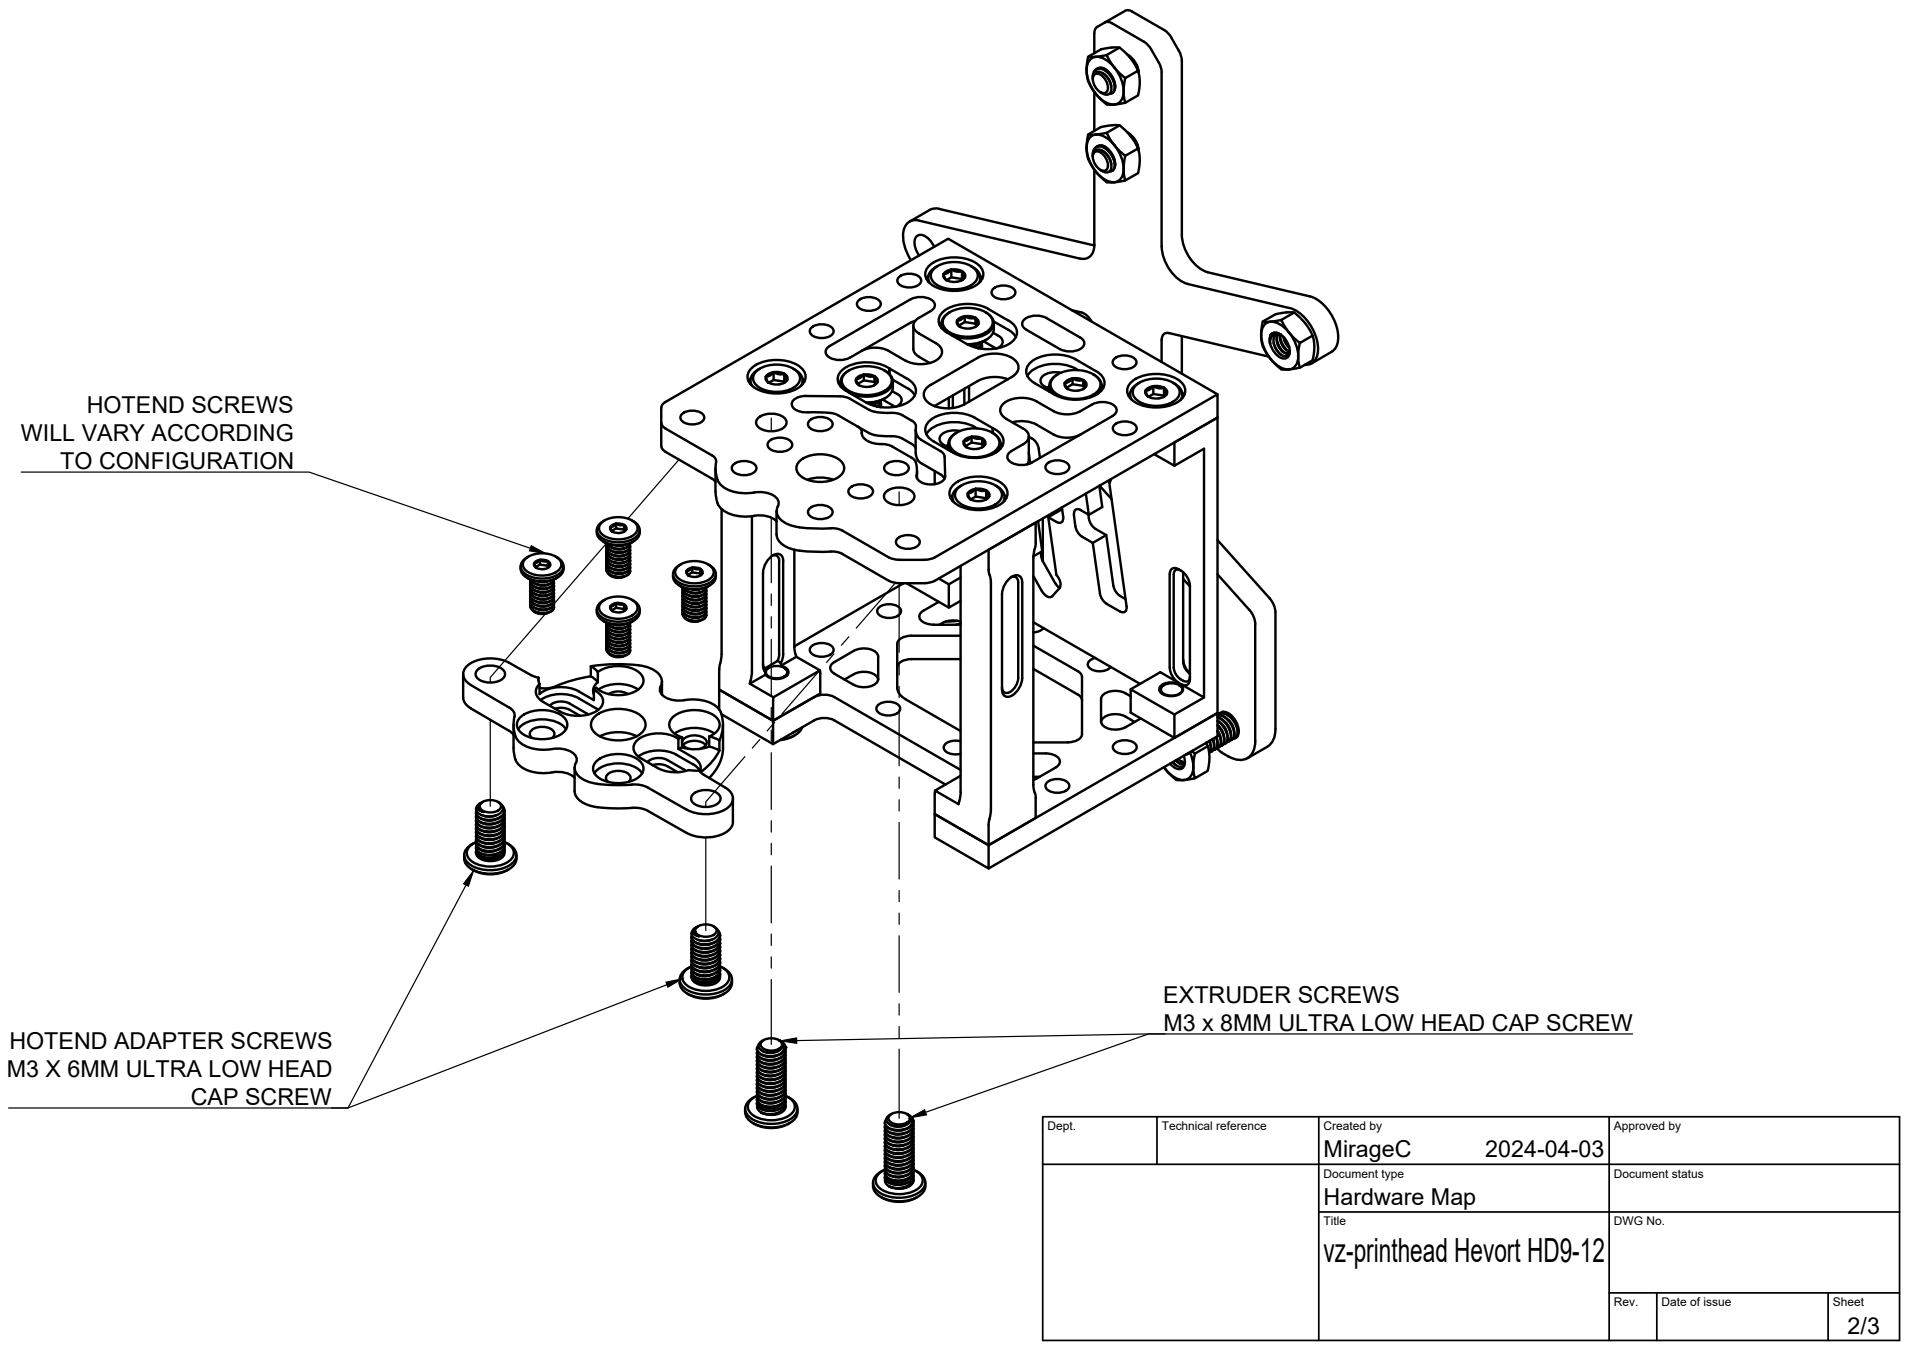
[picture p341: page 2]
HOTEND SCREWS; CAP SCREW

WILL VARY ACCORDING
TO CONFIGURATION

EXTRUDER SCREWS
M3 x 8MM ULTRA LOW HEAD CAP SCREW

HOTEND ADAPTER SCREWS
M3 X 6MM ULTRA LOW HEAD

Dept. | Technical reference | Created by MirageC 2024-04-03 | Approved by

Document type Hardware Map | Document status

Title vz-printhead Hevort HD9-12 | DWG No.

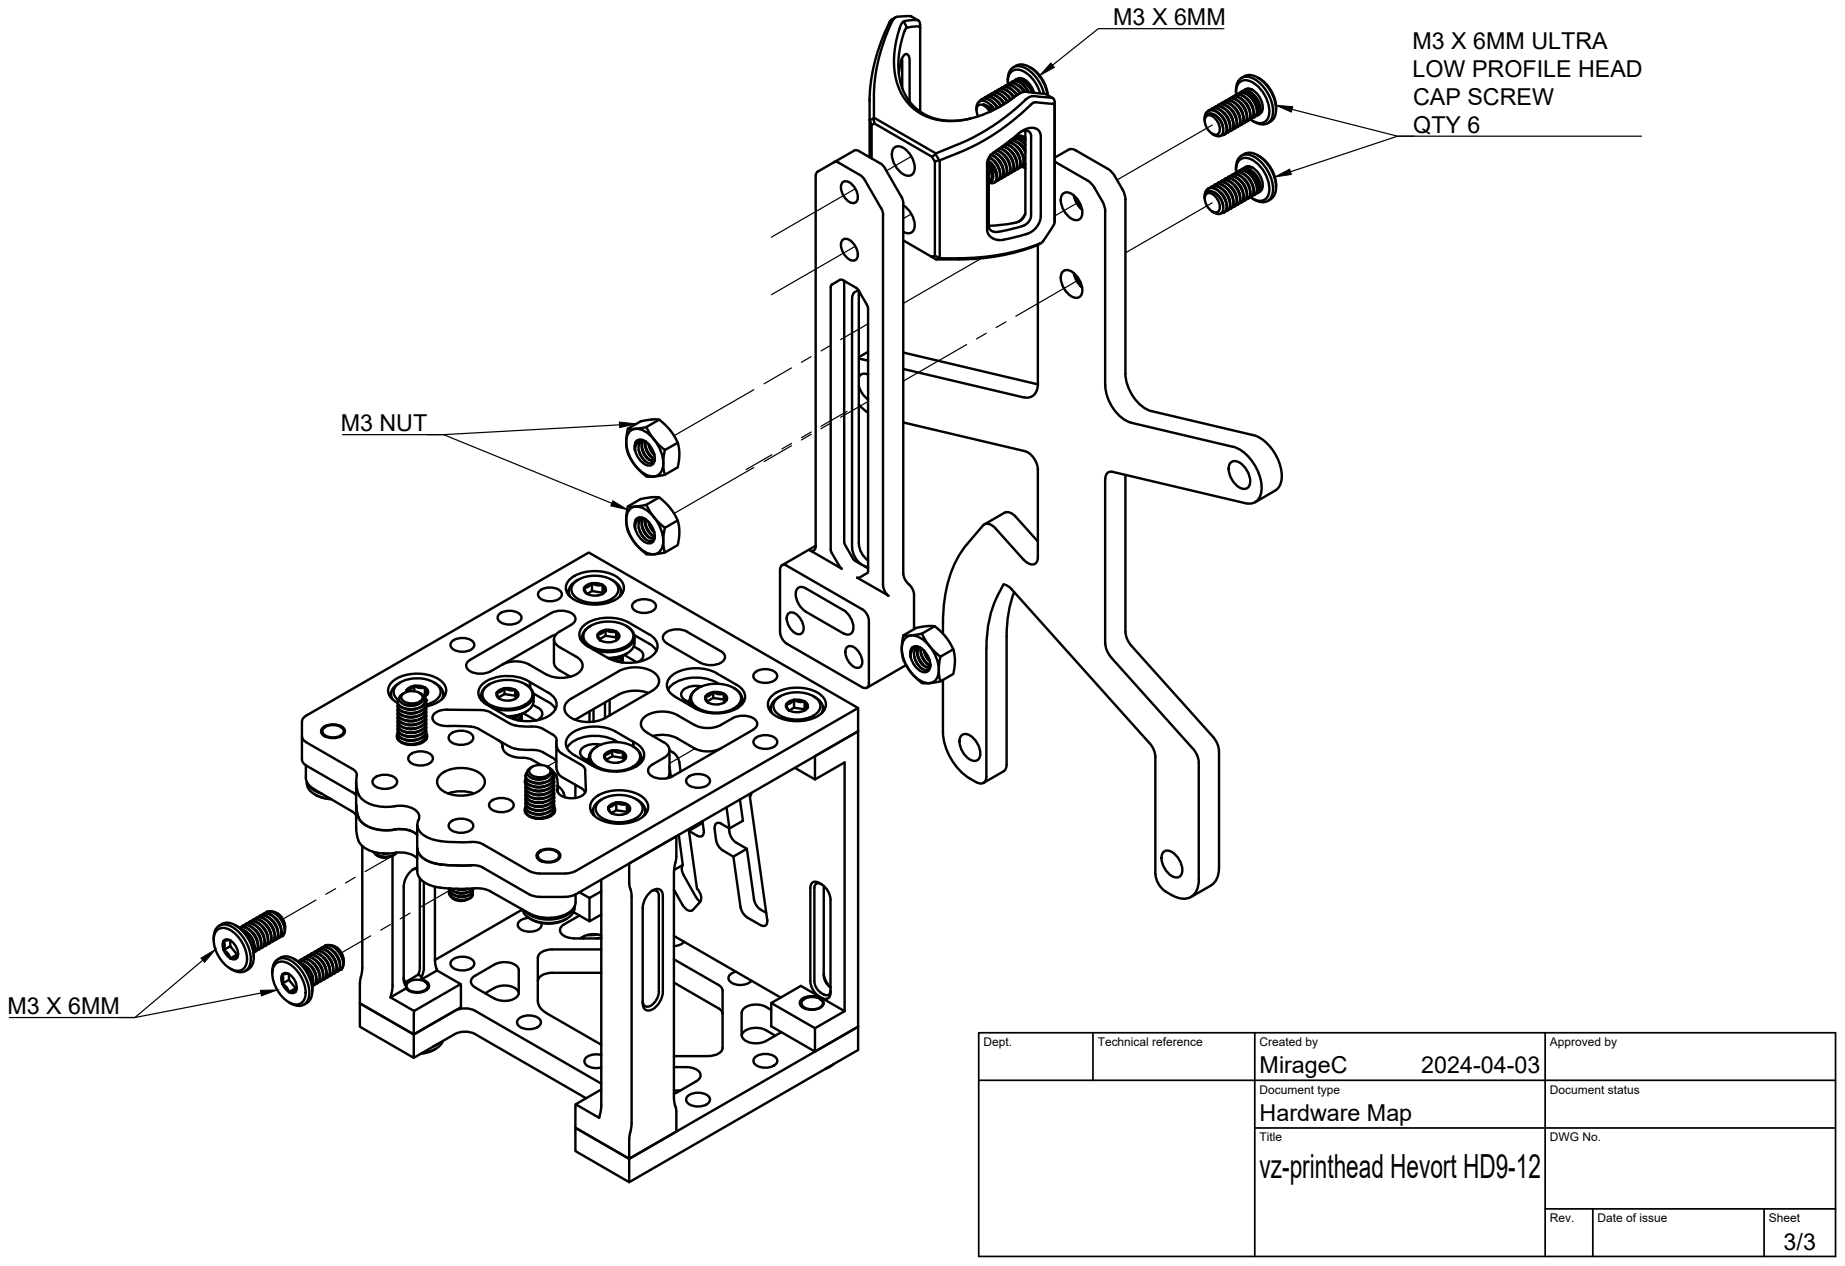
[picture p342: page 3]
M3 NUT

M3 X 6MM ULTRA
LOW PROFILE HEAD
CAP SCREW
QTY 6

Dept. | Technical reference | Created by MirageC 2024-04-03 | Approved by

Document type Hardware Map | Document status

Title vz-printhead Hevort HD9-12 | DWG No.
