MirageC79/HevORT/refdocs/HT_LDO-42STH48-2504AH_RevA.pdf

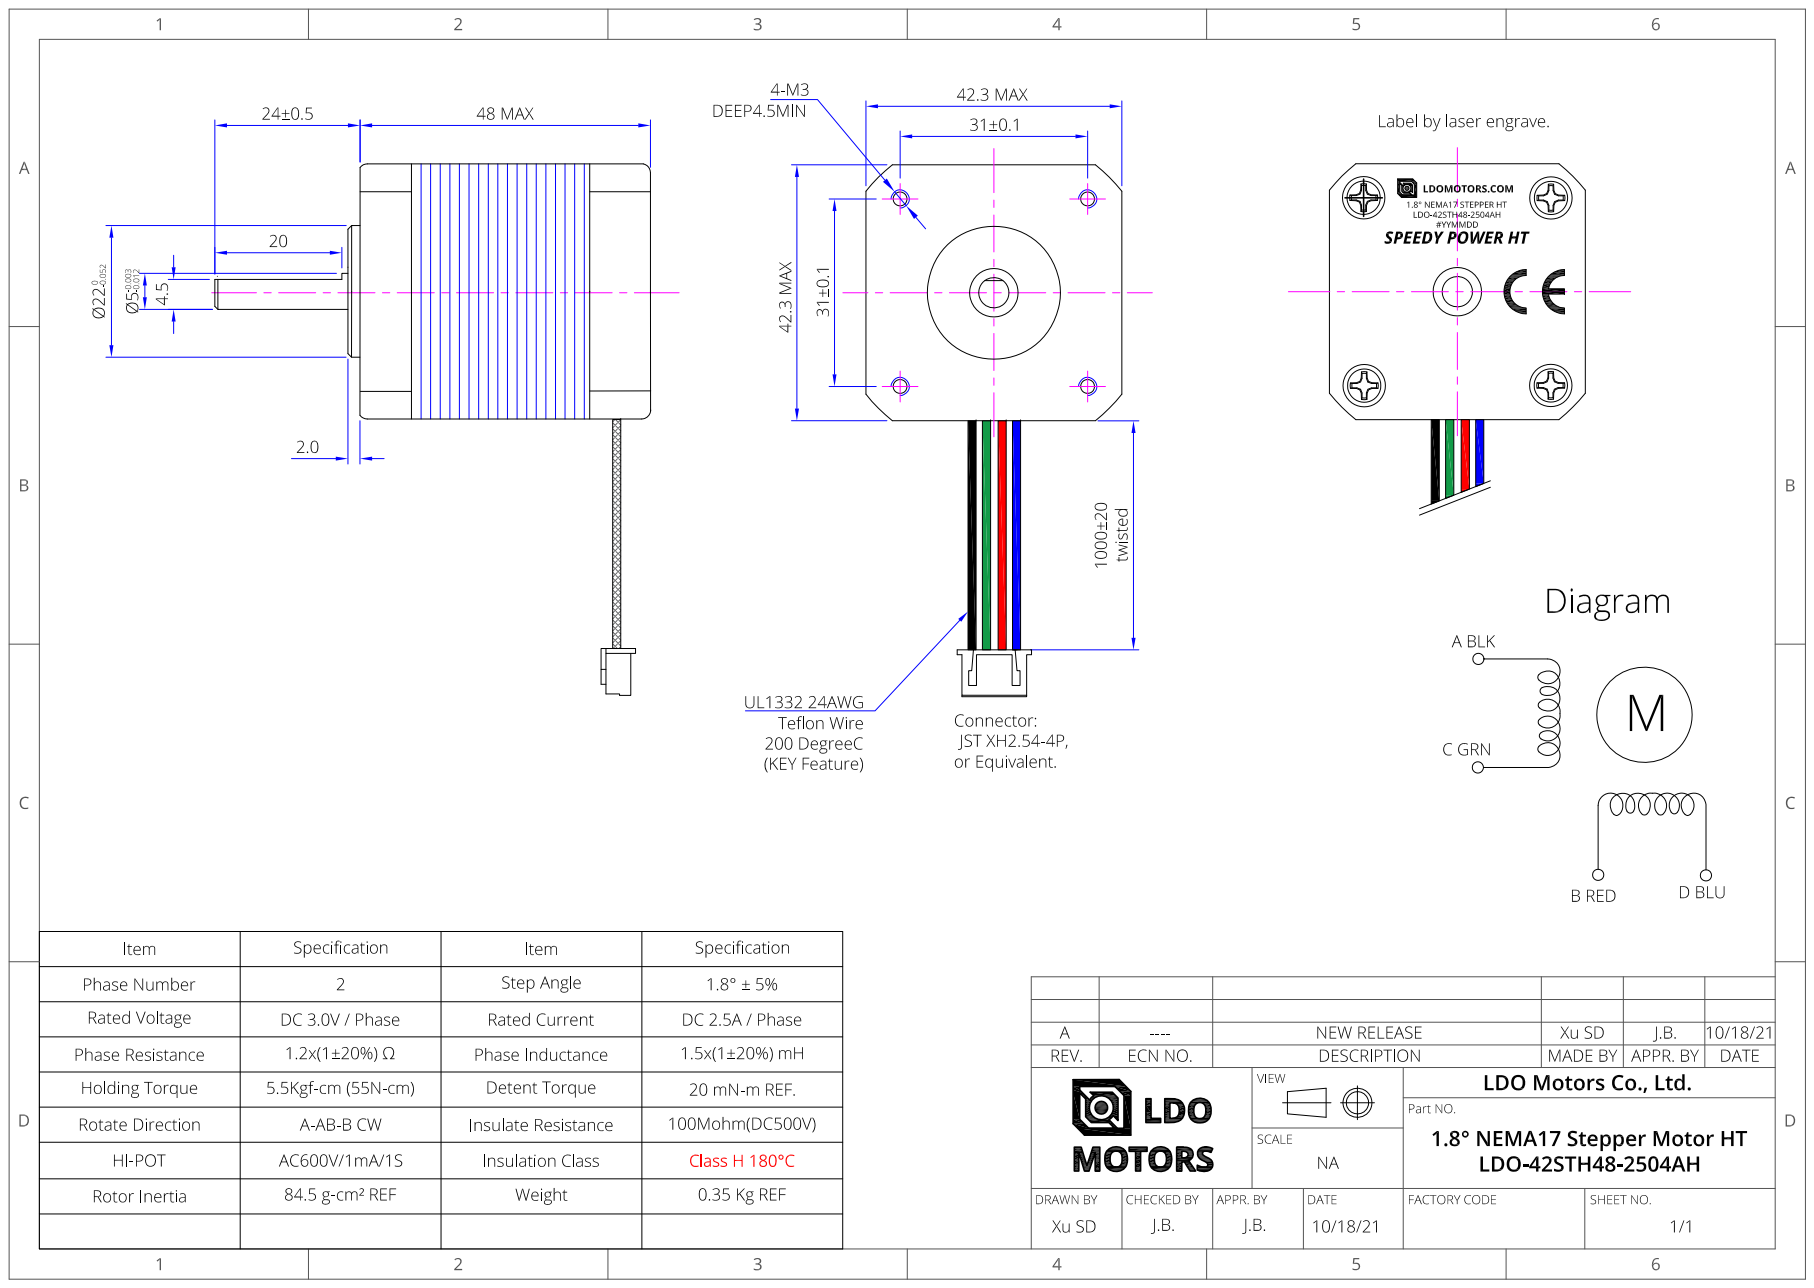
[picture p343: page 1]
