MirageC79/HevORT/refdocs/HT_LDO-42STH60-2004MAH_RevA.pdf

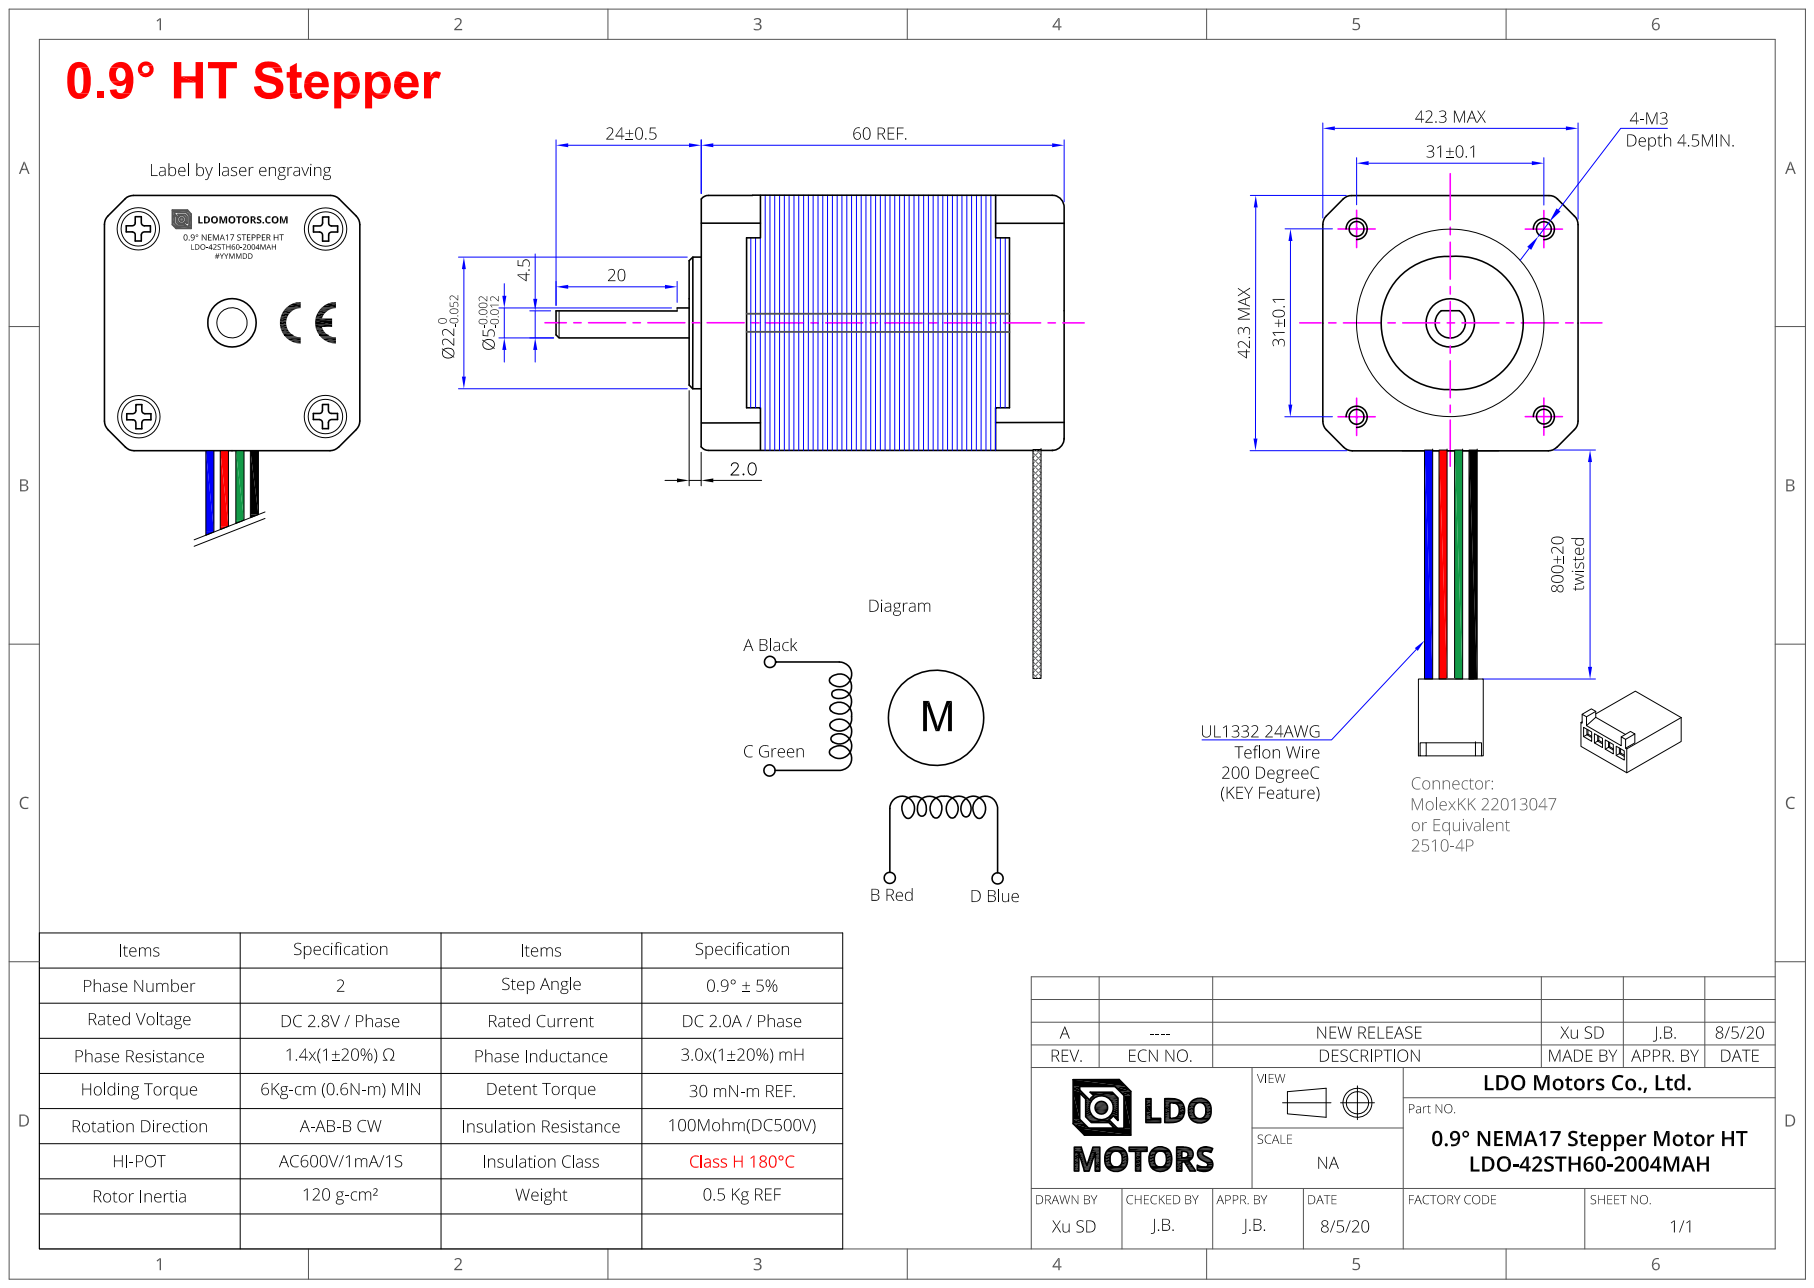
[picture p344: page 1]
