MirageC79/HevORT/refdocs/HT_LDO-42STH48-2804AH_RevA.pdf

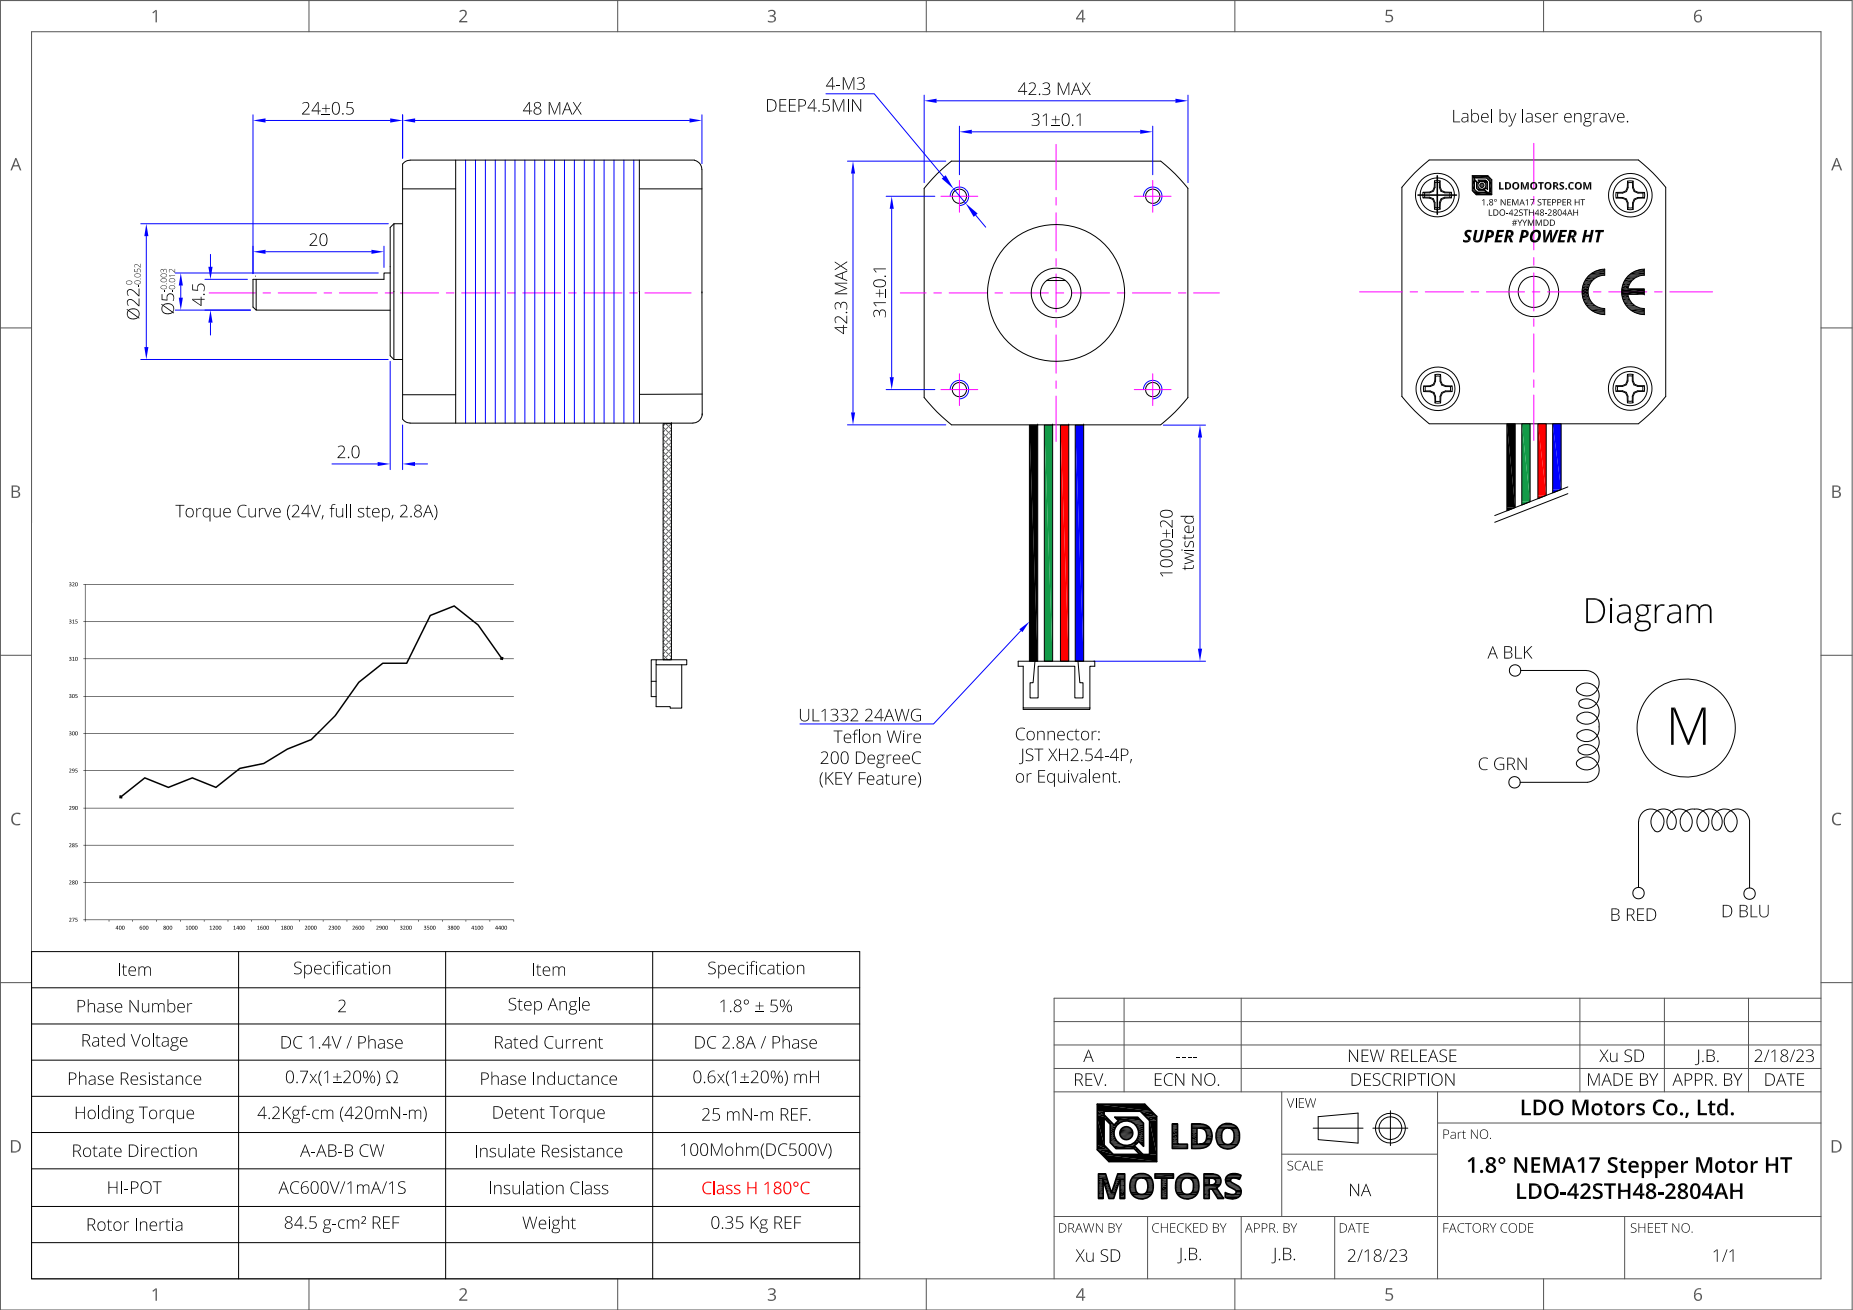
[picture p345: page 1]
