MirageC79/HevORT/refdocs/LDO-57STH41-2804MACHEV_RevA.pdf

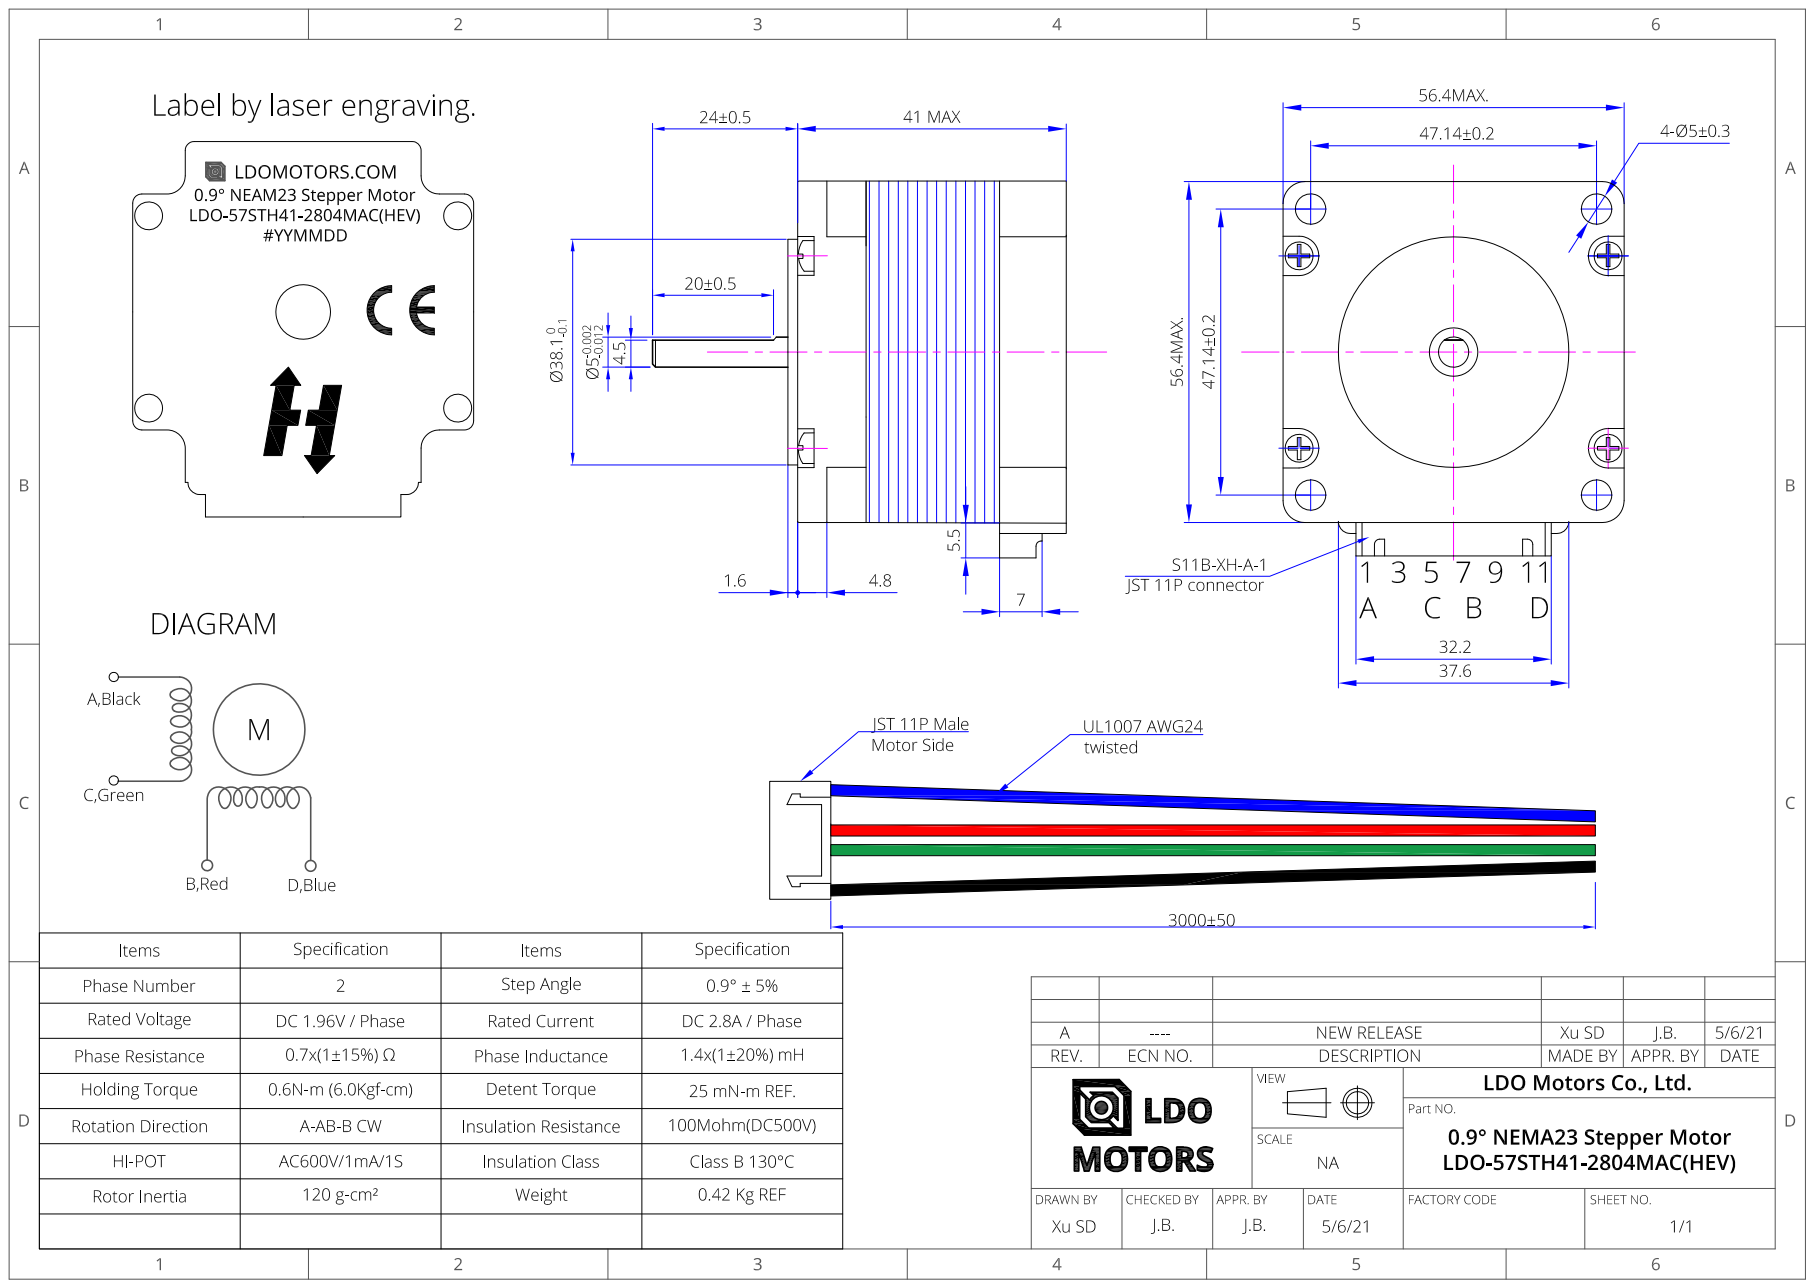
[picture p346: page 1]
