MirageC79/HevORT/firmware/klipper/Config_Octopus_SKR3EZ_Goliath_SPAWD_48VDC/printer.cfg

####################################################################
########################## INTRODUCTION ############################
####################################################################
# This file contains example configuration for Klipper running on: #
#                                                                  #
# PRINTER: HevORT 315*315*340                                      #
# CONTROL_BOARD: OctopusPro V1.0 or V1.1                           #
#   RefDoc: https://github.com/bigtreetech/BIGTREETECH-OCTOPUS-Pro #
#   OctopusPro V1.0 vs V1.1: https://github.com/bigtreetech/BIGTREETECH-OCTOPUS-Pro#changes-in-v11-compared-to-v10 # 
#                                                                  #
# OPTIONS: a) 48V on X,Y,E using BTT HV5160                        #
#          b) HevACS                                               #
#          c) SPAWD                                                #
#          d) TMC 5160T Plus on SKR E3 EZ                          #
#                                                                  #
# Config example created by:                                       #
# Date: MirageC Feb 1st, 2022                                      #
# Last updated: Nov 28th, 2023 SKR3 EZ TMC5160T PLUS for SPAWD     #
####################################################################

################## CONTROL BOARD PIN DEFINITION ####################
#  __________________________________________________________________
# | DRIVE     | STEP pin | DIR pin  | EN pin   | CS PIN   | END_STOP |
# |-----------|----------|----------|----------|----------|----------|
# | 0         | PF13     | PF12     | PF14     | PC4      | PG6      |
# | 1         | PG0      | PG1      | PF15     | PD11     | PG9      |
# | 2.1&2     | PF11     | PG3      | PG5      | PC6      | PG10     |
# | 3 on V1.0 | PG4      | PC1      | 1.0: PA0 | PC7      | PG11     | 
# | 3 on V1.1 | Same     | Same     | 1.1: PA2 | Same     | Same     | 
# | 4         | PF9      | PF10     | PG2      | PF2      | PG12     |
# | 5         | PC13     | PF0      | PF1      | PE4      | PD13     |
# | 6         | PE2      | PE3      | PD4      | PE1      | PD14     |
# | 7         | PE6      | PA14     | PE0      | PD3      | PD15     |
# |___________|__________|__________|__________|__________|__________|
#  ___________________ 
# | FAN   |    PIN    |
# |-------|-----------|
# | FAN0  | PA8       |
# | FAN1  | PE5       |
# | FAN2  | PD12      |
# | FAN3  | PD13      |
# | FAN4  | PD14      |
# | FAN5  | PD15      |
# | FAN6  | ALWAYS_ON |
# | FAN7  | ALWAYS_ON |
# | ______|___________|
#  _____________________________________
# | HEATER      |  HEAT pin |  TEMP pin |
# |-------------|-----------|-----------|
# | BED         | PA1       | (TB) PF3  |
# | HE0 on V1.0 | 1.0: PA2  | (TO) PF4  |
# | HE0 on V1.1 | 1.1: PA0  | Same      |
# | HE1         | PA3       | (T1) PF5  |
# | HE2 on V1.0 | V1.0 PB10 | (T2) PF6  |
# | HE2 on V1.1	| V1.1: PB0 | Same      |
# | HE3         | PB11      | (T3) PF7  |
# |_____________|___________|___________|
#  _________________
# | SPI    | PIN    |
# |--------|--------|
# | MOSI   | PA7    |
# | MISO   | PA6    |
# | SCK    | PA5    |
# |________|________|

#  _________________
# | RGB    | PIN    |
# |--------|--------|
# | V1.0   | PB0    |
# | V1.1   | PB10   |
# |________|________|

####################################################################
############################## MCU #################################
####################################################################
[mcu]                               # Define Controller Board as main MCU 
serial: /dev/serial/by-path/platform-fd500000.pcie-pci-0000:01:00.0-usb-0:1.1:1.0
#/dev/serial/by-id/usb-Klipper_stm32f446xx_28003F001750534E4E313420-if00

[temperature_sensor OctopusPro]     # Create a temperature reading for the Controller Board's MCU
sensor_type: temperature_mcu
min_temp: 0
max_temp: 100

#[mcu rpi]                           # Create an additional MCU from the Raspberry Pi 
#serial: /tmp/klipper_host_mcu

[temperature_sensor RaspberryPi]    # Create a temperature reading for the Raspberry Pi CPU
sensor_type: temperature_host
min_temp: 0
max_temp: 100


####################################################################
########################### FUNCTIONS ##############################
####################################################################
[include fluidd.cfg]

[virtual_sdcard]
path: /home/pi/printer_data/gcodes
on_error_gcode: CANCEL_PRINT

[display_status]

[save_variables]
filename: ~/saved_variables.cfg

[exclude_object]

[gcode_arcs]  #Required for OrcaSlicer when using Z-hop. Orca does spiral wipes and needs G2/G3 to do so.
#resolution: 1.0



####################################################################
########################### INCLUDES ###############################
####################################################################
#[include shell_command.cfg]

[include neopixel.cfg]

[include macros.cfg]

### Temporary use of TMC5160PRO_EZ on BTT SKR3 EZ for SPAWD. 
[include spawd_bttskr3ez.cfg]

#[include spawd_bttskr3ez_tuning.cfg]

#[include tmc_autotune.cfg]

####################################################################
######################## PRINTER LIMITS ############################
####################################################################
[printer]
kinematics: corexy
max_velocity: 2000
max_accel: 80000
max_accel_to_decel: 40000
max_z_velocity: 40
max_z_accel: 300
square_corner_velocity: 10

[pause_resume]
recover_velocity: 100

[input_shaper]
shaper_freq_x: 123  # per accelerometer
shaper_type_x: mzv
shaper_freq_y: 93.8  # per accelerometer
shaper_type_y: ei


####################################################################
############################ XY AXIS ###############################
####################################################################

#____________________ Delegated to SKR3 X On Drive 0 __________________________
#[stepper_x]           
#step_pin: PF13
#dir_pin: PF12
#enable_pin: !PF14
#microsteps: 64
#rotation_distance: 40
#endstop_pin: ^PG6 
#position_endstop: 0
#position_min: 0
#position_max: 310
#homing_speed: 200
#full_steps_per_rotation: 200
#homing_retract_dist: 0
#homing_positive_dir: false

#[tmc5160 stepper_x]
#cs_pin: PC4
##spi_software_sclk_pin: PA5
##spi_software_mosi_pin: PA7
##spi_software_miso_pin: PA6
#spi_bus: spi1
#interpolate: false
#run_current: 2.2


#____________________ Delegated to SKR3 Y On Drive 1 __________________________
#[stepper_y]           
#step_pin: PG0
#dir_pin: PG1
#enable_pin: !PF15
#microsteps: 64
#rotation_distance: 40
#endstop_pin: ^PG9 
#position_endstop: 0
#position_min: 0
#position_max: 310
#homing_speed: 200
#full_steps_per_rotation: 200
#homing_retract_dist: 0
#homing_positive_dir: false

#[tmc5160 stepper_y]
#cs_pin: PD11
##spi_software_sclk_pin: PA5
##spi_software_mosi_pin: PA7
##spi_software_miso_pin: PA6
##spi_bus: spi1
##stealthchop_threshold: 0
#interpolate: false
#run_current: 2.2	


####################################################################
############################ Z AXIS ################################
####################################################################

#____________________ ACTIVE - Z On Drive 2  _______________________
[stepper_z]         
step_pin: PF11
dir_pin: !PG3
enable_pin: !PG5
microsteps: 32
rotation_distance: 4 				
full_steps_per_rotation: 400
endstop_pin: probe:z_virtual_endstop
position_max: 280
position_min: -2 #Using negative value will allow bed to go past 0 to reach Z Probe in case of unlevelled bed.
homing_speed: 30
homing_retract_dist: 0 # beacon needs this to be set to 0

[tmc2209 stepper_z]
uart_pin: PC6      #(CS PIN)
interpolate: False
run_current: 1.2


#____________________ ACTIVE - Z1 On Drive 3 _______________________
[stepper_z1]          
step_pin: PG4
dir_pin: !PC1
# # BOARD VERSION SELECTION - UNCOMMENT ACCORDING TO YOUR BOARD #
enable_pin: !PA0 #Drive 3 on OctopusPro V1.0
#enable_pin: !PA2 #Drive 3 on OctopusPro V1.1

microsteps: 32
rotation_distance: 4 				
full_steps_per_rotation: 400

[tmc2209 stepper_z1]
uart_pin: PC7      #(CS PIN)
interpolate: False
run_current: 1.2


#____________________ ACTIVE - Z2 On Drive 4 _______________________
[stepper_z2]
step_pin: PF9
dir_pin: !PF10
enable_pin: !PG2
microsteps: 32
rotation_distance: 4 				
full_steps_per_rotation: 400

[tmc2209 stepper_z2]
uart_pin: PF2     #(CS PIN)
interpolate: False
run_current: 1.2


#____________________ INACTIVE - BL-TOUCH __________________________
#[bltouch]
#sensor_pin: ^PB7		# (WHITE wire)  ^ = Activate pullup resistor to avoid floating input
#control_pin: PB6		# (ORANGE wire) ! = Active low
#x_offset: 22.775
#y_offset: -8.706
#z_offset: 3
#speed: 12
#samples: 1
#sample_retract_dist: 5 
#samples_tolerance: 0.010


#____________________ ACTIVE - Beacon3D Eddy Current _______________
[beacon]
serial: /dev/serial/by-path/platform-fd500000.pcie-pci-0000:01:00.0-usb-0:1.4:1.0
#/dev/serial/by-id/usb-Beacon_Beacon_RevD_0DA142B9515137474C202020FF0C132A-if00
x_offset: 0         # update with offset from nozzle on your machine
y_offset: 51        # update with offset from nozzle on your machine
mesh_main_direction: x
mesh_runs: 2
speed: 20         # Z probing dive speed.
lift_speed: 30     # Z probing lift speed.
#[safe_z_home]
#home_xy_position: 140, 130 # update for your machine
#z_hop: 3


#____________________ ACTIVE - SELF LEVELLING (Z_Tilt) _____________
# HevORT DOCS on Z_Tilt: https://docs.hevort.com/#/pages/firmware-configuration/klipper?id=configuring-z-self-leveling
[z_tilt]
z_positions: 
    11.226, 18.985   #10.726, 10.385
    153.268, 292.910 #152.768, 284.381
    295.310, 18.985  #294.81, 10.385
    
points: #Nozzle Position, Bed will be probed at the location whe the probe is when noxxle is on this point.
	10,0
	150,210
	#280,210
	280,0
# It is recommended to use 3 or 4 points maximum to define the bed attitude.  
# Either place a point close to each corner, or close to each lift points.

speed: 200
horizontal_move_z: 15
#retries: 0     # Number of times to retry if the probed points aren't within tolerance.
#retry_tolerance: 0
#   If retries are enabled then retry if largest and smallest probed
#   points differ more than retry_tolerance. Note the smallest unit of
#   change here would be a single step. However if you are probing
#   more points than steppers then you will likely have a fixed
#   minimum value for the range of probed points which you can learn
#   by observing command output.

[axis_twist_compensation]
speed: 80
#   The speed (in mm/s) of non-probing moves during the calibration.
#   The default is 50.
#horizontal_move_z: 5
#   The height (in mm) that the head should be commanded to move to
#   just prior to starting a probe operation. The default is 5.
calibrate_start_x: 0
#   Defines the minimum X coordinate of the calibration
#   This should be the X coordinate that positions the nozzle at the starting
#   calibration position. This parameter must be provided.
calibrate_end_x: 300
#   Defines the maximum X coordinate of the calibration
#   This should be the X coordinate that positions the nozzle at the ending
#   calibration position. This parameter must be provided.
calibrate_y: 140
#   Defines the Y coordinate of the calibration
#   This should be the Y coordinate that positions the nozzle during the
#   calibration process. This parameter must be provided and is recommended to
#   be near the center of the bed


#____________________ ACTIVE - BED MESH ____________________________
[bed_mesh]
algorithm: bicubic
bicubic_tension: 0.2
speed: 400
horizontal_move_z: 2
mesh_min: 20, 55 #Probe position
mesh_max: 280,265 
probe_count: 20 , 20
fade_start: 1
fade_end: 5

#____________________ INACTIVE - SAFE Z HOMING _______________________  Section replaced by Homing_Override
#[safe_z_home]
#home_xy_position: 20,20  
#z_hop: 10
#z_hop_speed: 50.0


##################################################################
########################## EXTRUDER ##############################
##################################################################

#____________________ ACTIVE - Extruder On Drive 6 ####_________________
[extruder]
step_pin: PE2
dir_pin: !PE3
enable_pin: !PD4 
microsteps: 64
full_steps_per_rotation: 200
#rotation_distance: 8.2 #Hemera
rotation_distance: 4.44 #HextrudORT Old 4.53 
nozzle_diameter: 0.500
filament_diameter: 1.750
#____________________#### HEATER NOZZLE on HE0 ####_________________
# # BOARD VERSION SELECTION - UNCOMMENT ACCORDING TO YOUR BOARD #
heater_pin: PA2 #Extruder Heater(HE0) on OctopusPro V1.0
#heater_pin: PB10 #Extruder Heater(HE0) on OctopusPro V1.1

#____________________ ACTIVE - 104NT-4 connected Directly _____________
sensor_type: ATC Semitec 104NT-4-R025H42G    
sensor_pin: PF4
pullup_resistor: 4700

#____________________ INACTIVE - PT1000 connected Directly _____________
#sensor_type: PT1000    
#sensor_pin: PF4
#control: pid
#pid_Kp: 22.2
#pid_Ki: 1.08
#pid_Kd: 114

#____________________ INACTIVE - Thermistor Dyze500 _________________
#based on: https://s.click.aliexpress.com/e/_DBB4Lb3
#[thermistor Dyze500]
#temperature1: 25
#resistance1: 4500000
#temperature2: 260
#resistance2: 2240
#temperature3: 460
#resistance3: 125.4
#sensor_type: Dyze500
#sensor_pin: PF4

#____________________ INACTIVE - Using PT100 on Octopus Pro _________
#sensor_type: MAX31865    
#sensor_pin: PF8
#spi_speed: 4000000
#spi_software_sclk_pin: PA5
#spi_software_mosi_pin: PA7
#spi_software_miso_pin: PA6
#spi_bus: spi1
#rtd_nominal_r: 100
#rtd_reference_r: 427
#rtd_num_of_wires: 2
#rtd_use_50Hz_filter: True

#____________________ INACTIVE - NOZZLE TEMP ________________________
#sensor_type: EPCOS 100K B57560G104F #E3D Standard Thermistor
#sensor_type: ATC Semitec 104NT-4-R025H42G #Rapido UHF 
#sensor_pin: PF4
#pullup_resistor: 4700

min_temp: 0
max_temp: 350
min_extrude_temp: 10
pressure_advance = 0.025
max_extrude_only_distance: 150.0

#____________________ INACTIVE - TMC5160 Ref ________________________
#[tmc5160 extruder]
#cs_pin: PE1
#spi_software_sclk_pin: PA5
#spi_software_mosi_pin: PA7
#spi_software_miso_pin: PA6
#stealthchop_threshold: 0
#interpolate: False
#run_current: 0.5

[tmc2209 extruder]
uart_pin: PE1      #(CS PIN)
interpolate: false
run_current: 0.800


[firmware_retraction]
retract_length: 0.5
#   The length of filament (in mm) to retract when G10 is activated,
#   and to unretract when G11 is activated (but see
#   unretract_extra_length below). The default is 0 mm.
retract_speed: 60
#   The speed of retraction, in mm/s. The default is 20 mm/s.
unretract_extra_length: 0
#   The length (in mm) of *additional* filament to add when
#   unretracting.
unretract_speed: 60
#   The speed of unretraction, in mm/s. The default is 10 mm/s.


####################################################################
############################ BED ###################################
####################################################################
[heater_bed]
heater_pin: PA1
sensor_type: EPCOS 100K B57560G104F
sensor_pin: PF3
#control: watermark
min_temp: 0
max_temp: 130


####################################################################
######################## ACCELEROMETER #############################
####################################################################
#[adxl345]
#cs_pin: rpi:None

#[resonance_tester]
#accel_chip: adxl345
#probe_points:
#    150,150,20  
#max_freq: 200
#accel_per_hz: 200


####################################################################
###################### FANS & THERMISTORS ##########################
####################################################################
#[output_pin FAN3]
#pin: sx1509_duex:PIN_12
#pwm: true
#hardware_pwm: true # Only hardware PWM fans are supported

#[output_pin EVA]
#pin: sx1509_duex:PIN_15 #Fan8
#pwm: true
#hardware_pwm: true

#[multi_pin hevacspin]
#pins: sx1509_duex:PIN_12, sx1509_duex:PIN_7    

#[output_pin HevACS]
#pin: multi_pin:hevacspin
#pwm: true
#hardware_pwm: True

# Fan1 controlled by heater Extruder & 12V relay for WaterPump and radiator fan



[multi_pin heateractivated_pin]
pins: PE5, PD12

[heater_fan nozzle_cooling_fan]
pin: multi_pin:heateractivated_pin 
heater: extruder
heater_temp: 45
fan_speed: 1.0


[fan]  #CPAP settings
pin: PB7
kick_start_time: 0.05
off_below: 0.08
cycle_time: 0.0002

[temperature_sensor Chamber]
sensor_type: PT1000    
sensor_pin: PF5


#_______________________ RADIATOR ________________________________
[temperature_fan Radiator]
# 4-pin computer PWM exhaust fan - FAN2
pin: !PD14
control: pid
pid_Kp: 40
pid_Ki: 0.2
pid_Kd: 0.1
max_power: 1.0
min_speed: 0
max_speed: 1
shutdown_speed: 0.0
kick_start_time: 0.1
off_below: 0
target_temp: 30

# The thermistor that measures the temp for this temp-controlled fan:
sensor_type: PT1000
sensor_pin: PF6
min_temp: 5
max_temp: 100
gcode_id: C
tachometer_pin: ^PG15
tachometer_ppr: 2

# The official PC fan spec calls for 21-28kHz PWM frequency, but my Noctua at least was happy with the default 100Hz software PWM. So if your controller doesn't support hardware_pwm then try leaving these two lines out:
#hardware_pwm: True
#cycle_time: 0.00004 # 25 kHz

# RPM monitoring:



####################################################################
###################### FILAMENT SENSOR #############################
####################################################################
#[filament_switch_sensor sentinel]
#pause_on_runout: true
#switch_pin: PXXX  # not mapped yet
#runout_gcode:
#	G91
#    G1 E-6 F2500
#    G1 Z 10



####################################################################
########################## PSU 48V #################################
####################################################################


#_________Define PSU Relay control pin on Fan#5_____________________
[output_pin psu48_control]
pin: PD15
pwm: False

#___________Power Up PSU on Custom Homing___________________________
[homing_override]
set_position_z: 5
axes: XYZ
gcode:
    SET_VELOCITY_LIMIT ACCEL=20000
    SET_VELOCITY_LIMIT ACCEL_TO_DECEL=10000
    SET_PIN PIN=psu48_control VALUE=1
    G4 P2000
    G0 Z10 F600 ; Move Z up a bit to prevent scratching
    G28 X0
    G28 Y0
    G1 X140 Y130 F9000
    G28 Z0
    G1 Z20 F2400

#________Turn Off PSU on Custom Idle Timeout________________________
[idle_timeout]
gcode:
    TURN_OFF_HEATERS
    M84
    SET_PIN PIN=psu48_control VALUE=0
    ALL_SLEEP
timeout: 600

#____________ Turn Stepper Driver Fans on use ______________________


[controller_fan myfan_StepperFans]
pin: PD13
max_power: 1.0
fan_speed: 1.0
idle_timeout: 60
stepper: stepper_x,stepper_y



####################################################################
###################### END of manual config ########################
####################################################################

#*# <---------------------- SAVE_CONFIG ---------------------->
#*# DO NOT EDIT THIS BLOCK OR BELOW. The contents are auto-generated.
#*#
#*# [extruder]
#*# control = pid
#*# pid_kp = 26.436
#*# pid_ki = 3.092
#*# pid_kd = 56.506
#*#
#*# [heater_bed]
#*# control = pid
#*# pid_kp = 68.929
#*# pid_ki = 2.596
#*# pid_kd = 457.513
#*#
#*# [DummyBlock]
#*# control = pid
#*# pid_kp = 27.714
#*# pid_ki = 1.301
#*# pid_kd = 147.578
#*#
#*# [beacon model default]
#*# model_coef = 1.545067524142782,
#*# 	1.8557585836822348,
#*# 	0.7522331379413066,
#*# 	0.40295741536945756,
#*# 	0.24551574872994697,
#*# 	0.0699300875395469,
#*# 	-0.046486769312545445,
#*# 	0.048491793588707685,
#*# 	0.10381738963352584,
#*# 	0.026178503502993566
#*# model_domain = 3.2307885466469924e-07,3.3411299006620967e-07
#*# model_range = 0.200000,5.000000
#*# model_temp = 34.381291
#*# model_offset = 0.00000
#*#
#*# [bed_mesh default]
#*# version = 1
#*# points =
#*# 	0.065307, -0.013886, -0.023362, -0.016588, -0.037752, -0.025357, -0.031693, -0.050444, -0.074839, -0.059231, -0.037208, -0.037758, -0.043047, -0.019114, 0.009186, -0.018147, -0.036786, -0.034629, -0.020697, -0.008908
#*# 	0.022664, -0.010488, -0.023815, -0.043280, -0.030926, -0.018916, -0.043184, -0.065808, -0.058905, -0.049539, -0.035182, -0.029883, -0.033453, -0.006820, 0.008323, -0.015611, -0.037184, -0.036247, -0.026608, -0.007151
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
#*# mesh_x_pps = 2
#*# mesh_y_pps = 2
#*# algo = bicubic
#*# tension = 0.2
#*# min_x = 20.0
#*# max_x = 280.0
#*# min_y = 55.0
#*# max_y = 265.0
#*#
#*# [axis_twist_compensation]
#*# z_compensations = -0.132400, 0.059414, 0.072986
#*# compensation_start_x = 0.0
#*# compensation_end_x = 300.0
