MirageC79/HevORT/firmware/klipper/HevORT_DualSKREZ_ServoXY_TMC5160ZE_FromWayne.cfg

######################################################################################
########################## INTRODUCTION ##############################################
######################################################################################
# This file contains example configuration for Klipper running on:                   #
#                                               				                     #
# PRINTER: HevORT 500*500*1000                 					                     #
# CONTROL_BOARD:  BTT  SKR3ez                                                        #
# https://support.biqu3d.com/hc/en-us/articles/6755211206937-SKR-3-SKR-3-EZ-Manual   #                       
#                                                                                    #
# Config example created by:                                                         #
# Date: Vvega 27/09/22                                                               #
######################################################################################

## *** THINGS TO CHANGE/CHECK: ***
## MCU paths                            [mcu] section
## Thermistor types                     [nozzle] and [heater_bed] sections - See https://www.klipper3d.org/Config_Reference.html#common-thermistors for common thermistor types
## Probe offset for Z                   [BLTouch] section
## Probe points                         [SELF LEVELLING (Z_Tilt)] section
## PID tune                             [nozzle] and [heater_bed] sections
## Fine tune E steps                    [extruder] section






 
# To use this config, during "make menuconfig" enable "low-level
# options", "STM32H743", "128KiB bootloader", and "25MHz clock".

# See docs/Config_Reference.md for a description of parameters.




####################################################################
############################ MCU ###################################
####################################################################

[mcu]
##  MCU for Z steppers and extruder Main Ecu
##  [Z in X] - Front Left
##  [Z1 in Y] - Rear 
##  [Z2 in Z] - Front Right
##  [Extruder in E0]- Extruder
##--------------------------------------------------------------------
serial: /dev/serial/by-id/usb-Klipper_stm32h743xx_25004C001051303232383230-if00


##--------------------------------------------------------------------




[mcu s]
##  MCU for X/Y Servos 
##  [X in X] - B Motor
##  [Y in Y] - A Motor
##  
##--------------------------------------------------------------------
serial: /dev/serial/by-id/usb-Klipper_stm32h743xx_320023001051303232383230-if00

##--------------------------------------------------------------------





[mcu rpi]
serial: /tmp/klipper_host_mcu


[temperature_sensor raspberry_pi]
sensor_type: temperature_host
min_temp: 10
max_temp: 100








####################################################################
############################ PRINTER ###############################
####################################################################
[printer]
kinematics: corexy
max_velocity: 2000
max_accel: 20000
max_accel_to_decel: 10000
max_z_velocity: 60
max_z_accel: 300
square_corner_velocity: 5

[pause_resume]
recover_velocity: 150


###################################################
# Servo Drives XY ClearPath SDSK Stepper Killers  #
###################################################

#______________________#### X On Drive 0 MCU X/Y ####_______________________

[stepper_x]
step_pin: s:PD4
dir_pin: s:PD3
enable_pin: !s:PD6
rotation_distance: 40
microsteps: 1
step_pulse_duration: 0.000004
full_steps_per_rotation:6400  
endstop_pin: ^s:PC1
position_endstop: 0
position_min: 0
position_max: 460
homing_retract_dist: 0
homing_speed: 100

#______________________#### Y On Drive 1 MCU X/Y ####_______________________

[stepper_y]
step_pin: s:PA15
dir_pin: s:PA8
enable_pin: !s:PD1
rotation_distance: 40
microsteps: 1
step_pulse_duration: 0.000004
full_steps_per_rotation:6400  
endstop_pin: ^s:PC3
position_endstop: 0
position_min: 0
position_max: 500
homing_retract_dist: 0
homing_speed: 100





####################################################################
############################ Z Axis ################################
####################################################################

#______________________#### Z On Drive 0 Main MCU ####_______________________

[stepper_z]         
step_pin: PD4
dir_pin: !PD3
enable_pin: !PD6
microsteps: 16
microsteps: 16
rotation_distance: 4 		
gear_ratio: 2:1		
full_steps_per_rotation: 200
endstop_pin: probe:z_virtual_endstop
position_max: 800
position_min: -1.5
homing_speed: 20

########################################
# TMC5160 configuration
########################################

[tmc5160 stepper_z]
cs_pin: PD5
spi_software_miso_pin: PE15
spi_software_mosi_pin: PE13
spi_software_sclk_pin: PE14
sense_resistor: 0.033
run_current: 1
#stealthchop_threshold: 0





#_____________________#### Z1 On Drive 1 Main MCU ####_______________________
[stepper_z1]          
step_pin: PA15
dir_pin: !PA8
enable_pin: !PD1
microsteps: 16
rotation_distance: 4 	
gear_ratio: 2:1				
full_steps_per_rotation: 200

########################################
# TMC5160 configuration
########################################

[tmc5160 stepper_z1]
cs_pin: PD0
spi_software_miso_pin: PE15
spi_software_mosi_pin: PE13
spi_software_sclk_pin: PE14
sense_resistor: 0.033
run_current: 1	



#_____________________#### Z2 On Drive 2 Main MCU ####_______________________
[stepper_z2]
step_pin: PE2
dir_pin: !PE3
enable_pin: !PE0
microsteps: 16
gear_ratio: 2:1	
rotation_distance: 4 				
full_steps_per_rotation: 200

########################################
# TMC5160 configuration
########################################

[tmc5160 stepper_z2]
cs_pin: PE1
spi_software_miso_pin: PE15
spi_software_mosi_pin: PE13
spi_software_sclk_pin: PE14
sense_resistor: 0.033
run_current: 1	




##################################################################
########################## EXTRUDER ##############################
##################################################################


#________________#### Extruder On Drive 3 Main MCU ####_________________

[extruder]
step_pin: PD15
dir_pin: PD14
enable_pin: !PC7
microsteps: 8
full_steps_per_rotation: 200
rotation_distance: 59.032 # Cannon
gear_ratio: 39:2 # Cannon
nozzle_diameter: 0.500
filament_diameter: 1.750
heater_pin: PB3
sensor_pin: PA2

	

#_________________________NOZZLE TEMP _____________________________
sensor_type: ATC Semitec 104NT-4-R025H42G
sensor_pin: PA2
pullup_resistor: 4700
control: pid
pid_Kp: 22.2
pid_Ki: 1.08
pid_Kd: 114
min_temp: -10
max_temp: 250
min_extrude_temp: 10


########################################
# TMC5160 configuration
########################################

[tmc5160 extruder]
cs_pin: PC6
spi_software_miso_pin: PE15
spi_software_mosi_pin: PE13
spi_software_sclk_pin: PE14
stealthchop_threshold: 0
sense_resistor: 0.033
interpolate: False
run_current: 0.8


#[firmware_retraction]
#retract_length: 0.5
#   The length of filament (in mm) to retract when G10 is activated,
#   and to unretract when G11 is activated (but see
#   unretract_extra_length below). The default is 0 mm.
#retract_speed: 80
#   The speed of retraction, in mm/s. The default is 20 mm/s.
#unretract_extra_length: 0
#   The length (in mm) of *additional* filament to add when
#   unretracting.
#unretract_speed: 80
#   The speed of unretraction, in mm/s. The default is 10 mm/s.









#[extruder1]
#step_pin: PD11
#dir_pin: PD10
#enable_pin: !PD13
#heater_pin: PB4
#sensor_pin: PA3
#...



####################################################################
############################ BED ###################################
####################################################################


[heater_bed]
heater_pin: PD7
sensor_pin: PA1
sensor_type: ATC Semitec 104NT-4-R025H42G
pullup_resistor: 4700
control: watermark
min_temp: 0
max_temp: 200


[temperature_sensor Bed_Overtemp]
sensor_type: EPCOS 100K B57560G104F
sensor_pin: PA3
min_temp: 0
max_temp: 230

#__________________________ BLTouch ______________________________
[bltouch]
sensor_pin: ^PC13		# (WHITE wire)  ^ = Activate pullup resistor to avoid floating input
control_pin: PE5		# (ORANGE wire) ! = Active low
x_offset: 22.775
y_offset: -8.706
z_offset: 2.3


#__________________ SELF LEVELLING (Z_Tilt) _______________________
[z_tilt]
z_positions: 
	-38.188,-20.717
	229.421,492.81
	498.13,-20.4



points:
	20,20
	20,460
	460,460
	460,20
speed: 400
horizontal_move_z: 20



#__________________ Bed Mesh _______________________
[bed_mesh]
speed: 400
horizontal_move_z: 5
mesh_min: 35, 20
mesh_max: 260,260 
probe_count: 6, 6



#_____________________ SAFE Z HOMING ________________________________
[safe_z_home]
home_xy_position: 20,20  
z_hop: 10
z_hop_speed: 50.0



####################################################################
############################ ACCELEROMETER #########################
####################################################################

#[mcu rpi]
#serial: /tmp/klipper_host_mcu

#[adxl345]
#cs_pin: rpi:None

#[resonance_tester]
#accel_chip: adxl345
#probe_points:
 #   150,150,20  # an example





####################################################################
############################ FANS ##################################
####################################################################





####################################################################
###################### FILAMENT SENSOR #############################
####################################################################
#[filament_switch_sensor sentinel]
#pause_on_runout: true
#switch_pin: PXXX  # not mapped yet
#runout_gcode:
#	G91
#    G1 E-6 F2500
#    G1 Z 10
[fan]
pin: PB7





[display_status]


[virtual_sdcard]


path: ~/gcode_files


[pause_resume]

##############################################
################# MACROS #####################
##############################################
[gcode_macro CANCEL_PRINT]
rename_existing: BASE_CANCEL_PRINT
gcode:
    TURN_OFF_HEATERS
    CLEAR_PAUSE
    SDCARD_RESET_FILE
    BASE_CANCEL_PRINT
	SET_FAN_SPEED FAN=psu48 SPEED=1

[gcode_macro START_PRINT]
gcode:
	SET_FAN_SPEED FAN=psu48 SPEED=1

[gcode_macro FORCED_PAUSE]
gcode:
	PAUSE

[gcode_macro M600]
gcode:
    {% set X = params.X|default(20)|float %}
    {% set Y = params.Y|default(20)|float %}
    {% set Z = params.Z|default(10)|float %}
    SAVE_GCODE_STATE NAME=M600_state
    PAUSE
    G91
    G1 E-.8 F2700
    G1 Z{Z}
    G90
    G1 X{X} Y{Y} F3000
    G91
    G1 E-60 F1000
    RESTORE_GCODE_STATE NAME=M600_state

####################################################################
###################### END of manual config ############################################################################################




########################################
# EXP1 / EXP2 (display) pins
########################################

[board_pins]
aliases:
    # EXP1 header
    EXP1_1=PC5, EXP1_3=PB1, EXP1_5=PE9,  EXP1_7=PE11, EXP1_9=<GND>,
    EXP1_2=PB0, EXP1_4=PE8, EXP1_6=PE10, EXP1_8=PE12, EXP1_10=<5V>,
    # EXP2 header
    EXP2_1=PA6, EXP2_3=PE7, EXP2_5=PB2, EXP2_7=PC4,   EXP2_9=<GND>,
    EXP2_2=PA5, EXP2_4=PA4, EXP2_6=PA7, EXP2_8=<RST>, EXP2_10=<NC>

# See the sample-lcd.cfg file for definitions of common LCD displays.
