MirageC79/HevORT/firmware/klipper/LargePrinter_printer.cfg

# This file contains an example configuration with three
# micro-controllers simultaneously controlling a single printer.

# See docs/Config_Reference.md for a description of parameters.


########################################
# Printer configuration
########################################

[mcu]
serial: /dev/serial/by-id/usb-Klipper_lpc1769_06D0FF03C0846AAF78AE555EC22000F5-if00

[mcu zboard]
serial: /dev/serial/by-id/usb-Klipper_lpc1769_23A0001780A037AFECE4BF5BC72000F5-if00

[mcu rpi]
serial: /tmp/klipper_host_mcu

[printer]
kinematics: corexy
max_velocity: 400
max_accel: 12000
max_accel_to_decel: 6000
max_z_velocity: 8
max_z_accel: 100
square_corner_velocity: 10.0

########################################
# X configuration
########################################

[stepper_x]
step_pin: P2.2
dir_pin: !P2.6
enable_pin: !P2.1
microsteps: 16
rotation_distance: 40
full_steps_per_rotation: 200
position_endstop: 0
position_min: 0
position_max: 725
homing_speed: 60
homing_retract_dist: 0
endstop_pin:tmc2209_stepper_x:virtual_endstop

[tmc2209 stepper_x]
uart_pin: P1.10
interpolate: True
run_current: 1.400
hold_current: 0.750
sense_resistor: 0.110
#stealthchop_threshold: 60
driver_SGTHRS: 85
diag_pin:P1.29

########################################
# Y configuration
########################################

[stepper_y]
step_pin: P0.19
dir_pin: !P0.20
enable_pin: !P2.8
microsteps: 16
rotation_distance: 40
full_steps_per_rotation: 200
position_endstop: -17.5
position_min: -17.5
position_max: 725
homing_speed: 60
homing_retract_dist: 0
endstop_pin:tmc2209_stepper_y:virtual_endstop

[tmc2209 stepper_y]
uart_pin: P1.9
interpolate: True
run_current: 1.400
hold_current: 0.750
sense_resistor: 0.110
#stealthchop_threshold: 60
driver_SGTHRS: 85
diag_pin:P1.28

########################################
# Z configuration
########################################

# ----------------
# |Z1          Z2|
# |  ---------   |
# |  |       |   |
# |  |       |   |
# |  x--------   |
# |Z           Z3|
# ----------------

#### Z0 Stepper - Front Left ####

[stepper_z]
step_pin: zboard:P2.2
dir_pin: !zboard:P2.6
enable_pin: !zboard:P2.1
microsteps: 16
full_steps_per_rotation: 200
rotation_distance: 4
gear_ratio: 5:1
position_min: -20.0
position_max: 360.0
homing_speed: 7.0
homing_retract_dist: 3.0
second_homing_speed: 6.0
endstop_pin:probe:z_virtual_endstop

[tmc2209 stepper_z]
uart_pin: zboard:P1.10
interpolate: True
run_current: 1.400
hold_current: 0.900
sense_resistor: 0.110
#stealthchop_threshold: 999999

####


#### Z1 Stepper - Rear Left ####

[stepper_z1]
step_pin: zboard:P0.19
dir_pin: !zboard:P0.20
enable_pin: !zboard:P2.8
microsteps: 16
full_steps_per_rotation: 200
rotation_distance: 4
gear_ratio: 5:1

[tmc2209 stepper_z1]
uart_pin: zboard:P1.9
interpolate: True
run_current: 1.400
hold_current: 0.900
sense_resistor: 0.110
#stealthchop_threshold: 999999

####


#### Z2 Stepper - Rear Right ####

[stepper_z2]
step_pin: zboard:P0.22
dir_pin: !zboard:P2.11
enable_pin: !zboard:P0.21
microsteps: 16
full_steps_per_rotation: 200
rotation_distance: 4
gear_ratio: 5:1

[tmc2209 stepper_z2]
uart_pin: zboard:P1.8
interpolate: True
run_current: 1.400
hold_current: 0.900
sense_resistor: 0.110
#stealthchop_threshold: 999999

####


#### Z3 Stepper - Front Right ####

[stepper_z3]
step_pin: zboard:P2.13
dir_pin: !zboard:P0.11
enable_pin: !zboard:P2.12
microsteps: 16
full_steps_per_rotation: 200
rotation_distance: 4
gear_ratio: 5:1

[tmc2209 stepper_z3]
uart_pin: zboard:P1.4
interpolate: True
run_current: 1.400
hold_current: 0.900
sense_resistor: 0.110
#stealthchop_threshold: 999999

####

########################################
# Homing configuration
########################################

[gcode_macro SET_XY_HOMING_CURRENT]
gcode:
    RESPOND PREFIX="Info //" MSG="Setting XY Motor Currents for Homing..."
    SET_TMC_CURRENT STEPPER=stepper_x CURRENT=0.500 HOLDCURRENT=0.500
    SET_TMC_CURRENT STEPPER=stepper_y CURRENT=0.500 HOLDCURRENT=0.500

[gcode_macro SET_Z_HOMING_CURRENT]
gcode:
    RESPOND PREFIX="Info //" MSG="Setting Z Motor Currents for Homing..."
    SET_TMC_CURRENT STEPPER=stepper_z CURRENT=1.400 HOLDCURRENT=1.400
    SET_TMC_CURRENT STEPPER=stepper_z1 CURRENT=1.400 HOLDCURRENT=1.400
    SET_TMC_CURRENT STEPPER=stepper_z2 CURRENT=1.400 HOLDCURRENT=1.400
    SET_TMC_CURRENT STEPPER=stepper_z3 CURRENT=1.400 HOLDCURRENT=1.400

[gcode_macro SET_XY_PRINT_CURRENT]
gcode:
    RESPOND PREFIX="Info //" MSG="Resetting XY Motor Currents for Printing..."
    SET_TMC_CURRENT STEPPER=stepper_x CURRENT=1.400 HOLDCURRENT=0.750
    SET_TMC_CURRENT STEPPER=stepper_y CURRENT=1.400 HOLDCURRENT=0.750

[gcode_macro SET_Z_PRINT_CURRENT]
gcode:
    RESPOND PREFIX="Info //" MSG="Resetting Z Motor Currents for Printing..."
    SET_TMC_CURRENT STEPPER=stepper_z CURRENT=1.400 HOLDCURRENT=1.400
    SET_TMC_CURRENT STEPPER=stepper_z1 CURRENT=1.400 HOLDCURRENT=1.400
    SET_TMC_CURRENT STEPPER=stepper_z2 CURRENT=1.400 HOLDCURRENT=1.400
    SET_TMC_CURRENT STEPPER=stepper_z3 CURRENT=1.400 HOLDCURRENT=1.400

[homing_override]
axes: xyz
gcode:
    SET_KINEMATIC_POSITION
    SET_VELOCITY_LIMIT ACCEL=1000 ACCEL_TO_DECEL=500
    SET_XY_HOMING_CURRENT
    RESPOND PREFIX="Info //" MSG="Preheating nozzle for probing..."
    M109 S180 ; set extruder temp and wait
    RESPOND PREFIX="Info //" MSG="Homing XY..."
    G28 X0
    M400
    G0 X10 F5000
    M400
    G28 X0
    M400
    G0 X5.0 F3000
    M400
    G28 Y0
    M400
    G0 Y10 F5000
    M400
    G28 Y0
    M400
    SET_XY_PRINT_CURRENT
    M400
    G0 X362.5 Y362.5 F10000
    RESPOND PREFIX="Info //" MSG="Homing Z..."
    G28 Z0
    M400
    G0 Z5
    M400
    G0 X20.0 Y20.0 F10000
    RESPOND PREFIX="Info //" MSG="Homing is done!"
    SET_VELOCITY_LIMIT ACCEL=12000 ACCEL_TO_DECEL=6000

########################################
# Extruder configuration
########################################

[extruder]
step_pin: P2.13
dir_pin: P0.11
enable_pin: !P2.12
microsteps: 16
rotation_distance: 8.150
nozzle_diameter: 1.000
filament_diameter: 1.750
max_extrude_cross_section: 10
instantaneous_corner_velocity: 1.000
pressure_advance = 0.03
pressure_advance_smooth_time: 0.040
max_extrude_only_distance: 50000.0
heater_pin: P2.7
max_power: 1.0
sensor_type: PT1000
sensor_pin: P0.25
#smooth_time: 2.0
#control = pid
#pid_kp = 28.792
#pid_ki = 0.941
#pid_kd = 220.257
min_temp: 0
max_temp: 325
min_extrude_temp: 0

[tmc2209 extruder]
uart_pin: P1.4
interpolate: True
run_current: 1.197
hold_current: 0.400
sense_resistor: 0.110
#stealthchop_threshold: 0

[extruder_stepper my_extra_stepper]
extruder: extruder
step_pin: P0.22
dir_pin: !P2.11
enable_pin: !P0.21
rotation_distance: 70
microsteps: 16

[firmware_retraction]
retract_length: 1.0
retract_speed: 30
unretract_extra_length: 0.25
unretract_speed: 15

[filament_motion_sensor filament_sensor]
detection_length: 2000.0
extruder: extruder
switch_pin: P1.26
pause_on_runout: True
runout_gcode: PAUSE
insert_gcode: 
event_delay: 3.0
pause_delay: 0.05

########################################
# Compressor Regulator Control
########################################

[tmc2209 manual_stepper air_stepper]
uart_pin: P1.1
interpolate: True
run_current: 1.000
hold_current: 0.600
sense_resistor: 0.110
#stealthchop_threshold: 0
driver_SGTHRS: 50
diag_pin:P1.25

[manual_stepper air_stepper]
step_pin: P1.15
dir_pin: !P1.14
enable_pin: !P1.16
microsteps: 16
rotation_distance: 5.0
full_steps_per_rotation: 200
velocity: 75
accel: 100
endstop_pin:tmc2209_air_stepper:virtual_endstop

[gcode_macro SET_AIR_HOMING_CURRENT]
gcode:
    RESPOND PREFIX="Info //" MSG="Setting XY Motor Currents for Homing..."
    SET_TMC_CURRENT STEPPER=air_stepper CURRENT=0.700 HOLDCURRENT=0.500

[gcode_macro SET_AIR_PRINT_CURRENT]
gcode:
    RESPOND PREFIX="Info //" MSG="Setting XY Motor Currents for Homing..."
    SET_TMC_CURRENT STEPPER=air_stepper CURRENT=1.000 HOLDCURRENT=0.500

#[gcode_macro M106]
#rename_existing: M106 S{params.S}
#gcode:
    #{% set air_dist = params.S * 27}
    #{% if params.S <= '0' %}
    #MANUAL_STEPPER STEPPER=air_stepper MOVE=0
    #{% else %}
    #MANUAL_STEPPER STEPPER=air_stepper ENABLE=1 MOVE={air_dist}
    #{% endif %}


[gcode_macro M106]
rename_existing: M106.1
gcode:
    #get M106 parameter and store in var S
    {% set S = params.S|default(0)|float %}
    MANUAL_STEPPER STEPPER=air_stepper SYNC=0 MOVE={S}

[gcode_macro M107]
rename_existing: M107.1
gcode:
    MANUAL_STEPPER STEPPER=air_stepper SYNC=0 MOVE=0

[delayed_gcode reset_air_regulator]
gcode:
    RESPOND PREFIX="Info //" MSG="Checking Air Regulator Position..."
    SET_AIR_HOMING_CURRENT
    MANUAL_STEPPER STEPPER=air_stepper SYNC=0 SPEED=25 ACCEL=100 STOP_ON_ENDSTOP=1 MOVE=-400
    MANUAL_STEPPER STEPPER=air_stepper SET_POSITION=0
    SET_AIR_PRINT_CURRENT
    RESPOND PREFIX="Info //" MSG="Homing Air Regulator Position..."
    MANUAL_STEPPER STEPPER=air_stepper SYNC=0 SPEED=75 ACCEL=100 MOVE=240
    MANUAL_STEPPER STEPPER=air_stepper SYNC=0 SPEED=25 ACCEL=100 MOVE=230
    MANUAL_STEPPER STEPPER=air_stepper SET_POSITION=0
    RESPOND PREFIX="Info //" MSG="Done!"
initial_duration: 4.0

#######################################
# Heat Bed
########################################

[heater_bed]
heater_pin: zboard:P2.5
sensor_type: NTC 100K beta 3950
sensor_pin: zboard:P0.25
#control = pid
#pid_kp = 69.780
#pid_ki = 0.876
#pid_kd = 1389.481
min_temp: 0
max_temp: 100
max_power: 0.75
pwm_cycle_time: 0.300

[output_pin bed_heater_contactor]
pin: zboard:P2.4
pwm: False
value: 0
shutdown_value: 0

########################################
# Probe configuration
########################################

[probe]
pin: ^!zboard:P1.0
x_offset: 0.000
y_offset: 0.000
z_offset: 0.100
speed: 6.0
samples: 2
sample_retract_dist: 2.0
samples_tolerance: 0.050
lift_speed: 8.0
samples_result: average #   The calculation method when sampling more than once - either "median" or "average". The default is average.
samples_tolerance_retries: 10
activate_gcode: G4 P350

########################################
# Z Homing configuration
########################################

#[safe_z_home]
#home_xy_position: 362.5,362.5
#speed: 200.0
#z_hop: 15.0
#z_hop_speed: 20.0

[z_tilt]
z_positions: 
	-1.5,-1.5
	-1.5,726.5
	726.5,726.5
	726.5,-1.5
points:
	32.5,32.5
	32.5,692.5
	692.5,692.5
	692.5,32.5
speed: 200
horizontal_move_z: 3

[bed_mesh]
speed: 200
horizontal_move_z: 2.0
mesh_min: 32.5,32.5
mesh_max: 692.5,692.5
algorithm: bicubic
mesh_pps: 2,2
probe_count: 22,22
move_check_distance: 4
split_delta_z: 0.025

[gcode_macro BED_MESH_CALIBRATE]
rename_existing: BED_MESH_CALIBRATE_BASE
; gcode parameters
variable_parameter_AREA_START : 0,0
variable_parameter_AREA_END : 0,0
; the clearance between print area and probe area 
variable_mesh_area_offset : 5.0
; number of sample per probe point
variable_probe_samples : 2
; minimum probe count
variable_min_probe_count : 3
; scale up the probe count, should be 1.0 ~ < variable_max_probe_count/variable_min_probe_count
variable_probe_count_scale_factor : 1.25
gcode:
    {% if params.AREA_START and params.AREA_END %}
        {% set bedMeshConfig = printer["configfile"].config["bed_mesh"] %}
        {% set safe_min_x = bedMeshConfig.mesh_min.split(",")[0]|float %}
        {% set safe_min_y = bedMeshConfig.mesh_min.split(",")[1]|float %}
        {% set safe_max_x = bedMeshConfig.mesh_max.split(",")[0]|float %}
        {% set safe_max_y = bedMeshConfig.mesh_max.split(",")[1]|float %}

        {% set area_min_x = params.AREA_START.split(",")[0]|float %}
	{% set area_min_y = params.AREA_START.split(",")[1]|float %}
	{% set area_max_x = params.AREA_END.split(",")[0]|float %}
	{% set area_max_y = params.AREA_END.split(",")[1]|float %}

        {% set meshPointX = bedMeshConfig.probe_count.split(",")[0]|int %}
        {% set meshPointY = bedMeshConfig.probe_count.split(",")[1]|int %}
	
	{% set meshMaxPointX = meshPointX %}
	{% set meshMaxPointY = meshPointY %}


        {% if (area_min_x < area_max_x) and (area_min_y < area_max_y) %}
            {% if area_min_x - mesh_area_offset >=  safe_min_x %}
                {% set area_min_x = area_min_x - mesh_area_offset %}
            {% else %}
                {% set area_min_x = safe_min_x %}
            {% endif %}

            {% if area_min_y - mesh_area_offset >=  safe_min_y %}
                {% set area_min_y = area_min_y - mesh_area_offset %}
            {% else %}
                {% set area_min_y = safe_min_y %}
            {% endif %}

            {% if area_max_x + mesh_area_offset <=  safe_max_x %}
                {% set area_max_x = area_max_x + mesh_area_offset %}
            {% else %}
                {% set area_max_x = safe_max_x %}
            {% endif %}

            {% if area_max_y + mesh_area_offset <=  safe_max_y %}
                {% set area_max_y = area_max_y + mesh_area_offset %}
            {% else %}
                {% set area_max_y = safe_max_y %}
            {% endif %}

            {% set meshPointX = (meshPointX * (area_max_x - area_min_x) / (safe_max_x - safe_min_x) * probe_count_scale_factor)|round(0)|int %}
            {% if meshPointX < min_probe_count %}
                {% set meshPointX = min_probe_count %}
            {% endif %}
	    {% if meshPointX > meshMaxPointX %}
                {% set meshPointX = meshMaxPointX %}
            {% endif %}

            {% set meshPointY = (meshPointY * (area_max_y -area_min_y ) / (safe_max_y - safe_min_y) * probe_count_scale_factor )|round(0)|int %}
            {% if meshPointY < min_probe_count %}
                {% set meshPointY = min_probe_count %}
            {% endif %}
	    {% if meshPointY > meshMaxPointY %}
                {% set meshPointY = meshMaxPointY %}
            {% endif %}

            BED_MESH_CALIBRATE_BASE mesh_min={area_min_x},{area_min_y} mesh_max={area_max_x},{area_max_y} probe_count={meshPointX},{meshPointY} samples={probe_samples|int}
        {% else %}
            BED_MESH_CALIBRATE_BASE
        {% endif %}
    {% else %}
        BED_MESH_CALIBRATE_BASE
    {% endif %}

########################################
# Fan configuration
########################################

[heater_fan EXTRUDER_FAN]
pin: P2.3
max_power: 1.0
heater: extruder
heater_temp: 40.0
fan_speed: 1.0

[fan]
pin: P2.4
max_power: 1.0

########################################
# Filament Pre-Heater
########################################

[heater_generic filament_preheater]
gcode_id: 3
#   The id to use when reporting the temperature in the M105 command.
#   This parameter must be provided.
heater_pin: P2.5
max_power: 0.5
sensor_type: NTC 100K beta 3950
sensor_pin: P0.24
control: pid
pid_kp = 69.780
pid_ki = 0.876
pid_kd = 1389.481
# pid_integral_max:
min_temp: 0
max_temp: 100


########################################
# Input Shaper - ADXL345 Configuration
########################################

#[input_shaper]
#shaper_freq_x: 79.0
#shaper_type_x: 2hump_ei
#shaper_freq_y: 104.2
#shaper_type_y: mzv

[input_shaper]
shaper_freq_x: 37.6
shaper_type_x: mzv
shaper_freq_y: 21.6
shaper_type_y: zv

#[adxl345]
#cs_pin: rpi:None
#axes_map: x,y,z

#[resonance_tester]
#accel_chip: adxl345
#probe_points:
#    362,362,200

########################################
# Misc Settings
########################################

[force_move]
enable_force_move: True

[virtual_sdcard]
path: ~/gcode_files

[display_status]

[pause_resume]

[idle_timeout]
gcode:
    TURN_OFF_HEATERS
timeout: 3600

[respond]
#default_type: echo
#   Sets the default prefix of the "M118" and "RESPOND" output to one
#   of the following:
#       echo: "echo: " (This is the default)
#       command: "// "
#       error: "!! "
#default_prefix: echo:
#   Directly sets the default prefix. If present, this value will
#   override the "default_type".

########################################
# Macros
########################################

[delayed_gcode check_heatbed_temp]
initial_duration: 2
gcode:
    {% if printer.heater_bed.target == 0 %}
        HEATBED_OFF
    {% else %}
        HEATBED_ON
    {% endif %}
    UPDATE_DELAYED_GCODE ID=check_heatbed_temp DURATION=5

[gcode_macro PAUSE]
description: Pause the actual running print
rename_existing: PAUSE_BASE
# change this if you need more or less extrusion
variable_extrude: 1.0
gcode:
  ##### read E from pause macro #####
  {% set E = printer["gcode_macro PAUSE"].extrude|float %}
  ##### set park positon for x and y #####
  # default is your min posion from your printer.cfg
  {% set x_park = printer.toolhead.axis_minimum.x|float + 5.0 %}
  {% set y_park = printer.toolhead.axis_minimum.y|float + 5.0 %}
  ##### calculate save lift position #####
  {% set max_z = printer.toolhead.axis_maximum.z|float %}
  {% set act_z = printer.toolhead.position.z|float %}
  {% if act_z < (max_z - 10.0) %}
      {% set z_safe = 10.0 %}
  {% else %}
      {% set z_safe = max_z - act_z %}
  {% endif %}
  ##### end of definitions #####
  PAUSE_BASE
  G91
  {% if printer.extruder.can_extrude|lower == 'true' %}
    G1 E-{E} F2100
  {% else %}
    {action_respond_info("Extruder not hot enough")}
  {% endif %}
  {% if "xyz" in printer.toolhead.homed_axes %}
    G1 Z{z_safe} F900
    G90
    G1 X{x_park} Y{y_park} F6000
  {% else %}
    {action_respond_info("Printer not homed")}
  {% endif %} 

[gcode_macro RESUME]
description: Resume the actual running print
rename_existing: RESUME_BASE
gcode:
  ##### read E from pause macro #####
  {% set E = printer["gcode_macro PAUSE"].extrude|float %}
  #### get VELOCITY parameter if specified ####
  {% if 'VELOCITY' in params|upper %}
    {% set get_params = ('VELOCITY=' + params.VELOCITY)  %}
  {%else %}
    {% set get_params = "" %}
  {% endif %}
  ##### end of definitions #####
  {% if printer.extruder.can_extrude|lower == 'true' %}
    G91
    G1 E{E} F2100
  {% else %}
    {action_respond_info("Extruder not hot enough")}
  {% endif %}  
  RESUME_BASE {get_params}


[gcode_macro CANCEL_PRINT]
rename_existing: BASE_CANCEL_PRINT
gcode:
    G91 ; Set coordinates to relative
    G1 Z30
    G90
    TURN_OFF_HEATERS
    CLEAR_PAUSE
    SET_PIN PIN=bed_heater_contactor VALUE=0
    M107
    SDCARD_RESET_FILE
    BASE_CANCEL_PRINT
    SET_GCODE_OFFSET Z=0 MOVE=1
    G1 X10 Y10 F5000

[gcode_macro ENABLE_MOVEMENT]
gcode:
    SET_KINEMATIC_POSITION

[gcode_macro CORRECT_Z_TILT]
gcode:
    SET_VELOCITY_LIMIT ACCEL=1000 ACCEL_TO_DECEL=500
    RESPOND PREFIX="Info //" MSG="Preheating nozzle for z-tilt probing..."
    M109 S180 ; set extruder temp and wait
    RESPOND PREFIX="Info //" MSG="Z Tilt correction in progress..."
    Z_TILT_ADJUST
    M400
    RESPOND PREFIX="Info //" MSG="Resetting tool and bed positions..."
    G0 X20 Y20 F15000
    M400
    G0 Z10
    M400
    RESPOND PREFIX="Info //" MSG="Homing..."
    M400
    G28
    M400
    RESPOND PREFIX="Info //" MSG="Z-tilt correction is done!"
    SET_VELOCITY_LIMIT ACCEL=12000 ACCEL_TO_DECEL=6000

[gcode_macro PROBE_Z_CENTER]
gcode:
    G28 Z
    M400
    G0 Z10
    M400
    G1 X10 Y10 F10000

[gcode_macro P_M1]
gcode:
    G1 Z3
    M400
    G1 X35 Y35 F10000
    M400
    PROBE
    M400
    G1 Z3

[gcode_macro P_M2]
gcode:
    G1 Z3
    M400
    G1 X362.5 Y35 F10000
    M400
    PROBE
    M400
    G1 Z3
    M400
    G1 X362.5 Y65 F3000

[gcode_macro P_M3]
gcode:
    G1 Z3
    M400
    G1 X690 Y35 F10000
    M400
    PROBE
    M400
    G1 Z3

[gcode_macro P_M4]
gcode:
    G1 Z3
    M400
    G1 X35 Y362.5 F10000
    M400
    PROBE
    M400
    G1 Z3

[gcode_macro P_M5]
gcode:
    G1 Z3
    M400
    G1 X362.5 Y362.5 F10000
    M400
    PROBE
    M400
    G1 Z3

[gcode_macro P_M6]
gcode:
    G1 Z3
    M400
    G1 X690 Y362.5 F10000
    M400
    PROBE
    M400
    G1 Z3

[gcode_macro P_M7]
gcode:
    G1 Z3
    M400
    G1 X35 Y690 F10000
    M400
    PROBE
    M400
    G1 Z3

[gcode_macro P_M8]
gcode:
    G1 Z3
    M400
    G1 X362.5 Y690 F10000
    M400
    PROBE
    M400
    G1 X392.5 Y690 F10000
    M400
    G1 Z3

[gcode_macro P_M9]
gcode:
    G1 Z3
    M400
    G1 X690 Y690 F10000
    M400
    PROBE
    M400
    G1 Z3

[gcode_macro LOAD_FILAMENT]
gcode:
    G1 E1000 F2000
    M400
    G1 E1000 F2000
    M400
    G1 E300 F2000
    M400

[gcode_macro HEATBED_ON]
gcode:
    SET_PIN PIN=bed_heater_contactor VALUE=1

[gcode_macro HEATBED_OFF]
gcode:
    SET_PIN PIN=bed_heater_contactor VALUE=0

[gcode_macro PID_EXTRUDER_250]
gcode:
    PID_CALIBRATE HEATER=extruder TARGET=250

[gcode_macro PID_HEATBED_85]
gcode:
    SET_PIN PIN=bed_heater_contactor VALUE=1
    PID_CALIBRATE HEATER=heater_bed TARGET=85
    
[gcode_macro HEATERS_OFF]
gcode:
    TURN_OFF_HEATERS
    
########################################
# EXP1 / EXP2 (display) pins
########################################

[board_pins]
aliases:
    # EXP1 header
    EXP1_1=P1.30, EXP1_3=P1.18, EXP1_5=P1.20, EXP1_7=P1.22, EXP1_9=<GND>,
    EXP1_2=P0.28, EXP1_4=P1.19, EXP1_6=P1.21, EXP1_8=P1.23, EXP1_10=<5V>,
    # EXP2 header
    EXP2_1=P0.17, EXP2_3=P3.26, EXP2_5=P3.25, EXP2_7=P1.31, EXP2_9=<GND>,
    EXP2_2=P0.15, EXP2_4=P0.16, EXP2_6=P0.18, EXP2_8=<RST>, EXP2_10=<NC>
    # Pins EXP2_1, EXP2_6, EXP2_2 are also MISO, MOSI, SCK of bus "ssp0"

# See the sample-lcd.cfg file for definitions of common LCD displays.

#*# <---------------------- SAVE_CONFIG ---------------------->
#*# DO NOT EDIT THIS BLOCK OR BELOW. The contents are auto-generated.
#*#
#*# [extruder]
#*# control = pid
#*# pid_kp = 32.407
#*# pid_ki = 1.342
#*# pid_kd = 195.657
#*#
#*# [filament_preheater]
#*# control = pid
#*# pid_kp = 11.129
#*# pid_ki = 0.090
#*# pid_kd = 343.892
#*#
#*# [bed_mesh default]
#*# version = 1
#*# points =
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
#*# tension = 0.2
#*# min_x = 32.5
#*# algo = bicubic
#*# y_count = 33
#*# mesh_y_pps = 2
#*# min_y = 32.5
#*# x_count = 33
#*# max_y = 692.34
#*# mesh_x_pps = 2
#*# max_x = 692.34
#*#
#*# [heater_bed]
#*# control = pid
#*# pid_kp = 53.458
#*# pid_ki = 0.580
#*# pid_kd = 1230.850
