MirageC79/HevORT/firmware/klipper/printer_BKPStepperFLYCDY.cfg

# This file contains common pin mappings for Duet2 Eth/Wifi boards
# that have the Duex expansion board. To use this config, the firmware
# should be compiled for the SAM4E8E.

# See docs/Config_Reference.md for a description of parameters.

## Drivers
# Here are the pins for the 10 stepper drivers supported by a Duet2 board
# | Drive |  DIR pin |  STEP pin |  ENDSTOP pin |  SPI EN pin |
# |-------|----------|-----------|--------------|-------------|
# | X     |  PD11    |  PD6      |  PC14        |  PD14       |
# | Y     |  PD12    |  PD7      |  PA2         |  PC9        |
# | Z     |  PD13    |  PD8      |  PD29        |  PC10       |
# | E0    |  PA1     |  PD5      |  PD10        |  PC17       |
# | E1    |  PD9     |  PD4      |  PC16        |  PC25       |
# | E2    |  PD28    |  PD2      |  PE0*        |  PD23       |
# | E3    |  PD22    |  PD1      |  PE1*        |  PD24       |
# | E4    |  PD16    |  PD0      |  PE2*        |  PD25       |
# | E5    |  PD17    |  PD3      |  PE3*        |  PD26       |
# | E6    |  PC0     |  PD27     |  PA17*       |  PB14       |
# Pins marked with asterisks (*) are only assigned to these functions
# if no duex is connected. If a duex is connected, these endstops are
# remapped to the SX1509 on the Duex (unfortunately they can't be used
# as endstops in klipper, however one may use them as digital outs or
# PWM outs). The SPI EN pins are required for the TMC2660 drivers (use
# the SPI EN pin as 'cs_pin' in the respective config block). The
# **enable pin for all steppers** is TMC_EN = !PC6.
#
## Fans
# | FAN  |          PIN          |
# |------|-----------------------|
# | FAN0 |  PC23                 |
# | FAN1 |  PC26                 |
# | FAN2 |  PA0                  |
# | FAN3 |  sx1509_duex:PIN_12*  |
# | FAN4 |  sx1509_duex:PIN_7*   |
# | FAN5 |  sx1509_duex:PIN_6*   |
# | FAN6 |  sx1509_duex:PIN_5*   |
# | FAN7 |  sx1509_duex:PIN_4*   |
# | FAN8 |  sx1509_duex:PIN_15*  |
# Pins marked with (*) assume the following sx1509 config section:
#[sx1509 duex]
#i2c_address: 62
#
## Heaters and Thermistors
# | Extruder Drive |  HEAT pin |  TEMP pin |
# |----------------|-----------|-----------|
# | BED            |  PA19     |  PC13     |
# | E0             |  PA20     |  PC15     |
# | E1             |  PA16     |  PC12     |
# | E2             |  PC3      |  PC29     |
# | E3             |  PC5      |  PC30     |
# | E4             |  PC8      |  PC31     |
# | E5             |  PC11     |  PC27     |
# | E6             |  PA15     |  PA18     |
#
## Misc pins
# |    Name     |   Pin   |
# |-------------|---------|
# | ZProbe_IN   |  PC1    |
# | PS_ON       |  PD15   |
# | LED_ONBOARD |  PC2    |
# | SPI0_CS0    |  PC24   |
# | SPI0_CS1    |  PB2    |
# | SPI0_CS2    |  PC18   |
# | SPI0_CS3    |  PC19   |
# | SPI0_CS4    |  PC20   |
# | SPI0_CS5    |  PA24   |
# | SPI0_CS6    |  PE1*   |
# | SPI0_CS7    |  PE2*   |
# | SPI0_CS8    |  PE3*   |
# | SX1509_IRQ  |  PA17*  |
# | SG_TST      |  PE0*   |
# | ENC_SW      |  PA7    |
# | ENC_A       |  PA8    |
# | ENC_B       |  PC7    |
# | LCD_DB7     |  PD18   |
# | LCD_DB6     |  PD19   |
# | LCD_DB5     |  PD20   |
# | LCD_DB4     |  PD21   |
# | LCD_RS      |  PC28   |
# | LCD_E       |  PA25   |
# Pins marked with one asterisk (*) replace E2_STOP-E6_STOP if a duex is present
# For the remaining pins check the schematics provided here: https://github.com/T3P3/Duet
# https://duet3d.dozuki.com/Wiki/Duet_2_Pinout_table


####################################################################
############################ MCU ###################################
####################################################################
[mcu]
serial: /dev/serial/by-id/usb-Klipper_sam4e8e_00313753383436313139303139303535-if00

[mcu xyfly]
serial: /dev/serial/by-id/usb-Klipper_stm32f407xx_360031001551383230343230-if00

[mcu servo]
serial: /dev/serial/by-id/usb-Klipper_sam4e8e_00313753314E33383032303435303236-if00

[sx1509 duex]
i2c_address: 62 # Address is fixed on duex boards

[static_digital_output onboard_led]
pins: !PC2

[output_pin GPIO1] # General purpose pin broken out on the duex
pin: sx1509_duex:PIN_11
pwm: False
value: 1

[virtual_sdcard]
path: ~/gcode_files

[display_status]

####################################################################
############################ PRINTER ###############################
####################################################################
[printer]
kinematics: corexy
max_velocity: 1000
max_accel: 30000
max_accel_to_decel: 17000
max_z_velocity: 150
max_z_accel: 200
square_corner_velocity: 5

[pause_resume]
recover_velocity: 150

[input_shaper]
shaper_freq_x: 99.2  # per accelerometer
shaper_type_x: mzv
shaper_freq_y: 60.4  # per accelerometer
shaper_type_y: mzv


####################################################################
############################ XY Axis ###############################
####################################################################

[stepper_x]
step_pin: xyfly:PE5
dir_pin: !xyfly:PC0
enable_pin: !xyfly:PC1
microsteps: 16
rotation_distance: 40
endstop_pin: ^xyfly:PC7
position_endstop: 0
position_min: 0
position_max: 280
homing_speed: 40
full_steps_per_rotation: 400
homing_retract_dist: 0
homing_positive_dir: false

[tmc2209 stepper_x] 
uart_pin: xyfly:PC15
interpolate: true
run_current: 1.35
hold_current: 1




#__________________________ ON DRIVE Y ____________________________
[stepper_y]
step_pin: xyfly:PE4
dir_pin: !xyfly:PC13
enable_pin: !xyfly:PC14
microsteps: 16
rotation_distance: 40
endstop_pin: ^xyfly:PD11
position_endstop: 0
position_min: 0
position_max: 280
homing_speed: 40
full_steps_per_rotation: 400
homing_retract_dist: 0
homing_positive_dir: false

[tmc2209 stepper_y] 
uart_pin: xyfly:PA8
interpolate: true
run_current: 1.35
hold_current: 1



####################################################################
############################ Z Axis ################################
####################################################################

#__________________________ ON DRIVE E2 ____________________________
[stepper_z]
step_pin: PD2
dir_pin: !PD28
enable_pin: !PC6
microsteps: 16
rotation_distance: 4 				
full_steps_per_rotation: 200
#gear_ratio: 5.18:1
endstop_pin: probe:z_virtual_endstop
position_max: 280
position_min: -1.5

[tmc2660 stepper_z]
cs_pin: PD23
spi_bus: usart1
interpolate: True
run_current: 0.800
sense_resistor: 0.051


#_________________________ ON DRIVE E3 ___________________________
[stepper_z1]
step_pin: PD1
dir_pin: !PD22
enable_pin: !PC6
microsteps: 16
rotation_distance: 4 				
full_steps_per_rotation: 200
#gear_ratio: 5.18:1

[tmc2660 stepper_z1]
cs_pin: PD24
spi_bus: usart1
interpolate: True
run_current: 0.800
sense_resistor: 0.051


#_________________________ ON DRIVE E4 ___________________________
[stepper_z2]
step_pin: PD0
dir_pin: !PD16
enable_pin: !PC6
microsteps: 16
rotation_distance: 4 				
full_steps_per_rotation: 200
#gear_ratio: 5.18:1

[tmc2660 stepper_z2]
cs_pin: PD25
spi_bus: usart1
interpolate: True
run_current: 0.800
sense_resistor: 0.051


#__________________________ BLTouch ______________________________
[bltouch]
sensor_pin: ^PC1		# ^ = Activate pullup resistor to avoid floating input
control_pin: !PA15		# ! = Active low
x_offset: 22.75
y_offset: 5.21
#z_offset: 3
speed: 5
samples: 1
#sample_retract_dist: 5 
#samples_tolerance: 0.010


#__________________ SELF LEVELLING (Z_Tilt) _______________________
[z_tilt]
z_positions: 
	-38.188,-20.717
	138.021,307.493
	314.23,-20.717

points:
	20,20
	20,260
	260,260
	230,20
speed: 50
horizontal_move_z: 10

#retries: 0
#   Number of times to retry if the probed points aren't within
#   tolerance.
#retry_tolerance: 0
#   If retries are enabled then retry if largest and smallest probed
#   points differ more than retry_tolerance. Note the smallest unit of
#   change here would be a single step. However if you are probing
#   more points than steppers then you will likely have a fixed
#   minimum value for the range of probed points which you can learn
#   by observing command output.

#_____________________ SAFE Z HOMING ________________________________
[safe_z_home]
home_xy_position: 20,20  
z_hop: 10
z_hop_speed: 20.0



##################################################################
########################## EXTRUDER ##############################
##################################################################
#On drive E0
[extruder]
step_pin: PD5
dir_pin: PA1
enable_pin: !PC6
microsteps: 16
full_steps_per_rotation: 200
rotation_distance: 4.524
nozzle_diameter: 0.500
filament_diameter: 1.750
#_______________________ HEATER NOZZLE ____________________________
heater_pin: !PA20
#_________________________NOZZLE TEMP _____________________________
sensor_type: MAX31865    # PT100 Duet Daughter Board on Duex5
sensor_pin: PA24
spi_speed: 4000000
spi_software_sclk_pin: PB13
spi_software_mosi_pin: PB1
spi_software_miso_pin: PB0
rtd_nominal_r: 100
rtd_num_of_wires: 2
rtd_reference_r: 397
#control: pid
#pid_Kp: 22.2
#pid_Ki: 1.08
#pid_Kd: 114
min_temp: 0
max_temp: 350
pressure_advance = 0.005
max_extrude_only_distance: 150.0


[tmc2660 extruder]
cs_pin: PC17
spi_bus: usart1
interpolate: true
run_current: 0.35
sense_resistor: 0.051

#[multi_pin hevacs]
#pins: sx1509_duex:PIN_15, sx1509_duex:PIN_4    #Fan7&8

[multi_pin my_fan]
pins: PC23,PA0   #Fan 0,2


# Fan0
[fan]
pin: multi_pin:my_fan


# Fan1 controlled by extruder
[heater_fan nozzle_cooling_fan]
pin: PC26
heater: extruder
heater_temp: 45
fan_speed: 1.0


####################################################################
############################ BED ###################################
####################################################################
[heater_bed]
heater_pin: !PA19
sensor_type: EPCOS 100K B57560G104F
sensor_pin: PC13
#control: watermark
min_temp: 0
max_temp: 130


####################################################################
############################ ACCELEROMETER #########################
####################################################################

[mcu rpi]
serial: /tmp/klipper_host_mcu

[adxl345]
cs_pin: rpi:None

[resonance_tester]
accel_chip: adxl345
probe_points:
    150,150,20  # an example





####################################################################
############################ FANS ##################################
####################################################################
[output_pin FAN3]
pin: sx1509_duex:PIN_12
pwm: true
hardware_pwm: true # Only hardware PWM fans are supported

[output_pin FAN4]
pin: sx1509_duex:PIN_7
pwm: true
hardware_pwm: true

[multi_pin my_extra]
pins: sx1509_duex:PIN_5,sx1509_duex:PIN_15    #Fan 3,4,5,8


[output_pin ExtraCool]
pin: multi_pin:my_extra
pwm: false
#hardware_pwm: True

[output_pin FanMot]
pin: sx1509_duex:PIN_6
pwm: False
#hardware_pwm: True

#[output_pin FanCool]
#pin: sx1509_duex:PIN_5
#pwm: False
#hardware_pwm: True

[output_pin FanStep]
pin: sx1509_duex:PIN_4
pwm: False
#hardware_pwm: True

#[output_pin FAN8]
#pin: sx1509_duex:PIN_15
#pwm: False
#hardware_pwm: True




####################################################################
###################### FILAMENT SENSOR #############################
####################################################################
#[filament_switch_sensor sentinel]
#pause_on_runout: true
#switch_pin: PXXX  # not mapped yet
#runout_gcode:
#	G91
#    G1 E-6 F2500
#    G1 Z 10


##############################################
################# MACROS #####################
##############################################
[gcode_macro CANCEL_PRINT]
rename_existing: BASE_CANCEL_PRINT
gcode:
    TURN_OFF_HEATERS
    CLEAR_PAUSE
    SDCARD_RESET_FILE
    BASE_CANCEL_PRINT


####################################################################
###################### END of manual config ########################
####################################################################

#*# <---------------------- SAVE_CONFIG ---------------------->
#*# DO NOT EDIT THIS BLOCK OR BELOW. The contents are auto-generated.
#*#
#*# [bltouch]
#*# z_offset = 0.900
#*#
#*# [extruder]
#*# control = pid
#*# pid_kp = 11.939
#*# pid_ki = 0.433
#*# pid_kd = 82.376
#*#
#*# [heater_bed]
#*# control = pid
#*# pid_kp = 68.929
#*# pid_ki = 2.596
#*# pid_kd = 457.513
