MirageC79/HevORT/(commit log)

2020-03-15 renamed bom file
2020-05-24 Create framecalculator
2020-06-01 bom zrv2 loaded
2020-06-05 Bom addition
    [BOM_XY_STD.xlsx, BOM_X_Hemera.xlsx, BOM_ZR_V2.xlsx]
2020-06-16 added printbanner
    [FrameCalculator.xlsx]
2020-06-17 Update FrameCalculator.xlsx
    Feet added and extra space on top
    [FrameCalculator.xlsx]
2020-07-05 M3 Nut
    [BOM_XYHT.xlsx, BOM_XY_STD.xlsx]
2020-07-06 bed hole distance calculator
    [FrameCalculator.xlsx]
2020-07-14 bom adjustments
    [BOM_Frame_ElecExt.xlsx, FrameCalculator.xlsx]
2020-07-16 MIC6 suppliers added
    [BOM_ZR_V2.xlsx, FrameCalculator.xlsx]
2020-07-23 printheads added
    [FirmWareSettings.xlsx]
2020-07-29 hemera top mount
    [BOM_X_HemeraTopMount.xlsx]
2020-08-05 std sizes images
    [FrameCalculator.xlsx]
2020-08-31 RRFconfig tool
    [FirmWareSettings.xlsx, FrameCalculator.xlsx]
2020-08-31 Opto Ref Removed
    [BOM_XYHT.xlsx, BOM_XY_STD.xlsx]
2020-09-01 optical sensor AliExpress Vendor Removed
    [BOM_BMGAqua.xlsx, BOM_X_Hemera.xlsx, BOM_X_HemeraTopMount.xlsx]
2020-09-01 MotorValues corrected
    [FirmWareSettings.xlsx]
2020-09-08 heat pad added to frame calculator
    [FirmWareSettings.xlsx, FrameCalculator.xlsx]
2020-09-09 firwaresettings update
    [BOM_ZR_V2.xlsx, FirmWareSettings.xlsx]
2020-09-11 comments made in BOM ZR_V2
    [BOM_ZR_V2.xlsx]
2020-09-11 XY Bom comments
    to clarify Pulley requirements between HT and STD
    [BOM_XYHT.xlsx, BOM_XY_STD.xlsx]
2020-09-25 HD12 BOM
    [BOM_XYHD12_Beta1.xlsx, FrameCalculator.xlsx]
2020-09-30 M3_3030 tnut added
    [BOM_XY_STD.xlsx]
2020-09-30 M3 3030
    [BOM_XYHT.xlsx, BOM_XY_STD.xlsx]
2020-10-01 Marcio Firmware settings
    [FirmWareSettings.xlsx]
2020-10-16 thumb update xyhd12
    [BOM_XYHD12.xlsx, BOM_XYHD12_Beta1.xlsx]
2020-10-21 hd tweaks
    [BOM_XYHD9.xlsx, FrameCalculator.xlsx]
2020-10-21 mgn qty
    [BOM_XYHD9.xlsx]
2020-10-24 v1.5 hd12
    [HD12_MotorMount_LH_BodyV1.5.stl, HD12_MotorMount_RH_BodyV1.5.stl, HD_PulleyMountFR_BodyV1.5.stl]
2020-10-24 v1.5 h9
    [HD12_PulleyMountFR_BodyV1.5.stl, HD9_MotorCover_LH_BodyV1.stl, HD9_MotorCover_RH_BodyV1.stl, HD9_MotorMountRH_BodyV1.5.stl, HD9_MotorMountRH_BodyV1.stl, HD9_MotorMount_LH_BodyV1.5.stl, HD9_MotorMount_LH_BodyV1.stl, HD9_PulleyMountFL_BodyV1.5.stl]
2020-10-24 v1.5 small fixes
    [HD12_PulleyMountFL_BodyV1.5.stl, HD9_PulleyMountFR_BodyV1.5.stl]
2020-10-24 HD9 V2 - Corrected Pulley Height
    [HD9_BeltBinderLH_BodyV2.stl, HD9_BeltBinderRH_BodyV2.stl, HD9_MotorMountRH_BodyV1.5.stl, HD9_MotorMountRH_BodyV1.stl, HD9_MotorMount_LH_BodyV1.5.stl, HD9_MotorMount_LH_BodyV1.stl, HD9_MotorMount_LH_BodyV2.stl, HD9_MotorMount_RH_BodyV2.stl]
2020-10-24 HD9 V2 - Pulley height corrected
    [HD9_BeltBinderLH_BodyV2.stl, HD9_BeltBinderRH_BodyV2.stl, HD9_MotorMount_LH_BodyV2.stl, HD9_MotorMount_RH_BodyV2.stl, HD9_PulleyMountFL_BodyV2.stl, HD9_PulleyMountFR_BodyV2.stl, HD9_YCarriage_LH_LowerBodyV2.stl, HD9_YCarriage_LH_UpperBodyV2.stl]
2020-10-26 ZR_WingCancel Plates added
2020-10-27 Corrected HD X cross member dimension formula
    [FrameCalculator.xlsx]
2020-10-28 Revised HT BOM
    [BOM_XYHT.xlsx]
2020-10-28 Bom STD Qty modified for M3x8 and X10
    [BOM_XY_STD.xlsx]
2020-11-02 HD BOM info added
    [BOM_XYHD12.xlsx, BOM_XYHD9.xlsx]
2020-11-03 BOM Electronics Added
    [BOM_Electronics.xlsx]
2020-11-03 Electronic Bom Options
    [BOM_Electronics.xlsx]
2020-11-03 keenovo added
    [BOM_Electronics.xlsx]
2020-11-03 Bom Electronics corrections
    [BOM_Electronics.xlsx]
2020-11-03 typos electronic bom
    [BOM_Electronics.xlsx]
2020-11-13 for oleg
    [HEvACS_120mm_DoubleFan_Bracket_Inclined_BETA.stl, HevACS_120mm_515x540_MidDuct_BETA.stl, HevACS_NozzleBracketFL_BETA.stl, HevACS_NozzleBracketRL_BETA.stl]
2020-11-20 MotorMounts with Angular contact and collars
    [BearingCageCover_LH.stl, BearingCageCover_RH.stl, ZR_MotorMount_AngularCollar_FL.stl, ZR_MotorMount_AngularCollar_FR.stl]
2020-11-20 Parts oriented
    [BearingCageCover_LH.stl, BearingCageCover_RH.stl, ZR_MotorMount_AngularCollar_FL.stl, ZR_MotorMount_AngularCollar_FR.stl]
2020-11-20 Rear V2.5
    [BearingCageCover_RR.stl, ZR_MotorMount_AngularCollar_RR.stl]
2020-12-01 HevACS BETA
    [CylinderZR2.5.3mf, FrameCalculator.xlsx, HEvACS_120mm_Bracket_Fan_InclinedBracket_LHRH_BETA.stl, HevACS_120mm_515x540_MidDuct_LHRH_BETA.stl, HevACS_NozzleBracketFL_BETA.stl, HevACS_NozzleBracketRL_BETA.stl, HevACS_NozzleBrackets_LH_BETA.stl, HevACS_NozzleBrackets_RH_BETA.stl]
2020-12-03 Fixed Fin clash
    [HevACS_120mm_515x540_MidDuct_LHRH_BETA.1.stl, HevACS_120mm_515x540_MidDuct_LHRH_BETA.stl, HevACS_UpperDuct_LHRH_BETA.1.stl, HevACS_UpperDuct_LHRH_BETA.stl]
2020-12-11 ElecBom Links
    [BOM_Electronics.xlsx]
2020-12-16 ZR2.5 BOM and HD X Dummy Carriage
    [BOM_ZR_V2.5.xlsx, XYHD_DummyXCarriage_Assy v2.f3z]
2020-12-30 FrameCalculator modified to integrate HD components
    [FrameCalculator.xlsx]
2020-12-30 frame calculation instructions
2020-12-30 HD Frame Calculator update
    [FrameCalculator.xlsx]
2021-01-11 V2 Bom fixed (was refering to V2.5 list)
    [BOM_ZR_V2.xlsx, ZR2.8_MotorMount518_SFU1604_LH.stl, ZR2.8_MotorMount518_SFU1604_RH.stl, ZR2.8_MotorMount518_SFU1604_RR.stl, ZR2.8_UpperBearing_Mount_LH.stl, ZR2.8_UpperBearing_Mount_RH.stl, ZR2.8_UpperBearing_Mount_RR.stl]
2021-01-11 V2.8 File
    [ZR2.8_MotorMount518_SFU1604_LH.stl, ZR2.8_MotorMount518_SFU1604_RH.stl, ZR_V2.8_BerArmRailAdapter_Body.stl, ZR_V2.8_IGUS_SliderMount_LH_Body.stl, ZR_V2.8_IGUS_SliderMount_RH_Body.stl]
2021-01-11 ZRv2.8 Various Updates
    [ZR_V2.8_BerArmRailAdapter_Body.stl, ZR_V2.8_SlideMount_RR_Body.stl]
2021-01-13 DO NOT USE ZR2.8
    [BOM2.8.xlsx, ZR2.8_MotorMount518_SFU1604_LH.stl, ZR2.8_MotorMount518_SFU1604_RH.stl, ZR2.8_MotorMount518_SFU1604_RR.stl, ZR2.8_UpperBearing_Mount_LH.stl, ZR2.8_UpperBearing_Mount_RH.stl, ZR2.8_UpperBearing_Mount_RR.stl, ZR_V2.8_BerArmRailAdapter_Body.stl]
2021-01-14 ZRV2.5 file upload and cleanup for release
    [BOM_ZR_V2.5.xlsx, CylinderZR2.5.3mf, ZR_V2.5_BearingCageCover_LH.stl, ZR_V2.5_BearingCageCover_RH.stl, ZR_V2.5_BearingCageCover_RR.stl, ZR_V2.5_MotorMount_AngularCollar_FL.stl, ZR_V2.5_MotorMount_AngularCollar_FR.stl, ZR_V2.5_MotorMount_AngularCollar_RR.stl]
2021-01-14 ZR2.5_Bom and STL added
    [BOM_ZR_V2.5.xlsx, BedPlateMount_RL_Body_V2.stl, BedPlateMount_RR_Body_V2.stl, HevORT LOGO_Small_Grey v2.stl, ZR Logo Small v4.stl, ZR_BearingTopMount_FL_Body.stl, ZR_BearingTopMount_FR_Body.stl, ZR_BearingTopMount_RR_Body.stl]
2021-01-15 ZR2.5_BOM update
    [BOM_ZR_V2.5.xlsx]
2021-02-13 FrameMapping Hd12 Delta
2021-02-21 HD BOM Qty of M6X14 Corrected.
    [BOM_XYHD12.xlsx, BOM_XYHD9.xlsx]
2021-02-22 Updated Recommended Stepper motor for Z
    1.8 degree 60mm recommended. The more Detent torque the better .
    [BOM_ZR_V2.5.xlsx, BOM_ZR_V2.xlsx]
2021-02-26 BltouchQty Fixed
    [BOM_X_Hemera.xlsx]
2021-03-01 Klipper Bed settings
    [FirmWareSettings.xlsx]
2021-06-15 Create HD_CFx_MGN9_CFTube Insert.stl
    [HD_CFx_MGN9_CFTube Insert.stl]
2021-06-15 CFTube Insert Added
    [Option_HD12_CFx_MGN9.xlsx]
2021-06-16 HD12CFX V1.1
    [HD12_CFx_MGN9_YCarriage_LH_LowerBody v1.1.stl, HD12_CFx_MGN9_YCarriage_LH_UpperBody v1.1.stl, HD12_CFx_MGN9_YCarriage_RH_LowerBody v1.1.stl, HD12_CFx_MGN9_YCarriage_RH_UpperBody v1.1.stl, HD_CFx_MGN9_CFTube Insert.stl, HD_CFx_MGN9_CFTube InsertV1.1.stl, HevORT_Logo.dxf, NutPositionningTool_MGN9.stl]
2021-06-16 V1.1 Tighter Tolerance for smaller CF tubes
    [Option_HD12_CFx_MGN9.xlsx]
2021-07-09 ClearPath EQN recommended
    [BOM_XYHD12.xlsx, BOM_XYHD9.xlsx]
2021-07-09 HevACS315_340 added
    [HevACS_315_340_Diffuser.stl, HevACS_315_340_Fan_Bracket.stl, HevACS_315_340_Lower.stl, HevACS_315_340_MidDuct.stl, HevACS_315_340_UpperDuct.stl, HevACS_315_340_diffuserbracketLH.stl, HevACS_315_340_diffuserbracketLH_BACK.stl]
2021-07-16 HD12CFX_MGN9Rail Dimensions Added
    [Option_HD12_CFx_MGN9.xlsx]
2021-07-16 HD12CFX Rail Specs references
    [Option_HD12_CFx_MGN9.xlsx]
2021-07-16 Precision on Rail Length for HD12CFX
    [Option_HD12_CFx_MGN9.xlsx]
2021-07-28 Bom Links updated
    [BOM_XYHD12.xlsx]
2021-08-19 included 500 print area
    [FirmWareSettings.xlsx]
2021-08-20 POS8 pn alternative and source added
    [BOM_ZR_V2.5.xlsx, BOM_ZR_V2.xlsx, FirmWareSettings.xlsx]
2021-08-31 Link to Spider coupling source added
    [BOM_ZR_V2.5.xlsx]
2021-09-16 Klipper Config Example added
    [printer_BKPStepperFLYCDY.cfg, printer_ClearPathDuet.cfg, printer_ClearPath_HExtrudort48V_TMC5160.cfg]
2021-09-20 HDCFX Revision to include End stop Flags
    [HD12_CFx_MGN9_YCarriage_LH_LowerBody v2040.stl, HD12_CFx_MGN9_YCarriage_LH_UpperBody v2040.stl, HD12_CFx_MGN9_YCarriage_RH_LowerBody v2040.stl, HD12_CFx_MGN9_YCarriage_RH_UpperBody v2040.stl]
2021-09-21 Electronics BOM various update
    [BOM_Electronics.xlsx]
2021-09-28 Create HD_CFx_MGN9_CFTube InsertV1.15.stl
    [HD_CFx_MGN9_CFTube InsertV1.15.stl]
2021-11-05 Firmware settings correction and HD added
    Firmware settings correction and HD added
    [FirmWareSettings.xlsx, HD12_CFx_MGN9_YEndStopFlag_v1.1.stl, HD12_MGN9_LGX_MAgnum_LEFTSplit_Body_Draft.stl, HD12_MGN9_LGX_MAgnum_RIGHTSplit_Body_Draft.stl, HD12_MGN9_LGX_Magnum_BackBelt Retainers_Draft.stl, HeatShield_drill_jig.stl]
2021-11-05 BLtouch for Hextrudort iOffset corrected
    [FirmWareSettings.xlsx]
2022-01-06 AcidBee Enclosure
    [Bowden_InletHD.stl, DoorCorner.stl, DoorHandleBody (Left).stl, DoorHandleBody(Right).stl, DoorHandleMagnetPlateLH.stl, DoorHandleMagnetPlateRH.stl, DoorHingeBackPlateA.stl, DoorHingeBackPlateB.stl]
2022-01-06 BOM AcidBee Enclosure
    [BOM_Enclosure_AcidBee.xlsx, BomEnclosuredraft.xlsx, BomEnclosuredraft2.xlsx, DoorLatch_Magnet.stl, DoorLatch_MagnetHolder.stl]
2022-01-07 Optional - for 3MM bore Gates/Mellow Style Pulley
    [PulleyMount_FRONT_LEFT_3MM_BodyV1.1.stl, PulleyMount_FRONT_RIGHT_3MM_BodyV1.1.stl, PulleyMount_REAR_LEFT_3MM_Body.stl, PulleyMount_REAR_RIGHT_3mm_Body.stl]
2022-01-08 XYHT_V2 Step files added
    [HTXY_AXIS_PULLEYMOUNT_REAR_RIGHT_Assy_3mmPulley.step, XYHT_AXIS_PULLEYMOUNT_FRONT_RIGHT_Assy_3mmPulley.step, XYHT_AXIS_PULLEYMOUNT_REAR_LEFT_Assy_3mmPulley.step]
2022-01-08 Typo Correction
    [XYHT_AXIS_PULLEYMOUNT_REAR_RIGHT_Assy_3mmPulley.step]
2022-01-09 XYHT_Y Carriages2.5 Split
    [XYHT_YCarriage_LH_V2.5_Split_Lower.stl, XYHT_YCarriage_LH_V2.5_Split_Upper.stl, XYHT_YCarriage_RH_V2.5_Split_LowerBody.stl, XYHT_YCarriage_RH_V2.5_Split_UpperBody.stl]
2022-01-10 XYSTD_Y Carriages Split V2.5
    [XYSTD_YCarriage_LH_V2.5_Split_Lower.stl, XYSTD_YCarriage_LH_V2.5_Split_Upper.stl, XYSTD_YCarriage_RH_V2.5_LowerBody.stl, XYSTD_YCarriage_RH_V2.5_UpperBody.stl]
2022-01-11 V2.52 - front Idler M3 Nut location revised.
    LH Split lower for HT and STD revised for better MGN carriage grip
    [XYHT_YCarriage_LH_V2.52_Split_Lower.stl, XYHT_YCarriage_LH_V2.5_Split_Lower.stl, XYSTD_YCarriage_LH_V2.52_Split_Lower.stl, XYSTD_YCarriage_LH_V2.5_Split_Lower.stl]
2022-01-12 XYHT LH Carriage V2.52 fix
    [ARCHIVED_XYHT_YCarriage_LH_Body_V2.stl, ARCHIVED_XYHT_YCarriage_RH_Body_V2.stl, ARCHIVED_XYHT_Y_Carriage_LEFT_Body_V1.5.stl, ARCHIVED_XYHT_Y_Carriage_RIGHT_Body_V1.5.stl, XYHT_YCarriage_LH_V2.52_Split_Lower.stl, XYHT_YCarriage_LH_V2.5_Split_Upper.stl, XYHT_YCarriage_RH_V2.5_Split_Lower.stl, XYHT_YCarriage_RH_V2.5_Split_Upper.stl]
2022-01-17 Internal Chamfer corrected
    [ZR_V2.8_MotorMount_FL_Body v2.stl, ZR_V2.8_MotorMount_FL_Body v3.stl]
2022-01-17 Stepper Motor mating correction
    [ZR_V2.8_MotorMount_RH_Body v3.5.stl, ZR_V2.8_MotorMount_RH_Body v3.stl]
2022-01-18 XY gantry HD added and adjustments to calculations made.
2022-01-18 Create HevORT LOGO_Medium_Grey v2 v1.stl
    [HevORT LOGO_Medium_Grey v2 v1.stl]
2022-01-28 Updated XYHT CAD link to V2.5
    Y Carriages updated to split V2.5
2022-02-01 Correction Made to probe offsets
2022-02-02 Heater pin inverted
    [OctopusProTMC5160_printer_DRAFT.cfg]
2022-02-02 Added support for Max31865 PT100
    [OctopusProTMC5160_printer_DRAFT.cfg]
2022-02-03 400mm area definition added
2022-02-06 On Printer Validate
    [OctopusProTMC5160_printer.cfg]
2022-02-21 OctopusProCasing Beta Release
    [DINMountLeft.stl, DINMountRight.stl, FanButton.stl, FanCenterRetainer_Body.stl, Lid.stl, TripleFanShroud.stl]
2022-02-21 OctopusProCasing beta release stl oriented
    [DINMountLeft.stl, DINMountRight.stl, FanButton.stl, Lid.stl, TripleFanShroud.stl]
2022-02-21 Improved cams action for keeping door open
    [DINMountLeft.stl, DINMountLeft_Beta2.stl, DINMountRight.stl, DINMountRight_Beta2.stl]
2022-02-21 Improved cam action and oriented for print
    [DINMountLeft_Beta2.stl, DINMountRight_Beta2.stl]
2022-02-21 Added octopus logo
    [Octopus Logo.stl]
2022-02-21 holes re-aligned
    [Octopus Logo.stl, Octopus Logo_Beta2.stl]
2022-02-22 Logo updated. Thicker and holes adjusted.
    [Octopus Logo_Beta2.stl, Octopus Logo_Beta3.stl]
2022-02-25 Electronic Bay Accessories
    [BackCollar.stl, Din_Clip_BuckConverter12V.stl, RPI_DINPlate_MetalCase_Flat v1.stl, WireDuctHolder_CrossOverA.stl, WireDuctHolder_End.stl]
2022-02-25 3030 Extrusion WireCovers
    [3030WireCover.stl, 3030WireCoverFaztek.stl]
2022-02-26 HD9_CFX_YCarriage RH Beta
    [XYHD9_CFx_YCarriage_LH_LowerBody Beta.step, XYHD9_CFx_YCarriage_LH_UpperBody Beta.step, XYHD_CFx_YFlag_RH v1.step]
2022-02-26 Name Corrected (mislabeled)
    [XYHD_CFx_YFlag_LH v1.step]
2022-02-26 Small dimension change
    Tolerance increase for better fitment of CF tube (20.4mm)
    [XYHD9_CFx_YCarriage_LH_LowerBody Beta.1.step, XYHD9_CFx_YCarriage_LH_UpperBody Beta.1.step]
2022-03-03 HD9 CFX Rh Beta
    [XYHD9_HD_YCarriage_RH_LowerBody Beta.1.step, XYHD9_HD_YCarriage_RH_UpperBody Beta1.step, XY_HD12CFx_HDCF_YFlag_RH v1.step]
2022-03-05 HD9 CFx Design Release
    [NutPositionningTool_MGN9.stl, PositionningTool_MGN9_V1.1.stl, XYHD9_CFx_YCarriage_LH_LowerBody Beta.1.step, XYHD9_CFx_YCarriage_LH_LowerBody v1.step, XYHD9_CFx_YCarriage_LH_LowerBody v1.stl, XYHD9_CFx_YCarriage_LH_UpperBody v1.step, XYHD9_CFx_YCarriage_LH_UpperBody v1.stl, XYHD9_CFx_YCarriage_RH_LowerBody v1.step]
2022-03-05 HD12 CFx BOM notes clarifications
    [Option_HD12_CFx_MGN9.xlsx, Option_HD9_CFx_MGN9_Draft.xlsx]
2022-03-05 HD9 CFx Bom Renamed
    [Option_HD9_CFx_MGN9.xlsx]
2022-03-05 HD9 CFx Bom webpage
    [Option_HD9_CFx_MGN9.xlsx]
2022-03-05 HD9 CFx STL oriented
    [XYHD9_CFx_YCarriage_LH_LowerBody v1.stl, XYHD9_CFx_YCarriage_LH_UpperBody v1.stl, XYHD9_CFx_YCarriage_RH_LowerBody v1.stl, XYHD9_CFx_YCarriage_RH_UpperBody v1.stl, XYHD_CFx_YFlag_LH.stl, XYHD_CFx_YFlag_RH.stl]
2022-03-11 Mount for V1.1 HeatSink higher profile
    [DINMountLeft_V1.1HeatSinks.stl, DINMountRight_V1.1HeatSinks.stl]
2022-03-16 add resources
    [FrameCalculator.xlsx]
2022-03-16 Add frame-calculation & printer-size pages
2022-03-16 Rework grid template to allow multiple buttons
2022-03-16 Add frame/enclosure to component selection page
2022-03-16 Change grid item button container to use grid
2022-03-16 Add Optional XY-Gantry versions
2022-03-16 Add CAD file links
2022-03-16 Add "Happy Printing" message to home page
2022-03-17 Add How to print parts page
2022-03-17 Move files
    [2.04config_g_example.txt, FrameCalculator.xlsx, RRF3_D2_config.txt]
2022-03-18 Change download button to support normal links too
2022-03-18 Add social buttons
2022-03-18 Change donat button to prettier version
2022-03-18 Made grid-item show button over whole width when only one set
2022-03-19 Add klipper config page
2022-03-19 Fix grid item button margin
2022-03-19 Removed already moved files
    [FrameCalculator.xlsx]
2022-03-19 Add M3NT8L Z-Axis 2:1 reduction mod
2022-03-19 Added Serbitar LGX Lite HextrudORT Carriage Mount
2022-04-01 Change happy printing message
2022-04-05 Add missing bom links
2022-04-05 Reorder buttons
2022-04-11 Remove invalid button with no url
2022-04-13 Fix icon on wrong button
2022-04-13 Remove wrong button icon
2022-04-27 Added more details on source for Z thrust bearing collar.
    [BOM_ZR_V2.5.xlsx]
2022-04-27 Re aligned detailed parts picture
    [BOM_ZR_V2.5.xlsx]
2022-05-19 Add Rockzo XYHT 1515 extrusion mod, also fix empty button
    [rockzo_xyht_1515_extrusion_mod.step]
2022-05-20 Fix mod step file
    [rockzo_xyht_1515_extrusion_mod.step]
2022-05-23 Fix hevort-button not working in table row when multiple buttons were used
2022-05-29 Add Serbitar AcidBee Enclosure extras mod
2022-06-29 Allow defining a small hint text on item-button elements
2022-07-27 Commit current feature progress
2022-08-09 Create HD12_MotorMount_RH_ForEnclosure_BodyV1.5.stl
    RH Motor mount trimmed to allow enclosure back panel clearance.
    [HD12_MotorMount_RH_ForEnclosure_BodyV1.5.stl]
2022-08-09 Update HD12_MotorMount_RH_ForEnclosure_BodyV1.5.stl
    RH Motor mount trimmed to allow enclosure back panel clearance. + Re-Oriented
    [HD12_MotorMount_RH_ForEnclosure_BodyV1.5.stl]
2022-08-15 Add guitartoys hextrudort dragon berd-air mount
    [guitartoys_hextrudort_dragon_berd_air.step]
2022-08-15 Add stl file and restructure mod file directory
    [guitartoys_hextrudort_dragon_berd_air.step, guitartoys_hextrudort_dragon_berd_air.stl, rockzo_xyht_1515_extrusion_mod.step]
2022-08-15 Change item button for stl into download button
2022-08-20 Remove "title" prop from item-image component for now
2022-08-21 Move files into separate folder
    [guitartoys_hextrudort_dragon_berd_air.step, guitartoys_hextrudort_dragon_berd_air.stl]
2022-08-21 Add guitartoys mod "duet3_mounting_bracket"
    [Duet_Frame_Big_Part.stl, Duet_Frame_Small_Part.stl, HeVort Duet 3 Bracket With Fans.stl, duet3_Bracket_with_fans.step]
2022-08-21 Add guitartoys mod "hemera_berd_air"
    [hemera_v6_berd_air_nozzle.step, hemera_v6_berd_air_nozzle.stl, hemera_volcano_berd_air_nozzle.step, hemera_volcano_berd_air_nozzle.stl]
2022-08-21 Add guitartoys mod "berd_air_pump_mount"
    [berd_air_pump_mount.step, berd_air_pump_mount_bottom_insert.stl, berd_air_pump_mount_bracket.stl, berd_air_pump_mount_insert.stl]
2022-08-21 Add guitartoys mod "belt_cover"
    [belt_cover_left.step, belt_cover_right.step]
2022-08-21 Add guitartoys mod "c920_camera_door_mount"
    [logitech_c920_camera_door_mount.step, logitech_c920_camera_door_mount.stl]
2022-09-01 Update belt cover cad file with merged variant
    [belt_cover.step, belt_cover_left.step, belt_cover_right.step]
2022-09-01 Update guitartoys berd_air_pump_mount mod
    [berd_air_pump_mount.step]
2022-09-01 Add vvega's wobble ring mellow metal center mod
    [bottom_wobble_ring_mellow_metal_center.stl, front_left_top_wobble_ring_mellow_metal_center.stl, rear_top_wobble_ring_mellow_metal_center.stl]
2022-10-24 Restructure files location for mods
    [Duet_Frame_Big_Part.stl, Duet_Frame_Small_Part.stl, HeVort Duet 3 Bracket With Fans.stl, belt_cover.step, berd_air_pump_mount.step, berd_air_pump_mount_bottom_insert.stl, berd_air_pump_mount_bracket.stl, berd_air_pump_mount_insert.stl]
2022-11-12 XYHT_MGN9CFx_SplitCarriageV2.5 Added
    20.6mm cut out. Requires:
    Qty 2 M5X40mm button head screw
    Qty 2 M5X35mm button head screw
    Qty 4 M5 Nut
    [XYHT_MGN9CFX_YCarriage_LH_V2.52_Split_Lower.stl, XYHT_MGN9CFX_YCarriage_LH_V2.5_Split_Upper.stl, XYHT_MGN9CFX_YCarriage_RH_V2.5_LowerBody.stl, XYHT_MGN9CFX_YCarriage_RH_V2.5_UpperBody.stl]
2022-11-23 WobbleX_SFU1204_Step File
    [WobbleX_SFU1204_Mockup.step]
2022-11-24 Print Orientation fixed
    [WobbleRing_SFU1204_FL_LowerDisc_BETA.stl, ZR_SliderMount_FL_Body_V2.6_WobbleX_BETA.stl, ZR_V2.6_MotorMount_FL_Body_BETA.stl]
2022-11-27 AcidBee V1.5 clips
    [3030PanelClip_Corner_V1.5.stl, 3030PanelClip_Intersection_V1.5.stl]
2022-12-05 correct version number
    [3030PanelClip_Intersection_V1.5.step]
2022-12-08 Added 4 corner intersection panel clip
    [3030PanelClip_Intersection_4Corners_Body_V1.5.stl, 3030PanelClip_Intersection_4corners_V1.5.step]
2022-12-16 ZR2.6 BETA version STL files added
    [WobbleRing_SFU1204_FL_LowerDisc_BETA.stl, ZR2.6_BearingTopMount_FL_Body_BETA.stl, ZR2.6_BearingTopMount_FR_Body_BETA.stl, ZR2.6_BearingTopMount_RR_Body_BETA.stl, ZR2.6_MotorMount_FL_Body_BETA.stl, ZR2.6_MotorMount_FR_Body_BETA.stl, ZR2.6_MotorMount_RR_Body_BETA.stl, ZR2.6_SliderMount_FL_Body_BETA.stl]
2023-01-23 Print Orientation Corrected
    [WireDuctHolder_CrossOverA.stl, WireDuctHolder_End.stl]
2023-02-01 revised links to Enclosure and Frame
2023-02-16 HD12 CFX MGN9 Top Rail
    [OPTION_XYHT_CFX_MGN9_NutPositionningTool.stl, XYHD12_CFx_TopRail_MGN9_YCarriage_LH_LowerBody v1.stl, XYHD12_CFx_TopRail_MGN9_YCarriage_LH_UpperBody v1.stl, XYHD12_CFx_TopRail_MGN9_YCarriage_RH_LowerBody v1.stl, XYHD12_CFx_TopRail_MGN9_YCarriage_RH_UpperBody v1.stl, XYHD12_CFx_YFlag_LH.stl, XYHD12_CFx_YFlag_RH.stl, XYHD9_CFX_MGN9_XFlag_LHRH v3.stl]
2023-02-16 Top Rail CFx HD9 and HD12 Release
    [OPTION_XYHT_CFX_MGN9_NutPositionningTool.stl, Option_HD12_CFx_MGN9.xlsx, Option_HD12_CFx_TopRail_MGN9.xlsx, Option_HD9_CFx_TopRail_MGN9.xlsx, XYHD12_CFx_TopRail_MGN9_YCarriage_LH_LowerBody v1.stl, XYHD12_CFx_TopRail_MGN9_YCarriage_LH_UpperBody v1.stl, XYHD12_CFx_TopRail_MGN9_YCarriage_RH_LowerBody v1.stl, XYHD12_CFx_TopRail_MGN9_YCarriage_RH_UpperBody v1.stl]
2023-02-16 Notes added for 22mm Dia SFU1204
    [BOM_ZR_V2.5.xlsx, BOM_ZR_V2.xlsx]
2023-02-16 HD9 CFX Top Rail RH lower Y carriage corrected to V1.5
    [XYHD9_CFx_TopRail_MGN9_YCarriage_RH_LowerBody v1.5.stl, XYHD9_CFx_TopRail_MGN9_YCarriage_RH_LowerBody v1.stl]
2023-02-22 V1.1 Better Printablity
    V1.1 Made WobbleX 3mm Pin holes easier to print.
    [ZR2.6_SliderMount_FL_Body_V1.1.stl, ZR2.6_SliderMount_FL_Body_V1stl.stl, ZR2.6_SliderMount_FR_Body_V1.1.stl, ZR2.6_SliderMount_FR_Body_V1.stl, ZR2.6_SliderMount_RR_Body_V1.1.stl, ZR2.6_SliderMount_RR_Body_V1.stl]
2023-03-03 Fix missing printer calibration file
2023-03-27 390 and 395 Print Sizes added
2023-03-28 Revised Sources for Thermal Protections
    [BOM_Electronics.xlsx]
2023-03-31 Update component-selection.md
    Corrected CAD Link for ZR2.6
2023-07-24 Various Updates
    [2.04config_g_example.txt, BOM_Enclosure_AcidBee.xlsx, BOM_XYHD12.xlsx, DoorBeam_Support_LH.stl, DoorBeam_Support_RH.stl, FirmWareSettings.xlsx, FrameCalculator.xlsx, HD_NEMA17_AdapterPlate_LH_BodyV2.stl]
2023-08-18 ZR2.6 HighReach top bearing mount
    Required for Goliath Short on VZprintHead
    [ZR2.6_BearingTopMount_FL_HighReach_Body.stl, ZR2.6_BearingTopMount_FR_HighReach_Body.stl, ZR_BearingTopMount_RR_HighReach_Body.stl]
2023-09-16 HDx_VZprintHead_Optimized X end Stop
    [HDxTop_VZPrintHead_XEndStopMount.stl, HDxTop_VZPrintHead_XFlag.stl]
2023-09-22 Update printer_Goliath_XY48VDC.cfg
    Added Z lift points config detaisl
    [printer_Goliath_XY48VDC.cfg]
2023-09-26 Adding Magnetic brake Spool Holder
    [BOM_SpoolHolder.xlsx]
2023-09-26 File clean up
    [Option_HD12_CFx_TopRail_MGN9.xlsx]
2023-09-26 Magnetic Spool Holder STLs
    [FrameBracket.stl, SpoolRollBody.stl]
2023-09-26 Spool Holder Bom updated with STL links
    [BOM_SpoolHolder.xlsx]
2023-09-26 Typo Corrected
    [BOM_SpoolHolder.xlsx]
2023-09-26 Initial Release WaterCooling_Bay
    [BOM_WaterCooling_Bay.xlsx, Cooling Spider Base.stl, Mounting_Spacer.stl, RadHolder_DoubleFan.stl, Rad_HoldingBracket.stl, WaterCoolingTray_Support.stl, WaterCoolingTray_Support_Top_LH.stl, WaterCoolingTray_Support_Top_RH.stl]
2023-09-26 top panel clip added
    [WaterCoolingBay_BracketClipLH.stl, WaterCoolingBay_BracketClipRH.stl]
2023-09-26 Links to GitHub STL added
    [BOM_WaterCooling_Bay.xlsx]
2023-10-03 Tentacool for Goliath - Nozzle angle options
2023-10-13 SPAWD 9-10 Initial Release
    [BOM_XY_HD9_10_SPAWD.xlsx, HD10_SPAWD_BeltTensioner_FL.stl, HD10_SPAWD_BeltTensioner_FR.stl, HD10_SPAWD_Cover_MotorMount_FL.stl, HD10_SPAWD_Cover_MotorMount_FR.stl, HD10_SPAWD_Cover_MotorMount_RL.stl, HD10_SPAWD_Cover_MotorMount_RR.stl, HD10_SPAWD_MotorMount_FL.stl]
2023-10-13 BOM Maintenance
    [BOM_XYHD12.xlsx, Option_HD12_CFx_TopRail_MGN9.xlsx, Option_HD9_CFx_TopRail_MGN9.xlsx]
2023-10-13 Re-oriented STL
    [ZR2.6_BearingTopMount_FL_HighReach_Body.stl, ZR2.6_BearingTopMount_FR_HighReach_Body.stl, ZR_BearingTopMount_RR_HighReach_Body.stl]
2023-10-13 Sample klipper config files added
    [macros_Goliath_XY48VDC.cfg, neopixel_Goliath_XY48VDC.cfg, printer_Goliath_XY48VDC.cfg]
2023-10-26 SPAWD12 Release
    [BOM_XYHD12.xlsx, BOM_XY_HD12_SPAWD.xlsx, HD12_SPAWD_Cover_MotorMount_FL.stl, HD12_SPAWD_Cover_MotorMount_FR.stl, HD12_SPAWD_Cover_MotorMount_RL.stl, HD12_SPAWD_Cover_MotorMount_RR.stl, HD12_SPAWD_MotorMount_FL.stl, HD12_SPAWD_MotorMount_FR.stl]
2023-10-26 Bom Updates
    Added Yaxis MGN rails, Endstop and associated hardware
2023-10-26 SPAWD12 Added Belt Tensioners
    [HD12_SPAWD_BeltTensioner_FL.stl, HD12_SPAWD_BeltTensioner_RH.stl]
2023-10-26 Typo correction
    Belt was showing 9/10mm instead of 12mm
    [BOM_XY_HD12_SPAWD.xlsx]
2023-10-31 Bom Links maintenance
    [BOM_XY_HD12_SPAWD.xlsx, HD10_SPAWD_BeltTensioner_FR.stl, cable holder Vz.stl]
2023-10-31 Update HD10_SPAWD_BeltTensioner_FL.stl
    Center Hole Enlarged
    [HD10_SPAWD_BeltTensioner_FL.stl]
2023-11-01 Update OctopusPro V1.1
    Difference between Octopus Pro V1.0 and V1.1 managed via line selection (uncomment selection)
    [OctopusProTMC5160_printer.cfg]
2023-11-02 Bom SPAWD Fix
    [BOM_XY_HD12_SPAWD.xlsx]
2023-11-04 Qty-2 Optional 70mm Dowell Pins added to BOM
    When using Nema17, the adapter plate adds a bit of distance between motor and pulley, this 70mm shaft will make it easier for both to reach on the upper belt motors.
2023-11-11 Y axis Rails M3X3030 T-Nut description fixed
    [BOM_XY_HD12_SPAWD.xlsx]
2023-11-14 VezPrinthead X Endstop optimize
    [HDxTop_VZPrintHead_XEndStopMount.stl, HDxTop_VZPrintHead_XFlag v2.stl]
2023-11-16 LDO motor datasheets added
2023-11-16 Vez metal Printhead for HevORT
    [BOM_VezMetalPrintHead_GoliathShort_VZHextrudORT_WC.xlsx, CPAP clamp Body1.stl, CPAP clamp Body2.stl, XYHDx_CFx_TopRail_MGN9_VZPrintHead_XFlag v2.stl, cable holder Vz.stl]
2023-11-17 Vez metal print head with Goliath short
    [BOM_VezMetalPrintHead_GoliathShort_VZHextrudORT_WC.xlsx]
2023-11-18 Prerequisit for ZR2.6 High Reach added to Goliath Short
    [BOM_VezMetalPrintHead_GoliathShort_VZHextrudORT_WC.xlsx]
2023-11-19 Goliath Long BOM added
    [Goliath_AIR_2510_fan_duct.stl]
2023-11-19 Goliath Long Tentacool Spacer added to BOM
2023-11-19 Cad link to Goliath Long Corrected
2023-11-21 WaterLine Panel Clip
    [3030_4mmTube_harness_clip.step, 3030_4mmTube_harness_clip.stl]
2023-11-25 ZR2.8 WobbleX integration
    [WobbleRing_SFU1605_LowerDisc.stl, ZR2.8_WobbleX_SliderMount_RR_Body_EXPERIMENTAL.stl]
2023-11-25 2020 4mmTube and wire clip
    [2020_4mmTube_harness_clip.step, 2020_4mmTube_harness_clip.stl]
2024-01-07 Dowell Pin Qty updated
    Number of Dowell Pin correted to 48 for printed WobbleX
    [BOM_ZR_V2.6.xlsx]
2024-01-09 Clean up and re-org
    [2.04config_g_example.txt, 2020_4mmTube_harness_clip.3mf, BOM_HDx_VezPrintHead_Metal.xlsx, FirmWareSettings.xlsx, FrameCalculator.xlsx, RRF3_D2_config.txt, XYHD_DummyXCarriage_Assy v2.f3z, ZR2.8_WobbleX_SliderMount_RR_Body_EXPERIMENTAL.stl]
2024-01-10 Re organization of folders
    [2020_4mmTube_harness_clip.3mf, 2020_4mmTube_harness_clip.step, 2020_4mmTube_harness_clip.stl, 3030PanelClip_Corner_V1.5.stl, 3030PanelClip_Intersection_4Corners_Body_V1.5.stl, 3030PanelClip_Intersection_4corners_V1.5.step, 3030PanelClip_Intersection_V1.5.step, 3030PanelClip_Intersection_V1.5.stl]
2024-01-10 Re organizing folder
    [3030PanelClip_Corner_V1.5.stl, 3030PanelClip_Intersection_4Corners_Body_V1.5.stl, 3030PanelClip_Intersection_4corners_V1.5.step, 3030PanelClip_Intersection_V1.5.step, 3030PanelClip_Intersection_V1.5.stl, 3030WireCover.stl, 3030WireCoverFaztek.stl, Bowden_InletHD.stl]
2024-01-12 Documentation Updates
    - New Klipper and ZTilt page
    - Warning on Electronics about obsolete info
    - Aesthetic changes to Docs
    - Octopus Pro casing added to components
2024-01-12 SPAWD Klipper config added
    [macros.cfg, neopixel.cfg, printer.cfg, spawd_bttskr3ez.cfg]
2024-01-16 LED Channel Clip added
    [LED_45deg_Channel_Clip v6.stl, LED_45deg_Channel_Clip_8mmShift v1.stl]
2024-01-16 Led clip images added
2024-01-21 Added Screen Mount
    [7in_LCD_Bezel.stl, 7in_LCD_Frame.stl]
2024-01-21 Panel Retainer Clip 3030 added
    [3030_PanelClip_Retainer.stl, 3030_PanelClip_Retainer_Side.stl]
2024-01-22 ZR2.6 BOM Qty clarified
    - ButtonHead M6 Screws Qty25 length should be 12mm not 14.
    - Capscrew M4 Length should be 16mm, not 14. Qty adjusted to 12. (4 per ballscrew)
    [3030_PanelClip_Retainer_Half.stl, BOM_ZR_V2.6.xlsx]
2024-01-22 AcidBee Enclosure - Door Hinge Dowell pins diameter clarification
    Hinge Dowel Pins are 60mm by 5mm dia.
    [BOM_Enclosure_AcidBee.xlsx]
2024-01-27 Added 5X1 washer under each Motor Pulley
    [BOM_XY_HD12_SPAWD.xlsx]
2024-02-01 Print2Win custom config
2024-02-05 M6 attachement screws location correction
    See Issue 53: https://github.com/MirageC79/HevORT/issues/53
    [ZR2.6_MotorMount_FL_Body_V1.2.stl, ZR2.6_MotorMount_FL_Body_V1.stl, ZR2.6_MotorMount_FR_Body_V1.2.stl, ZR2.6_MotorMount_FR_Body_V1.stl]
2024-02-11 klipperscreen hevort theme
2024-02-24 SFU1204 nut diameter Issue 43 clarification
    https://github.com/MirageC79/HevORT/issues/43
    [BOM_ZR_V2.5.xlsx, BOM_ZR_V2.6.xlsx, BOM_ZR_V2.xlsx]
2024-02-24 Include Top lid Mod from Sillysam
    Ref: https://discord.com/channels/790612368056647682/1206304279346942022/1206304279346942022
    [3030PanelClip_Corner_DoorCut_Body.stl, 3030PanelClip_Intersection_DoorCut_Body.stl, BOM_Enclosure_AcidBee.xlsx, BracketDoubler_Deco_LH.stl, BracketDoubler_Deco_RH.stl, Bracket_Lid_LH.stl, Bracket_Lid_RH.stl, Bracket_Side.stl]
2024-09-18 Update to ZR2.6 BOM
    - Added Qty 2 M5X16 Button head screws for ball screws top bearing mounts. RH + LH
    - Added Z bed arm rodend support Qty 3 (same as ZR2.5) was missing in ZR2.6
    Also ::
    STLs for Bed plate support frame printed parts added to the ZR2.6 Folder. Same parts as ZR2.5.
    [BOM_ZR_V2.6.xlsx, BedPlateMount_RL_Body_V2.stl, BedPlateMount_RR_Body_V2.stl, HevORT LOGO_Small_Grey v2.stl, ZR Logo Small v4.stl, ZRLogo.stl, ZR_BedPlateMount_FL_Body_V2.stl, ZR_BedPlateMount_FR_Body_V2.stl]
