MirageC79/HevORT/images/PrintedParts/IMG_20200318_091146.JPG

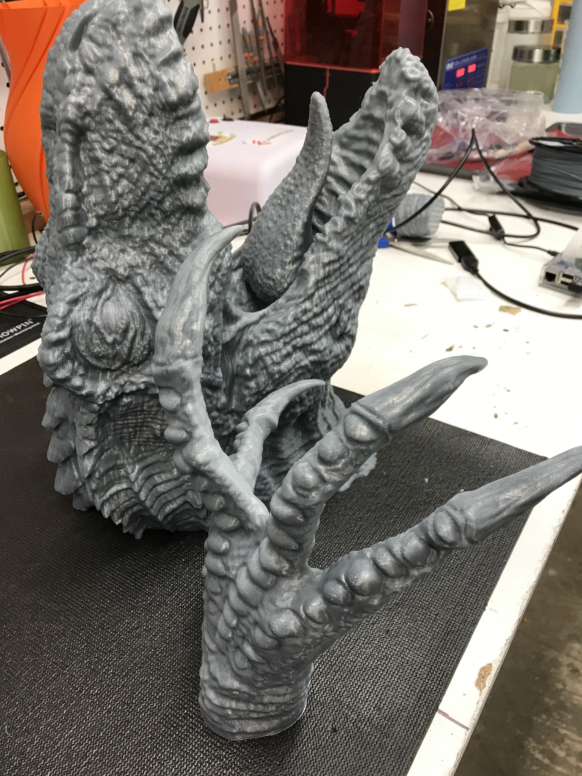
images/PrintedParts/IMG_20200318_091146.JPG
